ckh7488/rf_current_probe/viewer_A05/split_sources/README.md

# A14 분할 소스 이력

이 폴더는 이전 웹/ZIP 패키지의 보존 자료다. 현재 A14 native·M2×12·기성 노브축과125객체 기준은 [기구 원본](../../mechanical/assembly_A14_DRAFT/README.md), 공개 재생성은 [뷰어 안내](../README.md)를 따른다. 이 폴더의 예전 README/검증 JSON을 새 제조 승인으로 사용하지 않는다. 원문은 [보존본](../../reviews/document_full_audit_20260922/before/viewer_A05/split_sources/README.md)에 있다.
