ckh7488/rf_current_probe/docs/atlas/README.md

# ATLAS RFCP 문서 경로

2026-09-22 · [현행 공개 문서](https://ckh7488.github.io/showcase/reports/rf-current-probe/).

이 설명 자료의 기구 표시 기준은 A14/C07이며, 최종3D 제작은 [A16/C09 확정 기준](../3D_PRINT_RELEASE_A16_C09.md)을 따른다. 현행 교정지그는 Fixture A03(출력 포트 기준1–500 MHz 보정, DEC-053)이며 Fixture A04는 이력이다. 실제 빌드 소스와 명령은 [viewer_A05/README.md](../../viewer_A05/README.md)를 따른다. 이 폴더의 `sections/`·`source/` HTML 및 초기 A02 자료는 역사 기록이며 현행 dist 생성 원본이 아니다.

공개 다운로드는 STL15종·전체 STEP1종·Head A04 Gerber1종과 공개 HTML 묶음으로 제한한다. 내부 구매·과거 리비전·감사 원자료는 공개하지 않는다. 내부 현재 판단은 [CURRENT_READINESS](../CURRENT_READINESS.md), 전체 조사 범위는 [문서 색인](../DOCUMENT_INDEX.md)을 확인한다.
