ckh7488/rf_current_probe/viewer_A05/audit_sources/latest/a11_20260918/README.md

# A11 조립 수정 검토 — 2026-09-18

**CALCULATED / DRAFT — NOT FOR FABRICATION**

검토 대상은 `mechanical/assembly_A11_DRAFT`의 실제 저장 CAD입니다. A10을 그대로 두고 새로운 A11에 바닥 나사 길이, 코어 앞 고정 바, 뚜껑 수동 기준면, 교정 PCB 너트 공구 창과 C05 클램프를 반영했습니다.

`check_targeted.py`는 아래 사항을 저장된 CAD에서 계산하고 `targeted.json`에 원본·검증 코드 해시와 함께 기록합니다.

- 6개 M4×20 나사의 바닥 돌출 여부, 너트 받침 면, 명목 나사 물림.
- A10/A11 FREE 뚜껑 BRep의 대칭 차집합 부피. 동일하면 이전 뚜껑 해석의 대상 형상이 유지된 것으로 해석합니다. 닫힌 표시 형상은 유효성 오류를 수정하여 변경되며, FREE 원본과 구분합니다. 새 기준면의 하중·마찰 해석을 의미하지 않습니다.
- 코어 앞 받침의 접촉 면적 유지.
- 넓어진 하부 사각 너트 슬롯의 회전 정지, 나사·너트를 함께 옮긴 9개 위치.
- 왼쪽 L형 기준면의 유도 경사를 따라 손으로 뚜껑을 배치하는 41개 위치. 자동으로 중심을 잡는다는 뜻이 아닙니다.
- 독립 STL 검사에서 찾은 오래된 0.15 mm 잔여 지붕 조각의 제거와 뒤쪽 2.5 mm 벽의 유지.

전체 조립체의 기존 개폐·분리 경로도 새 원본으로 다시 계산합니다. 첫 수정에서 20 mm로 넓힌 교정 PCB 기둥 머리가 헤드 탈착을 막는 것이 확인되어, 최종 후보는 원래 14 mm 폭으로 되돌리고 공구 창만 유지했습니다. 실패를 제외하는 대신 형상을 고쳐 검사를 다시 실행했습니다.

새 L형 벽은 6 mm이고 유도 경사 끝에도 3 mm가 남습니다. 고정 바는 기존 높이 6 mm·두께 4 mm를 유지합니다. 이 수치는 해당 형상의 설계 치수이며 전체 STL의 최소 벽 두께에 대한 제조사 승인이나 강도 보증은 아닙니다.

추가 형상 검증에서 L형 두 벽이 선으로만 접하는 부분이 STL의 비다양체 경계가 되는 것을 발견해, 경사진 모서리 솔리드로 두 벽을 연결했습니다. 또한 A10부터 상속한 닫힘 뚜껑의 꺾은선/필렛 조합이 `Unorientable shape` 오류를 만드는 것을 확인했습니다. 비영 변위 상태를 정확한 3차 베지어 곡선으로 만들도록 고치고, 생성 시 출력용 FREE 형상뿐 아니라 전체 표시 부품의 `isValid()`도 검사하도록 바꿨습니다. FREE 뚜껑 형상은 유지했습니다.

독립 STL 표본 검사에서는 A07부터 남아 있던 중앙 PCB 지붕의 얇은 조각도 찾았습니다. 중심 X ±6 mm, Y −35…−34 mm, Z 4.75…4.9 mm 위치의 잔여부로, PCB 절삭과 권선 통로 절삭의 시작점이 어긋나 생긴 0.15 mm 돌출부입니다. 중앙 권선 창을 Y −40…−31.9 mm, Z −2…15.8 mm로 연결해 해당 조각을 제거하고 뒤쪽 2.5 mm 벽은 남겼습니다. 바뀐 STL을 다시 검사하여 40,000개 표본 중 1.5 mm 미만 표시가 없음을 확인했습니다. 표본 검사는 전역 최소 두께의 증명이 아닙니다.

독립 검토는 `reviews/independent_a11_20260918`에서 별도로 수행합니다. 구매·제작 승인 상태는 바꾸지 않습니다. 실제 출력 및 조립, 체결 토크·내구성, 전류 프로브 교정·RF 영향 확인이 남아 있습니다.
