ckh7488/rf_current_probe/viewer_A05/audit_sources/latest/c05_20260918/README.md

# C04 → C05 구동 너트 포켓 수정

2026-09-18 · `CALCULATED_SAVED_NOMINAL_CAD_NOT_PHYSICAL`

**출력물을 추가하지 않고 구동 너트의 공칭 축방향 여유를 1.8 → 1.0 mm로 줄였다.** 기존 C04는 보존했다. 이 변경은 이상적인 턱 이동식과 클램프 설치 위치를 바꾸지 않는다.

| 항목 | C04 | C05 |
|---|---:|---:|
| 포켓 높이 | 6.8 mm | 6.0 mm |
| 포켓 Y 범위 | −33.4…−26.6 mm | −33.0…−27.0 mm |
| 사각 너트 공칭 높이 | 5.0 mm | 5.0 mm |
| 너트 Y 범위 | −32.7…−27.7 mm | −32.5…−27.5 mm |
| 공칭 축방향 여유 | 1.8 mm | 1.0 mm |
| 뒤 벽 / 양옆 여유 | 2.4 / 0.8 mm | 동일 |
| 출력물 개수 | 5개 | 5개 |

피치 1 mm를 가정하면 포켓 여유만으로 방향을 바꿀 때 최대 약 1회전의 초기 이동이 생길 수 있다. 실제 백래시를 1회전으로 확정하는 의미가 아니며, 나사산·축 유격과 마찰은 별도로 남는다. 조인 방향으로 여유를 없앤 후에는 기존의 동기 이동 관계를 사용한다.

## 실행한 검증

`build.log`: FreeCAD 1.0.2로 원본 재생성, `mechanical/cable_clamp_C05_DRAFT/verification.json`에 5개 단일 솔리드, 케이블 Ø6–26 mm 21자세와 가로대 개방 21자세 결과 저장.

`assembly.log`: 새로 저장한 파일에서 연결틀·아래 턱 삽입 경로 73자세와 STL 5개의 폐곡면 검사. `mechanical/cable_clamp_C05_DRAFT/assembly_verification.json`에 저장.

`check_c05.py` / `verification.json`: 새 원본 해시를 포함한 추가 검사.

- C04/C05 부품별 대칭차 부피: DriveYoke, DriveNut만 변경. 나머지 16개 형상 동일.
- 포켓의 두 접촉면에 너트를 붙여 Ø6–26 mm 21자세씩 총 42자세 검사.
- 너트 삽입은 M6 축 설치 전으로 한정하여 +Z 0–60 mm, 2 mm 간격 31자세 검사.
- 너트 이동 ±0.5 mm에서는 간섭이 없고 ±0.55 mm에서는 포켓 벽과 간섭하여 끝이 막혀 있음을 확인.
- 사각 너트 회전 방지 및 큰 축·잠금 너트의 3개 케이블 크기 × 25각도 = 75자세 검사.

모든 명시된 공칭 기하 검사는 통과했다. 실제 힘, 마찰, 뒤틀림, 장기 크리프, 출력 오차, 중심 정확도와 RF 영향의 통과를 뜻하지 않는다.

## 공차 범위와 조립 조건

6.0 mm 포켓의 양쪽 벽 위치가 각각 ±0.3 mm 달라진다는 보수적인 민감도 계산에서는 포켓 높이가 5.4–6.6 mm다. 너트가 정확히 5.0 mm라면 잔여 여유가 0.4–1.6 mm다. 너트 공차가 추가되면 범위도 달라진다. 이는 제조업체의 조립 보증 수치가 아니다.

너트는 앞에서 삽입한 뒤 큰 M6 축을 설치한다. 최종 너트 치수를 확인하고 시험 출력으로 조립·반복 이동을 확인해야 한다. 플라스틱에 작동 나사산을 만들거나, 억지 끼워 맞춤·접착·별도 스프링을 추가하지 않았다.

사용한 치수 후보: [Bossard BN147 사각 너트 표](https://www.tme.eu/Document/07a25fe393aaf643196ea01e7ec8ef58/BN_147.pdf). 출력 오차 참고: [JLC3DP 3301PA](https://jlc3dp.com/help/article/3301pa-nylon). 현재 검증은 10 × 10 × 5 mm 외형 모델에 대한 것이며 최종 구매 MPN을 승인한 기록은 아니다.
