ckh7488/rf_current_probe/viewer_A05/audit_sources/latest/independent_a11_20260918/README.md

# A11 / C05 독립 조립 접근 검사

2026-09-18 · **CALCULATED / DRAFT — NOT FOR FABRICATION**

제품 생성기와 별도로 저장된 CAD를 다시 열어 실제 조립 접근과 변경 범위를 대조했다. 실물 출력·조립·계측 시험은 아니다. 제품 CAD, PCB, 사이트를 이 검사에서 직접 변경하지 않았다.

최종 재실행 대상 A11 원본 SHA-256: `43347b92f42abb08b4b938e21b1780dc678d9b14a5508b7598555ee5ab1b244d`. LowerBody의 불필요한 얇은 권선 창 턱을 제거한 뒤, 아래 네 검사 코드를 모두 다시 실행해 결과를 이 파일에 결속했다.

## 확인 결과

| 검사 | 결과 | 근거 |
|---|---|---|
| 헤드 SMA·납땜·드라이버 접근 | A10은 15개 조건 중 9개에서 아래 고정바 간섭. A11은 같은 15개 조건에서 간섭 없음 | [operation_tools.json](operation_tools.json) |
| 바닥 나사 끝 | A10: 책상 아래 4/3 mm 돌출. A11: 책상 위 1/2 mm 여유 | [operation_tools.json](operation_tools.json) |
| 교정 PCB 너트·스패너 | 바깥쪽 X 방향으로 접근/회수하는 경로 368개 자세에서 간섭 없음. 케이블 클램프가 모두 장착된 상태 포함 | [calibration_spanner.json](calibration_spanner.json) |
| 개정별 실형상 대조 | C04→C05는 구동 연결틀과 너트 위치만 변경. A10→A11 변경 객체 전체를 수치로 기록 | [revision_delta.json](revision_delta.json) |
| 출력용 자유 뚜껑 | A10/A11 STEP의 솔리드 차집합 체적 0. 뚜껑 형상 자체는 동일 | [revision_delta.json](revision_delta.json) |
| 닫힌 상태의 뚜껑 CAD | 기존 A10의 변형 표시용 형상 오류를 확인해 A11에서 수정. A11 닫힌 CAD 및 변형량0~3.02 mm의 9가지 생성 형상 모두 유효한 단일 솔리드. 출력용 자유 뚜껑 형상은 유지 | [loaded_lid_validity.json](loaded_lid_validity.json) |

### 공구 검사에 사용한 크기

- SMA 공간: Ø16 × 길이45 mm.
- 납땜 공구: Ø1.6 × 길이6 mm 끝, 다음12 mm에서 Ø6으로 넓어지는 원추, Ø6 × 길이50 mm 몸통. S+/S− 각각 검사했다.
- 코어 두께에 따라 아래 고정바를 Z 방향 −0.635 / 0 / +0.635 mm 이동한 경우도 같은 SMA·납땜 접근 검사에 포함했다.
- PCB 드라이버: Ø4 × 길이85 mm. 코어 고정바 드라이버: Ø8 × 길이65 mm.
- 스패너 가정: 머리 외경14 mm, 두께3 mm, 손잡이 폭8 mm·중심부터 길이55 mm, 벌어진 턱 폭5.8 mm. 실제 구매할 5.5 mm 스패너는 이 외형 안에 들어가는지 별도로 확인해야 한다.

이는 특정 제조사 제품을 그대로 복제한 공구 모델이 아니라 명시한 접근 공간이다. 실제 공구·손가락·열·납땜 각도와 체결 토크까지 검증한 것은 아니다.

## 교정 PCB 너트의 조립 순서

1. 나사 끝이 너트 창을 가로막지 않은 상태로 PCB를 기둥 위에 놓는다.
2. 나일론 M3 너트의 평평한 면을 Z 방향으로 맞춘다. 스패너 손잡이는 바닥의 **바깥쪽 X 방향**으로 향하게 한다.
3. 스패너로 너트를 잡아 기둥의 옆으로 열린 창에 넣고, 그 상태로 위에서 M3 나사를 끼워 조인다.
4. 스패너를 그대로 바깥쪽 X 방향으로 뺀다.

앞·뒤 Z 방향으로 긴 스패너를 끝까지 빼는 방법은 손잡이가 케이블 클램프와 부딪칠 수 있다. 창의 옆면도 열려 있으므로 **옆으로 조작하는 경로**를 사용한다. 나사를 먼저 완전히 넣은 뒤 너트를 옆에서 끼우는 순서도 사용하지 않는다. 이 검토에서 조립 방향을 정리했고, 추가 부품은 필요하지 않았다.

## 변형 표시용 CAD의 수정

기존에는 휘어진 탄성판을 1 mm 간격의 짧은 직선으로 그린 뒤 뿌리 부분을 둥글게 처리했다. 이 조합에서 CAD 커널이 면의 방향을 결정하지 못하는 오류가 났다. A11은 원래 의도한 같은 변형식을 매끄러운 3차 베지에 곡선으로 만들어 이 오류를 해결했다. 이는 **움직임을 표시하고 간섭을 계산하는 CAD의 수정**이며, 출력용 자유 뚜껑을 다시 얇게 하거나 재료를 바꾼 것이 아니다. 자유 뚜껑 STEP은 실제 차집합 체적0으로 동일성을 확인했다.

## 판정의 범위

이번 저장 CAD 검사에서는 위 접근 경로의 추가 간섭을 남기지 않았다. 이는 제품 전체의 제작·RF 성능 보증을 뜻하지 않는다.

- 뚜껑 자유 형상 동일성은 이전 해석의 형상을 추적하는 근거다. 새 위치 기준의 실제 접촉·출력물 변형까지 기존 FEA로 검증한 것은 아니다.
- L자 기준에 손으로 맞추는 방식은 자동 자기 정렬 장치가 아니다. 실제 코어 맞댐 위치와 반복 측정으로 확인한다.
- 긴 출력물의 치수·평행도·뒤틀림, 나사 패턴의 누적 오차, 너트·기성 공구의 실제 치수와 표면 마찰은 아직 실물 확인이 필요하다.
- C05의 구동너트 여유는 공칭1 mm다. 유격이 없는 기구나 실측된 조작감으로 표시하지 않는다.
- 코어 권선·SMA 납땜·RF 지그 정합·프로브 삽입 영향은 각 원래 절차와 후속 시험을 따른다.

## 재현

FreeCAD 1.0.2의 `freecadcmd.exe`로 `check_operation_tools.py`, `check_revision_delta.py`, `check_calibration_spanner.py`를 실행한다. 결과 JSON은 실제 입력 CAD와 검사 코드의 SHA-256을 포함한다. 제품 원본이 바뀌면 이전 결과를 그대로 적용하지 않는다.
