ckh7488/rf_current_probe/viewer_A05/audit_sources/latest/visual_revision_20260918/README.md

# A11 / C05 再검토와 3D 문서 갱신

2026-09-18 · **DRAFT — NOT FOR FABRICATION**

## 완료

기존 조립 문제를 CAD와 출력물에 반영하고, 기존 문서의 4개 장면(구조·개폐 / 실험실 교정 / 지그·분리 / 케이블 측정)을 최신 조립체로 갱신했다. 전후 비교는 이전8곳 + 이번6곳을 실제 CAD로 회전·확대·변경 부분 강조할 수 있게 했다.

| 이번 변경 | 결과 |
|---|---|
| 바닥 M4 나사6개 | 25→20 mm, 너트 안착. 공칭 바닥 안쪽1/2 mm |
| 코어 고정바 | SMA·S+/S− 접근을 위해 가로대 이동. 코어 접촉부 유지 |
| 뚜껑 정렬 | 왼쪽 L형 기준에 손으로 가볍게 맞대고 조임. 자동 정밀 정렬은 아님 |
| 교정 PCB 너트 | 바깥 X 방향 공구 창. 얇은5.5 mm 스패너로 잡고 체결 |
| C05 구동너트 | 포켓6.8→6.0 mm, 공칭 여유1.8→1.0 mm. 무유격 아님 |
| 권선 출구 | 이전 절삭에서 남은0.15 mm 깊이의 작은 조각 제거. 뒤 벽2.5 mm 유지 |

닫힘 상태를 표현하는 뚜껑 CAD의 면 연결 오류도 수정했다. **출력용 자유 뚜껑은 기존과 같은 형상**이다. 기존 약5.29 N 선형 FEA는 당시 재료·지지조건에서의 결과이며 새 기준면 접촉·출력물 수명 검증이 아니다. 비교에서 뚜껑이 포함된 두 부위는 양쪽 모두 유효한 FREE 출력 형상으로 대조했다.

## 실제 검증

- 새 원본의73객체 형상 유효성·정적 간섭,233자세 개폐/탈착,24개 코어 ADC 민감도,코어 접촉/이탈·체결 공간.
- 독립 검사: SMA·테이퍼 인두·드라이버15조건, 바깥 방향 스패너368자세.
- 뚜껑 수동 배치41자세·나사/너트 위치 여유9자세, 자유 뚜껑 형상 동일성.
- 출력10종/15개: 폐곡면·양의 부피·원본 해시;40,000개 두께 표본에서1.5 mm 미만0. 표본 검사는 전면 최소 두께나 업체 DFM 승인과 다르다.
- Site의 새 CAD 포함·동작 그룹·내부 링크·문법 및 브라우저 표시/조작은 별도 검증 기록으로 남긴다.

## 미검증/다음

정확한 구매 체결품·공구·출력 재료/공차 대조,시제품의 무가공 조립·마찰·닫힘 반복성·내구성,RF 교정·삽입 영향·보호 체인이 남는다. PCB 전기 설계는 바꾸지 않았고 이전 규칙검사/거버 대조를 유지했다. 업체 제출·구매·이전 장바구니는 갱신하지 않았다. 기존 구매서를 현재 제작 승인본으로 사용하지 않는다.

근거: [A11](../a11_20260918/README.md), [독립 검사](../independent_a11_20260918/README.md), [출력 검사](../a11_print_20260918/README.md), [C05](../c05_20260918/README.md), [원본](../../mechanical/assembly_A11_DRAFT/README.md).
