ckh7488/rf_current_probe/docs/ATLAS_A02_DESIGN_REVIEW.md

> **이력 문서 · 현재 제작/사용 지시 아님 — 2026-09-22 분류.** A02 설명서 검토 이력이다. 현재 기준은 [현재 준비 상태](CURRENT_READINESS.md)를 따른다. 아래의 “현재/최신/미확정”은 원래 작성 시점의 표현이다.

# 평판 교정지그 A0.2 — 이전 3장 PCB와 비교 검토

2026-09-17 · CALCULATED / 설계 검토 · DRAFT — NOT FOR FABRICATION

**판단: 금속 가공 없이 직접 조립하려는 현재 목적에는 A0.2를 유지하는 편이 낫다.** PCB 사이 접합, 두 점퍼의 길이·납땜, 벌크헤드 SMA 외피 접촉이라는 조립 변수가 줄었다. RF 정확도·유효 대역·반복성의 개선과 전체 비용 절감은 아직 입증하지 못했다.

이 검토는 저장 PCB·FreeCAD 조립 파일을 읽어 별도로 확인했다. 설계 원본, 발주 파일, 공급사 카트·주문은 수정하지 않았다. 실물 조립·EM 해석·RF 측정은 실행하지 않았다.

## 1. 무엇이 달라졌나

| 항목 | 이전 PCB A0.1 | 현재 평판 A0.2 | 판단 |
|---|---|---|---|
| PCB | Frame 118×65×1.0 mm 1장 + EndPanel 128×24×1.0 mm 2장 | 144×92.7×1.6 mm 1장, 두 창과 모서리 고정 | 직각 PCB 정렬·접합 작업 제거 |
| 중심 연결 | SMA 컵과 SIG 사이 점퍼 2개 | 수직 THT SMA 두 개의 중심 핀을 SIG에 직접 납땜 | 점퍼 길이·형상 편차 제거. 새로운 SMA 런치 RF 응답은 미검증 |
| 귀환 접속 | SMA 외피–EndPanel 접촉, EndPanel–Frame 접합 | SMA마다 접지 핀 4개 → 같은 보드의 GND | 연결 구조가 더 명료함. 실물 납땜 연속성은 별도 확인 |
| 지지 | Base, HeadBracket, InputStand, OutputStand | Base·HeadBracket 유지; 30 mm F/F + 35 mm M/F 나일론 기둥 네 쌍 | 출력 지지대 2개 제외, 기둥 부품 8개 추가. 부품 전체가 1개가 되는 것은 아님 |
| 중앙 다리 | 폭 8 mm, 양면 SIG 6.8 mm | 폭·동박 폭 유지, 보드 두께 1.6 mm, 다리 아래 GND 없음 | 기본 교정 전류 경로 유지 |
| 케이블 접속 방향 | 지그 양끝에서 수평 | 보드 위로 수직 | 케이블 배치·당김·SMA 토크를 다시 관리해야 함 |
| 비용 | 이전 견적 및 초안 | 새 보드/기둥/커넥터/배송 재견적 필요 | 3장→1장만으로 최종 비용 절감이라고 판단하지 않음 |

바닥판은 같은 156×103 mm 외형을 재사용한다. 새 PCB가 이전 Frame보다 크다는 사실과 전체 받침대가 커졌다는 주장은 구분한다. 새 3D 출력물을 추가하지 않고 기존 양끝 지지대를 제외하는 구성이다.

## 2. 이번에 실제로 재검사한 것

- **KiCad 10.0.0:** 저장 PCB에 `pcb drc --refill-zones --schematic-parity --severity-all` 실행. 저장 옵션은 쓰지 않았다. DRC·미연결·회로 일치 위반 각 0건, 비활성 검사 0. 저장 회로 ERC도 위반 0, 비활성 검사 0.
- **원본 보존:** PCB SHA-256과 저장 FreeCAD의 해시를 기존 검증 기록과 대조했고 일치했다. 조립 CAD에 사용한 입력 파일의 해시도 모두 일치했다.
- **FreeCAD 1.0.2:** 저장된 조립 파일에서 SIG/GND가 각각 유효하고 연결된 solid 1개임을 확인했다. Ø30 mm 유효 구경의 길이 12.7 mm 전체에 대해 SIG 교차 체적은 양수, GND는 0이다. 중앙 한 단면만 보는 기존 검사보다 길이 방향 확인 범위를 넓혔다. 이것은 형상·위상 관계 확인이며 RF 전류의 크기를 계산한 것이 아니다.
- **간격:** PCB–닫힌 헤드의 공칭 겹침 0, 최소 간격 2.00 mm. SIG–GND 공칭 동박 간격 약 0.3505 mm. 이 수치를 절연 정격으로 쓰지 않는다.
- **개폐:** 두 SMA 위에 Ø12×30 mm 원통형 플러그 공간을 추가한 상태에서 0~90°, 5° 간격 19점 재검사. 겹침 0, 최소 간격 4.91 mm. 실제 커넥터/케이블 외형, 연속 swept volume, 휨·공차 검증은 아니다.
- **도면 대조:** 보존된 GCT RFPC-SMA28-F Rev.1.2 제조사 도면의 추천 패턴은 5.08 mm 피치, 중심 Ø1.50 mm, 접지 네 곳 Ø1.70 mm다. 저장 보드와 기존 패드 검사 기록이 일치한다. Würth 도면은 970300365 길이 30±0.1 mm / 양쪽 암나사 깊이 10 mm, 971350365 몸체 35±0.1 mm / 수나사 8 mm / 암나사 깊이 10 mm다. 도면 공차가 전체 조립 공차 검증을 대신하지 않는다.

재검사 원본: `docs/atlas/review/a02-design/erc.json`, `drc.json`, `pcb-summary.json`, `independent-cad.json`, `freecad.log`. 검토 스크립트: `docs/atlas/review_flat_cad.py`.

## 3. 개선됐다고 말할 수 있는 범위

보드 접합과 점퍼가 없어져 제작 절차가 단순해졌다는 점은 설계 파일에서 확인할 수 있다. 접속 형상·납땜 길이의 변수가 줄어 반복성에 유리할 가능성은 있다. 그러나 반복성을 실제로 측정한 결과는 없다. 직접 납땜형 SMA로 바뀌었어도 그 풋프린트의 1 mm 신호 런치, 폭이 변하는 SIG, 넓은 바깥 귀환 전체가 50 Ω인 것은 아니다.

따라서 **다음 시제품의 조립안으로는 A0.2를 선택하고, RF 교정지그로서의 유효성은 새로 측정한다.** A0.1에서 얻었거나 앞으로 얻을 교정값을 A0.2에 그대로 적용하지 않는다. SMA 부품의 50 Ω/6 GHz 표기도 지그 전체의 대역·정확도가 아니다.

## 4. 조립 전에 먼저 확인할 부분

1. **케이블 하중과 토크.** 새 SMA는 PCB에 서 있다. 케이블을 별도로 받치고 몸체를 지지하며 체결한다. 코어는 브래킷이 받쳐야 하며 8 mm PCB 다리에 집게를 매달지 않는다. 높이 65 mm 나일론 기둥의 휨·풀림·시간에 따른 변형은 아직 시험하지 않았다.
2. **바닥 나사 끝 닿음.** 현재 CAD의 M3×12는 공칭 삽입 9.4 mm / 암나사 깊이 10 mm여서 끝 여유 0.6 mm다. 보유 M3×10을 쓰면 계산상 삽입 7.4 mm / 여유 2.6 mm다. 실제 머리 형상·길이·홈·체결을 보고 선택할 후보이지 검증 완료된 대체품은 아니다. 상단 M3×10은 1.6 mm PCB를 지나 8.4 mm 삽입된다. 절연 기둥은 유지하고 M4/M5로 임의 대체하지 않는다.
3. **높이와 실제 맞춤.** 30+35 mm 기둥의 길이 공차만으로도 한 쌍의 높이는 공칭 합 기준 ±0.2 mm가 될 수 있다. PCB 두께·뒤틀림, 출력 바닥/브래킷, 나사 체결 공차를 합친 간격은 평가하지 않았다. 2 mm CAD 간격을 그대로 실물 최소 간격이라고 표현하지 않는다.

## 5. RF에서 더 나은지 확인하는 첫 측정

새 리비전 ID와 사진을 남기고, 먼저 기존 G2 벤치 절차의 1~100 MHz / 1601점 linear / −30 dBm / IF BW 1 kHz / 평균 4회 시작안을 사용한다. 실제 장비 지원값과 정격이 우선이다. 이전 웹 문서의 −20 dBm·401점 간이 설정은 이번 A0.2 기본값으로 이어 쓰지 않는다.

| 순서 | 실제 연결 | 저장할 파일 | 판단 |
|---|---|---|---|
| 0 | 두 테스트 케이블 끝에서 O/S/L/T | 교정 ID·기준면·설정·재접속 검증 | VNA/케이블 오차 정리 |
| 1 | P1→J1, J2→P2, 헤드 분리 | `fixture_A02_empty.s2p` | 반사·손실·위상·공진. 1~100 MHz S11≤−20 dB는 기존 시작 목표이며 현재 합격 결과가 아님 |
| 2 | 같은 through, 헤드 출력→외장 50 Ω | `fixture_A02_probe_loaded.s2p` | 프로브 장착이 일차 전류 경로에 주는 영향 |
| 3 | P1→J1, J2→외장 50 Ω, 헤드 출력→P2 | `fixture_A02_probe_transfer.s2p` + `.json` | 우선 상대 S21. 전류 모델 입증 뒤 ZT 환산 |
| 4 | 같은 구성으로 직접 픽업 대조·최소 5회 재장착·레벨 비교 | `fixture_A02_direct_pickup.s2p`, `fixture_A02_repeat_01…05.s2p` 등 | 누설·반복성·선형성. 대조 구성의 실제 사진·전류 조건도 기록 |

모든 재배선은 RF OFF. 일차 J2 부하와 이차 P2 종단을 각각 한 번씩 적용한다. 케이블을 고정해 두고 조금 이동시켰을 때의 변화도 별도 기록해 배치 민감도를 판단한다. 저반사 S11만으로 코어 위치의 전류 모델이 입증되지는 않는다. 첫 특성화 뒤 100~200, 200~300 MHz를 나누어 평가하며 500 MHz는 확장 특성 확인이다.

두 지그 실물이 모두 있을 때만 동일 헤드·케이블·레벨·위치에서 A/B 측정을 한다. 없는 A0.1 데이터를 만들거나 비교 때문에 불필요하게 구형을 발주하지 않는다. A0.2만으로 먼저 정합·반복성·누설 기준을 검증해도 다음 설계 판단은 가능하다.

## 근거

- 현재 설계: `hardware/calibration_fixture_PCB_A02/README.md`, `ASSEMBLY.md`, `geometry.json`, `BOM_DELTA.md`, 저장 KiCad/FreeCAD, 검증 JSON.
- 이전 설계: `hardware/calibration_fixture_PCB_A01/`의 형상·조립 검사.
- 기준: `docs/RF_CURRENT_PROBE_WHITEPAPER.md`, `G2_BENCH_PROCEDURE.md`, `END_TO_END_REHEARSAL.md`.
- [GCT 제품 정보](https://gct.co/connector/rfpc-sma28-f), 보존 제조사 도면 `hardware/calibration_fixture_PCB_A02/references/RFPC-SMA28-F.pdf` Rev.1.2 (2025-05-12). 이번 도면 대조는 보존한 제조사 원문 기준이며 최신 리비전 인증을 뜻하지 않는다.
- [Würth 970300365](https://www.we-online.com/components/products/datasheet/970300365.pdf), [Würth 971350365](https://www.we-online.com/components/products/datasheet/971350365.pdf): 보존 제조사 원문과 치수 대조. 신규 가격/배송 조회나 구매는 실행하지 않았다.
- [Tekbox 교정지그 매뉴얼](https://www.tekbox.com/product/TBCPx_Calibrators_Manual.pdf): 약 50 Ω 경로와 분리된 일차/프로브 출력 종단 참고. 상용 대역을 자체 지그 성능으로 옮기지 않는다.
