ckh7488/rf_current_probe/docs/CABLE_CENTERING_CONCEPT.md

> **이력 문서 · 현재 제작/사용 지시 아님 — 2026-09-22 분류.** 중심 클램프를 만들기 전 원리 제안이다. 현행 C07은 별도로 구현/검토되었다. 현재 기준은 [현재 준비 상태](CURRENT_READINESS.md)를 따른다. 아래의 “현재/최신/미확정”은 원래 작성 시점의 표현이다.

# 케이블 자동 중심 맞춤 — 원리 검토

> **2026-09-18 사용자 채택 및 C01 추가:** 세 턱 중심 맞춤 구조를 앞뒤 두 개로 적용하는 방향을 사용자가 승인했다. [C01 실제 CAD·출력물·BOM·검증](../mechanical/cable_clamp_C01_DRAFT/README.md)을 작성했다. 별도 스프링/재단 패드 없이 5출력물과 기성 체결품을 조립하는 후보이며 원리도에서 제작 검토 형상으로 진행했다. 공통 바닥, 정확한 기성품, 힘/공차/RF 검증은 아직이다. 아래 '미구현' 설명은 이전 원리도 당시 이력이다.

2026-09-18 · DESIGN PROPOSAL / CALCULATED geometry · 제작 형상 미구현

## 사용자 요구

판매용 외관·소형화보다 측정과 조작 편의를 우선한다. 필요하면 크기를 늘린다. 코어 앞뒤에 중심이 같은 조절식 클램프를 두고, 노브 조작으로 케이블을 중심 쪽으로 모은다. 금속 사용 여부는 설계자가 정하되 측정 영향 억제를 최우선 조건으로 한다.

금속 영향이 정확히 0이 되는 보편적 이격 거리는 정할 수 없다. 부품/주파수/배치/전기적 연결/측정 불확도에 따라 검증해야 한다. 임의로 30 mm 또는 100 mm를 무영향 거리로 선언하지 않는다. 큰 비금속 지지 구조와 외곽 조절부를 우선하며, 최종 구성의 영향이 허용 범위 안인지 별도로 판단한다. 허용 변화량은 아직 정하지 않았다.

## 원리와 조건

자동 중심 맞춤(self-centering) 척/그리퍼는 실제로 있는 기구다. 본 검토의 원리 그림은 120° 간격의 세 턱이 동일한 반경으로 이동하는 이상적인 구조다. 코어 앞뒤 두 클램프는 동일한 비금속 기준 프레임에 정렬한다. 각 클램프는 자체 노브 하나로 세 턱이 동기 이동하는 방향이며, 앞뒤 노브까지 하나로 묶는 긴 전달기구는 아직 요구하지 않는다.

변형 없는 원형 단면에서 세 접촉면의 중심축으로부터 거리가 같으면 케이블 중심이 축에 놓인다. 앞뒤 중심이 맞고 그 사이 케이블이 직선이면 코어 위치에서도 중심을 지난다. 굽음·처짐·타원형 외피·비대칭 다발·턱/패드 공차가 있으면 '무조건 중심'은 성립하지 않는다. 외피 중심과 내부 도체군의 전기적 중심도 항상 같지 않다.

한쪽 V자 받침만 고정하고 반대쪽에서 누르면 케이블 굵기에 따라 중심 높이가 바뀐다. 두 V자 턱이 대칭 이동하는 방식도 후보이지만, 좁혀졌을 때 턱 끝끼리 충돌하거나 서로 축 방향으로 어긋나야 하는 문제가 있을 수 있다. 따라서 이번에는 기구를 확정하지 않고 세 턱의 동심 이동을 설명 그림으로 사용한다.

## 실제 형상에서 해결할 항목

1. **옆으로 케이블 삽입:** 기존 연결을 해제하지 않도록 클램프를 열 수 있어야 한다. 일반적인 닫힌 척이나 조리개에 커넥터를 통과시키는 사용법으로 바꾸지 않는다. 분할/개방 후에도 턱 동기 관계가 유지되는 구조는 아직 설계 전이다.
2. **기구 단순성:** 링·기어·슬라이더를 추가한 뒤 총 부품 수·노브 횟수·분실 부품·장착 시간을 비교한다. 동심 원리만으로 A06보다 편하다고 판정하지 않는다.
3. **측정 케이블 보호:** 케이블 가까이는 비전도성 턱과 얇은 교체 패드를 우선한다. 날카로운 금속 날로 조이는 조리개는 우선하지 않는다. 접촉 면적·압력·미끄러짐을 확인한다. 조임으로 선의 형상/특성을 바꾸지 않아야 한다.
4. **하중 경로:** 고정력과 프로브 무게는 하우징/프레임으로 전달하며 페라이트·권선·SMA 납땜부가 받지 않도록 한다. 케이블만으로 무거운 프로브를 지지할 수 있다고 가정하지 않는다.
5. **RF:** 코어 가까운 턱·프레임은 비전도성 재료를 우선하고 필요한 금속 구동부는 외곽에 둔다. 가동부 위치에 따른 영향과 금속의 닫힌 경로를 검토한다. 비금속 부품도 유전체이므로 무영향을 보장하지 않는다.
6. **교정 지그:** 큰 교정 PCB와 클램프가 충돌할 수 있다. 교정 시 탈착/후퇴한다면 현장 장착 상태와 구성 차이가 생긴다. 교정과 실제 사용 상태 차이를 확인하기 전 기존 교정치를 그대로 적용하지 않는다.

## 확인한 근거

- [Edmund Optics Self-Centering Jaw Clamps](https://www.edmundoptics.com/f/self-centering-jaw-clamps/39713/): 광학 부품 지름이 달라도 중심선을 유지하는 기성 기구의 예. 강체 광학용 제품의 원리 참고이며 RF 케이블용 구매 권고나 금속 무영향 근거는 아니다. 조회 2026-09-18.
- 내부 원리 계산: 세 턱의 접촉면을 `n_i · c + r = a_i`로 두었다. `n_i`는 120° 간격의 단위 법선, `c`는 원의 중심, `r`은 반지름, `a_i`는 접촉면 위치다. `a_i`가 모두 같으면 `c = 0`이다. 각 턱 오차가 다르면 중심도 이동한다. 이 원리 그림은 접촉면을 수학적으로 배치하며 실제 스크롤/링크/힌지의 작동이나 공차 검증을 포함하지 않는다.

그림의 Ø6–26 mm는 설명용 조절 범위다. 선정 부품의 허용 구경·최종 요구 범위로 사용하지 않는다. 새 CAD/STL/BOM 또는 웹 뷰어 배포를 완료한 상태가 아니다.
