ckh7488/rf_current_probe/docs/OPEN_CORE_HOLDER_REQUIREMENTS.md

> **이력 문서 · 현재 제작/사용 지시 아님 — 2026-09-22 분류.** A07~A09의 요구사항 전개 기록이다. 패드/별도 스프링 제외 원칙은 현행에도 적용된다. 현재 기준은 [현재 준비 상태](CURRENT_READINESS.md)를 따른다. 아래의 “현재/최신/미확정”은 원래 작성 시점의 표현이다.

# 열린 플라스틱 코어 받침 — 최신 사용자 요구

> **2026-09-18 현재 A09/C03:** 대각선 홈 끝을 막고3.7 mm 재료를 남겼다. 프로브 탄성부2.4 mm/길이63 mm, 외곽 잠금 위치와 바닥254×314 mm 확대. 아래 코어에도 이탈 대비 턱, 넓힌 뒤 받침을 적용했다. 작은 PCB는 A03와 M2 나일론 체결을 유지한다. 저장 CAD 경로·치수·이탈 방향 검토는 통과했지만 실물 힘·반복성·RF는 미검증이다. [현재 검토와 원본](../mechanical/assembly_A09_DRAFT/README.md). 아래 A08 및 이전 항목은 이력이다. 출력물 수10종/총15개는 유지, 신규 기성품 구매·카트 변경 없음.

2026-09-18 · REQUIREMENT / DESIGN PROPOSAL · DRAFT — NOT FOR FABRICATION

## 우선하는 조립 방식

사용자는 작은 실리콘 패드 재단·적층과 별도 스프링 추가를 원하지 않는다. 권선이 보이는 열린 플라스틱 받침을 우선한다. 기존의 커터칼 재단 허용과 A07 패드안은 이 요구로 대체한다.

- 권선·권선 리드·Head PCB·SMA 앞은 열어 둔다. 권선을 피해 만든 공간을 다시 패드나 덮개로 채우지 않는다.
- 코어의 권선 없는 바깥 부분을 넓은 플라스틱 받침으로 받친다. 탈착식 고정바는 밖에서 보이고 분리할 수 있어야 한다.
- 코어를 치수에 딱 맞춰 압입하지 않는다. 코어 두께 편차를 고정바의 조립 높이로 받아들이는 방식을 먼저 검토한다.
- 별도 스프링, 수작업 재단 패드, 접착제로 틈 메우기, 사용자 드릴/줄 가공을 기본 조립에 요구하지 않는다.
- 반복 개폐 체결은 관통 홀과 교체 가능한 너트를 사용한다. 플라스틱 나사산 또는 얇은 스냅 턱의 반복 변형을 검증 없이 내구성 해법으로 취급하지 않는다.
- 권선 노출은 정비 공간의 해결이다. 코어 맞댐, 과조임에 의한 코어 파손, 조립 공차와 반복 측정까지 자동으로 해결된 것은 아니다.

## 이어서 확인할 구체 항목

1. 고정바를 조이는 힘이 권선·리드에 닿지 않는지, 코어를 점으로 누르지 않는지.
2. 서로 다른 코어 두께에서도 고정바가 먼저 하우징에 걸리거나 코어가 흔들리지 않는지.
3. 별도 스프링 없이 상하 코어가 맞닿는 닫힘 구조의 여유와 과조임 하중 경로.
4. 열린 상태에서 코어 이탈 방지와 나사/너트의 실제 접근·분리 순서.
5. 최종 재료·구성의 RF 영향과 개폐 반복성. 금속 이격 거리만으로 무영향을 선언하지 않는다.

## 현재 구현 상태

2026-09-18 후속 A08에서 패드를 제거하고 열린 받침/앞 고정바/일체형 플라스틱 탄성 뚜껑을 구현했다. 별도 스프링 부품을 쓰지 않지만 탄성부가 스프링 역할을 한다는 점을 명시한다. [A08 실제 상태·검증](../mechanical/assembly_A08_DRAFT/README.md). 아래 A07 설명은 보존한 이전 이력이다.

A07의 앞쪽 긴 잠금 팔을 옆쪽의 두꺼운 지지부로 옮긴 중간 CAD에서는 공칭 간섭 검사를 실행했다. 이후 앞 가림판과 돌출 동축 받침을 제거하고 코어 고정판을 열린 프레임으로 변경했다. **그 변경 후의 CAD는 아직 재검증하지 않았으며, 패드가 남아 있는 중간안이다.**

`clamp_A07_DRAFT/verification.json`은 그보다 앞선 저장 파일에 대한 결과다. 현재 파일의 통과 결과로 재사용할 수 없다. 로컬/배포 뷰어 역시 완성된 패드 없는 안이 아니다. 설계 상태와 공급사 제출물을 혼동하지 않는다.
