ckh7488/rf_current_probe/selected-evidence/design/CURRENT_READINESS.md

# 현재 제작·사용 준비 상태

**Head A04 SMA R2 / Fixture A03 SMA R2 / VNA B-RJ2 / 중앙 A19·나머지 A18·C10**을 사용한다. 정확한 원본·ZIP·수량은 [현재 제작 구성](CURRENT_BUILD.md), 업체 심사와 가격은 [현재 상태](STATUS.md)가 단일 진입점이다.

## 2026-10-26 실물 조립 관측 — 클램프 사용 보류

사용자는 C04B에서 지칭한 큰 노브축 쪽 전체 고정 불량과 F12 주변 공간으로 인한 두 부품의 심한 덜컥거림을 보고했고, 사용할 수 없는 수준이라고 판단했다. **현재 조립한 클램프는 안정된 케이블 지지·반복 위치 기준으로 사용하지 않는다.** 실물 조립은 시작됐으나 조립 합격이나 RF 측정 완료는 아니다.

현행 A19 일반 체결품 조립 CAD의 두 클램프를 다시 읽어 F12 머리 아래2.0 mm 간격, 홈5.8−핀5.0=0.8 mm, 안내부 좌우 합계1.6 mm 여유를 확인했다. M6 포켓6.0 mm와 구매 너트 규격4.8 mm의 차이는1.2 mm다. 모두 **공칭 CAD/구매 규격 계산이며 실물 유격 실측이 아니다.** 축 너트를 더 강하게 조여 해결한 것으로 처리하지 않는다. [사진·사용자 관측·새 계산과 한계](../reviews/clamp_fit_failure_20261026/REPORT.md)

## 실물 없이 닫은 범위

선정품 도면과 실제 CAD의 핀/홀·실장면, PCB 연결 및 제조 파일, 출력 수량/재질과 공칭 조립을 대조했다. 9/29 독립 재검토에서 현재 PCB6종의 DRC/미연결/회로도 정합0, 새 CAM62파일과265드릴 일치, 출력15종20개와 현재 조립 CAD 대응을 확인했다. 닫힌 뚜껑2개는 출력 자유형상과 다르며 생성식으로 두 상태를 각각 재생성해 대조했다. 이번에는 공칭 정지 조립을 새로 계산했고, 이전 모든 공구·가동 경로를 다시 실행한 것은 아니다. 실물 정상동작 검증으로 표현하지 않는다.

- **[현재 원본 독립 재검토](../reviews/independent_current_audit_20260929/REPORT.md)**: 요구사항56행·설치BOM57행·구매31행, 새 계산 및 확인 한계
- 알려진 비기능 예외: Fixture A03 R2 `SIG ONLY` 실크 높이0.9 mm(업체 권장1.0 mm 미달), Molex의 전 ERC 규칙 활성화 시 단일 SHIELD 라벨 경고1건. 원본을 변경하거나 이 예외를 통과로 숨기지 않았다. 실크 가독성은 최종 CAM/인수에서 확인한다.

- [리뉴얼 PCB 최종 검수/실제 접수](../reviews/jlc_renewal_preflight_20260929/REPORT.md)
- [전체 부품 도면 재대조](../reviews/datasheet_reaudit_20260929/REPORT.md)
- [A19 중앙 베이스 수정 검수](../reviews/base_a19_20260930/REPORT.md): 필수 받침면·홀/기둥 보존, STL 검사, 두 메쉬의 비교/취급 하중 계산. 경화 휨 예측·실측 아님.
- [A18 베이스 검수](../reviews/base_dfm_fix_20260928/REPORT.md), [C10 구조 검수](../reviews/c10_guide_fix_20260928/REPORT.md)
- [RF SMA R2 검수](../reviews/sma_clearance_r2_20260928/REPORT.md)

## 제조와 업체 상태

RF 헤드/교정지그와 A18 앞뒤/C10은 Approved, VNA4종은 Reviewing이다. 중앙은 사이트상 A18/Pending이며9/30 16:19 A19 STL을 이메일로 발송해 교체·재심사를 요청했다. 교체 확인·새 견적·제조사 판단은 남아 있다. 결제·최종 CAM 승인·제작 완료와 구별한다. PCB6종은 각5장, 출력은15종20개다. 최신 관측은 [STATUS](STATUS.md)를 따른다.

## 교정지그 판정

교정은 **Fixture A03 출력 포트 기준, 1–500 MHz 특성화**다. 빈 지그 S11≤−20 dB를 판정조건으로 추가하거나300 MHz에서 일괄 제외하지 않는다. 코어 안은 중심 전류만, 귀환은 코어 밖으로 흐른다. 외장 로드 ΓL과 코어→출구 K, 정/역방향·직접 픽업·null 조건을 검토한 구간만 절대 ZT를 표시한다.

[백서 11.6](RF_CURRENT_PROBE_WHITEPAPER.md) · [A03 채택/모델 근거](../reviews/fixture_a03_output_reference_20260923/ENGINEERING.md) · [출력 기준 분석](../analysis/OUTPUT_REFERENCE.md)

## 실물 뒤 남는 일

1. 출력물 자유 맞댐·휨·코어 맞댐·PCB 홀 삽입·볼트/너트 체결과 공구 접근을 확인한다. 나사로 휨을 강제 교정해 합격 처리하지 않는다.
2. 코어2644181281 두 반쪽, 5턴 기본·3턴 선택, 공칭26 mm 구경 기준으로 조립한다. 권선 직후 헤드 S11로 자기공진을 기록한다.
3. 정/역방향 장착 through와 프로브 전달 S2P, 별도 암 기준면 외장 male 로드 S1P, 반복5회·레벨3개·위치·직접 픽업·왕복상쇄·삽입 영향을 T01–T12에 따라 저장한다.
4. 유효 대역/불확도를 판정한 뒤 전류로 환산한다. 새 케이블의 첫 관측은10 dB 감쇠기로 최대값을 먼저 확인한다.

[첫 제품 인수 순서](../reviews/fresh_system_audit_20260928/FIRST_ARTICLE.md) · [상세 인수/벤치 계획](../reviews/full_reinspection_20260928/ACCEPTANCE_PLAN.md) · [벤치 절차](G2_BENCH_PROCEDURE.md) · [분석 실행](../analysis/README.md)

RF 측정 원본은 `measurements/raw/`에 보존한다. 현재 RF 실측 데이터와 실측 성능 보장은 없다. 10/26 기계적 실패 관측은 위 기록에 별도 보존했고 간격을 실측한 것은 아니다. 백서14.5의 대역·오차 수치는 목표다.
