ckh7488/rf_current_probe/docs/history/RF_CURRENT_PROBE_WHITEPAPER_0.1.md

# 범용 RF 전류 프로브 개발 백서
## 산업용 Ethernet 장애 진단을 출발점으로 하는 수동형 전류 프로브·교정지그

| 문서 항목 | 값 |
|---|---|
| 문서 ID | RFCP-WP-001 |
| 개정 | Rev.A / 0.1 |
| 기준일 | 2026-09-15 |
| 상태 | 설계 기준서. 회로·PCB 제작 승인 및 성능 검증 전 |
| 중심 산출물 | 수동 RF 전류 프로브 헤드, 교정지그, 특성화 데이터, 분석 도구 |
| 개발 환경 | KiCad, Python, 보유 LibreVNA, 보유 오실로스코프 |
| 비용 원칙 | 기존 계측기 제외 신규 지출 10만 원 목표, 20만 원 상한. 구매 전 실견적 검토 |

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

현재 작성된 것은 **설계·실행 지침**이다. 특정 코어, 권선 수, PCB 치수, 실제 대역폭, 절대 정확도, 내전압 및 허용 전류가 확정된 상태가 아니다.

---

## 0. 먼저 읽을 결론

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

**일차 용도:** 크레인 Ethernet/24 V 혼합 하네스에서 RF 공통모드 전류와 통신 장애의 시간적 연관성을 조사한다.

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

핵심 설계 원칙은 다음 세 가지다.

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

---

## 1. 배경과 해결하려는 질문

### 1.1 사용자 관찰

다음은 사용자에게서 보고된 현상이며, 원인이 확정되었다는 뜻은 아니다.

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

본 프로젝트는 이 현상들을 **공통모드 원인으로 미리 확정하지 않는다.** 관측값을 얻어 가설의 우선순위를 바꾸는 것이 목적이다.

### 1.2 이 프로브가 답할 질문

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

### 1.3 이 프로브 하나로 답할 수 없는 질문

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

---

## 2. VNA 지그와의 역할 분담

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

---

## 3. 용어·물리량·상태 표기

### 3.1 전류의 정의

프로브의 일차 측정량은 코어 구멍을 통과하는 전류의 부호 있는 합이다.

$$
I_\Sigma(t)=\sum_k n_k i_k(t)
$$

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

### 3.2 전달 임피던스

$$
Z_T(f)=\frac{V_{out}(f)}{I_\Sigma(f)}
$$

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

$$
Z_T[\mathrm{dB\Omega}]=20\log_{10}\left(\frac{|Z_T|}{1\ \Omega}\right)
$$

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

### 3.3 모든 수치의 상태

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

출처가 없는 부품 사양을 확정값으로 쓰지 않는다. 계산·시뮬레이션을 실측으로 승격하지 않는다.

---

## 4. 요구사항과 성공 기준의 계층

### 4.1 고정 요구사항

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

### 4.2 개발 목표

| 항목 | Rev.A 목표와 판정 방식 |
|---|---|
| 일차 확보 대역 | 1~100 MHz에서 재현성 있는 비교 측정과 유효한 특성화 |
| 전체 개발 목표 | 100 kHz~300 MHz. 동일한 평탄도나 정확도가 전 대역에서 보장된다는 뜻은 아님 |
| 특성 확인 범위 | 보유 장비의 유효 범위 내 100 kHz~500 MHz |
| 500 MHz 확장 | 필요하면 별도 HF 헤드. Rev.A 출하 조건 아님 |
| 통과 구경 | 유효 구경 약 30~35 mm를 출발점으로 검토. 실제 커넥터 외형 확인 후 결정 |
| 감도 | 중간 대역에서 수 Ω~수십 Ω 범위를 비교. 최대 감도보다 대역·재현성·삽입 영향 우선 |
| 사용 전류 | mA급 RF 전류의 비교 측정을 우선. 최소 검출 전류는 계측 체인에서 실측 |
| 저주파 추가 측정 | 100 kHz 미만은 별도 검증된 장비가 있을 때만 수행 |

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

---

## 5. 무엇을 코어 안에 넣을 것인가

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

### 현장 적용 원칙

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

---

## 6. 시스템 구조와 제작물

기본 신호 흐름:

**측정 도체군 → 페라이트 코어/2차 권선 → 헤드 PCB → SMA/동축 → 보호·감쇠 체인 → 50 Ω 수신기**

이 시스템은 PCB만으로 완성되지 않는다. 코어·권선·차폐·기구가 센서의 핵심 부품이다.

### 6.1 제작 단위

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

### 6.2 교체형 헤드의 의미

Head A는 우선 개발하는 광대역 현장용이다. Head B는 A의 한계가 확인된 뒤에만 검토하는 고주파 확장용이다.

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

기본은 고정 구경이다. 실제 커넥터가 통과하지 못하거나 분리 장착이 불가능하면, 기구 확정 전에 split-core 구조로 변경할지 판단한다. 고정 구경을 유지하기 위해 현장 케이블을 자르지 않는다.

---

## 7. 센서의 기본 모델과 설계 trade-off

### 7.1 중간 대역의 이상적 근사

일차 1턴, 이차 N턴, 이차의 유효 부담저항이 `Rb`라면 이상적인 CT의 중간 대역에서:

$$
I_s\approx\frac{I_\Sigma}{N},\qquad Z_T\approx\frac{R_b}{N}
$$

이는 충분한 자화 임피던스, 작은 누설·기생 성분, 비포화 조건의 근사다. 실제 전달 임피던스는 측정으로 확정한다.

외부 50 Ω 부담만 있다고 가정한 계산 예:

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

이 표는 제품 사양이 아니라 동일 모델의 비교 계산이다.

### 7.2 저주파 한계

이차측 자화 인덕턴스를 `Lm`으로 놓은 단순 모델은 다음과 같다.

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

### 7.3 고주파 한계

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

### 7.4 프로브가 원래 전류를 바꾼다

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

### 7.5 DC가 출력되지 않아도 코어는 영향을 받는다

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

---

## 8. 코어·권선·차폐 선택 절차

### 8.1 코어 선정표에 필요한 정보

에이전트는 최대 2~3개 후보부터 검토한다. 처음부터 많은 코어와 헤드를 동시에 발주하지 않는다.

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

### 8.2 초기 실험

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

### 8.3 차폐

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

---

## 9. Probe Head PCB 설계 지침

### 9.1 기본 회로

**권선의 신호단 → 최소한의 선택형 직렬/감쇠 경로 → SMA 중심도체**

**권선 귀환단 → 정의된 RF ground → SMA 외피**

초기 인터페이스는 단순하게 만든다. 작은 직렬 저항 위치, 필요한 션트 RC 위치 정도만 두고 기본값은 0 Ω 또는 DNP로 명시한다. 수십 개의 튜닝 패드를 병렬 분기해 두지 않는다.

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

### 9.2 종단의 기본 결정

기본안은 **수신기 쪽에 하나의 50 Ω 종단**을 둔다.

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

이 방식은 50 Ω로 교정한 RF current probe를 오실로스코프에 연결하는 제조사 안내와 일치한다. [R03]

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

### 9.3 레이아웃

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

DNP 부품도 패드와 분기 배선의 기생 성분은 남는다. 각 옵션은 실제로 필요한 이유가 있을 때만 배치한다.

### 9.4 기구

실효 구경은 코어 내경에서 권선·절연·하우징 간섭을 제외한 값이다. M12/RJ45라는 이름만으로 통과 여부를 판단하지 않고 부트·래치·너트까지 포함한 최대 외형을 확인한다.

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

---

## 10. 교정지그 — 가장 먼저 검증할 부분

### 10.1 올바른 전류 경로

**VNA P1 → 지그 중심 도체 → 50 Ω 종단 → 코어 바깥의 귀환 구조 → VNA P1 외피**

**프로브 SMA → VNA P2**

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

### 10.2 현실적인 구현

중심 금속 도체, 외곽 귀환 프레임, 양 끝 SMA 커넥터 PCB와 절연 스페이서의 조합을 기본 후보로 한다. 코어 주변의 실제 기하구조가 임피던스를 결정하므로, 양 끝 패턴만 50 Ω로 설계했다고 지그 전체가 50 Ω가 되지는 않는다.

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

### 10.3 별도로 검증할 세 가지

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

---

## 11. 전달 임피던스의 계산과 교정 절차

### 11.1 정합된 지그의 근사식

전제는 다음과 같다.

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

이 조건에서 크기는 다음과 같이 계산할 수 있다.

$$
|Z_T|\approx Z_0|S_{21}|=50|S_{21}|\ \Omega
$$

$$
Z_T[\mathrm{dB\Omega}]\approx S_{21}[\mathrm{dB}]+33.9794
$$

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

### 11.2 불정합 보정은 기준면이 먼저다

일차 전류가 정의되는 위치와 VNA 기준면이 같고, 그 사이에 분기 전류가 없는 모델에서는:

$$
I_\Sigma=\frac{a_1-b_1}{\sqrt{Z_0}},\qquad
Z_T=Z_0\frac{S_{21}}{1-S_{11}}
$$

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

더 일반적으로 코어 위치 전류와 입력 진행파 사이의 관계를 `HI(f)=IΣ/a1`로 정의하면:

$$
Z_T(f)=\frac{\sqrt{Z_0}\,S_{21}(f)}{H_I(f)}
$$

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

### 11.3 위상

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

### 11.4 실행 순서

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

### 11.5 공식 복사 시 주의

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

`S21[dB] = Pout[dBm] − Pin[dBm]` — 동일 기준 임피던스와 정합 조건.

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

---

## 12. 오실로스코프 측정과 전류 환산

### 12.1 먼저 확인할 장비 정보

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

### 12.2 주파수별 전류

수신기 입력까지 실제 체인의 전달 임피던스를 `ZT,chain`이라 할 때:

$$
I_\Sigma(f)=\frac{V_{receiver}(f)}{Z_{T,chain}(f)}
$$

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

$$
I[\mathrm{dB\mu A}]=V[\mathrm{dB\mu V}]-Z_T[\mathrm{dB\Omega}]
$$

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

### 12.3 과도 파형

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

---

## 13. 계측기 보호와 사용 금지 범위

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

### 13.1 기본 원칙

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

### 13.2 수동 센서도 안전 인증품은 아니다

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

### 13.3 보호 체인

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

LibreVNA는 우선 **안전한 실험실 교정용**으로 사용한다. 현장 미확인 과도전류를 처음 발견하는 수신기로 바로 연결하지 않는다.

---

## 14. 검증 계획과 초기 합격 기준

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

### 14.1 필수 시험

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

### 14.2 유효 대역의 정의

주파수 한 점이 다음 조건을 모두 만족할 때만 전류 환산의 유효 구간에 포함한다.

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

### 14.3 정확도 등급

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

### 14.4 오차 예산

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

---

## 15. 현장 측정 절차

### 15.1 실험 조건을 실제로 분리한다

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

### 15.2 위치 순서

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

### 15.3 오류와 동시 기록

가능한 로그는 다음과 같다.

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

### 15.4 해석 기준

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

---

## 16. 분석 도구와 데이터 계약

### 16.1 기본 구현

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

### 16.2 향후 저장 구조

아래는 에이전트가 단계별로 생성할 산출물 구조이며, 모든 파일이 현재 존재한다는 뜻은 아니다.

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

### 16.3 측정 메타데이터

최소 필드:

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

`data_kind`는 `MEASURED`, `SIMULATED`, `SYNTHETIC` 중 하나로 명시한다. 합성 데이터는 실제 측정 폴더와 구분한다.

### 16.4 교정 결과 파일

CSV의 권장 열:

`frequency_hz, zt_real_ohm, zt_imag_ohm, zt_magnitude_ohm, zt_db_ohm, phase_deg, valid, uncertainty_db, quality_flag`

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

### 16.5 필수 소프트웨어 시험

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

---

## 17. 시뮬레이션의 역할

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

**시뮬레이션은 후보를 줄이는 도구이며, 실제 권선·차폐·기구를 포함한 프로브의 최종 검증은 측정이다.**

---

## 18. 예산과 범위 관리

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

---

## 19. 구현 에이전트의 단계별 실행 지침

### G0 — 착수와 미확정 사항 분리

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

우선 확인 항목은 실제 커넥터 최대 외형, 고정 구경 장착 가능성, 오실로스코프 모델/입력, 보유 RF 종단·동축·감쇠기, LibreVNA의 실제 버전이다.

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

### G1 — 센서와 교정 토폴로지 검토

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

### G2 — 최소 실험과 특성화 도구

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

분석 도구와 합성 데이터 단위시험을 만든다. 파일 형식·단위·기준면·invalid mask를 먼저 검증한다.

**종료 조건:** 실험 가능한 최소 구성과 재현 가능한 분석 도구가 있다. 실측 여부는 별도로 표시한다.

### G3 — 회로·PCB·기구 상세 설계

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

### G4 — 벤치 검증

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

### G5 — 제한된 현장 적용

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

### G6 — 확장 여부 결정

Head A가 유효한 도구가 된 뒤에만 더 높은 대역, split-core, 별도 HF 헤드, 편의 기능을 추가한다. PCB 근처의 국소장을 탐색하는 H-field loop probe는 다른 측정 도구이므로 별도 사양과 교정 체계를 사용한다.

---

## 20. 변경·검토·완료 보고 규칙

### 20.1 변경 관리

`DECISIONS.md`에는 날짜, 변경 항목, 이전 결정, 새 결정, 근거, 영향받는 요구사항, 재시험 항목을 남긴다.

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

### 20.2 에이전트가 하지 말아야 할 것

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

### 20.3 단계 종료 보고 형식

`완료한 작업 → 생성/변경 파일 → 실제 실행한 검증 → 미검증·막힌 항목 → 다음 단계`

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

### 20.4 최종 완료의 정의

프로젝트가 완료되었다고 말하려면 다음이 함께 있어야 한다.

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

이 중 하나라도 빠지면 상태는 그 단계까지의 설계 또는 시제품이다.

---

## 부록 A. 계산 검산용 숫자

아래는 물리 장비의 실측값이 아닌 단위·부호 검산용 예제다.

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

`−50 dB`를 전압 10만 배 감소라고 표현하지 않는다. 10만 배는 이 경우 전력비에 해당한다.

---

## 부록 B. 미확정 항목 등록부

| ID | 미확정 항목 | 확정 시점 |
|---|---|---|
| TBD-01 | 실제 오실로스코프 모델/대역/50 Ω 입력/최대 입력 | 현장용 측정 체인 승인 전 |
| TBD-02 | 보유 LibreVNA 실제 하드웨어·펌웨어·GUI 및 사용 사양 | 교정 절차 확정 전 |
| TBD-03 | 하네스·커넥터 최대 외형과 분리 장착 가능성 | 기구/PCB 제조 전 |
| TBD-04 | 코어 부품번호와 공급 가능성 | 상세 설계 전 |
| TBD-05 | 권선 수·도선·배치·차폐 구조 | 소수 후보 비교 후 |
| TBD-06 | 교정지그의 실제 유효 대역과 기준면 | 정량 전류 환산 전 |
| TBD-07 | 감쇠·보호장치와 허용 입력 조건 | 현장 측정 전 |
| TBD-08 | 최소 검출 전류·유효 대역·오차 등급 | 벤치 검증 후 |
| TBD-09 | 프로브 장착의 실제 링크/전류 영향 | 현장 해석 전 |
| TBD-10 | 최종 실구매 비용 | 발주 전 |

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

---

## 부록 C. 일차 참고자료와 적용 범위

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

### [R01] LibreVNA — 공식 프로젝트 README

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

URL: `https://github.com/jankae/LibreVNA`

### [R02] Tekbox — TBCPx Calibration Fixtures, V1.0

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

URL: `https://www.tekbox.com/product/TBCPx_Calibrators_Manual.pdf`

### [R03] Tekbox — FAQ RF Current Monitoring Probes

2쪽의 50 Ω 입력/feed-through 종단, 전류 환산, 수신기 과부하와 대역 밖 신호 주의를 참조했다.

URL: `https://www.tekbox.com/product/FAQ_Current_Probes.pdf`

### [R04] Tekbox — TBCP4 32 mm Fixed Aperture RF Current Monitoring Probes

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

URL: `https://www.tekbox.com/product/tbcp4-32mm-fixed-aperture-rf-current-monitoring-probes/`

### [R05] Fair-Rite — General Considerations / Suppression

복소 투자율의 주파수 의존성과 온도·DC bias 영향을 참조했다. 억제용 사양과 센서 전달 특성은 구분한다.

URL: `https://fair-rite.com/general-considerations-suppression/`

### [R06] Fair-Rite — 43 Material Data Sheet

재료 계열 검토의 출발점. 특정 코어 부품 선정이나 전류 프로브 대역 보장은 아니다.

URL: `https://fair-rite.com/43-material-data-sheet/`

### [R07] Fair-Rite — 61 Material Data Sheet

고주파 재료 검토의 출발점과 재료 특성 주의사항. 특정 형상의 실측을 대체하지 않는다.

URL: `https://fair-rite.com/61-material-data-sheet/`

### [R08] Pearson Electronics — Insertion Resistance

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

URL: `https://www.pearsonelectronics.com/support/application-notes/insertion-resistance`

### [R09] Pearson Electronics — Electrostatic Shielding

차폐, 장착부, 출력 동축의 접지 경로를 명시적으로 관리해야 한다는 참고자료.

URL: `https://www.pearsonelectronics.com/support/application-notes/electrostatic-shielding`

### [R10] Pearson Electronics — Droop Notes

CT의 DC 비전달과 펄스 평탄부의 droop, 저주파 한계와의 관계.

URL: `https://www.pearsonelectronics.com/support/application-notes/droop-notes`

### [R11] Pearson Electronics — High Voltage Consideration

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

URL: `https://www.pearsonelectronics.com/support/application-notes/high-voltage-consideration`

---

## 마지막 설계 원칙

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
