ckh7488/rf_current_probe/hardware/calibration_fixture_PCB_A03_SMA_R2_DRAFT/review/drill_report.txt

Drill report for RFCP_Fixture_Flat_A03_SMA_R2_DRAFT.kicad_pcb
Created on 2026-09-28T13:57:06

Copper Layer Stackup:
    =============================================================
    L1 :  F.Cu                      front
    L2 :  B.Cu                      back

Drill file 'RFCP_Fixture_Flat_A03_SMA_R2_DRAFT-PTH.drl' contains
    plated through holes:
    =============================================================
    T1  0.300mm  0.0118"  (45 holes))
    T2  1.900mm  0.0748"  (2 holes))
    T3  2.100mm  0.0827"  (8 holes))

    Total plated holes count 55

Drill file 'RFCP_Fixture_Flat_A03_SMA_R2_DRAFT-NPTH.drl' contains
    unplated through holes:
    =============================================================
    T1  3.600mm  0.1417"  (4 holes))

    Total unplated holes count 4
