ckh7488/rf_current_probe/BACKUP_README.md

# RF current probe source backup

Current selected PCB and assembly sources, analysis code, procedures and selected completed evidence. Read docs/CURRENT_BUILD.md first. Simulation and physical measurements remain distinct.

Backup date 2026-11-04. Source snapshots are not release or field acceptance. Large raw captures, full training data, weights, installed runtimes and caches are excluded. File provenance: SYNC_CHECKPOINT_20261104.json.
