ckh7488/rf_current_probe/docs/CLAMP_SIMPLIFICATION_BRIEF.md

> **이력 문서 · 현재 제작/사용 지시 아님 — 2026-09-22 분류.** A05~A07의 힌지/밴드 후보를 비교한 기록이다. 현재 기준은 [현재 준비 상태](CURRENT_READINESS.md)를 따른다. 아래의 “현재/최신/미확정”은 원래 작성 시점의 표현이다.

# 개폐 구조 단순화 — 사용자 요구와 설계 검토

> **2026-09-18 최신 변경:** 사용자 재단 패드와 별도 스프링을 제외하고, 권선을 노출한 플라스틱 받침·탈착식 고정바를 검토한다. [현재 요구와 미검증 항목](OPEN_CORE_HOLDER_REQUIREMENTS.md)이 아래 이전 후보보다 우선한다.

2026-09-18 · REQUIREMENT / DESIGN PROPOSAL · DRAFT — NOT FOR FABRICATION

## 이번에 받은 요구

- 원래 힌지형 프로브의 사용 방식을 기준으로 한다. A05/A06의 분리 뚜껑·두 손나사 방식은 조작 편의 개선으로 받아들여지지 않았다.
- 공차가 있어도 여닫히고 코어가 맞닿아야 한다. 케이스 정밀 끼워맞춤에 의존하지 않는다.
- 반복 잠금부는 손이 충분히 들어가야 한다. 출력 플라스틱에 직접 만든 나사산에 반복 체결을 맡기지 않는다.
- 다른 굵기의 측정 케이블을 간단히 지지할 수 있어야 한다.
- 금속 체결품의 RF 영향까지 검토한다. 기구 편의만으로 부품을 추가하지 않는다.

## 현재 소스에서 확인한 문제

`mechanical/build_clamp_A05.py`의 개폐 손나사 축은 X=±45.5 mm, Z=7 mm다. 기존 교정 PCB 창(X=±4..51 mm) 안으로 잠금부가 통과하도록 배치했다. 손잡이 Ø12 mm에 주변 원통 절개 Ø14.4 mm로, 해당 절개와 손잡이의 반지름 차이는 1.2 mm에 불과하다. 손잡이 외형의 간섭 회피와 손가락으로 잡고 돌리는 공간은 별개다. 이 배치는 RF상 필수 조건이 아니다.

A06에서도 이 개폐부를 유지했다. A06 검증의 Ø20 mm 원통 접근 검사는 **지그 탈착 손나사**에 대한 것으로, **뚜껑 개폐 손나사**의 손가락 접근을 검증하지 않았다. 공칭 강체 간섭 검사를 조작 편의 검증으로 확대 해석하지 않는다.

현재 A05/A06 개폐 나사는 이미 별도 사각 금속 너트에 체결되며 출력 플라스틱 나사산이 아니다. 다만 금속 너트가 있어도 플라스틱 귀·너트 받침의 압축, 크리프, 파손과 과조임 문제까지 해결되지는 않는다.

## 다음 형상 검토의 우선안

**후속 사용자 요구:** 2026-09-18 사용자는 단순 밴드 지지를 넘어, 노브로 중심을 유지하며 조절되는 클램프를 코어 앞뒤에 두는 방식을 요청했다. 케이블 고정의 최신 검토 기준은 [자동 중심 맞춤 원리 검토](CABLE_CENTERING_CONCEPT.md)다. 아래 밴드안은 이전 후보로 보존하며 새 중심 맞춤 구조가 구현되었다고 취급하지 않는다. 판매 외관·소형화보다 측정 영향 억제와 조작 편의를 우선하고 크기 증가를 허용한다.

1. 원래처럼 뚜껑이 붙어 있는 힌지 구조와 손이 닿는 외곽 잠금부 한 곳을 우선 검토한다. 나사를 완전히 뽑지 않고 여는 방식은 후보이며 아직 형상·기성품을 확정하지 않았다.
2. 힌지 축은 회전부를 조여 잠그지 않는 어깨/스페이서 구조를 검토한다. 출력 홀·축 방향 여유를 두고, 축 유격이 코어 맞댐 오차로 그대로 전달되지 않도록 받침을 분리한다.
3. 케이스는 넓은 스토퍼 면으로 닫힘을 정하고, 코어는 제한된 이동량과 탄성 받침으로 맞댐을 흡수한다. 탄성 부품은 코어 맞댐면 사이에 넣지 않는다. 압력·마찰·크리프 검증 전 수명이나 접촉력을 보장하지 않는다.
4. 반복 체결은 외곽의 교체 가능한 금속 너트와 볼트 후보를 사용한다. 하중 분산 면, 손 접근, 과조임 시 하중 경로를 함께 검토한다. 인서트 삽입·금속 가공을 사용자에게 추가 요구하는 방향은 우선하지 않는다.
5. 측정 케이블 고정은 코어 입구 바깥의 **열린 플라스틱 받침 + 얇은 일반 실리콘 패드 + 재사용 비금속 밴드**를 우선안으로 한다. 받침은 고정 하우징에 연결하며 코어·권선이 케이블 고정 하중을 받지 않게 한다. 밴드 길이로 굵기를 조절하고 케이블을 눌러 변형시키지 않는다. 허용 굵기·고정력·중앙 위치는 아직 미검증이다.
6. 받침은 열린 형태여야 연결된 케이블을 옆에서 넣을 수 있다. 커넥터를 새 구멍으로 통과시키게 하지 않는다. 교정 PCB 삽입 경로와 충돌하면 받침의 위치/탈착부터 검토한다.

기존 지그 PCB에 맞추느라 다시 조작이 불편한 헤드를 만들지 않는다. 다만 이전 힌지 설계에는 교정 PCB 삽입 경로 문제가 있었으므로, 단순히 옛 파일로 되돌리는 것을 해결로 취급하지 않는다. 헤드 개폐와 지그 삽입/분리를 각각 검증해야 한다.

## 금속 부품의 RF 검토

- 금속 크기·재질·위치·서로의 전기적 연결이 중요하다. 비자성 금속도 전도성이 있어 RF 영향이 0이라고 가정하지 않는다.
- 특히 **코어 구멍을 통과하고 바깥으로 돌아와 닫히는 도전 경로**는 코어 자속을 쇄교하는 단락 1턴이 된다. 단순히 외관상 둥글다는 이유만으로 모든 금속 고리를 같은 단락 턴으로 분류하지 않는다.
- 잠금 볼트/너트는 구경과 권선에서 떨어진 외곽에 국소 배치하고, 다른 금속·PCB GND·차폐와 결합해 닫힌 경로를 만들지 않게 한다. 허용 이격 거리 숫자는 아직 정하지 않았다.
- 케이블 받침·밴드·패드는 비전도성 재료를 우선한다. 도전성/탄소 충전 플라스틱·실리콘이나 철사 고정은 이 우선안에 포함하지 않는다.
- 최종 체결품·가드·밴드 상태로 교정한다. 위치가 바뀌거나 접촉이 불안정한 금속에 의한 변동, 감도 손실을 단순 재교정으로 모두 해결할 수 있다고 보지 않는다.

### 남은 검증

CAD: 힌지/잠금부/손 접근/PCB 장착 경로, 공차 조합과 받침 이동 한계, 금속 연결 경로.

실물: 무가공 조립, 반복 개폐와 코어 맞댐, 과조임·마모·너트 유지, 케이블 굵기별 장착/미끄러짐, 동일 코어 접촉 조건에서 체결품 영향 비교와 반복 장착 RF 변화. 비교용 비금속 체결품으로 바꿀 경우 압력 변화도 함께 기록해 금속 영향과 혼동하지 않는다.

## 근거와 현재 상태

- 기존 소스: `mechanical/build_clamp_A02.py`, `mechanical/build_clamp_A05.py`, `mechanical/clamp_A06_DRAFT/README.md`. 소스 치수 검토이며 이번에 새 CAD/전자기 시뮬레이션을 실행하지 않았다.
- [Toroid Corporation 장착 설명](https://toroid.com/power-supply-transformers-toroidal/): 중심 볼트와 금속 섀시가 중앙 구멍을 지나는 닫힌 경로를 형성하는 단락 턴 원리. 전력 변압기 설명을 원리 근거로만 사용하며 RF 프로브의 허용 간격/오차 근거로 사용하지 않는다. 조회 2026-09-18.
- [VELCRO ONE-WRAP](https://www.velcro.com/products/electronics-organization/one-wrap-ties/): 반복 개폐·길이 조절 가능한 밴드의 기성 예. 구체 규격·구매·RF 적합성 확정이 아니다. 조회 2026-09-18.

**이번 산출물은 사용자 요구와 후속 검토 기준이다. CAD/STL/3D 뷰어는 아직 A06이며 새 단순화 형상이 구현된 상태가 아니다.** 공급사 주문·장바구니·제조 파일 제출은 변경하지 않았다.
