ckh7488/rf_current_probe/docs/DECISIONS.md

# RF Current Probe — 결정 기록

**9/28 최종 추가 판정 — C09 강도 재검토:** 좌우 가이드 각각50 N 벌림 하중의2 mm 메시에서 최대 인장응력29.901 MPa로 기존27.5 MPa 기준을 초과했다(전형55 MPa 대비1.84배). 초기3 mm 결과의 전체 강도 GO를 유지하지 않는다. PCB·조립 기하 통과와 구분하며, C09 보강 또는 근거 있는 형상/하중 재검토 후 같은 기준으로 재판정한다. 실물 파손 확정은 아니다. [최종 검수](../reviews/fresh_system_audit_20260928/REPORT.md), [메시 비교](../reviews/fresh_system_audit_20260928/MESH_REFINEMENT.md). 아래 날짜별 GO 문구는 앞선 검토 이력이다.

기준 문서: [RF_CURRENT_PROBE_WHITEPAPER.md](RF_CURRENT_PROBE_WHITEPAPER.md).

각 결정에는 날짜, 변경 항목, 이전 결정/상태, 새 결정, 근거, 영향받는 요구사항, 재시험 항목을 남긴다. 요구사항 추적 ID는 [REQUIREMENTS.csv](REQUIREMENTS.csv)를 따른다.

## DEC-001 — 중심 백서의 경로 정리

| 항목 | 기록 |
|---|---|
| 날짜 | 2026-09-15 |
| 변경 항목 | 백서 파일 위치 |
| 이전 결정/상태 | 실제 파일은 최상위에 있으나 README·AGENTS·백서는 `docs/RF_CURRENT_PROBE_WHITEPAPER.md`를 지정 |
| 새 결정 | 원문을 `docs/RF_CURRENT_PROBE_WHITEPAPER.md`로 이동. 중복 백서는 만들지 않음 |
| 근거 | AGENTS 1절, 백서 16.2절의 단일 중심 문서 경로 |
| 영향받는 요구사항 | DOC-01; 기술 요구사항의 변경 없음 |
| 재시험 항목 | 이동 전후 SHA-256 비교, 참조 경로 확인 |
| 확인 결과 | 백서 SHA-256 `A89EB1A47EED1DBF0A0005657F6BF931B5D49D811165E8C01AD13E133317919D` 일치 |

## DEC-002 — 이번 작업 범위와 G0 관리 문서

| 항목 | 기록 |
|---|---|
| 날짜 | 2026-09-15 |
| 변경 항목 | 초기 작업 범위와 상태 관리 |
| 이전 결정/상태 | 설계 지침 3개만 존재. 관리 문서와 실제 산출물 없음 |
| 새 결정 | 사용자 요청인 전체 읽기·파일 정리에 맞춰 G0 관리 문서를 작성하고 G1 이후는 다음 작업으로 명시 |
| 근거 | 이번 사용자 요청의 '일단 ... 파일정리 및 내용숙지부터'; 백서 19절 G0 종료 조건 |
| 영향받는 요구사항 | DOC-01 및 전체 추적표 |
| 재시험 항목 | 최초 파일 목록, 알려진 조건·가정·실측·사용자 확인의 분리, 요구사항-시험 연결 확인 |
| 확인 결과 | STATUS·REQUIREMENTS·DECISIONS 생성. 상세 설계·실험 미착수 상태 유지 |

## DEC-003 — 단계별 폴더와 데이터 분리

| 항목 | 기록 |
|---|---|
| 날짜 | 2026-09-15 |
| 변경 항목 | 산출물 저장 구조 |
| 이전 결정/상태 | 단계별 폴더 없음 |
| 새 결정 | 백서 16.2절의 폴더를 준비. 설계·분석·측정·release 폴더는 비워 두며, 향후 합성 데이터는 `tests/` 아래에 별도 저장 |
| 근거 | 백서 16.2~16.4절; 원시 측정 보존 및 합성/실측 분리 원칙 |
| 영향받는 요구사항 | REQ-04, REQ-05, DATA-01, DATA-02, DOC-01 |
| 재시험 항목 | 폴더 존재·빈 상태와 README의 설명 일치 확인 |
| 확인 결과 | 파일이 없는 폴더를 완료 산출물로 표시하지 않음. release는 승인 산출물 전용 |

## DEC-004 — 기존 설계 기준과 미확정 상태 유지

| 항목 | 기록 |
|---|---|
| 날짜 | 2026-09-15 |
| 변경 항목 | 요구사항 등록 및 근거의 상태 표시 |
| 이전 결정/상태 | 목표·가정·검증 절차가 백서에 정의됨. 구현/실측 증거 없음 |
| 새 결정 | 백서 REQ-01~10을 유지하고 세부 항목에 작업용 ID를 부여. 문서 정리 DOC-01만 `VERIFIED`; 제품·계산·시험 항목은 모두 `NOT_VERIFIED`이며 증거 필드를 비워 둠 |
| 근거 | 백서 3.3·4·14·16·19·20절. 목표를 실측 사양으로 승격하지 않는 원칙 |
| 영향받는 요구사항 | 전체 추적표; 기존 기술 기준 변경 없음 |
| 재시험 항목 | 백서 요구사항·시험 ID 누락, 목표 수치, 미확정·미검증 표기 확인 |
| 확인 결과 | 1~100 MHz 우선 / 100 kHz~300 MHz 개발 / 500 MHz 확장, 단일 50 Ω 종단 및 비용 상한 유지 |

### 외부 자료의 의심 식 — 후속 확인 항목

백서 11.5절은 R02 전력 차 식의 부호 문제를 기록한다. 초기 정리에서는 해당 PDF를 재조회하지 않았으며, 이후 G1 교정 설명 과정에서 원문과 단위를 확인한 결과를 DEC-008에 추가했다. 백서의 기존 식이나 인용은 변경하지 않았다.

## DEC-005 — RF 전용 개발 범위 유지

| 항목 | 기록 |
|---|---|
| 날짜 | 2026-09-15 |
| 변경 항목 | DC+RF 논의 이후 개발 범위 확인 |
| 이전 결정/상태 | 백서의 Rev.A는 수동 RF 전용. 대화에서 DC 동시 측정과 중복 비용을 논의 |
| 새 결정 | 사용자의 “좋아 rf전용으로 가자”에 따라 수동 RF 전용 범위를 유지 |
| 근거 | 사용자 명시 선택; 백서 0·4·6절. RF 전용 자체가 AC/DC보다 정확하다는 주장은 하지 않음 |
| 영향받는 요구사항 | REQ-01, REQ-09, REQ-10, TGT-01 |
| 재시험 항목 | G1 후보·비용·교정 검토와 이후 벤치 검증 |
| 확인 결과 | DC 통합 회로는 추가하지 않음. 향후 DC 추가를 간단한 무비용 업그레이드로 가정하지 않음 |

## DEC-006 — Tektronix MSO4054 잠정 등록

| 항목 | 기록 |
|---|---|
| 날짜 | 2026-09-15 |
| 변경 항목 | TBD-01 오실로스코프 정보 |
| 이전 결정/상태 | 보유 오실로스코프의 모델명 미확보 |
| 새 결정 | 사용자 원문 “Mso4054 tektronix꺼일걸”을 잠정 정보로 등록. 공식 사양과 실물 확인 상태를 분리 |
| 근거 | 사용자 진술 및 [Tektronix 077-0247-01 Rev.A](https://download.tek.com/manual/077024701Rev_A_web.pdf), 본문 1–1~1–3·1–7쪽; 조회일 2026-09-15 |
| 영향받는 요구사항 | REQ-02, SAFE-01, TGT-01~03, VAL-09, VAL-11; TBD-01 및 TBD-07 |
| 재시험 항목 | 실물 모델·입력 상태·SPC 확인; 실제 체인의 T09/T11. 설정별 대역·잡음 검토 |
| 확인 결과 | 공식 입력·대역 조건을 STATUS 4.1절에 기록. 실물 확인 및 보호 체인 검증은 미실행; TBD-01을 닫지 않음 |

## DEC-007 — M12 8핀·일반 RJ45 및 여유 있는 구경

| 항목 | 기록 |
|---|---|
| 날짜 | 2026-09-15 |
| 변경 항목 | TBD-03의 대상 커넥터와 구경 선택 기준 |
| 이전 결정/상태 | 실제 커넥터 종류 미확인; 백서상 유효 구경 약 30~35 mm가 탐색 출발점 |
| 새 결정 | M12 8핀과 일반 RJ45 케이블을 대상으로 등록. 사용자의 선호에 따라 성능·예산을 유지하는 범위에서 구경 여유를 우선 |
| 근거 | 사용자 명시: “성능에 큰 하자없다면 적당히 크게”; 백서 4.2·7~9·14절 |
| 영향받는 요구사항 | TGT-04, HW-03, REQ-09; TBD-03~05 |
| 재시험 항목 | 실제 커넥터 통과·분리 장착 여부; T03/T05/T06/T08/T10 및 비용 검토 |
| 확인 결과 | [G1_APERTURE_REVIEW.md](G1_APERTURE_REVIEW.md)에 후보 2개의 형상과 공차·구경 치수 검산을 기록. 최종 구경과 코어는 미확정 |

30~35 mm는 확정된 사용자 치수나 통과 보장값이 아니다. M12 8핀이라는 명칭만으로 몸체 외경·코딩·직선/꺾임 형상을 가정하지 않는다. 고정 구경은 기본 비교안이며 실제 장착 가능성은 여전히 확인해야 한다.

## DEC-008 — 교정지그 제조사 자료의 부호 검산

| 항목 | 기록 |
|---|---|
| 날짜 | 2026-09-15 |
| 변경 항목 | 백서 11.5절의 외부 자료 의심 식 확인 |
| 이전 결정/상태 | R02의 전력 차 부호가 S21 표현과 모순된다는 백서 기록; 독립 재확인 미실행 |
| 새 결정 | 공식 원문을 확인하고 이상적 정합 50 Ω 조건에서 `S21[dB]=Pout−Pin`, `ZT[dBΩ]=Pout−Pin+20log10(50)`을 유지 |
| 근거 | [Tekbox TBCPx_CAL Manual V1.0](https://www.tekbox.com/product/TBCPx_Calibrators_Manual.pdf) 1~2쪽, 조회일 2026-09-15. 2쪽의 `Pin−Pprobe+34`와 `S21+34`는 표준 S21 정의에서 서로 일치하지 않음 |
| 영향받는 요구사항 | CAL-02, CAL-03, CAL-05, SW-02 |
| 재시험 항목 | G2의 주파수·기준면·단위·부호 자동시험과 G4의 실제 지그 전류 모델 검증 |
| 확인 결과 | CALCULATED: Python 3.12.6 산술 검산에서 Pin=0 dBm / Pout=−20 dBm / 정합 50 Ω일 때 I=4.472136 mA RMS, Vout=22.360680 mV RMS, ZT=5 Ω=13.979400 dBΩ. 합성 S-parameter 자동시험·실측 교정은 미실행 |

이 예제는 코어 위치의 전류가 알려지는 이상적 정합 모델이다. 실제 지그에서는 반사·손실·기준면·분기 전류와 헤드 부하를 검증한 뒤 적용한다. S11이 좋다는 이유만으로 절대 전류 모델을 확정하지 않는다. 원문 재확인 및 산술 검산은 G1 전체 완료나 CAL-05의 자동시험 통과를 의미하지 않는다.

독립형 가능성에 관한 후속 질문은 설계 변경 승인으로 해석하지 않았다. 현재 수동 헤드·오실로스코프 연결 범위를 유지한다.

## DEC-009 — SMA–BNC 완제품 케이블을 예비 BOM에 등록

| 항목 | 기록 |
|---|---|
| 날짜 | 2026-09-15 |
| 변경 항목 | 오실로스코프 연결 케이블의 구매 검토 항목 |
| 이전 결정/상태 | SMA–BNC 기성품 케이블 사용을 대화에서 설명했으나 BOM 없음 |
| 새 결정 | 사용자 지시에 따라 [BOM_DRAFT.md](BOM_DRAFT.md)에 CAB-01, SMA–BNC 50 Ω 완제품 케이블 1개를 등록 |
| 근거 | 사용자 명시: “저건 bom에 넣도록하고”; 백서 9.2·11.4·18절 |
| 영향받는 요구사항 | REQ-02, REQ-04, REQ-09, SW-04; TBD-07, TBD-10 |
| 재시험 항목 | 실제 부품·길이·단자·RF 정격 확인, T09 체인 교정 및 견적 합산 |
| 확인 결과 | 등록 완료. 제조사·부품번호·최종 길이·가격·보유 여부 미확인. 측정용 변환 어댑터를 중복 계상하지 않으며 교정용 전환 필요성은 별도 검토 |

## DEC-010 — 집게형을 Rev.A 기본 장착 방식으로 선택

| 항목 | 기록 |
|---|---|
| 날짜 | 2026-09-15 |
| 변경 항목 | 장착 방식과 코어 선정 범위 |
| 이전 결정/상태 | 백서 0.1은 고정형 기본. 장착 방식 질문에 답변 대기 |
| 새 결정 | 사용자 응답 “집게가 무조건 낫지”를 집게형 선택으로 반영. 커넥터를 분리하지 않고 케이블 중간에 장착하는 split-core를 Rev.A 기본으로 확정 |
| 근거 | 사용자 명시 선택과 현장 장착 편의. 모든 성능 항목에서 집게형이 우수하다고 단정하는 결정은 아님 |
| 영향받는 요구사항 | TGT-04, SENS-03, HW-01~03, VAL-05~06, REQ-09; TBD-03~05 |
| 재시험 항목 | 분할 코어·권선 모델 재검토, 열림/잠금 기구·접합면 확인, T01/T03/T05/T06/T08/T10 및 비용 검토 |
| 확인 결과 | 백서를 Rev.A / 0.2로 개정하고 관련 요구사항·G1 검토·BOM·상태 문서를 동기화. 닫힌 코어 5943003801/5961003801은 현재 후보에서 제외. 새 분할 코어·실물 성능은 미확정 |

변경 전 백서 0.1은 [이력 보관본](history/RF_CURRENT_PROBE_WHITEPAPER_0.1.md)에 보존했다. SHA-256은 `A89EB1A47EED1DBF0A0005657F6BF931B5D49D811165E8C01AD13E133317919D`다. 기존 30~35 mm는 여유 있는 공간의 탐색 출발점으로 유지하지만, 이제 커넥터 통과가 아닌 실제 케이블/다발·진입 폭·주변 간섭으로 판단한다.

## DEC-011 — 첫 집게 시제품 코어·권선·잠금 구조 선정

| 항목 | 기록 |
|---|---|
| 날짜 | 2026-09-15 |
| 변경 항목 | 집게형 부품 후보와 첫 실험 구성 |
| 이전 결정/상태 | 집게형 선택 완료, 분할 코어·권선·잠금 구조 미선정 |
| 새 결정 | Fair-Rite 2644181281 두 반쪽, 고정 반쪽 5턴, 유효 구경 30 mm 목표, 비도전성 힌지 하우징과 캠 잠금을 첫 시제품 설계 시작안으로 선정 |
| 근거 | 사용자 “선정하면되는거아냐? 물어볼게 있음?”에 따라 독립적으로 선정. 제조사 세 후보 자료와 상대 AL, 판매처 가격을 비교한 [선정 검토서](G1_SPLIT_CORE_SELECTION.md). 짧은 축방향 길이·구경 여유·비용을 우선 |
| 영향받는 요구사항 | REQ-01~04, REQ-06, REQ-09, TGT-04, SENS-01~03, HW-01~03, VAL-03/05/06/08/10; TBD-03~05, TBD-10 |
| 재시험 항목 | 도면/판매 단위 확인, 권선·접합면·잠금 및 개폐 5회 이상, 3/5/7턴 비교, 교정지그·보호·삽입 영향·실견적 검토 |
| 확인 결과 | 세 후보 자료·가격 표시 확인, 일정 AL 모델 9개 조합 산술 실행. 첫 코어와 기구 방식 선정 완료. 도면 이미지 접근 실패로 시각 확인은 미실행; 성능·제작·구매는 미승인/미실행 |

가격 검토에서는 반쪽 2개가 필요하다는 물리적 구성과 판매 단위를 구분했다. 선정품의 판매처 `Solid` 분류는 제조사의 `SPLIT` 설명과 충돌하므로 제조사를 우선했다. 제조사 웹페이지의 억제 임피던스 두 표 및 0431177081의 구경 표기 차이도 선정 검토서에 남겼다. 상대 AL 계산을 실측으로 표시하지 않는다. 내부 비용 배정 175,000원은 100,000원 목표를 넘는 계획값이며, 200,000원 상한 충족을 보장하는 확정 견적이 아니다. 대안 두 코어는 첫 구매 목록에서 제외한다.

## DEC-012 — 100 MHz 초기 검증과 300 MHz 개발 목표 구분

| 항목 | 기록 |
|---|---|
| 날짜 | 2026-09-15 |
| 변경 항목 | 대역 목표 설명 및 상위 대역 검토 범위 명시 |
| 이전 결정/상태 | 백서는 1~100 MHz 우선 검증, 100 kHz~300 MHz 개발 목표. 후속 선정 설명에서 100 MHz가 최종 상한처럼 읽힐 여지 |
| 새 결정 | 기존 300 MHz 개발 목표 유지. 100~200 MHz 및 200~300 MHz의 연속 유효 대역을 후속 설계·실험 검토에 명시. 100 MHz만 검증하고 전체 개발 완료로 보고하지 않음 |
| 근거 | 사용자의 200 MHz 이상 관측 필요성 제기; 백서 4.2·7.3·14절. 데이터율과 주파수의 구분 및 외부/고조파 잡음 근거는 선정 검토서의 DEC-012 항목 참고 |
| 영향받는 요구사항 | 기존 TGT-01~03, VAL-02~06/08~10의 해석 명확화. 새로운 성능 보장이나 검증 통과를 추가하지 않음 |
| 재시험 항목 | 코어·권선·차폐·동축·보호 및 교정지그의 100~300 MHz 연속 특성화 |
| 확인 결과 | 문서 목표와 설명을 명확히 함. 200/300 MHz 실측은 미실행. 100 Mbps의 숫자를 두 배 하여 대역을 정하는 논리는 채택하지 않음 |

## DEC-013 — 제조사 도면/STEP 확보와 배치 검토

| 항목 | 기록 |
|---|---|
| 날짜 | 2026-09-16 |
| 변경 항목 | 도면 접근 미해결 상태, 기구 검토 근거 |
| 이전 결정/상태 | 도면 이미지 접근 실패; 형상·CAD 미확인 |
| 새 결정 | 제조사 직접 PDF/STEP을 보존하고 실제 형상으로 두 반쪽·30 mm 게이지·권선/PCB/힌지/캠 공간을 배치. 제조 CAD가 아닌 DRAFT 배치 검토로 분류 |
| 근거 | [원본 목록/해시](references/README.md), [기구 검토](../mechanical/README.md). FreeCAD 1.0.2 실행 |
| 영향받는 요구사항 | TGT-04, SENS-03, HW-01~03, TBD-03~05 |
| 재시험 항목 | 실물 공차·권선/절연·하우징·개폐·잠금·T05/T06. 판매 단위는 주문 전 확인 |
| 확인 결과 | STEP 반쪽 1 solid 확인. 공칭 두 반쪽과 30 mm 게이지 교차 체적 0 mm³. 공칭 최소 간격 3.6055 mm는 보증 공차 여유가 아님. 도면 E 최소치/33 mm 케이블 표기와 구분 |

카탈로그 도면은 UNCONTROLLED 표시이며 모든 세부 형상을 담지 않는다. mate-pair 억제 임피던스 표의 조건/최소치와 웹 typical값을 섞지 않았고 ZT로 전용하지 않았다. 기존 도면 접근 실패 기록은 과거 이력으로 남긴다.

## DEC-014 — 조건부 교정 분석과 합성 검증 도입

| 항목 | 기록 |
|---|---|
| 날짜 | 2026-09-16 |
| 변경 항목 | G1 지그 검산·G2 분석 도구 및 시험 |
| 이전 결정/상태 | AL 이상 모델 계산만 있음; Touchstone·합성 시험 미구현 |
| 새 결정 | scikit-rf 2.1.0 사용. 기본 relative; matched/input_current/hi_model은 증거와 조건을 요구. 위상 미검증은 magnitude-only, 불확도 미평가는 빈 값+UNASSESSED |
| 근거 | [지그 검토](G1_FIXTURE_REVIEW.md), [분석 사용법](../analysis/README.md), 백서 11·12·16절 |
| 영향받는 요구사항 | CAL-01~05, DATA-01~03, SW-01~05 |
| 재시험 항목 | 실제 장비 Touchstone·기준면·품질 마스크·체인·T02~T09. 지원 범위 변경 시 형식/단위 회귀시험 |
| 확인 결과 | pytest 66개 통과, 합성 301점 CLI 2모드 실행, 입력/결과 보존 검사. [검증 보고서](G2_VERIFICATION.md). 전류 우회가 있는 반례로 무조건 1−S11 보정 오류 확인 |

Touchstone 1.0/2.0의 full single-ended 2포트 실수 50 Ω만 지원한다. 2.1·혼합모드·비50 Ω는 명시적으로 거부한다. 추가 체인 de-embedding·시간 역복원·자동 불확도 산출은 미구현이다. 새 PARTIAL 상태는 일부 소프트웨어/문서 증거만 있고 실제 하드웨어 검증이 남았음을 뜻한다. 요구사항을 하드웨어 통과로 일괄 승격하지 않았다.

## DEC-015 — 첫 벤치 순서와 케이블/감쇠 조달 후보

| 항목 | 기록 |
|---|---|
| 날짜 | 2026-09-16 |
| 변경 항목 | 실험 순서·BOM 0.4·보호/비용 검토 |
| 이전 결정/상태 | 케이블 MPN 없음, 전체 175,000원 내부 배정, 실험 절차 없음 |
| 새 결정 | F-A through → 5턴 상대 S21 → 선형성/개폐/위치/누설 → 3/7턴 비교 → 전체 체인 순서. CAB-27480 저가 케이블 시험 후보와 VAT-10A+ 감쇠기 비교 후보 등록 |
| 근거 | [벤치 절차](G2_BENCH_PROCEDURE.md), [보호·조달 검토](PROTECTION_AND_PROCUREMENT.md), 사용자 자율 진행 요청 |
| 영향받는 요구사항 | REQ-02/04/09, SAFE-01, SW-04, VAL-01~12; TBD-01/02/04/07/10 |
| 재시험 항목 | 실물/보유품·판매 단위·정합·보호부 잔류전압/펄스·전체 실견적. 구매와 현장 적용은 승인 범위에서 별도 실행 |
| 확인 결과 | 제조사 코어/케이블 도면·VAT-10A+ Rev.C 직접 PDF 및 가격 표시 확인. 후속 비용 가정 약 195,020원; 확정 견적/상한 충족 미확인. 발주·장비 연결·현장 작업 없음 |

케이블 페이지의 RG136 표기는 공급사 도면의 RG316과 달라 도면을 우선했다. VAT-10+ 구형 가격·다른 시리즈의 2 W 최대값을 VAT-10A+ 최신 1.7 W 정격과 혼용하지 않는다. 감쇠기 선정은 현장 보호 설계의 완료가 아니다. 지그/스코프 측정과 판매 단위 확인이 없다는 이유로 가능한 오프라인 설계·분석 준비까지 멈추지는 않았다.

## DEC-016 — KiCad PCB와 실제 집게 부품 형상 A0.1

| 항목 | 기록 |
|---|---|
| 날짜 | 2026-09-16 |
| 변경 항목 | G3 제작 초안, SMA 선정, PCB 크기, 첫 잠금 구조 |
| 이전 상태 | 16×10 mm PCB·힌지/캠 공간 상자만 있고 실제 PCB/하우징 없음 |
| 새 결정 | 20×16 mm 2층 PCB, GCT RFPC-SMA28-F, 나일론 M2 고정. PETG 트레이/덮개와 M3 힌지·탈착 나사 잠금. 캠은 첫 실물 맞춤/반복성 결과 뒤 개선 |
| 근거 | 사용자 “실물도 어느정도 만들어봐 pcb던 기구던” 요청. [G3 패키지](G3_PROTOTYPE_PACKAGE.md), 제조사 SMA 도면 Rev.1.2, KiCad/FreeCAD 실제 실행 |
| 영향 | REQ-01/02/04, TGT-04, HW-01/02/03, TBD-03~05/07/10. 제조 승인이나 성능 보장으로 승격하지 않음 |
| 검증 | ERC/DRC·미연결·회로도 일치 위반 각 0, 저장 PCB 홀 9개와 기구 대조, STL 5개 solid, 공칭 간섭 및 샘플링 개폐/진입 검사 통과 |
| 남은 검증 | 코어/출력 공차, 실제 선경/절연, 패드/잠금 힘·수명, SMA 하중, 제작사 stack-up/홀 공차, 보호·RF 교정, 최종 견적 |

나사식은 캠보다 여닫기가 느리지만 첫 조립의 압력·패드 조정이 쉽다. 캠을 구현했다고 보고하지 않는다. PCB는 수신기 단일 50 Ω 종단을 유지하며 헤드 shunt/RC 분기를 추가하지 않았다. SMA PDF 속성 제목 SMA25-F와 본문 SMA28-F의 불일치는 본문 도면을 우선해 기록했다. KiCad board-only STEP의 1.51 mm 유전체 외형은 기구에서 공칭 완성 두께 1.6 mm로 확장했고 실제 stack-up으로 확정하지 않았다.

실물 출력·조립·발주·현장 작업은 실행하지 않았다. 사용자와 확인할 항목을 [OPEN_DECISIONS.md](OPEN_DECISIONS.md)에 순서와 권고안으로 모았다. 원래 백서와 AGENTS 원문, 이전 배치 파일 및 측정 원본은 보존한다.

## DEC-017 — VNA/스코프 전체 연결 리허설과 환산 조건 보완

| 항목 | 기록 |
|---|---|
| 날짜 | 2026-09-16 |
| 요청 | 사용자의 전체 프로세스 예상 실행·부족/모호한 부분 검토 및 수정 |
| 연결 변경 | CAB-P2 male–male에 맞춰 ADAPT-CAL-01을 BNC female–SMA female로 수정. SMA female SOL/THRU와 BNC 기준면 확보 경로를 BOM 0.6에 명시 |
| 교정 | 케이블 끝 기준면이 유지되면 접속 대상 변경만으로 SOLT를 무조건 다시 하지는 않음. 어댑터 제거는 별도 문제: BNC 교정 또는 검증된 복소 2포트 제거 후 사용 |
| 스코프 | RF OFF 재배선→CW P1→DC/내부 50 Ω/Voltage 1×/FULL/Sample. 실제 기본파와 수신기 gain/부하 확인 후 조건부 A RMS |
| 근거 | [전체 절차 검토와 출처](END_TO_END_REHEARSAL.md), 공식 LibreVNA/원 MSO4054 매뉴얼, [901-9173 제조사](https://www.amphenolrf.com/en-us/part/901-9173/7570/) |
| 소프트웨어 | 정규화 CSV의 DC/고조파 동시 fit, 출력 기준면/체인/개체/설정 검증. 전압만 분석 가능. 단일 성분 환산이며 펄스 역복원 미구현 |
| 기구 발견 | 저장 CAD + F-A 귀환에서 110°부터 충돌. 지그에서는 90° 제한/스토퍼 필요. 큰 SMA 몸통의 낮은 체결 위치는 간섭 가능. 실제 기구/PCB 파일은 변경하지 않음 |
| 비용 | THRU/BNC 교정 준비 비용은 기존 195,020원 시나리오의 확정 포함 항목이 아님. 보유/대여 우선 확인, 20만 원 상한 유지 |
| 남은 검증 | 실제 지그 런치/지지대/스토퍼, 부속품 체결, HI·BNC 기준면·수신기/부하·DC 바이어스·보호·RF 측정. 발주/장비 연결 없음 |

연결 9개 예상 결과, 합성 4개 주파수의 기본파 복원, 잘못된 환산 10개 거부를 실행했다. 합성 데이터 성공을 실물 교정·대역·보호 통과로 표시하지 않는다. 실물 확인 항목은 [누적 목록](OPEN_DECISIONS.md)에 반영했다.

## DEC-018 — 스토퍼·전체 지그와 PCB 제작 검토 리비전

| 항목 | 기록 |
|---|---|
| 날짜 / 요청 | 2026-09-17 / 가능한 제작 준비를 재개하고 막힘에서 멈추기 |
| 기구 | 기존 A0.1 보존, 집게 A0.2 고정 트레이에 90° 스토퍼. F-A A0.1에 베이스·양끝 지지대·SMA/도체·헤드 브래킷 CAD 및 STL |
| 지그 SMA | 132139 후보 2개. 제조사 카탈로그 PDF39/인쇄38쪽으로 공칭 외형; 현재 생산 도면 403으로 공차/실물 확인 보류 |
| PCB | 독립 A0.2 폴더, 실크 1.0 mm/획0.15 mm. 전기/조립 형상 보존 대조. 7 Gerber·13 PTH/2 NPTH 생성, 제작 승인 아님 |
| 실제 검증 | 공칭 간섭 0, 19각도 개폐, 집게/지그 STL 5+4 solid, 저장 형상/전류 경로 대조. 새 PCB ERC/DRC/미연결/일치 위반 0 |
| 근거 | [최신 검토와 일차자료](BUILD_READINESS_20260917.md), [지그 BOM/조립](../hardware/calibration_fixture/README.md) |
| 영향 | HW-01/02/03, REQ-02/04/09, TBD-03~05/07/10. 기구 치수·지그 형상이 바뀌므로 개체별 실측 기준 필요 |
| 보류 | 코어 판매 단위·보유품·출력 수단·케이블 공간·SMA 실제 체결·제작 공차·실견적. 구매/현장/실측 미실행 |

기존 195,020원은 배정 시나리오로 유지하며 새 지그와 교정 준비의 확정 견적이라고 하지 않는다. 첫 낮은 출력 VNA 벤치 범위를 먼저 견적하고, 현장 보호/스코프 전류 환산 조건은 별도 검증한다. 보호나 교정 검증을 예산 때문에 생략하지 않는다.

## DEC-019 — 실제 장바구니 견적과 어댑터 후보 교체

| 항목 | 기록 |
|---|---|
| 날짜 / 요청 | 2026-09-17 / 실제 가격 산출 및 부품·JLCPCB 장바구니 준비, 사용자 크롬 사용 |
| 확인 | DigiKey 8종 160,734원/무료 배송 표시, JLCPCB 5장 USD 5.20/한국 배송 견적 USD 9.49. 결제·발주 없음 |
| 변경 | ADAPT-CAL-01: Amphenol 901-9173(137,414원)을 Cinch 29-3835(9,622원) 견적 후보로 대체. 제조사 도면에서 BNC-F/SMA-F, 50 Ω, 0~4 GHz 확인 |
| 연결 영향 | 양단 성별/기본 연결표 유지. 개체 모델/S2P 미확보이므로 기존 교정 재사용·BNC 기준면이 해결된 것으로 취급하지 않음 |
| 출력 막힘 | PETG가 JLC3DP FDM 목록에 없음. ABS는 얇은 STL 4개 최소 크기 조건 거부. 자동 레진 비교 견적을 PETG 견적으로 대입하지 않음 |
| 남은 일 | 코어 판매 단위, PETG 출력/금속 가공/체결 소모품, 교정 준비/보호부, 세금·최종 배송. 전체 예산 충족 미확정 |
| 근거 | [실제 가격·장바구니 및 제조사 도면 링크](../procurement/20260917/QUOTE_REVIEW.md) |

## DEC-020 — 케이블 길이와 배송비 절감안

| 항목 | 기록 |
|---|---|
| 날짜 / 요청 | 2026-09-17 / 가격을 줄일 수 있는 항목 검토·반영 |
| 적용 | CAB-02 TE 610 mm 2개→305 mm 2개, 10,716원 절감. 제조사 SMA M/M·50 Ω·DC~8 GHz 확인. 실제 가까운 배치/굽힘 반경 확인 조건 |
| 배송 | JLC E-POST $5.60 선택 시 PCB 포함 $10.80, 기존 UPS 대비 $3.89 절감. 10~16영업일 표시. 새로고침 후 선택이 복귀하므로 영구 저장된 배송으로 보고하지 않음 |
| 결과 | DigiKey 150,018원/8종 12개/배송 무료 표시. 1,500원/USD 가정 부분 합계 166,218원. 이번 절감 16,551원; 이전 어댑터 절감 중복 계상 없음 |
| 유지 / 보류 | 감쇠기·부하·코어 수량 유지. Cinch 감쇠기 2,736원 저가 후보는 최신 상세 도면/체결 조건 확인 전 보류. CAD 변경/제작/결제 없음 |
| 교정 영향 | CAB-P1/P2 새 개체와 기준면 SOLT/체인 데이터 필요. 종전 케이블 교정을 재사용하지 않음. 실제 RF 정확도 검증 아님 |
| 근거 / 남은 일 | [절감 검토](../procurement/20260917/COSTDOWN_REVIEW.md). 보유품 대조·기구/금속/체결/세금/보호/교정 준비의 누락 견적과 물리적 확인 필요 |

## 후속 기록 규칙

### DEC-021 — 다른 PCB 주문과 합배송 우선

2026-09-17 사용자에게 별도 PCB 배송 예정 건이 있으므로 합배송을 우선한다. 프로젝트에는 기존 배송료 전체를 중복 배정하지 않고 실제 증가분만 넣는다. 부품+PCB 제작 부분 합계는 157,818원 + 추가 운임(1,500원/USD 가정). 기존 주문 상태/추가 운임 미확인, 실제 병합·주문·결제 미실행. JLC의 생산 중 주문 `Add new item`/`Combine` 조건과 추가 운임 표시를 [절감 기록](../procurement/20260917/COSTDOWN_REVIEW.md)에 남겼다. 제작 검토 상태는 변하지 않는다.

### 후속 변경 관리

코어, 턴 수, 권선 배치, 차폐, PCB 튜닝, 출력 케이블, 종단, 보호 체인이 바뀌면 영향받는 요구사항과 교정 재사용 가능성을 기록한다. 재시험 결과 없이 기존 교정의 유효성을 확정하지 않는다. 같은 파일명으로 원시 데이터나 교정 이력을 덮어쓰지 않는다.

## DEC-022 — 보유품 반영과 외장 로드 1개 재사용

2026-09-17 사용자 확인: LibreVNA 동봉 SMA 수–수 케이블1개, 50 Ω 로드 보유/별도 약6개 구매 계획. 신규 CAB-02는2→1, LOAD-01은2→0으로 DigiKey 카트 수정, 21,231원 절감. Through/삽입 영향에서는 외장 로드가 헤드에, transfer에서는 RF OFF 후 같은 로드를 지그 OUT으로 옮긴다. 역할별로 서로 다른 로드2개가 반드시 필요하다는 문구를 수정했다. 성별/모델/개체 유효 대역은 아직 실물 대조 전이다.

## DEC-023 — MECH 필수 포함 시제품 선정과 예산 초과

2026-09-17 사용자 요청에 따라 MECH를 선택적 예비비에서 필수 구성으로 구체화했다. 집게A0.2/지그F-A A0.1 기존 형상은 유지하고 SLS3201PA-F 나일론9개, Essentra 나일론 체결9종, 50A 실리콘1.5/2mm, 동판1/.5mm, 권선Ø.3/브리지Ø.5 에나멜선, KzPton테이프, KE45T를 시제품 선정했다. 잠금은 M3×16 십자나사이며 공구 없는 손나사로 표현하지 않는다. 값싼1T 적동띠의 옵션 오기와 에나멜선5m/3m 불일치를 기록했다.

Chrome7개 판매처 장바구니에서 수량/가격 확인. 확인 합계259,336원(1,500원/USD 가정) + 해외세금/PCB증가운임/조건부교정/현장보호/가공·공구. 신규20만원상한보다59,336원이상 높아 발주보류. 같은MECH를 유지한 저레벨VNA단계 계산197,658원도 세금/부족품 포함 상한통과안은 아니다. 예산/단계를 후속결정으로 남긴다. [전체견적](../procurement/20260917/FULL_BOM_REVIEW.md).

실제 검증: 제조사 최대 나사 머리/와셔19곳 닫힘 상태 공칭 교차0, 원본CAD해시불변. 견적합계/9STL존재 검사. SLS공차±.3mm로 작은홀/너트홈 실제맞춤은 미보증. 출력/조립/실측/보호검증/주문/결제 미실행. 300MHz 달성이나 최종제작승인으로 해석하지 않는다.

## DEC-024 — 발룬 지그와 구매·JLC 주문 통합 (2026-09-17)

사용자가 test_board 프로젝트까지 한 번에 BOM/주문을 합치도록 요청했다. 실제 경로와 기존 구매 작업의 최종 사용자 수량을 확인해 33종 부품을 통합하고, DigiKey 22종을 한 장바구니에 저장했다. 로드7/플럭스2/M12암2/납흡입선제외는 9/11 최종 지시를 따른다. 서로 다른 SMA 장착 부품은 개별 유지한다.

JLC 기존 미결제 W2026091110267631의 Y15–Y18 심사 승인을 확인하고, Y19 및 SLS 9개를 결합했다. 14항목 $252.47 + 배송$9.59 = $262.06. 추가 배송$0.10이며 별도 3D 배송$7.24 제거. 파일 심사 접수는 제조 승인과 구분하며 DRAFT와 예산 보류를 유지한다. 새 PCB/기구 수정·결제·CAM 승인은 없다. [통합 근거](../procurement/combined_20260917/README.md).

## DEC-025 — PCB·기구 선확보와 프로브 전용 부품 구매 이연 (2026-09-17)

사용자가 비용 때문에 발룬을 우선하고, 이어 프로브 PCB와 3D 출력은 유지하도록 범위를 수정했다. JLC W2026091110267631 14항목/$262.06은 취소하지 않고 유지했다. DigiKey RF전용15품목을 카트에서 제거하여 7품목251,067원으로 정리하고 새 공유 링크를 발급했다. 국내 RF원재료8품목도 이번 구매서에서 제외하되 기존 카트는 보관했다. 공용 SMA 수-수 케이블 신규1개는 발룬 VNA2포트용으로 남겼다.

이번 합계755,997원 = 발룬·공용케이블693,342원 + RF PCB/기구/증가배송62,655원(환율1,500원/USD 가정). 종전928,745원 대비172,748원은 후속 구매로 이연한 금액이며 단가 절감으로 기록하지 않는다. RF프로브는 PCB·출력물 확보 단계이고 부품·체결물 없이 동작 완료 상태가 아니다. 결제·CAM 생산 승인·CAD 변경·실물검증 없음.

쿠폰 조사: JLC 계정의 유효쿠폰은 스텐실용$5 1장, 공개PCB/3D쿠폰은 현재 사양/재료와 불일치. 공식 주문당1장 제한 확인. JLCONE의$1~$20즉시 할인/쿠폰1장 중복 행사는 기존 주문 적용 미확인으로 차감하지 않았다. DigiKey/Mouser 공개적용코드는 찾지 못했고 국내 회원혜택은 로그인 후 확인 대상이다. 실제추가적용할인0원. [구매서·쿠폰근거](../procurement/phase1_20260917/README.md).

## DEC-026 — 구매 전달 링크 3분리와 JLC 심사 완료 알림 (2026-09-17)

사용자 요청에 따라 ① JLC PCB/기구 통합 주문 ② 발룬 지그 부품 ③ RF 후속 구매 부품으로 분리했다. ①은 공식 인보이스 9961994A2026091110267631, 14항목 $262.06 및 원본 PDF다. ②는 DigiKey 7종 251,067원 / Mouser 10개 92,040원 / 인두팁·배송 19,800원으로 총 362,907원이다. ③은 독립 DigiKey 15종 123,772원과 국내 8품목/배송 48,976원으로 총 172,748원이다. ①②에서 사는 공용품과 PCB/기구를 ③에서 제외해 중복 없음을 대조했다. 국내 개인 카트 주소는 공유 링크로 취급하지 않고 상품 URL/옵션/수량을 정리했다.

공식 인보이스 PDF를 UI에서 다운로드하고 1페이지의 주문번호/품목/총액을 렌더링 대조했다. 발룬 공유 카트를 다시 열어 7종/수량/251,067원을 확인했다. JLC 기구 5개는 아직 검토 중이며 결제 가능으로 표시하지 않는다. 사용자 요청의 '주문 가능할 때' 후속 대응을 위해 30분 간격 스레드 자동 확인 `jlc`를 설정했다. 준비 완료/의미 있는 변화에만 알리고 준비 완료 후 일시 중지한다. 결제/CAM 승인/외부 발송/공개 호스팅 없음. [전달 자료](../procurement/handoff_20260917/README.md).

## DEC-027 — 트레이 두께 경고로 JLC 제작 보류 (2026-09-17)

**JLC 제작/구매 보류 — 2026-09-17:** FixedTray와 MovingTray에서 각각 0.8mm 미만 벽 두께 경고를 확인했다. 원본 CAD 너트 홈 옆 네 지점의 국소 두께도 약 0.448mm로 계산됐다. JLC 검출 위치와의 일치 여부 및 전체 두께는 미확인이다. 두 부품 보강 검토·재심사·최종 인보이스 갱신 전에는 구매를 진행하지 않는다. 위험 수락은 하지 않았고 자동 확인 `jlc`는 일시 중지했다. ② 발룬 및 ③ RF 부품 링크는 유지한다.

이전 단순 대기 판단은 느낌표 확인을 누락했다. 다른 검토 중 세 품목도 같은 원인이라고 단정하지 않는다. [실제 검사와 한계](../mechanical/clamp_A02_DRAFT/WALL_WARNING_20260917.md). 원본 CAD/STL·공급사 PDF·②③ 부품 문서/카트 보존. 위험 수락·파일 교체·결제 미실행.

## DEC-028 — A0.3 트레이 국소 보강과 재접수 준비 (2026-09-17)

**JLC 파일 교체 대기 — 집게 A0.3 보강 완료:** FixedTray/MovingTray 너트 홈 주변을 보강해 이전 검사 지점 0.448mm를 2.241mm로 늘리고, FixedTray의 별도 0.2mm 벽을 제거했다. 공칭 조립·개폐·지그·STL 검사를 통과했다. 전체 DFM/실물 강도는 미검증이다. 수정 두 파일의 사전 견적은 $6.84(기존 대비 +$0.04). 기존 주문은 아직 A0.2/$262.06이며 구매 보류다. 고객센터의 Replace File 활성화와 재심사가 필요하고 요청 발송 확인을 기다린다. 자동 확인은 PAUSED다.

사용자가 보강 및 재진행을 요청했다. 원본 A0.2를 보존하고 두 트레이만 수정했다. 재생성 가능한 CAD/STEP/STL과 기존 지그 호환성·개폐·나사·저장 mesh 검사를 남겼다. 표면 법선 샘플의 모서리 부근 짧은 교차 길이 7/4건은 전체 DFM 통과로 승격하지 않는다. [검사/한계](../mechanical/clamp_A03_DRAFT/README.md), [교체 파일/고객센터 요청문](../procurement/rework_20260917_A03/README.md). 기존 주문 교체 버튼 부재로 고객센터 요청 발송 확인을 기다린다. 새 견적 업로드는 주문 파일 교체가 아니다.

## DEC-029 — 사용자 승인에 따른 JLC A0.3 교체 및 재심사 접수 (2026-09-17)

사용자는 이 작업에 필요한 고객센터 연락과 일반적인 파일 교체·재심사를 다시 묻지 말고 진행하도록 명시적으로 승인했다. 고객센터 Sky에게 연락해 Replace File을 활성화하고 기존 두 트레이 접수번호를 유지한 채 A0.3 STL을 제출했다. 주문에서 재다운로드한 두 STL의 SHA256이 검증된 원본과 일치한다. 다른 12항목과 UPS $9.59는 유지되고 상품 $252.51, 합계 $262.10으로 갱신됐다. 공식 PDF의 14항목·A0.3 파일명·주문번호·금액을 렌더링해 확인하고 이전 PDF를 보존했다.

Sky는 두 트레이와 Base/InputStand/OutputStand를 엔지니어링팀에 전달했으며 곧 검토한다고 회신했다. 구체적 완료 시각이나 최종 DFM 승인은 아직 없다. 교체 후 목록의 이전 경고 아이콘 소멸을 최종 합격으로 간주하지 않는다. 공급사 심사와 실물 검증은 별도다. 자동 확인 jlc를 30분 간격으로 재개했다. [현재 상태와 파일](../procurement/rework_20260917_A03/README.md), [상담 기록](../procurement/rework_20260917_A03/support_session_20260917.md).

## DEC-030 — 기존 선정 BOM 전체 구매와 판매처 5곳 통합 (2026-09-17)

사용자가 모두 구매 가능하다고 알리고 BOM 정리·판매처 축소·구매 링크를 요청했다. DEC-025/026의 RF 부품 이연 범위를 해제한다. 기존 33종 수량과 JLC14항목을 유지하고, Mouser ADT2-1T+10개를 DigiKey 같은 품번 컷테이프로 이동했다. Chrome 새 카트376731843에서 23종/474,949원 및 공유 링크 https://www.digikey.kr/short/nr974853 생성을 확인했다. 트랜스는 Mouser보다8,070원 추가다. 링크 재오픈 대조는 브라우저 응답 오류로 미실행이다.

국내 7종은 G마켓 상품 링크로 통합했다. 에나멜선은 같은09one 판매자의0.3/0.5mm10m 묶음, 인두팁은 동일 HAKKO900M-T-1.6D/2.4D, RTV는 동일 신에츠KE45 투명100g이다. 폴리이미드 테이프는 KzPton→JCR 판매품10mm×33m로 변경하며 실제 두께를 입고 확인한다. 커넥터·코어·나일론 체결품·CAD/PCB는 변경하지 않았다. 실리콘50A1.5T/2T와25mm×0.5T구리띠는 규격·가격을 위해 기존 전문몰을 유지했다. JLC/DigiKey/G마켓/실리콘플러스/GMTOOL 총5사이트(기존9)다.

기존A03인보이스$262.10과 가정환율1,500원을 사용한 합계939,409원, G마켓 합배송이 안 되면946,409원이다. 같은JLC기준 이전928,805원보다10,604~17,604원 증가. 사이트 감소는 택배 수 감소와 같지 않다. G마켓 판매자별 배송비/묶음 가정/상한을 구분했다. 조건부 쿠폰·적립은 차감하지 않았다. 국내 새 카트 저장 완료는 미확인이다. 상품링크/옵션/수량과 전체XLSX·공식PDF를 새 ZIP에 묶는다.

실제 검증:33품목ID중복/누락 대조, DigiKey23종UI확인, JLC14항목/$262.10 원본 보존, 가격 재계산, XLSX 합계/환율 변경 재계산/오류0·3시트 렌더 확인. 남은 것: JLC5개 재심사, SMA백오더, 코어 판매 포장/보유SOL·THRU실물 확인, 발룬DUT면교정물/고정기구와가공·세금 비용. 결제/생산승인/실물조립/RF측정 미실행. [현행 전체 구매 안내](../procurement/full_purchase_20260917/README.md).

## DEC-031 — G마켓 제외, 디바이스마트·GMTOOL 전문몰 구매로 전환 (2026-09-17)

사용자가 G마켓 구매 경험을 거부하고 Mouser/DigiKey 같은 전문몰 구매를 요청했다. G마켓7종을 디바이스마트6종(팁2, 에나멜선2, KE45투명, 폴리이미드 테이프)과 기존GMTOOL 동판1종으로 옮겼다. 최종5사이트/부품33종/JLC14항목 유지. 기존DigiKey23종은 변경하지 않았다. HAKKO 팁은동일900M-T-1.6D/2.4D, KE45투명100g 유지. 테이프는기존5mm절단사용에 맞는5mm×33m로 변경하고 실제두께/간극은 입고확인한다. 동판원판만100×200→300×200mm 확대, 최종부품128×24×1mm2개 유지. 에나멜동선 직경0.3/0.5mm유지, 소량10m대신각1롤. 정확한롤길이/중량은 미확인. CAD/PCB 변경없음.

실제Chrome에서 디바이스마트6종 카트 및 공식견적(공급가75,600+VAT7,560+배송0=83,160원), GMTOOL동판21,800+동띠2,000+배송3,500=27,300원 확인. 공식견적PDF다운은 브라우저시간초과로 저장미확인. 견적URL은 타인공유 검증없으며 구매팀용6종상품번호/수량목록을 동봉한다. 총992,559원(환율1,500원/USD가정), 직전G마켓안예상대비+53,150원. 주된증가는 선롤판매단위와 큰동판. 사이트수유지, G마켓활성구매링크제거. 기존G마켓파일은history/before_professional_20260917에 보존. 실리콘패드와KE45는 패드고정/완충용이며 코어맞댐면접착용이 아님을 정정했다.

JLC심사/코어포장/SOL실물확인/미선정발룬교정물/실물조립·RF성능검증은 종전보류를 유지한다. 결제·제조승인 미실행. 현행자료: [전체 구매 안내](../procurement/full_purchase_20260917/README.md).

## DEC-032 — 동판 교정지그를 PCB 2종/3장으로 대체 (2026-09-17)

사용자는 판재 절단·드릴·줄질을 할 수 없으며 PCB 대체 제작을 지시했다. 커터칼 수준의 실리콘 재단은 허용했다. 원본 동판 지그를 보존하고 Frame 118×65mm 1장과 동일 EndPanel 128×24mm 2장, 공통 1mm/2층/1oz/ENIG 초안을 작성했다. 기존 A03 집게·받침대·헤드 PCB와 132139 SMA 2개는 유지한다. Frame 레일을 EndPanel 도금 슬롯에 끼워 양면 납땜하고 SMA 중심핀은 Ø0.3mm 권선용 선의 짧은 점퍼 2개로 연결한다. 원형 Ø6.7mm SMA 구멍은 D자 회전 방지 기능이 없으므로 몸체를 잡고 너트를 조이는 조립을 명시했다. 외피 접촉과 실제 체결은 미검증이다.

중앙 다리 양면은 SIG, RET_L/RET_R은 코어 바깥으로만 통과한다. EndPanel은 GND이며 SMA 중심은 절연되어 있다. 초기 힌지 끝 간격0.45mm를 발견해 창을 연장했고 최종 공칭2.00mm로 늘렸다. 두 보드 ERC/DRC/미연결/회로 일치 위반0, 비활성/제외검사0; 저장 보드/별도 netlist/구멍·슬롯/제조 ZIP 대조 통과. KiCad 실제 구리 STEP의 코어 창 교차 검사에서 SIG만 통과했고, A03 결합 CAD의 0~90° 19개 표본에서 겹침0, 최소간격4.01mm를 확인했다. 모두 CALCULATED이며 실측·연속운동·최악공차·RF 성능 검증은 아니다.

동판·동띠·해당배송27,300원과 Ø0.5mm 롤26,840원을 제외한다. 이전 견적966,349원에서 제외액54,140원을 빼면912,209원이며 새 PCB/배송 변동분은 미반영이다. GMTOOL이 빠져4개 판매처가 되지만 카트·JLC 주문·결제 링크 재발급은 하지 않았다. 구매 HTML은 변경안/미견적을 먼저 표시하고 이전 자료를 접힌 이력으로 보존한다. 실리콘 시트는 유지한다.

이 PCB는 형상 재현성을 높이는 시제품 지그다. 50Ω 전송선이나300MHz 교정 정확도를 보장하지 않는다. 빈 지그·프로브 삽입 지그 S-parameter, 중앙 전류 모델과 실제 기준면 확인 전 `ZT=50×S21`을 자동 적용하지 않는다. 최신 SMA 생산 도면·공차/강도·기존 출력물 무가공 조립·새 견적/CAM 확인을 남기고 DRAFT를 유지한다. [설계/검증/조립](../hardware/calibration_fixture_PCB_A01/README.md).

## DEC-033 — 평판 PCB 한 장과 네 모서리 기둥으로 단순화 (2026-09-17)

사용자가 평판 PCB/모서리 나사 고정을 요청하고 수정을 지시했다. A0.1 3장 구조를 144×92.7×1.6 mm/2층 한 장으로 대체한다. SIG 중앙 다리만 코어를 통과하며 귀환은 양쪽 바깥 레일에 둔다. 중앙 SIG 아래 GND를 두지 않는다. 두 귀환의 우월한 정확도를 입증한 것은 아니다.

지그의132139 2개를 헤드와 같은 GCT RFPC-SMA28-F THT 2개로 바꿔 전체 구매량을3개로 한다. 제조사 Rev1.2 도면의5.08mm 피치/드릴을 대조했고, 세로 PCB와 점퍼가 없어졌다. InputStand/OutputStand 출력물은 제외한다. 기존 Base/HeadBracket은 무거운 집게를 독립 지지하기 위해 유지한다. Würth970300365(30mm F/F)/971350365(35mm M/F) 나일론 M3 각4개를 쌓아65mm 기둥4개로 쓰며 기존 나사/바닥판 구멍을 재사용한다. 새3D출력물은 없다. 바닥 M3×12 나사의 공칭 끝 여유0.6mm는 실물 체결 확인 항목이다.

KiCad10 ERC/DRC/미연결/회로일치0, 비활성검사0. 저장PCB/별도XML/드릴59좌표/ZIP10파일 대조. 실제구리STEP의 구경단면에 SIG만 있고 GND없음. 닫힌헤드 간격2mm, 개폐19표본 겹침0/최소4.91mm, Ø12×30mm 플러그 접근공간2곳 겹침0. FreeCAD1.0.2 공칭검사이며 최악공차/나사산/강도/연속운동/실측RF 검증은 아니다.

기존 아래지그4출력물$26.55 중2개$5.36을 제외하고2개$21.19 유지(1,400원/USD시7,504원 제외/29,666원 유지; 이전 개별견적). 새 PCB/기둥/SMA수량/배송 견적 전이므로 최종 합계를 정하지 않는다. JLC 예정구성은 PCB6종+3D7종=13항목. 기존 판매처카트/주문/인보이스는 변경하지 않았고, 구매HTML은 변경분과 기존링크의 이력상태를 표시한다. 기존 CAD/견적은 보존한다. [A0.2 원본·검증·조립·BOM](../hardware/calibration_fixture_PCB_A02/README.md).

## DEC-034 — 지그 나사는 사내 M3 보유품 우선 (2026-09-17)

사용자가 사내 M3~M5 재고를 알리고 나사 구매 절감을 요청했다. 외곽 모서리 체결용 M3 나사는 신규 구매 보류/보유품 우선으로 기록한다. 실제 길이·머리 형태·수량은 미확인이므로 모든 체결품을 일괄 구매 제외하지 않는다. 특히 작은 M2 체결품과 65 mm 절연 지지기둥은 일반 M3 나사의 보유 여부와 별개다. 현재 CAD는 상단M3×10/바닥M3×12이며 바닥M3×10 대체 시 삽입7.4 mm/끝여유2.6 mm를 계산했다. 새 나사 CAD 검증이나 주문 변경을 수행했다는 뜻은 아니다. [현재 치수와 보유품 대체 조건](../hardware/calibration_fixture_PCB_A02/BOM_DELTA.md).

## DEC-035 — ATLAS를 조립·테스트 두 절차서로 분리 (2026-09-17)

사용자는 설계가 계속 바뀌는 점을 고려하되 내용을 비우지 말고 수정하기 쉽게 만들도록 요청했다. 현재 평판 A0.2 기준으로 조립 A01–A08과 점검·교정·측정을 각각 작성한다. 공통 리비전·치수·부품·시험 설정·CAD 포트는 `docs/atlas/source/design.json`, 설명은 공정별 부분 문서로 관리한다. 원본 해시가 바뀌면 기존 통과 결과를 그대로 게시하지 않도록 생성 시 대조한다. 기존 공개 시험 링크는 새 테스트 문서로 연결하고 A0.1은 비교용으로만 보존한다. A0.2는 조립·재제작 변수 감소 측면에서 유지 권고하며 RF 우열·비용 개선은 실측/견적 전 미확정이다. [편집 방법](atlas/README.md), [독립 비교 검토](ATLAS_A02_DESIGN_REVIEW.md).

## DEC-036 — 헤드 PCB 확대와 제작 전 감사 정정 (2026-09-17)

사용자가 SMA 주변 조립 공간과 나사 간격 확보를 위해 PCB를 넓히도록 지시했다. Head A03는 36×28×1.6 mm, M2 나사 중심 간격29 mm, SMA 중심과 나사 중심18.51 mm다. 기존 20×16 mm/8.06 mm 대비 여유를 늘렸다. 권선 패드는 유지하고 플러그 공간 확보를 위해 SMA·주변 비아를 바깥으로4 mm 옮겼다. 신호선은11.026 mm로4 mm 길어지고 양면 동박 외곽과 나사 제외 영역도 달라진다. 이것을 RF 정확도 개선이나 동일 응답 보장으로 표현하지 않는다. 대응 FixedTray A04/HeadBracket A03를 함께 작성했다. [설계/검증](../hardware/probe_head_A03/README.md).

구매 전 전체 검토에서 **A02 교정 PCB를 고정된 열린 집게 위에서 내리는 기존 조립 순서의 충돌**을 확인했다. 완성 자세·개폐 검사만으로 실제 조립 가능성을 판단했던 부분을 철회한다. 지그 설명에 이 실패를 표시했으며, 출력 공차/금속 나사/교정 준비물/발룬 외부 지지 기구 등도 [감사 F01–F09](../reviews/prepurchase_20260917/REVIEW.md)에 남겼다. 이 근거는 종전 평판 A02 유지 권고의 조립 가능성 판단을 제한한다. 헤드 확대만으로 전체 감사가 해결되지는 않는다.

현재 작업은 감사와 넓힌 헤드의 로컬 검토본이다. 기존 파일·공급사 제출본을 보존하고 새 공급사 파일/카트/인보이스를 만들지 않았다. 구매 HTML의 첫 화면은 현재 구매 보류와 구 견적의 이력 상태를 알린다. 별도 진행 중인 ATLAS 설명 문서의 원본/사이트는 이 작업에서 수정하거나 배포하지 않았다.

## DEC-037 — 코어 맞댐과 케이스 잠금 분리 (2026-09-17)

사용자가 개폐·코어 접촉·공차 문제를 깊게 검토하고 수정하도록 지시했다. A05는 상부를 분리하고 두 손나사로 케이스를 닫는다. 이는 한 손 힌지 구조와 조작성 차이가 있다. 움직이는 상부 코어 받침과 두 압축 스프링으로 케이스 스토퍼와 코어 맞댐 치수를 분리했다. 고정바 높이는 실제 코어 C 치수에 맞추고, 출력 관통 홀 확대·외부 너트·선택식 가이드 칼라로 무가공 조립을 지향한다. 과조임 방지 토크나 실제 접촉력이 검증된 것은 아니다.

Head PCB A03 36×28 mm와 교정 PCB A02는 유지하고 헤드 전체 배치를 바깥으로4 mm 더 옮겼다. 새 HeadBracket A05와 벤치 아래 삽입 M2×16을 함께 설계했다. 상부 제거 후 PCB 삽입/분리, 받침 조립·이동, 스프링을 따라 닫히는 경로를 저장 CAD로 검사했다. 실제 출력 공차, 마찰, 자중/자세 변화, 코어 맞댐, 반복 RF 특성은 남아 있다. 스프링·손나사·너트는 일차자료의 규격 후보이며 카트/가격을 갱신하지 않았다. [변경·파일·검증·한계](../mechanical/clamp_A05_DRAFT/README.md). 공급사 재제출·구매·ATLAS 배포는 수행하지 않았다.
## DEC-038 — 독립 도크와 기구 보호 반영 (2026-09-18)

사용자는 뷰어 작성 뒤 멈춘 점을 지적하며 계속 진행하도록 했다. A05의 PCB/지그 나사 공유를 실제 CAD에서 제거한다. A06 FixedTray의 열린 슬롯을 별도 M4 손나사 두 개로 고정하며, 나사를 약 3 mm 풀고 +Y 22 mm 이동한 뒤 헤드를 +Z로 분리한다. 작은 PCB의 M2×10 두 개는 벤치/현장 모두 계속 체결한다. FrontGuard와 열린 동축 받침을 추가하고, 실제 외피를 비금속 타이로 고정한다. 보호 가드는 인증된 절연 외함이 아니며 최종 가드·타이 상태로 RF 교정해야 한다.

저장 CAD를 다시 읽어 변경 부품 겹침, 8개 경로 182개 공칭 위치, 가정한 Ø16×45 SMA 플러그/Ø6 동축, 게이지와 공구 공간, 출력 부품 13개 솔리드를 검사했다. 초기 베이스/측벽/짧은 슬롯 이동의 간섭을 수정하고 재검사했다. 이것은 실제 강도·마찰·케이블 맞춤·RF 검증을 대체하지 않는다. [A06 검토와 변경 BOM](../mechanical/clamp_A06_DRAFT/README.md). 기존 CAD와 공급사 제출물은 보존하며 주문·카트 변경은 하지 않는다.

## DEC-039 — 개폐 편의와 단순성을 다시 우선 (2026-09-18)

사용자는 A05/A06이 복잡해지고 뚜껑 손나사가 플라스틱 사이에 묻혀 조작하기 어렵다고 지적했다. 원래 힌지형 사용 방식, 공차가 있어도 맞닿는 코어 받침, 손이 닿는 반복 잠금부, 다양한 측정 케이블의 간단한 고정과 금속 체결품 RF 영향을 후속 검토 기준으로 한다. A06의 도크 손나사 접근 검사를 개폐 손나사 접근 검증으로 취급하지 않는다. 현행 개폐부는 이미 금속 사각 너트이나 외곽 배치/플라스틱 하중 분산/과조임 검토가 추가로 필요하다.

비금속 열린 받침·패드·재사용 밴드와 외곽의 국소 금속 잠금부를 우선 검토한다. 금속이 코어 구멍 안과 바깥을 연결하는 단락 턴을 만들지 않아야 하고, 최종 구성의 반복 RF 검증 전 무영향을 선언하지 않는다. 이 항목은 **요구·검토 방향 기록**이며 새 CAD나 부품 선정을 완료한 결정이 아니다. [상세 범위와 미검증 항목](CLAMP_SIMPLIFICATION_BRIEF.md). 기존 제작 파일·뷰어·주문은 유지했다.

## DEC-040 — A08 공통 바닥 및 패드 없는 코어 보유 (2026-09-18)

사용자가 전체 RF 클램프를 큰 크기여도 간단히 조립하고 중심 높이가 맞으며 기계적 실패가 없도록 다시 구상·표현하도록 지시했다. 공통 바닥과 C02 두 개를 통합하고, 사각 구동너트/넓힌 가이드/기성 축 고정 조합을 적용한다. A08 코어는 열린 받침과 앞 고정바로 잡고, 별도 스프링 없이 뚜껑 일체형 플라스틱 탄성부로 닫힘 편차를 흡수하는 **후보 구조**를 만들었다. 나사 하중은 외곽 멈춤 기둥으로 전달한다. 탄성 원리를 숨기거나 실제 조립 무오류를 보증하지 않는다.

제작용 자유 형상과 조립용 변형 형상을 분리한다. 출력물10종/총15개, 바닥 기준Y=-72, 측정축Y=0. 공칭 CAD/명시한 치수/분리 경로는 검사했지만 힘·마찰·개폐 반복·출력 뒤틀림·RF 무영향은 미검증이다. [A08 검토](../mechanical/assembly_A08_DRAFT/README.md). 기존 공급사 제출물과 카트는 보존한다.

## DEC-041 — 표시한 캠 홈 끝 보강 및 코어/PCB 체결 감사 (2026-09-18)

사용자의 실제 지적은 아래 두 턱의 대각선 캠 홈이 연결틀 상단과 만나는 열린 끝이다. 이를 위쪽 너트 투입구로 해석했던 설명을 정정했다. C03은 연결틀의 판 상단을4 mm 높여 둥근 막힌 홈과3.7 mm 상부 재료를 확보한다. 핀은 앞에서 삽입하며 구경21위치와 조립 경로를 재검사했다.

A09 뚜껑 탄성부 두께1.6→2.4 mm, 길이42→63 mm로 동시에 변경해 이상화한 강성의 급증을 피한다. 잠금 나사 X±111 mm, 헤드폭242 mm, 바닥254×314 mm. 코어 뒤 받침을 넓히고 아래에도 이탈 대비 턱을 추가했다. 공칭6방향 직선 포획과 고정바의 앞쪽 분해/공구 공간은 확인했으나 회전 탈출·힘·과조임·실제 출력 뒤틀림·반복성은 미검증이다.

Head PCB A03는 M2 나일론 나사+나일론 너트를 유지한다. SMA 중심과 나사 중심18.51 mm나 동박 제외만으로 철 나사의 RF 무영향을 보증하지 않는다. 임의의 더 큰 금속 와셔/철 나사로 교체하지 않는 기준을 표시했다. PCB를 확대하거나 회로/교정 조건을 변경하지 않았다. [A09 원본·실제 검증·한계](../mechanical/assembly_A09_DRAFT/README.md). 기존 공급사 파일·카트·ATLAS 작업은 보존한다.

## DEC-042 — 전 공정 감사와 A10/C04 취약 벽 수정 (2026-09-18)

사용자가 실제 작동 가능성을 깊게 검증하고 전후 그림으로 설명하도록 요청했다. 공칭 간섭 검사만으로 발견하지 못한 아래 턱 사각 홈의 관통·얇은 가장자리, 너트 홈과 가이드·고정바·기둥의 취약 벽을 실제 STEP/STL에서 확인하고 수정했다. A10/C04는 PCB와 기본 배치·10종15출력물을 유지한다. 추가18경로423위치와40,000점 벽 두께 선별검사, 두 메시의 실제 형상 선형 해석을 실행했다. 해석 반력5.29 N과 약1.08% 메시 차이는 공칭 탄성 모델 결과이며 실제 수명/강도 허용 판정이 아니다.

CAD 통과를 생산·RF 승인으로 확대하지 않는다. 기성품 최종 선택, 출력 평탄도·공구 조립, 케이블 과조임, 코어 맞댐 반복성과 크리프, RF 국소 전류/교정·삽입 영향, BNC/스코프 응답, 광대역 전류 복원·현장 보호가 남아 있다. [전체 감사](../reviews/functionality_20260918/README.md)와 [실물 확인 순서](../reviews/functionality_20260918/NEXT_CHECKS.md)에 기록한다. 기존 공급사·카트·ATLAS는 변경하지 않았다.

## DEC-043 — 책상 접촉·체결 조작·발주 파일을 추가한 최종 감사 (2026-09-18)

기존 CAD 장애물에 책상면이 없어 바닥 M4×25 나사 6개의 3–4 mm 돌출을 놓쳤다. 별도 수정 검토본에서 M4×20과 홈 천장에 안착한 사각너트로 변경하고 바닥 여유 1/2 mm, 공칭 너트 물림 3.2 mm, 변경 부품 간섭 0을 확인했다. 전체 설계·STL·사이트는 덮어쓰지 않았다. 현재 부품과 결합한 수정본은 감사 폴더의 FCStd/STEP 및 재현 코드로 보존한다.

헤드 SMA의 Ø16×45 mm 가정 접근 공간은 LowerKeeper와 겹친다. 이는 모든 실제 플러그의 장착 실패를 뜻하지 않으나, 넉넉한 체결 공간이 확보되었다는 주장을 철회할 근거다. 교정 PCB M3 육각너트의 8 mm 홈도 회전 방지 기능이 없으며 실제 공구 접근을 검증하지 않았다. 이 두 조립 항목, 정확한 기성품과 출력 공차/조건을 해결한 뒤 전체 기계 발주로 진행한다. 이전 인보이스를 A10용 구매서로 사용하지 않는다.

PCB 거버/드릴을 현재 원본에서 새로 내보내 기존 ZIP 18파일과 생성 시각 외 일치를 확인했다. RF 실측은 제작 후 단계로 구분하며 기계 CAD 합격이나 단순 50×S21만으로 절대 전류·300 MHz·현장 보호를 승인하지 않는다. [최종 감사](../reviews/manufacturing_20260918/README.md).

## DEC-044 — 공정별 검사 범위와 중간 조립 상태를 명시 (2026-09-18)

반복 감사에서 새로운 문제가 나오는 원인은 완성된 공칭 위치의 간섭 검사와 제작 가능성 검토를 충분히 구분하지 않은 데 있다. 권선을 제외한 코어의 삽입이나 특정 각도에 놓인 너트의 삽입은 권선된 코어 조립·공구 작업·너트 회전 방지 검증의 대체가 아니다. [공정/부품군별 검사표](../reviews/coverage_20260918/README.md)에서 통과 범위·확인된 문제·미검증 항목을 고정해 관리한다.

SMA는 기구에 넣기 전 납땜하고, 코어 권선 끝선은 안착 후 패드로 배선하도록 절차를 정정했다. 임시 끝선을 사용한31삽입 위치와 고정바를 뺀 패드 접근 공간을 공칭 CAD로 확인했다. 기존 M02는 SMA뿐 아니라 S+/S− 정비 접근까지 함께 해결해야 한다. 구동너트6.8 mm 홈/5 mm 너트의1.8 mm 공칭 여유와 뚜껑±0.6 mm 측방 이동 허용도 수치화했으며 실제 유격·RF 오차 측정값으로 취급하지 않는다.

축/잠금너트 회전25자세, 실제 너트 안착7경우, 사각너트5종의 회전 제한,3구경의18직선 포획과 M2 드라이버 공간을 추가 검사했다. 교정 PCB 육각너트의 회전 가능은 기존 M03를 재확인했다. 현재 제품 CAD·출력물·PCB·사이트와 업체 주문은 변경하지 않았으며, 전체 발주 보류를 유지한다.

## DEC-045 — A11/C05 실제 형상과 문서 동기화 (2026-09-18)

바닥 나사20mm·고정바 접근·L형 수동 기준·교정 너트 바깥쪽 공구 창·구동너트1mm공칭여유·권선 출구 작은 잔여 조각 제거를 반영했다. 닫힘 표시CAD의 곡선/면 연결도 수정했다. 자유 뚜껑은 동일하며 이전FEA 범위를 확장하지 않는다. 14곳 실제CAD 3D비교와 원본4장면 문서를 최신파일로 갱신한다. [검토 근거](../reviews/visual_revision_20260918/README.md). 실물/RF/최종부품선정 미완료,DRAFT,구매나업체제출 변경없음.

## DEC-046 — A12/C06 너트 삽입·탈락 방지와 제작성 (2026-09-18)

고정용 너트의 조립 여유는 유지하고, 조이면 본체 받침면에 밀착하는 기능과 나사를 뺐을 때 탈락하지 않는 기능을 분리한다. 프로브2/교정PCB4/가로대4곳에 같은 나사 없는 덮개를 적용한다. 캡은 체결 하중을 받지 않으며, 설치 후 긴 탄성팔은 공칭 무변형이다. 교정 PCB의 작은 육각너트는 출력 공차와 공구 조작을 고려해 PA66 날개너트 SMO-3(N)으로 교체한다. 바닥6개 너트는 별도 M4 두 곳으로 고정한 판 하나로 유지한다. M6축은 얇은 너트 두 개 대신 Bossard BN33024/5813950 하나로 초도 조립한다.

출력은10종15개에서12종26개로 늘어난다. 반복 개폐의 너트 분실과 반대쪽 공구 사용을 줄이기 위한 변경이며 부품 수 감소로 표현하지 않는다. 코어 고정바와 작은 헤드 PCB의 초도 공구 조립은 유지한다. M6구동포켓1mm방향전환여유는 축 잠금너트 과조임으로 제거하지 않는다.

실제 CAD, 경로, 손/공구 외형 게이지와 출력파일 검사를 기록하되 스냅 삽입력·해제력·실물 공차·수명·RF 무영향을 보증하지 않는다. 상세한 검사 결과·입력 해시·남은 조건은 [A12/C06 검토](../reviews/nut_access_20260918/README.md)를 따른다. 기존 공급사 제출·주문·구매가격은 변경하지 않는다.

## DEC-047 — A13/C07 분실방지 기능 철회, 단순 조립 우선 (2026-09-18)

사용자가 요구한 것은 쉬운 너트 삽입과 공구 접근이다. 별도 분실방지 요구를 추론하지 않는다. DEC-046의 공용 덮개10개, 긴 받이, 바닥 유지판1개 및 그 고정 체결품2쌍을 제거한다. 나사를 뺀 상태에서 너트가 빠지는 것을 허용한다. 나일론 날개너트와 작동축 M6 잠금너트는 유지한다. 기존 얇은 벽 보강과 권선 접근, 코어 고정은 유지했다.

10종15개 출력. 기존 A12/C06은 이력으로 보존하되 구매 대상에서 제외한다. 이번 검증은 저장 CAD/출력파일/공칭 경로에 한정하며 실물 조립이나 RF 합격을 의미하지 않는다. [변경·검증 기록](../reviews/simplification_20260918/README.md).

## DEC-048 — 교정 PCB A02 정합 검토와 구매서 분리 (2026-09-18)

두 바깥 GND 귀환은 유지하지만 50 Ω 정합은 확정하지 않는다. 중앙 단면 준정적 모델은 약 241.65 Ω이며 전체 짧은 보드의 입력 임피던스가 아니다. 전체 3D 경로·코어 안 기준 전류를 검증하고 새 리비전을 확정하기 전 A02 발주를 보류한다. 저주파 π 근사의 약 5.3 pF 양끝 소자는 후보 계산일 뿐, PCB/BOM 채택이 아니다. [근거](../reviews/fixture_impedance_20260918/README.md).

구매팀 링크를 현행 BOM과 분리한다. 전자부품 카트는 RF 4종+기존 발룬 5종, 348,513원이다. 코어 판매단위, 체결품 미선정, JLC 제조비는 이 합계 밖이며 전체 세트 금액으로 표시하지 않는다. 보유품과 구형 동판·실리콘·기구는 제외한다. 현행 제조물 교체표를 제공하되 업체 주문·결제는 수행하지 않는다.

## 2026-09-19 — A14 출력 분할 패치 (제작 승인 아님)

사용자는 전체 재설계보다 출력 안정성과 자연스러운 파트 구분을 요구했다. JLC가 경고한 A13 큰 부품 3개를 8개로 나눈다: 기능별 바닥 3개, 중앙 코어 받침을 보존한 하부 3개, 탄성부를 자르지 않고 중앙 턱에서 연결한 뚜껑 2개. 새 이음부는 비금속 M4 10쌍과 열린 공구 접근을 사용하며 접착·분실방지 기구를 추가하지 않는다. 코어/PCB 위치, C07 부품, 63×18×2.4 mm 탄성부는 유지한다. 바닥 아래 두께 +4 mm로 축 높이는 88 mm다. 제조사 재검토·나일론 볼트 품번·강도/크리프·첫 실물 조립이 필요하다. 전체 재제작 파일과 실제 검사 범위는 mechanical/assembly_A14_DRAFT/README.md를 따른다. A13 업체 파일은 아직 교체하지 않는다.

## 2026-09-21 — A14 기성품·공구 경로와 PCB 홀더 보강

기존 분할 구조는 유지한다. Essentra PA66 M4×20(베이스 아래 삽입)4개/M4×30(하부4·상부2)6개로 실제 길이 여유를 확보한다. C07은 Ganter 암나사 노브와 완성 M6×120 전산봉·잼너트·평와셔를 사용해 절단/압입 없이 조립한다. 자동 박벽이 남은 PCB 홀더는 내부 창을 바꾸지 않고 외벽과 바닥만 넓혔다. CAD 통과를 제조사 DFM이나 물리적 기능 보증으로 표현하지 않는다.

새8종은 기존 RF 견적에 검토로 접수하고 교체대상 A13 큰3종만 금액에서 제외했다. 출력 제조 검토와 실물 기능 시험은 별개다. 위험수락·결제·제작 승인 없이 수동검토를 기다린다. 자세한 원본·파일 해시·남은 시험은 reviews/a14_recheck_20260921을 따른다.

## 2026-09-21 — A14 조립절차 동기화와 기성 체결품 확정 범위

현재 문서 기준은 저장 CAD `93ba7a61650cfc94c3a9d644f7af4473283908f98d1194f296e7ecd7819f7f92`, 125객체·조립 45단계·BOM 58행이다. 분할된 하부 3조각·뚜껑 2조각·바닥 3조각을 먼저 체결하는 순서와 새 연결 체결품을 안내서에 반영한다. 기존 A13 단일 부품의 조립 설명을 현행 A14 조립 절차로 사용하지 않는다.

F05의 기존 M4×50은 공칭 나사 끝 여유가 0.4 mm에 불과했다. 기성 NBK `KNFS-16-M4` 관통노브, Fabory `20106.040.070` M4×70 스터드, `51080.040.001` M4 잼너트, Essentra `17M04DIN34815` 와셔를 각 2개 채택한다. 밖에서 한 번 맞조여 절단·압입 없이 조립하며, 평상시 개폐는 묶음 전체를 돌린다. 명목 끝 여유 6.9 mm는 실제 체결 토크·풀림·완전 나사산 검증을 대신하지 않는다.

F11 하부 와셔는 상부와 같은 Fabory `50060.060.001` ID6.4/OD12/t1.6을 쓴다. 하부 nyloc와 해당 공구 위치를 0.8 mm 내리고 공칭 축방향 여유 목표 0.2 mm를 유지한다. F01 M2 머리는 실품 최대 Ø4×1.6을 CAD에 반영한다. F12는 NBK `SBSMS-M4-5-20` 어깨 최대 길이 20.25 mm의 명목 조립·이동을 확인했으며 일반 M4 나사로 대체하지 않는다.

앞선 외벽 보강 설명만으로 PCB의 옛 삽입 경로가 유지된다고 판단하지 않는다. A14 추가 상단 보강부는 기존 30°/1.6 mm 경로와 실제 겹쳤다. 출력 형상은 유지하고 아래 고정바/M2 나사 제거, 권선 끝선 분리 상태에서 약45°/4 mm로 넣어 올린 뒤 세우는 경로를 채택한다. PCB/SMA 362개 부품 자세를 검사했으나 실제 손과 유연한 권선 끝선은 검사하지 않았다.

이번 변경은 기성품 CAD 외형과 문서/표시 경로에 한정한다. STL 15종·설치 20개는 이번 기준본과 바이트 동일하므로 새 출력 형상 변경이나 재접수를 뜻하지 않는다. 이전 978자세(8e 기준), 중간 455자세(c718 기준), 최종 82개 묶음 자세(93ba 기준)는 각각의 원본 해시를 보존한다. 최종 82와 독립 후보 328개 부품 자세는 같은 표본이므로 합산하지 않는다. 바뀌지 않은 형상과 추가 재질의 이동 영역 검사를 통해 재사용 범위를 연결한다.

2026-09-21 14:13 KST JLC 관측은 신규 8종 검토중, 기존 출력 7종+헤드 PCB 승인이다. 위험 수락·결제·제작 승인 없음, 실물·DFM·RF 및 A02 정합/발주 보류를 유지한다. Sites/Atlas 공개 반영은 이 기록 시점 진행중으로, 로컬 문서 동기화 완료와 구분한다. 상세 근거는 [이번 검토](../reviews/a14_document_sync_20260921/README.md), [최종 검증 연결](../reviews/a14_document_sync_20260921/independent/current_evidence.json)을 따른다.

## 2026-09-21 — 전체 제작준비 판정 정정 및 현행 문서 통일

선정·CAD무간섭·업체파일승인을 전체제작준비완료와 구분한다. E03 교정PCB는9/18부터 기술보류였으며, 약242Ω단면값만으로 전체불량/재설계필수라 단정하지 않는다. 전체경로/코어전류 모델을 확인하고 기존외곽·나사홀·높이를 유지하는 방향을 우선 검토한다. 변경 시 BaseCenter 의존성을 먼저 대조한다. HeadA03의GCT핀/일반PTH공차 대조도 아직미완료이며파일승인으로종결하지않는다.

현행 상태의 단일 진입점을 CURRENT_READINESS.md 및 사이트 BOM 준비상태표로 둔다. 현재58BOM에 설계상태와 조달상태를 구분해 표시하고 45단계의 오래된 C04 미선정표현을 수정한다. 구매누락4종복원은유지한다. 동판/패드/옛출력·구매이연문서는이력으로분리한다. 새 CAD/발주/위험수락/결제를 하지 않았고 실물시험을 만들어내지 않았다. 원본과 재검산은 reviews/full_audit_20260921을 따른다.

## 2026-09-21 · F01 M2×12 채택

F01을 Essentra **50M020040P012 / PA66 M2×0.4×12 / 2개**로 채택했다.
기존10 mm는 최대 너트에서 공칭 끝 여유0.19 mm였고, 12 mm는2.19 mm다.
출력물15종은 바이트 단위로 동일하며, CAD의 다른124객체도 형상 동일하다.
길이12.3 mm 포락의 앞쪽 탈착61자세에 대해 전체 조립체와 간섭이 없었다.

검증/입고조건: `reviews/technical_closure_20260921/README.md`. 공급자 공차 보증이나 실물 조립 합격을 의미하지 않는다.

## 2026-09-21 · A02 해석 인공 단락 해결, 실제 설계와 분리

사용자가 지정한 `ckh7488/agent-rules`의 AGENTS.md 및 README.md를 읽고 적용했다. 실제 원본 구리의 연결성과 해석기가 만든 PEC 연결을 구분해 확인한다. SMA와 테이퍼의 불충분한 격자가 SIG/GND를 인공적으로 연결한 것을 검출했다. 제품 PCB를 수정하지 않고 두 영역의 국소 격자를0.25/0.20 mm로 바꿨고, 두 실행에서 각각 신호·귀환 연속 및 분리와 기본 물리 검산을 통과했다.

두 계산의1–300 MHz 중앙 전류 복소 상대차 최대0.437%는 국소 격자 비교 결과이며 실측 정확도나 수렴 오차 보증이 아니다. 원래 전역 에너지−50 dB 종료조건은 두 실행 모두 미달이다. 시간창 안정성, 종료 사유와 초기 실패를 그대로 보존한다. 모델 내부 기준면, 무코어 조건,100 MHz 부근 정합 목표 미달과300 MHz 전류 환산 차이가 남아 있어 A02 발주 보류를 유지한다. 이 실패 해석을 제품 전면 재설계 이유로 사용하지 않는다. 상세: `reviews/fixture_em_20260921/RESULT.md`.

JLC는9/21 17:10 KST 현행 출력물15종·20개 모두 파일 승인이다. RF 헤드 PCB5장+출력물+배송 $400.35는 동일하다. BOM·구매서·분할 검토 문서를 Sites22판 및 ATLAS에 게시했다. 업체 파일 승인과 실제 맞춤/성능 승인은 구분하며, 이번 CAD·제조파일 변경이나 결제는 하지 않았다.

## 2026-09-21 · 제작 전 지그 외형 유지와 SMA 홀 보완

첫 시제품의1–100 MHz 우선 검증은 기존 A14/C07 외형·교정 PCB 외곽/창/고정홀/높이를 유지한다. GCT Rev1.2와 JLC 일반 PTH 공차를 함께 계산해 중심 SMA 홀1.50→1.70 mm, 접지홀1.70→1.90 mm로 보완하고 헤드 A04·교정 PCB A03 검토본을 별도로 작성했다. 핀 휨·진위치·납땜 접합·실제5핀 맞춤은 첫 실물의 인수 조건이다. 기존 제조파일과 STL15종은 보존했다. 헤드 A03 업체 승인은 A04에 승계하지 않으며, 새 PCB 파일 교체/심사와3D 출력물 재제출을 구분한다.

6개 새 무코어 FDTD와 이전2개 비교에서1–100 MHz 중앙 전류의 수치/재료/런치 민감도를 확인했다. dual mesh 관측면이 요청 중앙과 어긋난 점을 소스로 확인하고 실제 y=0 공간 보간과 오차 비교를 추가했다. 원래 결과를 덮어쓰지 않는다. 양방향 중앙 전류의 차이는 비대칭 창/귀환부와 함께 검토하고, 상호성은 S21/S12로 판단한다. 관측량 안정성을 확인해 정상 정리 중지했지만 전역 에너지−50 dB 수렴으로 기록하지 않는다.

100 MHz에서 정합−20 dB 목표 미달,300 MHz 이상에서 수치/재료 민감도가 남으므로 실물에50×S21/1−S11 또는 모델 HI를 자동 적용하지 않는다. 이번 완료는 제작 전 두 항목의 설계 검토이며 센서 성능·현장 사용·전체 제작 승인 완료가 아니다. 공개 사이트/업체 주문은 이전 상태를 보존한다. 근거와 원시 출력은 `reviews/design_closure_20260921/README.md`, 후속 연결·설정·저장 파일은 `BENCH_ACCEPTANCE.md`를 따른다.

## 2026-09-22 · 중실 비아 재검증과 실물 전 형상 검토 종료

사용자 지시에 따라45개 비아를 드릴 반경의 유한 중실 PEC 원통으로 모델링한다. 전체 PEC 성분과 각 비아의 연속 수직 연결을 검사하고 고립 도체가 있던 이전 모델의 검증 주장은 승계하지 않는다. 사용자 지적 후 시간창0.05% 대신 연속 두1 ns의 복소 전류0.2%/복소S 절대 차0.002로 관측량 종료 기준을 조정한다. 전역 에너지 수렴과 구분하며 최초 정책·실패·원시 데이터를 보존한다.

최종7조건은 새 시간창 기준을 충족한다.1–100 MHz 격자/영역1% 선별은 충족하지만100–300 MHz Z 메시4.595%는3% 기준 초과로 남긴다. 해당 크기 차0.266 dB/위상2.018°와 동일한 물리 모델 정의, 관측면 검사를 함께 검토해 추가 PCB/STL 변경을 요구하지 않는 것으로 판단한다. 완전한 공간 수렴이나300 MHz 교정 승인은 아니다. 실제 기준면·코어 부하 없이50×S21/1−S11을 자동 적용하지 않는다.

SMA5핀 공차·최대 외형 경로·코어 공차·3/5/7턴 공간·부수적 단락 턴·제조 원본 재생성을 검토했다. Head A04/Fixture A03 제조 ZIP 및A14/C07 출력15종은 유지한다. 기존 헤드 A03 승인은 새 PCB로 이전하지 않으며 새 업체 제출·구매·공개 배포는 실행하지 않았다. 실물 검토로 닫을 수 있는 항목과 조달은 별도로 남는다. 근거: [최종 재검토](../reviews/recheck_20260922/README.md), [판정](../reviews/recheck_20260922/closure_decision.json).

## 2026-09-22 · 반복 재제출 방지를 위한 독립 제조 검토와 인계 고정

추가 재검토 요청에 따라 저장 KiCad/CAD를 별도로 읽고 실제 제조 ZIP을 역대조했다. 두 PCB의 SIG/GND 연결, 확대 PTH 잔여 링, 동박/가공 간격, 마스크 개방, 드릴 좌표·지름을 확인했다. 8개 동박 비교의 면적 차는0이다. 두께1.76 mm 및 각 외곽+0.20 mm 포락에서 의도하지 않은 정지 조립 간섭이 없다. 고정홀 피치/지름의 복합 치수 모델은 여유를 갖지만 공개 출력 공차에 없는 진위치·평면도까지 보증하지 않는다.

Head A04·Fixture A03·A14/C07과 제조 ZIP/STL을 유지한다. 잔존 내부 제목과 Gerber job Finish=None은 제조 인계표에서 해소하고 비기능0.9 mm 실크는 가독성 한계로 수용한다. 이것을 이유로 새로운 물리 리비전을 만들지 않는다. 두 개별 ZIP과 제조 옵션, 검토/원본 SHA-256을 동결하고 제출 전에 검증한다. 변경 파일을 자동 재승인하는 검증기는 만들지 않는다. 새 업체 제출·메시지·결제·공개 배포는 실행하지 않았다. 근거: [추가 검토](../reviews/submission_freeze_20260922/README.md), [제출 기준](../reviews/submission_freeze_20260922/MANUFACTURING_HANDOFF.md).

## DEC-049 — 독립 재검토, 구경 범위 확정과 조립 순서 수정 (2026-09-22)

`ckh7488/agent-rules`의 패시브 및 재검토 규칙에 따라 원자료/평가기준에서 새 결론을 만든 뒤 이전 답과 비교했다. 원시 V/I를 독립 환산하고 현재 제조/CAD/분석 소프트웨어를 다시 검사했다. 이전 종료 결론의 단순 승계가 아니다.

새로 찾은30 mm 구경 불일치는 고정바 돌기4개 때문이었다. 실제 공칭 상한은26.40076 mm이며 C07은6–26 mm다. 사용자에게 도면을 보여 드린 뒤 “26mm, 지금으로 해도 상관없음”, 실제 큰 대상도약20 mm 수준이라는 확인을 받았다. 초기30 mm 목표를 현행26 mm 기준으로 명시적으로 대체하고, PCB/출력물 형상은 유지한다. 제조공차를 포함한 최대지름 보증으로 확대하지 않는다.

기존 추가 인계 문서의 권선 선납땜은 실제 삽입 경로 조건과 충돌했다. SMA만 선납땜→PCB장착→권선납땜→고정바로 정정하고, 탈착 전 끝선 납땜 제거를 명시했다. Ø3×24 mm 작업부의 두 패드 접근 간섭0이다.

최대 PCB 외곽 각변+.2 mm/두께1.76 mm를 이동시켜 초기회전27자세의 미소겹침을 검출했다. 장착면에서 먼저+Z0.3 mm 띄운 뒤 기울이는 경로로 바꾸고 같은 최대 PCB·최대 SMA 각181자세 무간섭을 확인했다.45단계 조립 소스/JS동작 계약 검사를 통과했다. 실패 원자료와 후보를 보존했다.

최종적으로 Head A04·Fixture A03·A14/C07의 추가 형상 수정 없이 첫시제품 설계검토를 닫는다.100–300 MHz Z격자4.595%의3%기준미달과100 MHz S11−17.94 dB의초기정합목표미달은 그대로다. 실제전류모델·ZT·반복성·직접픽업·정밀도는 실물검증 전이다. 새PCB CAM·코어판매단위/체결조달/최종비용·구매승인은 별도다. 업체제출·결제·공개게시·실측은 실행하지 않았다.

근거: [전체 독립 재검토](../reviews/independent_release_review_20260922/README.md), [발견사항과해소](../reviews/independent_release_review_20260922/review_decision.json), [수정한 인계](../reviews/independent_release_review_20260922/MANUFACTURING_HANDOFF.md).

## DEC-050 — 원문 전수 조사·재제작 검증·Z격자 추가 계산 (2026-09-22)

사용자 요청에 따라 프로젝트/현행 ATLAS/중첩 ZIP·TAR 문서4,621항목의 고유 원문885개를 추출하고 파일별 적용 범위를 기록했다. 현행 지시 문서는 실제 KiCad/CAD/최종58행·45단계/접수 원자료와 대조했고, 초기30 mm/힌지/90°스토퍼/선납땜/미제출 등과 현행 지시를 분리했다. 과거 검증 원문은 고치지 않고 이력으로 남겼다. 모든 과거 카탈로그 문장을 새로 실증했다고 주장하지 않는다.

원본 해시 검사와15개 의도적 문서 변조 반례를 추가했다. 변경 해시를 자동 승인하지 않고 원문 재검토를 요구한다. AGENTS의 초기 빈 프로젝트 안내도 실제 상태에 맞췄다. 110소프트웨어 시험을 다시 실행했다.

현재 builder를 별도 폴더에서 실행해125객체 형상·STL15종이 일치했다. 뒤 M2너트의Ø6.5 관형 공구 간섭을 확인하고,0.6×1.5/25 mm 평팁과 후방 손잡이 포락246자세를 확인해 공구 설명을 수정했다. M3관형Ø8 포락은 하부/자유뚜껑 각각82자세 무간섭이다. 실제 맞물림·파지력·손 작업은 입고 확인이다.

Z0.3→0.2 mm의1–100/100–300 MHz 최대 복소 전류 차이는 0.2168% / 1.7206%, Z0.2→0.15 mm는 0.2564% / 2.1231%다. 차이는 단조 감소하지 않으므로 수렴 차수나 연속해 오차 상한을 확정하지 않는다. 새 모델의100 MHz S11도 각각−16.23/−16.73 dB로−20 dB 목표 미달이다. 두 새 인접 비교는1%/3% 선별 기준 안이다. 9조건 시간창 안정성도 충족한다. 기존0.5/0.3 mm 미달과100 MHz 정합목표 미달을 삭제하지 않으며, 전체3D 수렴/실측ZT/300 MHz 정밀도로 확대하지 않는다.

제출 전 원본 스냅숏과 제조/CAD74파일이 동일하다. Head A04/Fixture A03/A14·C07의 추가 물리 리비전이나 JLC 재업로드를 수행하지 않는다.9/22 18:49 KST 새 UI 관측에서Y21/Y22 Approved·RF묶음$413.40/Awaiting Payment를 확인했다. 수동 생산파일 확인 조건은 유지되며, 결제·생산파일 승인·위험수락·실측은 실행하지 않았다. [전수 조사와 근거](../reviews/document_full_audit_20260922/README.md).

## DEC-051 — 100–500 MHz 교정지그 구조 목표 종료 (2026-09-23)

사용자 요청에 따라 빈 지그 S11을100–500 MHz에서 약−20 dB로 만드는 구조 해법을 소수 비교했다. A04 전체3D, A05 가까운 평판 리턴,10 mm 블록·쐐기 SIG, 이상 외함+바, 기구 한계의28×18 mm 외함+쐐기를 실행했다. 별도 C/L/R 부품은 쓰지 않았다. 모든 후보는400–500 MHz에서 반사가 커졌고,260–300 MHz의 깊은 값은 양쪽 불연속 반사의 위상 상쇄로 판정했다. −20 dB 문턱을 맞추기 위한 추가 치수 반복은 중지한다.

89×69 mm 일정 단면 빈 외함의 계산에서20–26 mm 원형 바는 약69–85 Ω였다. −20 dB에 가까운32–34 mm 바는 공칭26 mm 하우징과 약20 mm 실제 대상을 대표하지 못한다. 얇은 유전체 슬리브도 충분히 낮추지 못했다. A14 CAD 대조에서는 외함 후보가 PCB·LowerCenter·UpperLeft·UpperRight와 교차했다. 기존 하우징에 판만 추가하는 안은 제조 후보가 아니다.

Head A04와 A14/C07은 이번 지그 판정으로 변경하지 않는다. Fixture A03/A04/A05는 재현 가능한 DRAFT 이력으로 보존하되100–500 MHz 절대 교정지그로 승인하지 않는다. 새 Gerber/ZIP을 만들거나 JLC 항목을 교체·결제하지 않는다. 기존 지그는 VNA로 빈 상태와 프로브 장착 상태의 복소 S2P, 위치와 재장착 분산을 측정한 뒤 검증된 범위의 상대 특성화에만 사용한다. 절대100–500 MHz가 필요하면 프로브 설치 상태를 포함한 일정 단면 금속 지그와 더 작은 교정 전용 캐리어를 별도 개발·의뢰한다.

근거: [공학 설명](../reviews/fixture_structural_redesign_20260922/ENGINEERING.md), [판정 JSON](../reviews/fixture_structural_redesign_20260922/FINAL_DECISION.json), [원시 openEMS 폴더](../reviews/fixture_structural_redesign_20260922/em/).

## DEC-052 — Fixture A03 채택, 출력 포트 기준 교정, 케이블 진단 세트 (2026-09-23)

사용자와의 검토 끝에 교정지그 판정 기준을 바꿨다. 목적은 24 V + 100BASE-TX 하네스의 CM 관측과 장애 진단이며, 교정 정확도가 필요한 대역은 1–300 MHz다. 빈 지그 S11 ≤ −20 dB는 교정 정확도의 필요조건이 아니다. 교정은 헤드 장착 through의 출력 S21로 코어 전류를 정하고 전달 S21을 나누는 **출력 포트 기준**으로 한다. 외장 로드 반사와 코어→출구 모델 보정량 K를 포함한다.

저장 openEMS 빈 지그 결과를 읽기 전용으로 다시 환산했다. A03 9개 모델 변형의 K는100/300/500 MHz에서 0.05–0.10/0.41–0.78/0.87–1.65 dB이고, 입력 진행파 기준 오차는 500 MHz에서 약−4 dB였다. A04/A05의 K는 A03와 같은 수준이고 A06 쐐기·외함은2–3 dB로 더 컸다. S11 개선이 교정 개선이 아니었다. 이 결과는 SIMULATED이며 실물 정/역방향 비교로 확인해야 한다.

결정: Fixture A03를 현행 교정지그로 쓴다. 9/22 JLC 묶음에서 빼지 않는다. E04 3개, F13·F14 각4개를 현행 구매 대상으로 되돌린다. A04/A05와 A06 개념은 이력으로 보존하고 제작하지 않는다. 300–500 MHz는 참고 대역이다. 평상시 측정은 감쇠기 없이 맨 프로브를 쓰고 R05 10 dB 1개는 첫 현장 확인·착탈·전원 투입 때 쓴다. 케이블 단품 합/불·진단용 D01–D05(도체별 SMA 분기 어댑터, 기준 접지판, 기준 케이블, 스냅온 페라이트, 굴곡 시험 소모품)를 BOM의 별도 그룹으로 추가한다. D01은 미설계다.

이 결정은 DEC-051의 "현재 지그 제조 후보 없음"과 "기존 지그는 상대 특성화에만" 부분을 대체한다. DEC-051의 S11 수치와 구조 탐색 결과는 그대로 유효한 이력이다. `analysis/rfcp.py`에 출력 기준 모드는 아직 없다. BOM 구매 경로 점검에서 E01 코어와 F01–F24 체결품에 장바구니·견적이 없고, R02 로드7개와 플럭스2개가 공유 카트 밖에 있음을 확인했다. 결제·장바구니 수정·외부 게시는 하지 않았다.

근거: [공학 설명](../reviews/fixture_a03_output_reference_20260923/ENGINEERING.md), [K 재환산](../reviews/fixture_a03_output_reference_20260923/k_factor_results.json), [BOM 구매 경로 점검](../reviews/fixture_a03_output_reference_20260923/BOM_PURCHASE_AUDIT.md), [독립 재검토](../reviews/fixture_second_opinion_20260923/REVIEW.md), [하네스 적합성 검토](../reviews/harness_fitness_20260923/REVIEW.md).

## DEC-053 — A03 단일 기준과500 MHz 보정 수행 확정 (2026-09-23)

사용자는 JLC에서 승인받은 기존 A03을 유지하고 S파라미터로 지그 영향을 보정하며, 500 MHz까지 진행하는 기준으로 문서를 정리하도록 요청했다. Head PCB A04와 Fixture A03를 구분한다.

결정: **Fixture A03 · 출력 포트 기준 · 1–500 MHz 보정**을 현행 기준으로 고정한다. DEC-052의 A03 채택과 ΓL·K 보정은 유지하고, “300–500 MHz 참고 대역”의 일괄 제한은 대체한다. −6 dB는 전력 약1/4·전류 진폭 약1/2이며, 알려진 복소 전달량을 보정하는 것을 막지 않는다. 저장9개 A03 모델에서500 MHz S21은−5.77…−5.00 dB, K는0.873…1.650 dB다. 이 K는 보정량이고 잔여 오차가 아니다.

교정 수행 범위와 실측 성능은 별도다. 실제 부하 조건의 K, 헤드 종단 교환 영향, VNA·로드·재장착·직접 픽업을 주파수별 불확도로 기록한다. 정/역방향 일치는 일관성 검사이며 공통 모델 오차를 독립적으로 증명하지 않는다. 불확도 미평가를0으로 채우거나 실측 없는500 MHz 정확도를 만들지 않는다. Ethernet 지그와 A03은 각각 다른 경로를 교정하며 직렬로 연결하지 않는다.

정리 범위: 현행 상태·백서·벤치·BOM 설명·공개 빌드에서 폐기 후보의 비교표와 그래프를 제거한다. 원시 계산·제조 ZIP·PCB·기구·이전 결정은 재현 근거라 보존한다. 기존 SOLT/네 측정 단계 UI와 조립 동작은 유지한다. 분석 코드의 출력 기준 모드는 여전히 구현 전이며 문서 정리로 구현 완료를 주장하지 않는다.

근거: [정리 및 검증 기록](../reviews/a03_500mhz_cleanup_20260923/README.md), [저장 재환산](../reviews/fixture_a03_output_reference_20260923/k_factor_results.json).

## DEC-054 — 외주 출력의 재료 분리와 비용 절감 (2026-09-23)

사용자는 출력 재료를 용도에 맞게 낮춰 통합 구매비를 약110만원으로 줄이도록 요청했고, 직접 프린터가 없어 외주 출력 기준임을 확인했다. 형상·설치수량을 유지하고 P05–P08·P11·P12·P14·P15(8종11개)를 SLA 9600 Resin White로 변경한다. 코어/PCB 중앙 몸체·탄성 뚜껑·고정바·작은 턱(P01–P04·P09·P10·P13, 7종9개)은 SLS 3201PA-F를 유지한다. 모두 표면마감·나사 가공 없음.

기존 PA 해석·업체 승인을 레진으로 전용하지 않는다. 변경품은 실내 상온 시제품용이고 고온·직사광선·장기하중·실물 맞춤 및 반복성은 미검증이다. 탄성부는 낮은 연신율의 레진으로 바꾸지 않았다. LowerCenter는 레진 견적의 얇은 벽 경고와 정밀 조립 역할을 고려해 나일론으로 유지했다. 위험 수락 체크는 하지 않았다.

JLC RF 묶음 W2026091819397543에 새8종을 추가하고 대응하는 옛8종만 취소했다. 새 레진은 Reviewing, 유지한 나일론7종과 Head A04/Fixture A03는 Approved다. 교체 후 출력비$185.88, PCB$19.20, 배송$10.43으로 총$215.51이며 종전$413.40보다$197.89 감소했다. 테스트 보드 묶음$220.54는 유지한다. 결제·생산승인·CAD 변경은 없다. 이 결정은 과거의 “9/22 출력 재료 묶음 그대로 유지” 지시만 대체하며 DEC-053의 RF 교정 기준을 바꾸지 않는다.

가정환율1,400원/$에서 출력비 약53.7만원→26.0만원, 통합 가격 확인분 소계1,083,616원이다. 코어·미견적 체결품15품번·세금·추가 준비물은 별도여서110만원 총예산 달성으로 보고하지 않는다. [재료별 선택 근거·실제 주문 ID·검증 기록](../procurement/print_costdown_20260923/README.md).

## DEC-055 — 장비 조합 기준 문서 정리: 보유품 진단·5턴 기본·대역별 목표 통일 (2026-09-23)

사용자와 전체 장비 조합(프로브 + Fixture A03 + LibreVNA 2포트 + MSO4054 + 보유 M12→RJ45 어댑터·RJ45→발룬 4 SMA 보드)을 기준으로 이전 문서의 흔적을 함께 검토해 다음을 정했다.

- **BOM:** R07 BNC–SMA 교정 어댑터 삭제(57행). 스코프 체인 응답은 LibreVNA CW 출력 + R06으로 확인한다. R08 현장 입력 보호는 대상 하네스(24 V·100BASE-TX)에서 해당 없음으로 종결. T01/T02에 LibreVNA·MSO4054 보유를 표기.
- **케이블 진단:** D01 도체별 SMA 분기 PCB, D02 접지판, D03 기준 케이블을 삭제하고 보유품(M12→RJ45·발룬 보드, 금속 테이블, 상용/대상 케이블)으로 대체. D05 굴곡 시험은 절차 항목으로 이동. D04 스냅온 페라이트는 현장 진단 A/B용 선택 구매로 둔다. 발룬 보드는 센터탭 0 Ω 기본 미실장이며, 실장한 보드는 통전 금지다.
- **출력 연결:** 기본은 감쇠기 없는 맨 프로브. 새 현장·새 케이블의 첫 측정, 케이블 착탈, 전원 투입 때 R05 10 dB로 최대값을 먼저 확인하도록 강력히 권고한다. 상용전원·VFD·고전압·서지 현장은 Rev.A 범위 밖이다.
- **권선:** 5턴 기본, 3턴 선택(7턴 제외). 권선 직후 헤드 출력 S11로 자기공진을 기록하고, 필요한 대역이 목표에 못 미칠 때만 3턴을 감는다. 턴수마다 교정 ID를 분리한다.
- **대역·오차:** 흩어져 있던 목표(TGT-01/02/06, VAL-05, 백서 T03/T05/14.3)를 백서14.5 표 하나로 통일했다. 0.1–1 / 1–150 / 150–300 MHz는 판정용, 300–500 MHz는 참고용이다. 목표 미달 구간은 버리지 않고 기록하며 참고용으로 표시한다.
- **예산:** REQ-09와 관련 문구(10만 원 목표·20만 원 상한)를 삭제했다. 예산은 사용자가 별도 관리한다. DEC-054의 비용 기록은 바꾸지 않았다.
- **절차 문서:** G2 벤치 절차와 연결 리허설은 초안으로 표시하고, 시험별 문서는 실물 도착 후 작성한다. 지금은 R07/BNC 기준면 경로와 감쇠기 기본 연결처럼 결정과 부딪히는 부분만 고쳤다. 작성할 시험 목록은 G2 8절에 있다.
- **유지:** 백서 F0–F4 현장 진단 조건(회전·주변 설비와 링크 오류의 시간 대조)은 진단 목적에 포함되므로 그대로 둔다.

실측·구매·결제·원격 게시는 하지 않았다. 변경 전 원문과 기록은 [문서 정리 기록](../reviews/doc_cleanup_20260923/README.md)에 있다.

## DEC-056 — 새 전수 검수와 실물 승인 조건 명확화 (2026-09-28)

사용자가 프로젝트를 새로 전수검사해 “이대로 조립 가능한지, 정상동작이 확실한지” 확인하도록 요청했다. 현행 Head A04/A14·C07/Fixture A03, 5턴 기본·3턴 선택, 공칭26 mm, DEC-053 출력 기준1–500 MHz 교정은 변경하지 않는다.

검수 판정: 공칭 조립 경로·현행 파일 재현·ERC/DRC·선정 모델 공차 검사는 통과했으나 실물 조립/정상동작 승인 근거는 아직 없다. 9/28 저장 업체 회신 기록의 레진4종5개 휨 보류를 현재 상태에 반영한다. 제조사 현행 홀 위치±0.075 mm를 넣으면 SMA 중심 핀 반경 여유는0.0189 mm로 감소하고 기존0.03 mm 편심 예산까지의 충분조건은 성립하지 않는다. 이는 실제 삽입 불가 증명이 아니므로 자동 PCB 수정 대신 주문 공차와 첫5핀 삽입/안착 검사로 닫는다.

로드 S11 안내의 SMA 수–수 접속 오류를 현재 G2/END_TO_END에서 수정한다. 별도로 교정된 SMA 암 기준면/맞는 표준 모델을 사용하며 어댑터 추가만으로 기준면 보존을 주장하지 않는다. 공개/로컬 생성 UI 동기화는 미실행으로 남긴다. 출력 기준 수식288합성 검산 통과와 공식 분석 mode 구현은 별개이며 후자는 여전히 미구현이다. 원시 실측/T01–T12가 없으므로 대역·정확도·현장 사용을 승인하지 않는다.

근거: [전수 재검수](../reviews/full_reinspection_20260928/REPORT.md), [인수·벤치 계획](../reviews/full_reinspection_20260928/ACCEPTANCE_PLAN.md), [실행 기록](../reviews/full_reinspection_20260928/execution.json). 현재성/잘못된 연결 지시만 문서에 반영하고 변경 전 사본·기존 해시 기준을 보존한 뒤 새 검토 근거로 문서 계약을 갱신한다. 구매·발송·제조 승인·CAD/PCB/BOM 설치량·분석 제품 코드·외부 배포는 변경하지 않는다.

## DEC-057 — 사용자 요청 SMA 삽입 여유 보완 R2 (2026-09-28)

사용자가 “1번은 그럼 너가 알아서 수정할 수 있음?”이라고 요청하여 SMA 장착부를 수정했다. DEC-056의 자동 수정 보류 이후 명시적 수정 요청에 따른 작업이다. Head A04와 Fixture A03의 외곽·창·고정홀·SMA 위치·5.08 mm 피치·트랙·비아·공칭 두께를 유지하고, 세 커넥터의15개 홀/패드를 중심1.90/2.80 mm, 접지2.10/3.10 mm(홀/패드)로 변경했다. 마스크는 패드1:1, SMA 실크 외곽은 패드 개방부에서 이격했다.

최신 JLC 완성홀 +0.13/−0.08 mm, 각 축 위치±0.075 mm와 GCT Rev1.2 핀 포락을 사용한다. 중심/접지 반경 여유0.1189/0.1261 mm, 추가 핀 편심 배분0.03 mm 후0.0889/0.0961 mm이며 worst-case 동박 링0.2789/0.3289 mm다. 0.03 mm 편심과0.05 mm 잔여 여유 기준은 설계 배분이고 제조사 보증이 아니다. 핀 대칭·직진 가정 및 실제5핀 무응력 삽입·안착·납땜 검사가 남는다.

R2 KiCad 원본·라이브러리·회로도·재생성 코드·Gerber/드릴·STEP을 별도 폴더로 작성했다. 새 ERC/DRC(기본 무시 ERC 포함), 제조 ZIP 재독해, 격리 재생성, 보수적 SMA 유동/회전 포락 조립 경로 검사를 통과했다. 국소 launch 동박이 바뀌므로 기존 빈 지그 K를 R2 실측 또는 R2 RF 검증으로 승격하지 않는다. A03 출력 기준1–500 MHz 교정 및 주파수별 유효성 조건은 유지한다.

기존 제출 PCB/ZIP·15종 출력 STL은 보존했다. 새 R2는 DRAFT — NOT FOR FABRICATION, 업체 미제출이며 결제·생산승인·메일·외부 게시를 실행하지 않았다. 다음 PCB 제출에서 R2 두 ZIP을 별도로 검토한다. 3D 출력 주문/수량을 바꾸지 않는다. 근거: [SMA R2 수정·검증 인계](../reviews/sma_clearance_r2_20260928/REPORT.md).

## DEC-058 — 출력 포트 기준 공식 분석 구현·로드 반사 UI 동기화 (2026-09-28)

사용자는 제작 전 검수의 2·3번을 해결하도록 요청했다. `analysis/rfcp.py`의 `output_reference`와 `scope_tone` 공통 파일 입력을 구현했다. 정/역방향 장착 through·전달 S2P, 별도 암 기준면의 로드 S1P, 복소 K CSV, 주파수별 검토·불확도 CSV를 묶는다. ID·기준면·리비전·해시·단위를 검사하며, 조건을 충족하지 않은 구간의 절대 ZT는 비운다. 300 MHz 일괄 제한·빈 지그 S11 합격 조건을 추가하지 않는다. 실제 K·불확도·측정 근거는 사용자가 확보한 기록이어야 하며 코드가 실물 검토를 대신하지 않는다.

로드 반사 안내는 별도 1포트 SOL을 적용한 VNA SMA 암 포트에 수형 작업용 로드를 직접 연결하는 절차로 통일한다. 수형 SOL 표준의 실제 모델을 확인하고, 기존 케이블 끝 2포트 교정과 파일·ID를 분리한다. RFCP 로컬·공개용 생성 원본, 3D 연결 그림, 별도 A03 지그 페이지를 수정했다. 공개에만 있던 46단계 조립/권선 검사를 로컬 원본에 보존했다.

이 결정은 DEC-052/054/056의 당시 ‘출력 기준 모드 미구현’과 ‘UI 동기화 미실행’ 상태를 후속 대체한다. 기존 판단·계산 원본과 실물 미검증 상태는 유지한다. 154개 소프트웨어 시험 통과는 SYNTHETIC 파일 분석 검증이며 실물 교정 완료가 아니다. [변경·검증·게시 기록](../reviews/output_reference_20260928/REPORT.md), [실행 안내](../analysis/OUTPUT_REFERENCE.md). 구매·결제·제조 제출은 이번 범위가 아니다.

## DEC-059 — A16/C09 축 받침 강도 수정과 출력 교체본 (2026-09-28)

사용자가 A15/C08 제작 검토에서 지적한 축 받침 문제를 고치도록 요청했다. C09는 축 받침 뒤쪽에12 mm 깊이의 연결부를 더해 너트 홈 뒤의 해당 잔존 벽을4→16 mm로 보강한다. 앞쪽 가이드·와셔·너트·스패너 공간과 기존 체결품을 유지한다. 앞/가운데 바닥의0.65/0.50 mm 잔여벽을 정리하고 통과한 A15 뒤 바닥은 그대로 쓴다.

판정은 제작 설계 검토 GO다. 이전과 같은100 N 축 하중·9600 Resin 물성·정적 여유2배 기준을 유지했다. 세밀한 메시에서 축 받침 최대 인장 주응력68.4→20.2 MPa, 최대 변위0.978→0.474 mm, 전형 인장강도 대비 여유2.73배다. 개방 방향100 N·가이드50 N·벌림각50 N과 바닥100 N도 검사했다. 실제 새 해석4작업10경우, 뒤집힌 요소0, 반력 평형 통과. 독립 재생성125개 형상차0/15종 STL 바이트 동일, 정적·가동·탈착·공구·인터페이스 검사 통과.

A15 대비 새 출력3종4개이며, 기존 제출 A14 대비 교체4종5개다. 전체15종20개와 재료 구분·체결품 수는 유지한다. 별도 A16/C09 원본·STL·교체 ZIP을 만들고 기존 A14/A15 및 업체 주문을 보존한다. 다음 제조 인계에는 PCB SMA R2와 출력 A16/C09 묶음을 함께 지정한다. 이 결정은 기구 제작 설계 판단이며 실제 RF 교정 완료나 업체 CAM/생산승인을 뜻하지 않는다. 원시 해석·수량·해시·제한은 [수정 및 제조 인계](../reviews/a16_strength_fix_20260928/REPORT.md)에 보존한다.

## DEC-060 — R2+A16 통합 재검수와 제조 인계 일원화 (2026-09-28)

사용자가 조립 가능성과 정상동작 여부의 새로운 전수검사를 요청했다. 시작 안내의 A14/C07과 후속 DEC-059 A16/C09가 일부 진입 문서에서 혼용된 것을 확인했다. 다음 제작 검토본은 **Head A04 SMA R2 + Fixture A03 SMA R2 + A16/C09**로 명시하고 기존 접수본/중간 A15와 분리한다. PCB·출력 제조 원본과 업체 주문을 수정하지 않는다.

R2 ERC/DRC·엄격 ERC·실제 ZIP 재독해·격리 재생성을 재실행했다. A16도 저장 CAD·조립/공구/권선·R2 포락 경로·15종 출력/재생성 및 구조 해석을 새로 검사했다. 공식154개 소프트웨어 시험과 독립 수동3포트 회로 합성 검산을 실행했다. 자세한 범위·원시 결과·해석 한계는 [새 전수검수](../reviews/fresh_system_audit_20260928/REPORT.md)에 있다.

판정: 지정 최신 묶음으로 시제품을 조립할 설계 근거는 있다. 실제 조립품의 정상동작·정량 정확도·유효 대역을 확정할 MEASURED 자료는 없다. T01–T12와 기존 미검증 상태를 유지한다. 정/역방향 일치는 공통 K 오류의 독립 검증이 아니며, 계산100 N 구조 하중은 체결 토크·실제 조작력·크리프 정격이 아니다. 기존 제작 설계 GO의 범위를 넓히지 않는다.

README의 구형 접수 묶음 그대로 결제 안내, G3/설치 BOM의 구형 제조 파일 선택,45/46단계와 UI 동기화 상태를 정리했다. 이전 파일·문서·해시 기준을 보존하고 검토한 문서 변경만 기준에 반영한다. R2/A16 제조 의존성을 포함하는 별도 현재 구성 검사도 추가한다. 구매·제조 업로드·결제·외부 발송·공개 배포는 수행하지 않았다.

## DEC-061 — 3D 제작 형상·재질·파일 선택 확정 (2026-09-28)

사용자가 3D 문서를 일관되게 정리하고 실제 제출본을 확정하되, 전체 고가 재질 선택으로 약50만원대 출력비가 재발하지 않도록 요청했다. **A16/C09 형상을 유지하고,9600 Resin8종11개 + 3201PA-F Nylon7종9개**로 재료를 확정한다. 기존 검증 STL15종 바이트 동일, 전체15종20개, 추가 체결품0개다. 기존 주문에서는P05/P06/P14/P15만4종5개 교체하며 모두9600이다. P15의 A15 파일명과 나머지 A14/C07 파일명은 채택한 형상 이름으로 유지한다.

단일 제조 선택 기준은 [3D 최종 제작 기준](3D_PRINT_RELEASE_A16_C09.md)이다. 기존 주문 교체ZIP과 전체 재견적ZIP을 구분하고 전체 묶음은 재질별 폴더로 나눈다. 기능상 탄성이 필요한 뚜껑, 레진 박벽 경고가 있었던 중앙 몸체, 저가의 작은 반복 접촉 부품은 나일론을 유지한다. 바닥/프레임은9600 물성 해석을 통과한 형상을 그대로 사용한다. 일반 납기, 표면마감/나사 가공 없음, mm/100%다. 일괄 고급 재료 상향 대신 업체가 특정한 문제 부위만 최소 비용 대안과 차액을 검토한다.

기존 A14 동일수량 실견적은 전체 나일론$383.77, 재료 분리$185.88로$197.89(51.56%) 절감됐다. 이는 A16 최종 가격이 아니다. 변경 없는11종 기존$90.70에 새4행(프레임2개 포함) 견적을 더하고 배송·세금·PCB를 별도 구분한다. 원본 형상/재료 변경이나 업체 업로드·발송·주문·결제를 수행하지 않았다. 이번 확정은3D 제작 설계/재질/인계에 한하며 RF 성능 판정과 업체 제조심사를 확대 승인하지 않는다. [변경·검증 기록](../reviews/3d_release_consistency_20260928/REPORT.md).

### DEC-060 추가 세밀화 결과

기존3 mm 가이드25.621 MPa의 여유와 메시 민감성을 확인하려고2 mm로 추가 해석했다. 같은 좌우50 N 벌림 하중에서29.901 MPa로27.5 MPa 기준을 초과하고 최대응력도 수렴하지 않았다. 전체 강도 GO를 유지하지 않고 C09 가이드 보강 또는 실제 필렛·접촉·하중 근거를 갖춘 모델 재검토 후 같은 기준으로 재판정한다. 초기11경우 및 PCB/기구 통과 근거는 그대로 보존한다. 새1경우를 포함한 완료 솔버6작업12경우, 실제 힘·모멘트 평형 검산을 기록했다. 제조 원본은 수정하지 않았다.

## DEC-062 — 현행 PCB 기능·제조 전수 재검토와 회로도 조립 문구 정정 (2026-09-28)

사용자가 기존 문서를 사실로 전제하지 않는 PCB 전수검사를 요청했다. Head A04 SMA R2 / Fixture A03 SMA R2의 회로도·원본·실제 제조 ZIP을 새로 읽고, 전기 패드17개·비아51개·기구홀6개·양면 동박·드릴·외곽/창 가공선과 설명34항목을 대조했다. ERC/DRC, 이름표에 의존하지 않는 동박 연결 복원, A16 장착181자세·SMA 포락·단락 턴 검사, 관련44개 소프트웨어 시험과 독립 RF 계산을 실행했다.

현행 지그 회로도의30+35 mm 별도 나일론 기둥 지시는 A16 BaseCenter 일체형 받침과 충돌한다. 저장 CAD의 네 받침을 직접 확인하고 회로도1문장과 해당 builder의 재생성 문구만 정정했다. 구형 baseline/접수본, 두 PCB·Gerber/드릴 ZIP,3D·재질·수량은 변경하지 않는다. 별도 재생성에서 두 PCB/회로도/프로젝트가 바이트 일치했고 문구 수정 후 ERC/DRC도 통과했다.

새 PCB 배선/제조 결함은 발견하지 못했다. 이는 실물 정상동작이나500 MHz 정확도의 확정이 아니다. R2 실제 launch·권선 공진·납땜·헤드 부하 교환·K 적용성·직접 픽업의 불확도는 실측으로 확인한다. 1–500 MHz 출력 기준 교정과 백서14.5 목표, T01–T12 NOT_VERIFIED 상태를 유지한다. 상세 판정·원시 계산·명령·원본 보존은 [PCB 전수검토](../reviews/pcb_function_audit_20260928/REPORT.md)에 있다. 업체 제출·구매·생산승인·외부 배포는 이번 검토에 포함하지 않는다.

## DEC-063 — 작은 가이드 보강으로 기존 강도 기준 유지 (2026-09-28)

사용자는 큰 변경이면 기존 형상 수용을 검토하되 작은 수정이면 기존 기준을 맞추도록 요청했다. 이전 A16/C09 동결은 보존 원본에 유지하고 별도 A17/C10에서 P06 프레임 한 종류 두 개를 국부 수정한다. 안쪽 두 가이드 뒤의5 mm 받침을13×12.5 mm 연장하고 외측 뿌리에R2.5, 반대쪽과 양끝에R0.75를 연속으로 넣었다. 통로 안의 작은 라운드는Z17.75까지이며 기존 가동면은Z18부터 유지된다. 프레임 부피+0.78%, 추가 체결품0, 다른14종 STEP/STL·재질·총15종20개는 그대로다.

기존50 N씩 벌림, 합계50 N 가이드 축방향, 정/역100 N 축 하중과9600 Resin 전형55 MPa/여유2배 기준을 유지했다. 채택안3작업6하중 결과의 최대 인장 주응력24.084 MPa로27.5 MPa 기준 안에 있다. 전역3/4 mm와 실제 위험 곡선/곡면0.35/0.25 mm 국부 세밀도의 완료 결과를 비교하며, 최종 안에 전역2 mm 시험을 했다고 표현하지 않는다. 형상 유효성·기존123개 형상·정적/가동/탈착/공구·보호 인터페이스와125개 재생성/15종 STL 동일 검사를 통과했다. 실패한 첫 안, 비채택 중간 안과 중단/검산 미달 해법도 보존한다. 원시 계산과 민감성 한계는 [보고서](../reviews/c10_guide_fix_20260928/REPORT.md)를 따른다.

다음 제작 검토 조합은 PCB SMA R2 + A17/C10이며, [별도 파일 인계](3D_PRINT_RELEASE_A17_C10.md)를 우선한다. 기존 A16 대비1종2개, 기존 업체 접수 A14 대비4종5개 교체다. 원래 C09의HOLD를 소급해 지우지 않고 후속 C10의 구조 선별 검사로 해결한다. 실물/강도 정격/크리프/토크/RF 미검증을 유지한다. 비용이 큰 재료 상향·업체 업로드·결제·생산승인은 하지 않는다.

## DEC-064 — 수동 조립품의 대체 선정과 구매요청 통합 (2026-09-28)

사용자는 실내에서 사람이 손으로 돌리는 용도에 맞춰 남은 구매품을 확정하도록 요청했다. 특정 제조사·4.8/A2-70 등급을 고집한 조달 보류를 해제하고, M4×70 RS PRO175-6980(4.6), M6×120 Accu HTB-M6-120-A2를 선정한다. 나사 축력·비틀림 민감도 계산은 저하중 시제품 선정 근거이며 프레임·케이블·제품 전체 하중 정격이 아니다. A2 로트의 강도 인증을 받았다고 주장하지 않는다.

손나사 CRKW4-20 10개, M6 노브 NCRF6 2개, 어깨볼트 ISO7379-5-M4-20-NI 4개, 관통 노브 NKMS4 2개, 황동 와셔 RS483-2621 한 포장250개, PA66 날개너트 FIX-SMO-3 한 포장100개로 남은8행을 마무리했다. RS M4 스터드는 한 포장25개, M6 스터드는2개 주문이다. 설치량과 판매포장을 구분한다. 저장 A17에 교체 손나사/날개너트 형상을 넣은21자세·삽입44위치 간섭 검사가 통과했다. CAD/STL/제조ZIP은 바이트 보존하며 기존 조립 치수/설치 수량은 유지한다.

기존 선정30행과 합쳐38행의 판매품·수량·상품가격을 [통합 구매요청](../outputs/payment-audit-20260928/구매요청_선정완료_20260928.md)에 정리한다. 원화653,227원+$496.44+£40.93, USD1,400원/GBP1,900원 가정으로1,426,010원이다. 일부 금액은 참고가격/가정 운임이며 세금·추가운임·변동 여유223,990원을 분리한165만원은 예산안이다. 최종 결제 견적이나 전체 사업비가 아니다. PCB SMA R2 재견적·JLC 출력4종 심사, 별도 보유준비17행의 신규 비용, 실물/RF 미검증은 그대로다. 구매·결제·외부 발송은 실행하지 않았다. [선정·계산·검증 근거](../reviews/fastener_selection_20260928/REPORT.md).

## DEC-065 — PCB 예비 수량 유지와 국내 소량 체결품 대체 (2026-09-28)

사용자는120만원대 절감을 요청한 뒤 발룬·SMA·RJ45 PCB 부품 여분을 줄이지 말고 고가 운임·과다 포장품의 대체품을 찾도록 지시했다. 기존 나사봉의 특정 브랜드·강도등급을 구매 선행조건으로 재설정하지 않는다.

F05/F15는 손잡이닷컴 판매자 절단 M4×0.7×70 도금품2개/M6×1.0×120 SUS304 2개로 대체, 상품9,280원+배송3,000원이다. 권선은 UEW0.3mm95g 소량품7,000원+배송3,000원으로 같은 종류·굵기를 유지한다. 발룬 ADT2-1T+는 동일품번10개를 Mouser 한국 판매92,040원/무료배송으로 선정한다. PCB용 SMA10·RJ45 8·Molex5·프로브 SMA4·플럭스2도 모두 유지한다.

사용자는 필요한 수량을 제시한 확인 질문에 M4/M6 일반 육각너트·평와셔와 안쪽 파란색 링이 있는 M6 풀림방지너트를 보유한다고 회신했다. 이에 F10/F11+F17/F16/F23은 필요량2/4/2/2개를 보유품 사용으로 잡고 신규구매0으로 변경한다. 이는 실사 수량·재질·치수 측정 기록이 아니다. M6 평와셔 외경·두께와 너트 체결 상태는 조립 전에 확인한다. 보유 M4×20/M6×30 볼트는 필요한70/120mm 나사봉을 대신하기에 짧다. 사각와셔는 없으며 M4 사각너트16개/M6 사각너트2개 및 별도 PA66 M4 와셔22개의 구매는 유지한다.

보유품 부족/부적합 시 대체용으로 국내 황동 M6 평와셔5개500원+배송3,200원, 굿나잇몰 M6/M4 육각너트 각2개260원·M6 풀림방지너트2개260원+배송3,500원 근거를 보존한다. 이4행과 배송은 현재 합계에서7,720원 제외했다. 황동 공급 도면ID6.5/OD12.5/t1.2 또는1.5mm는 원 CAD 공칭ID6.4/OD12/t1.6와 다르다. 너트/노브 위치 조절 및 M6 노브 삽입10mm 조건, 판매자 나사봉 길이 편차±2mm를 저장 A17에 적용해84경우 추가 간섭0을 확인했다. 소형 M4 육각너트H3.0도 원H3.2 포락 내에 있다. 치수 미확인 보유 와셔까지 검증했다는 뜻은 아니다. PCB·3D·출력15종20개·제조ZIP은 그대로다. 실물 마찰·마감·RF 검증은 별도다.

상품·표시배송·MISUMI VAT 합계1,224,513원은 이전 동일 기준보다201,497원 낮다. 수입 부가세 예산114,072원·미확정 국내배송3,500원·기타 관세/통관/카드/변동 여유30,000원을 더하면1,372,085원이며 **120만원대 최종 도착가 달성을 확정하지 않는다**. JLC$438.50/USD1,400원 및 R2/출력심사 최종 증감 미확정 기준이다. 과거165만원 XLSX와 선정 기록은 보존하고 [최신 대체·보유품 반영표](../outputs/payment-audit-20260928/구매절감_재고확인_20260928.md)를 우선한다. [가격·독립 외형검사·한계](../reviews/budget_120_20260928/REPORT.md). 구매·결제·외부 문의는 실행하지 않았다.

## DEC-066 — 일반 육각렌치 볼트 사용, 노브와 전용 나사봉 제거 (2026-09-28)

사용자는70/120mm 나사봉을 고집하지 말고 육각렌치로 돌리는 평범한 볼트를 쓰도록 지시했다. F05를 일반 SUS304 유두 렌치볼트 M4×0.7×60 2개, F15를 M6×1.0×100 2개로 변경한다. 노브를 제거하면 머리가 와셔에 바로 닿아 머리 아래60/100mm로 충분하다. 굿나잇몰 상품82의 전산 도면, M4 머리Ø7×4·3mm 렌치, M6 머리Ø10×6·5mm 렌치 및 실제 옵션 가격260/1,570원을 확인했다. 각2개 상품3,660원+배송3,500원=7,160원이며 특주/절단/강도성적서 조건을 붙이지 않는다.

F08/F22 노브 각2개 및 F16/F23 잼너트 각2개는 불필요해져 필요량/구매량0이다. 사용자 보유 일반 육각너트는 이 위치에서 쓰지 않는다. M6 하부 풀림방지너트2개와 평와셔4개는 보유품을 쓰고 치수·상태를 조립 전에 확인한다. 사각너트18개, PA66 M4 와셔22개, 별도 모듈 손나사F06/팔로워 어깨나사F12와 전자부품 예비는 유지한다. 보유 M4×20/M6×30 볼트는 새 길이에도 짧다.

FreeCAD1.0.2로 케이블 직경6–26mm의21자세×M6 와셔3조건=63경우 추가 간섭0·직선 렌치 접근 간섭0을 확인했다. M6 구동 사각너트5mm 전체 체결과 최소 끝 여유10.9mm, M4 사각너트3.2mm 전체 체결과 끝 여유9.6mm가 남는다. 원본 A17 CAD SHA256을 보존하고 노브 제거/표준볼트를 넣은 별도 조립 참고 CAD를 저장했다. 출력물15종20개와 PCB/STL/제조ZIP 변경은 없다. 보존 CAD/뷰어에 남은 노브/나사봉은 이전 조립 방식이며 이번 구매 변경표를 우선한다. 실물/RF 검증은 아니다.

상품·배송 합계1,200,194원, 세금·변동 예산 포함1,347,766원이다. 이전 상품·배송 기준1,426,010원 대비225,816원 절감, 보유 반영 국내 절단품안1,224,513원 대비24,319원 절감이다. MISUMI는F06만 남아 VAT1,001원으로 재계산했다. 수입 VAT114,072원·미확정 국내운임3,500원·기타30,000원은 예산 가정이며120만원대 도착가를 달성했다고 판정하지 않는다. JLC$438.50/USD1,400원, R2/출력심사 최종 증감 및 별도 준비17행 비용 한계는 유지한다. [최신 구매표](../outputs/payment-audit-20260928/구매절감_재고확인_20260928.md), [가격·검증·조립 참고 파일](../reviews/budget_120_20260928/REPORT.md). 구매·결제·외부 문의는 하지 않았다.

## DEC-067 — 동네 볼트상점 조달 우선, 배송 포함 총액으로 비교 (2026-09-28)

사용자는 일반 볼트와 사각너트를 동네 볼트상점에서 사도 되며, 값싼 부품에 고액 배송을 붙이지 말고 무료배송 또는 더 저렴한 총액을 기준으로 고르도록 지시했다. F05/F15 일반 렌치볼트 각2개, F07/F09 DIN557 사각너트16개/2개는 현지 조달을 기본으로 한다. 특정 제조사·온라인 포장20개/10개를 강요하지 않는다. 어깨볼트F12 4개와 PA66 M3 날개너트F14 4개도 동일 치수의 현지/국내 재고를 우선 확인한다. 이 두 품목의 상점 취급을 단정하거나 일반 볼트/금속 너트로 임의 대체하지 않는다. 온라인은 무료/합배송 또는 배송 포함 총액이 더 낮을 때만 선정하며 무료배송을 위한 불필요한 수량 추가는 하지 않는다.

사각너트는 DIN557 표준품으로 CLC 제조사 자료에서 M4P0.7 폭6.8–7.0/두께2.9–3.2mm, M6P1.0 폭9.64–10.0/두께4.52–5.0mm를 확인했다. 프로젝트 기준 공칭7×7×3.2/10×10×5mm를 상점 메모에 적는다. 매장 재고·실물 치수는 미확인이며 표준 공차 전체를 새로 검증했다고 주장하지 않는다.

기본 구매표에서 굿나잇몰배송3,500원·쉬멕스 배송가정3,500원·TME$21.90을 제거하고 현지6품목 가격을null(미견적)로 분리한다. 가격을0원으로 처리하지 않는다. 잔여 상품·배송 소계1,105,318원, 잔여 수입VAT 예산105,961원·기타 여유30,000원을 포함한 소계1,241,279원에 현지6품목 실제 구매액을 더한다. 전체 총액/120만원대 목표 달성은 아직 확정하지 않는다. 기존 온라인 견적은 비교 이력으로 보존한다.

조달 경로만 바꾸며 DEC-066 일반 렌치볼트 구성,63경우 검증 결과, 출력·PCB 원본과 전자부품 예비 수량을 유지한다. 구매·결제·매장 문의는 실행하지 않았다. [현행 구매표](../outputs/payment-audit-20260928/구매절감_재고확인_20260928.md), [상점용 메모](../outputs/payment-audit-20260928/동네볼트상점_구매메모_20260928.md), [변경 근거](../reviews/local_fasteners_20260928/REPORT.md).

## DEC-068 — 국내 일반 렌치볼트·사각너트 구매 반영 (2026-09-28)

사용자는 국내 판매가를 확인한 뒤 볼트와 너트를 구매하기로 했다. 직전 대화의 F05/F15 일반 전나사 유두 렌치볼트 M4×60/M6×100 각2개와 F07/F09 사각너트 구매를 반영한다. 이미 보유한 M6 풀림방지너트·평와셔의 중복 구매, 제거한 노브/잼너트의 복원 또는 어깨볼트의 임의 대체로 해석하지 않는다.

굿나잇몰 M4×60 260원×2, M6×100 1,570원×2, 상품3,660원·배송3,500원. 쉬멕스19501-55704 M4 20개 포장3,630원 및19501-55706 M6 10개 포장2,970원(VAT포함), 설치16개/2개. 상품 합계10,260원이다. 판매 페이지 옵션을 다시 조회했으며 쉬멕스 배송비는 확인되지 않아0원이나3,500원으로 확정하지 않는다.

이전 소계1,241,279원에 상품10,260원·볼트배송3,500원을 더한 예산 소계1,255,039원에 F12 어깨볼트4개·F14 PA66 M3 날개너트4개 및 사각너트 배송비를 추가해야 한다. 전체 금액이 확정되었다고 주장하지 않는다. 이 두 잔여 품목은 국내 조달을 우선하며 해외 고액 운임으로 자동 전환하지 않는다.

DEC-066의 일반볼트 조립과 기존 사각너트 선정품을 유지하므로 제작 형상·PCB·출력물·검증 모델은 변경하지 않는다. 해외 나사봉/대포장 너트·와셔/별도 노브와 운임이 이전 비용을 키웠으며 고강도 특수볼트가 필수였던 것은 아니다. 별도 어깨볼트는 매끈한 축의 기능이 필요하므로 구분한다. 구매표 반영이며 실제 주문·결제·외부 문의는 하지 않았다. [검토 기록](../reviews/domestic_fasteners_20260928/REPORT.md).

## DEC-069 — 일반 M3 나일론 육각너트로 통합, 어깨볼트 조달 미해결 명시 (2026-09-28)

사용자는 날개너트를 일반 너트로 바꾸는 방향과 어깨볼트의 기능 유지를 받아들이고, 기존 국내 판매처에서 어깨볼트까지 살 수 있는지 확인하도록 요청했다. F14는 F04와 같은 Essentra04M030050HNDIN34814 M3×0.5 PA66 육각너트로 변경한다. F04 설치4/F14 설치4/예비2를 한 품번10개2,333원에 합산한다. 기존 F04 5개1,268원 대비 상품1,065원 증가, 별도 날개너트 및 배송처 없음. F14 구매0/금액0은 F04에서4개 배정한다는 뜻이며 불필요 또는 무료가 아니다.

저장 A17 일반볼트 조립본에서 AF5.5/H2.4 너트4자리의 간섭0, 나사 체결2.4mm/끝여유2.8mm를 확인했다. 두께3mm·헤드폭12mm·입구5.7mm로 정의한 합성 스패너 및 옆삽입64위치 간섭0. 기존 홈은 작은 육각너트의 회전을 막지 못하므로 옆에서 얇은5.5mm 스패너로 잡아 체결한다. 실제 공구 치수·실물 조립·RF 검증은 아니며, 출력 형상은 바꾸지 않는다. 금속 너트로 재질까지 바꾼다는 뜻은 아니다.

F12는 A2/SUS304 어깨Ø5×20/M4나사8/머리Ø9×4 네 개를 유지한다. 굿나잇몰 숄더/단붙/어깨/스트리퍼 내부검색0, 쉬멕스 공개 스트리퍼10상품은 Ø6.5/M5부터여서 동일 규격을 확인하지 못했다. 만년볼트의 Ø5/M4 포함 범위표는 견적 후보일 뿐 정확 L20 재고·가격 확정이 아니다. 동네 상점에서 쉽게 구할 수 있다고 전제하지 않고 국내 조달 미해결로 기록한다. 스페이서를 쓰는 가상 대체안은 미채택이며 해외 고액 운임으로 자동 복원하지 않는다.

상품·확인배송 소계1,120,143원, 수입VAT 예산106,067원·기타30,000원 포함1,256,210원에 F12 실제금액과 쉬멕스 배송을 추가해야 한다. 기존 전자부품 예비·출력15종20개·PCB/제조ZIP은 유지하며 구매·결제·외부 문의는 실행하지 않았다. [검토 기록](../reviews/ordinary_hardware_review_20260928/REPORT.md).

## DEC-070 — 업체 얇은 벽 지적에 따른 A18 베이스 수정 (2026-09-28)

사용자는 재접수 베이스 3종의 0.38/0.46/0.60 mm 경고를 확인하고 확실히 수정하도록 요청했다. 기존 A17/C10과 업체 제출 파일은 보존하고, 별도 A18/C10에서 P05/P14/P15 3종 3개를 수정한다. 같은 생성 경계에서 생긴 급각 끝 21곳을 제거/병합하고 좁은 연결부 5곳을 보완했다. 표면 검사에서 짧은 chord를 단순 모서리 효과로 면제하지 않는다.

최종 394,864개 표면 법선 검사에서 2 mm 미만 0, STL 닫힘/단일 성분, 보호 구역 39개 동일, 정적 369쌍·조립/공구 633자세·가동 63경우 무간섭, 125개 형상/15종 STL 재생성 및 ZIP 역독해를 통과했다. 기존 100 N·9600 E2600 MPa·27.5 MPa 기준으로 변경 베이스 3종을 4/3 mm 메시에서 재계산하여 최대 8.321 MPa였다. 지지 경계의 최대 응력은 메시 민감성이 남으므로 수렴된 파손하중으로 표현하지 않는다. 유한 두께 표본과 공칭 CAD/선형 해석이며 실물이나 업체 공정 보증이 아니다.

C10을 포함한 나머지 12종 STEP/STL, 전체 15종 20개, 9600 Resin 8종 11개 + 3201PA-F Nylon 7종 9개 및 PCB SMA R2를 유지한다. 일반 렌치볼트와 M3 나일론 육각너트 등 후속 체결품 결정도 유지한다. 재질 상향·추가 체결품·RF 수식 변경은 없다. 현재 업체에는 A17/C10이 남아 있으며 A18 베이스는 미제출이다. 위험 수락·회신·결제·생산승인을 하지 않았다. PCB R2 제출, 업체 휨/공정 검토와 실물 T01–T12는 남는다. [수정·실행 검증](../reviews/base_dfm_fix_20260928/REPORT.md), [현재 파일 선택](3D_PRINT_RELEASE_A18_C10.md).

## DEC-071 — 코어 판매단위·저가 어깨볼트·사각너트 배송 및 실제 쿠폰 확인 (2026-09-28)

사용자는 미확정 조달 항목을 goal로 끝내고, 볼트류2만원 이하에서 충분히 가격 비교하며, 사각너트 배송1만원 이하와 기존 발룬/SMA/RJ45 예비 수량 유지를 요청했다. F12는 한운상사(쿠팡) LIXIU WJ1084E 정확옵션 `08 d5x M4 (5pcs) × 16 20mm` 5개팩7,130원 무료배송으로 채택한다. 어깨Ø5×20/M4P0.7 나사8/머리Ø9×3.5/렌치3mm. 판매자304 표기와 실제 CAD4자리×21위치 추가간섭0·너트 물림 계산을 근거로 출력 형상은 유지한다. 기존 머리H4 CAD는 보수 포락이며 새 실제품 머리H3.5와 구분한다. 일반 설명pack50보다 정확 선택옵션5pcs를 따른다. 설치4+예비1, 해외배송10/14예정은 조회 당시 표시다. KIPP/Ganter/Norelem/다른5·10개팩/저가M3제품 및 국내 매장 비교를 기록했다.

F07/F09는 쉬멕스20개팩/10개팩을 유지하며 실제 장바구니에서 상품6,000+VAT600+합배송3,300=9,900원을 확인했다. 나비엠알오 대응팩55/24개 합계11,638원보다1,738원 저렴하다. M4×60/M6×100 각2개 상품·배송7,160원과 F12를 합하면14,290원이다. 사각너트까지24,190원이며 각 구성·배송을 혼동하지 않는다.

Fair-Rite2644181281은 주문1개=물리 반쪽1개, 주문2개=맞물리는 한쌍으로 조달을 종결한다. 제조사 구판 Split Round 계열의 pieces 판매 원칙, 현행 정확품 반쪽도면·63g, DigiKey Bulk 판매와 실제수량2입력을 연결한 판단이다. 구판에 정확품 행이 있거나 DigiKey가half라고 직접 답했다고 주장하지 않는다. 현재 재고237,2개26,590원. 표준포장22는MOQ아님. Mouser ADT2-1T+ 실제 재고44, CutTape10개92,040원·무료배송을 확인해 예비수량을 그대로 유지한다.

JLC쿠폰15달러Nylon과5달러PCB를 실제수령했다. VNA결제직전5달러 할인 및 카드수수료0, 운임9.82,합계215.62달러를 확인했다. Nylon은3201PA-F 상품70.46달러로50달러 조건을 충족하나 RF묶음심사 중으로 실제적용 전이다. 주문당1개조건을 지키며 재료변경/추가구매로 할인조건을 맞추지 않는다. 제조심사·보유준비물·실물RF시험은 이 조달종결과 구별한다. 결제·생산승인은 하지 않았다. [정확 근거·선택·비용](../reviews/procurement_closure_20260928/REPORT.md).

DEC-071 후속 실제 접수: RF SMA R2 Y23/Y24 및 VNA B-LM1/B-RF3/B-TE3 Y25/Y26/Y27을 각5장으로 접수하고 기존Y21/Y22/Y15/Y16/Y17만 교체 사유 취소했다. 공통발룬Y18은 유지. 최신5종Reviewing, 수동CAM확인/자동확인해제, 결제·생산승인 없음. RF218.13+VNA224.82=442.95달러. VNA재견적3종 각54.02로 총4.20달러 증가. 예산1,273,493원, PCB5달러쿠폰 재적용 시1,265,793원, 추가나일론15달러 적용 시1,242,693원(환율1,400/VAT10%가정·준비물별도). [파일·옵션·새ID](../reviews/procurement_closure_20260928/pcb_submissions.json).

## DEC-072 — JLC 공식 임피던스 양식 및 RF 제조 비고 보완 (2026-09-29)

**9/29 업체 심사 보완(DEC-072):** VNA 공식 임피던스 양식 누락을 보완해 Molex Y25→Y28, LLC Y26→Y29로 재접수했다(Reviewing, 각5장/$54.02). Y27은 완성 양식·ZIP을 담당자에게 회신하고 반영을 기다린다. RF Y23/Y24의 SMA 치수·제조 비고 설명도 회신했다. A18 앞/뒤 베이스는 Approved, 중앙은 Reviewing이다. 형상·배선·수량·가격은 그대로이며 두 주문 합계442.95달러(쿠폰 전)다. 수동 CAM 검토·결제·생산승인·실물/RF 검증은 남아 있다. 앞베이스 자동 경고의 상세 위치/휨 보증을 업체 승인 표시만으로 입증하지 않는다. [보완 근거·파일·현재 상태](../reviews/jlc_impedance_resubmission_20260929/REPORT.md). 아래 이전 날짜의 접수번호·상태는 당시 이력이다.

추가한 공식 XLSX3개는 실제 CAD6개 pair 위치/층/선폭/간격을 사용한다. 33개 CAM 바이트와 원본 PCB 해시는 동일하며 가격과 보호 예비품도 유지한다. Y27은 메일 제출과 사이트 파일 반영을 구별한다. RF 비고를 일괄 무시하라는 요청에는 동의하지 않고 현재 파일을 설명하는 비고임을 명시했다. 사용자 요청의 업체 제작 검토 범위에서 보완 회신했으며 결제/생산/위험 수락은 없다.

## DEC-073 — 구매 인계 방식 확정 및 M12 지지부 필수조건 정정 (2026-09-29)

LLC용 수 M12 MB12MBAFF08ST-3 1개는 사용자 보유 확정이다. 기존품을 쓰며 신규구매0개, 다시 회수/보유 미확정으로 처리하지 않는다. 신규 구매 TE 암2개와 구분한다.

사용자는 사이트를 본인 전용으로 유지하고 구매팀에는 HTML을 첨부하기로 했다. 공개/초대 설정은 남은 승인 사항이 아니다. 발송안내에서 미확정 공유 선택지를 제거했다. 구매팀 메일의 HTML 첨부 방식 및 짧은 JLC 인보이스 후속 전달 문구를 유지한다.

사용자는 M12를 별도 지지부 없이 8핀 납땜해 사용해 왔으며 해당 고정부를 요구한 검토에 이의를 제기했다. 제조사 패널 장착 도면이 있다는 사실을 이번 벤치용 보드의 별도 패널 필수조건으로 확장했던 판단을 정정한다. TB-MECH는 추가 설계·구매 필요 항목에서 제외한다. 원본 PCB/커넥터/배선/3D 출력15종20개/구매31행/예비 수량은 유지한다. 납땜 높이·핀 배열 대조와 강도 시험은 구별하며 새 토크/피로 실험을 수행했다고 주장하지 않는다.

업체 주문 화면을 다시 확인한 결과 Y23/Y24/Y27/Y28/Y29와 A18 중앙은 Reviewing이다. Y28/Y29는 금일08:56경 파일 교체 이벤트로 재심사 중이며 VNA 총224.82달러, RF218.13달러다. 이번 후속에서는 추가 회신·결제·생산승인을 하지 않았다. [관측·변경·한계](../reviews/remaining_items_closure_20260929/REPORT.md).

## DEC-074 — 사용자 제공 RJ45 제조사 도면으로 직접 대조 종결 (2026-09-29)

사용자가 제공한 `C:/Users/artzy/Downloads/rje591885x01.pdf`를 직접 렌더링해 판독했다. Amphenol `P-RJE59-188-5X01` Rev C에서 X=4와 구매 `RJE591885401`의 일치를 확인했다. 실제 native PCB4종을 새로 읽어 신호Ø0.90/고정돌기Ø3.25/실드Ø1.60 mm, 각 핀 번호와 좌표, 몸체 공칭외곽을 비교했다. 총48홀 위치 차이는 부동소수점 계산 수준이며 모두 PASS다. 원본 PCB 해시는 읽기 전후 동일하다. 실장6개+예비2개 구매 유지, 설계/가격/업체 제출 변경은 없다. 이전 접근 제한에 따른 RJ45 판독 미완료를 해소한다. 가공 실물 공차·RF 성능을 측정한 것은 아니다. [원문 식별·새 검사](../reviews/rj45_drawing_closure_20260929/REPORT.md).

**DEC-074 정정: 초기 PASS 철회.** 첫 직접대조는 도면의 y만 뒤집는 반사변환을 사용했다. 실제로는 component-side 원도면을180도 회전해야 하며 x도 뒤집어야 한다. 재검사에서 신호32홀 위치 불일치를 확인했다. 원문·그림·실패결과는 RJ45 감사 폴더에 보존한다. 현행 F면 실장은 HOLD, 수정 후보 검증 전 제조/조립 승인하지 않는다.

## DEC-075 — RJ45를 포함한 모든 커넥터 앞면 유지 및 VNA 4종 재배선 (2026-09-29)

사용자는 질문에 **모두 앞면 장착 유지 — PCB 4종 배선 수정**을 선택했다. 뒷면 RJ45 대안은 채택하지 않는다. 기존 접수 PCB4종은 교체가 필요하며, 검증 전 임시 후보와 원본/접수 ZIP을 분리한다. 커넥터 품번·실장 수량·예비 수량, 회로 연결은 유지한다. M12 지지부를 새 요구조건으로 추가하지 않는다.

후보는 Molex만 J2를 앞면에서180도 회전하며 신호 비아0을 유지한다. LLC/TE는 원래 J2 위치·회전각을 유지하고 대칭 신호 비아와 SHIELD 귀환 비아를 사용한다. 공통 발룬은 RCT2 DNP만 기존 다른 RCT와 동일한 뒷면으로 옮기며 모든 커넥터는 앞면이다. 이전 비아/비결합 길이 조건을 넘는 후보는 전기적 영향 확인 전 채택하지 않는다. 현재 원도면 홀 대조와 핀/네트 유지, DRC·회로도 정합, 수정 전후 전자기 비교를 진행 중이다. [상세 후보·실행 증거](../reviews/rj45_drawing_closure_20260929/REPORT.md).

## DEC-076 — 앞면 RJ45 수정4종 제조 검토 접수 (2026-09-29)

**9/29 14:24 앞면 RJ45 수정본 접수(DEC-076):** 사용자 선택대로 모든 커넥터를 앞면에 둔 B-RJ1 DRAFT 4종을 JLC에 재접수했다. 공통 Y30, LLC Y31, TE Y32, Molex Y33(각5장)은 Reviewing이며 대응 구형 Y18/Y27/Y28/Y29는 취소 완료했다. VNA226.22 + RF218.13 = **444.35달러(쿠폰 전)**. 제조 검토와 로컬 RF 비교를 병행하며, 아직 원래 balun CAD 채택·생산승인·결제 완료가 아니다. 원도면48홀과 회로연결 정합은 수정 후보에서 확인했다. 이전 DEC-074 PASS는 철회 상태다. 아래 과거 접수·가격 문장은 당시 이력이다.

[실제 주문·파일 해시·옵션·취소 기록](../reviews/rj45_drawing_closure_20260929/front_jlc_submission.json). 새 양식은 실제 배선 층을 기준으로 작성했다. Plugged/7628/4L/1.6 mm/LF HASL/수동 생산파일 확인을 유지한다. Molex의 자동 층·치수 분석은 표시되지 않아 실제 CAD의4층66×40 mm를 입력했고 업체 분석을 기다린다. 모든 최신 주문에서 자동 분석이 성공했다고 표현하지 않는다.

## DEC-077 — 리뉴얼 VNA 보드 제조 사전검수 및 B-RJ2 접수 (2026-09-29)

**9/29 리뉴얼 PCB 사전 DFM·JLC 교체 완료(DEC-077):** 공통 ETH의 RJ45/SMA B면안, LLC·TE A쌍L1/B쌍L4 신호비아0개안, Molex 앞면안을 B-RJ2 제조 묶음으로 제출했다. 공통 센터탭 비아3개 간격과 인쇄글자23개를 국부 보완했고, DRC/미연결/정합0·191드릴·공식 임피던스8행을 확인했다. 공통Y34/LLCY35/TEY36/MolexY37은 각5장 Reviewing, 구형Y30–Y33은 취소 완료. VNA226.22+RF218.13=444.35달러(쿠폰 전), 결제·생산승인 없음. 현행 원본/ZIP은 [새 검수 기록](../reviews/jlc_renewal_preflight_20260929/REPORT.md)과 그 current_configuration.json을 따른다. 이전 B-RJ1 배선안은 채택하지 않는다. RF R2·A18/C10 및 구매 부품수량은 유지한다.

구형 원본·반려 이력은 보존하고 별도 candidate 원본/라이브러리/규칙과 검증된 공식 양식을 포함한 새 ZIP을 사용한다. 과거 임피던스 동의를 새 배선의 승인으로 대체하지 않는다. 접수 승인과 실측 RF 성능을 구분한다.

## DEC-078 — 주문 기준 프로젝트 정리 (2026-09-29)

사용자 요청에 따라 Head A04 SMA R2 / Fixture A03 SMA R2 / VNA B-RJ2 / A18-C10의 현재 제작 진입점을 docs/CURRENT_BUILD.md와 docs/current_build.json에 통합했다. 기존 설계/제조 ZIP/수량/구매팀 파일은 보존하고 구형 문서 백업·기구 탐색·재생성 사본·과거 해석자료는 검증한 압축 이력으로 이관했다. 캐시·자동백업·명시적 trash와 변경 없는 임시 Git worktree2개는 제거했다. 현재 검증 입력과 A18의 A17 의존 원본, viewer_A05 사용자 변경은 유지한다. 진행 중인 RJ45 시뮬레이션 트리는 삭제 중 안전 검사에서 감지해 복원/제외했고 프로세스는 중지하지 않았다.

약19.741→13.573GB로6.17GB 감소. 보호1414파일의 전후 해시와 제조 ZIP/수량/진입 링크 검사, 분석 자동시험154개를 검증했다. 과거 문서 잠금 기준은 재잠금하지 않았다. 업체 최종심사·결제·생산승인·실물RF 미완료 상태와 구매예비수량을 바꾸지 않았다. [정리·검증·복구 기록](../reviews/project_cleanup_20260929/REPORT.md).

## DEC-079 — 현재 원본 독립 재검토와 현행 문서 정합 수정 (2026-09-29)

사용자 요청으로 기존 PASS를 판정 입력으로 삼지 않고 현재6 PCB 원본/제조ZIP·15종20개 출력·구매품 조립CAD·제조사/판매자 도면·구매31행·요구56행을 다시 대조했다. 새 DRC/미연결/회로도정합0, 표준ERC0, 모든ERC규칙 활성화 시 Molex SHIELD 단일라벨 경고1건을 분류했다. 새 CAM62파일/드릴265개가 접수묶음과 일치하며 VNA 공식양식8행/관리구간14개도 실제배선과 일치한다. 현재CAD 정지조립7,021쌍 중386쌍 정밀교차에서 기판/동박 모델 겹침만 확인했다. 뚜껑2개는 자유/닫힘 형상을 별도로 재생성해 비교했다. Fixture SIG ONLY 실크0.9mm는 업체 권장1.0mm 미달 가독성 예외로 기록하며 제조원본은 변경하지 않는다.

설치BOM의 구형접수번호·가격·구매진입점과 M12 고정부 문구를 수정했다. 요구사항 VAL-03의 우선대역을 백서14.5로 통일하고 HW-02의 적층/임피던스관리 표현을 현행주문으로 정정했다. 선택부품/수량/장바구니/제조파일은 유지한다. 구매품517,249원+JLC444.35달러(쿠폰 전), 환율1,400원·세금가산·예비비 기준1,276,283원은 견적/계획값이다. 현행보존검사에 이번 문서변경 전후 해시와 사본을 추가했으며 구형검증 기준은 수정하지 않았다.

출력기준 교정식을 독립 파동방정식1001점으로 확인했고 기존시험154개 통과. 기존FEA9job12case의 원시응력/반력을 재환산했으며 새해석 실행·메쉬수렴·크리프/피로 검증으로 표현하지 않는다. 업체심사·최종CAM/결제/생산승인 및 실물조립/RF T01–T12는 남아 있다. [검토 범위·발견·원시 결과](../reviews/independent_current_audit_20260929/REPORT.md).

## DEC-080 — 실험실 취급용 중앙 베이스 A19 수정 및 교체 심사 요청 (2026-09-30)

사용자는 일반 실험실 취급, 비용 최소화·소폭 상승 허용 조건으로 계획 실행과 업체 협의를 승인했다. P05 중앙 베이스만 유지 재질9600 Resin에서 넓은 앞뒤 이음판에 R4 개구부8개를 넣는 A19를 채택해 재심사 요청했다. 추가 출력부품·나사는0개, 전체15종20개/재질 수량과 다른14종·PCB·RF교정 구성은 유지한다. 원래294.095→275.910 cm³로6.184% 감소했다. 이는 비용/휨 감소율을 뜻하지 않는다. 분할 기둥이나 재질 변경은 아직 채택하지 않았다.

현재 하드웨어 조립 CAD를 출발점으로 받침면·볼트 좌면·기둥/구멍 위치를 대조했다. 첫 후보의 본체 받침면 일부 손실을 검출해 폐기하고 후면 개구부를 이동했으며 실패 결과는 보존했다. 최종 후보는 필수 접촉면 손실0·변경 중앙1개·유효 단일솔리드/폐쇄 STL, 187654점 유한 두께 검사 최소2.232 mm/2 mm 미만0, 독립 재생성 STL 바이트 일치를 확인했다. 같은100 N 비교의3 mm 메쉬 최대변위는A18 0.3070→A19 0.3135 mm(+2.114%). 4기둥 상단 총10 N 횡하중2축의 최대변위0.1147 mm. 4/3 mm 메쉬의 반력 평형·양의 야코비안과 종전 명목 인장 스크린27.5 MPa 이내를 확인했으나 최대응력은 메쉬수렴값이 아니다. 이 계산을 정격하중·경화 휨·실물 합격으로 쓰지 않는다.

9/30 16:19 Elinor에게 A19 STL/비교 PNG/검토 메모를 발송했다. 기존 P05 D2026092832500233 한 항목 교체를 요청했고 사이트 A18/Pending은 아직 바뀌지 않았다. 담당자의 위험 위치 표시, 출력 자세/지지/후경화 검토, 새 가격과 가조립 불합격 시 처리 회신은 남았다. 결제/생산승인이나 기능상 휨을 무조건 수락한 것은 아니다. 재시험은 업체 수정 피드백 시 변경 부위의 형상·접촉/두께·구조 검사, 입고 후 자유 맞댐/PCB홀/기둥/가동 확인이다. [원본·검사·발송 및 한계](../reviews/base_a19_20260930/REPORT.md).

## DEC-081 — 1–150MHz 교정지그에 보유 직각 SMA 사용 선정 (2026-10-26)

사용자는 Fixture A03 SMA R2의 수직 SMA 대신 구매 후 남은 Samtec SMA-J-P-H-RA-TH1 두 개를 사용하고, 1–150MHz 범위의 교체 판단만 확정하도록 요청했다. 제조사50Ω SMA와5.08mm 핀 배열·현행 PCB1.90/2.10mm 홀 호환을 확인해 이 범위의 사용 부품으로 선정한다. 실물 무응력 삽입·안착·납땜 간극을 확인하고 완성된 해당 지그로 교정한다. 제조 원본·공개 절차서·구매수량은 수정하지 않으며, 기존1–500MHz 특성화를150MHz 성능 보장으로 바꾸지 않는다.

선로 길이/보어/유전율의18가지 단순 through 근사는150MHz 크기변화−0.001135~0dB·위상−4.63~−3.81°였다. 이는 실제 PCB/제품 오차의 상한이 아니다. 새3D FDTD는 RA 출력 전류 적분 면적 축소 오류와 시간창 미수렴으로 정량 비교에 채택하지 않는다. 실패 원시 출력과 소스는 보존했다. 정확한 제조사S2P/내부EM 모델, 실물RF 성능은 미확인이다. 재확인은 실제 직각 실장 지그의through·로드ΓL·정역방향 전달·K 적용범위와 반복성이다. [제조사 근거·계산·실패 및 적용 범위](../reviews/sma_right_angle_20261026/REPORT.md).

## DEC-082 — 직각 SMA 포트 수정 후1–150MHz 수치 검증 완료 (2026-10-27)

사용자는 시뮬레이터 오류에서 멈추지 말고 정상 계산·검증까지 수정하며 계속하도록 지시했다. 이전RA 전류 적분면이격자에서0폭으로 축소된 원인을 수정했다. 수직·직각동일전체격자, 실제포트면적·PEC 연결/절연·출력50Ω·전력·두시간창 안정성·원시DFT 재현·전류부호를 검사했다. 제어 동축의1/3GHz 여기 대역비교와 포트격자세분화도 실행했다. 새 모델의150MHz 직각/수직 전달크기 차이는-0.003dB, K크기차이는-0.011dB였다. 이전실패원시기록은보존한다. [실행·검증·수치](../reviews/sma_port_repair_20261027/REPORT.md).

DEC-081의1–150MHz 보유Samtec 직각2개 사용선정을 유지한다. 이는 도면기반근사모델의정상계산이며 실제부품S2P·전체PCB메쉬수렴·실물RF 성능보증이아니다. 내부보어/유전율/안착·PEC/무손실·이상적솔더가정, 이산포트절대위상오차를 구별한다. 완성된동일지그로 기존출력포트기준의through·로드ΓL·정역전달·K적용범위·반복성을 확인한다. 제조원본·구매수량·공개절차서는변경하지 않는다.
