ckh7488/rf_current_probe/docs/G1_APERTURE_REVIEW.md

> **이력 문서 · 현재 제작/사용 지시 아님 — 2026-09-22 분류.** 초기30 mm 후보 검토다. 사용자가 정한 현행 기준은 공칭26 mm다. 현재 기준은 [현재 준비 상태](CURRENT_READINESS.md)를 따른다. 아래의 “현재/최신/미확정”은 원래 작성 시점의 표현이다.

# G1 — 장착 구경과 코어 형상 예비 검토

작성일: 2026-09-15. 상태: **DRAFT — NOT FOR FABRICATION**.

현재 기준: **집게형(split-core), DEC-010**. 2~3절의 닫힌 코어 비교는 과거 검토 이력이며, 해당 두 부품은 현재 제작 후보에서 제외한다. 후속 [분할 코어 선정 검토](G1_SPLIT_CORE_SELECTION.md)에서 2644181281·5턴·유효 구경 30 mm 목표를 첫 시제품 시작안으로 선정했다(DEC-011). 실물 검증과 제작 도면은 아직 없다.

이 문서는 사용자 장착 요구를 반영한 G1의 첫 검토다. 최종 코어·구경·권선·비용·성능을 확정한 문서가 아니다. 중심 기준서는 [백서](RF_CURRENT_PROBE_WHITEPAPER.md) 4.2·7~10·14·19절이다.

## 1. 확정된 사용 요구와 남은 정보

- **REQUIREMENT — 사용자 지정:** M12 8핀 커넥터가 달린 케이블과 일반 RJ45 케이블 모두 대상이다.
- **REQUIREMENT — 사용자 선호:** 성능에 큰 불이익이 없다면 구경을 여유 있게 잡는다. 무조건 소형화하거나 최소 통과 치수에 맞추지 않는다.
- **TARGET:** 백서의 유효 구경 약 30~35 mm를 탐색 출발점으로 유지한다. 범위 내 장착 여유를 우선하며, 부족하면 더 큰 형상과 비용·성능을 비교한다.
- **REQUIREMENT — 사용자 선택:** 커넥터 분리 없이 케이블 중간에 장착하는 집게형으로 진행한다. 고정형/집게형 선택은 해결된 항목이다.
- **TBD:** 동시에 감쌀 케이블/도체군의 굵기, 집게의 열림·잠금 공간, 인접 커넥터·설비 간섭. M12의 명칭이나 8핀이라는 정보만으로 케이블 굵기를 결정하지 않는다.

구경은 커넥터 통과 치수가 아니라 케이블/다발이 놓일 공간으로 결정한다. 닫힌 유효 구경과 열린 진입 폭을 모두 검토하고, 반복 개폐 후 접합면 정렬·잠금 상태를 재현할 수 있도록 설계한다. 커넥터가 센서에 전기적으로 연결되는 구조는 아니다.

## 2. 이전 닫힌 코어 형상 검토 — 현재 후보에서 제외

조회일: 2026-09-15. 아래 값은 **제조사 문서 사양**이며 실측값이 아니다. 두 후보는 같은 공칭 형상이므로 재료 비교의 출발점으로 사용할 수 있다. 이것만으로 큰 구경과 작은 구경 사이의 성능 비교가 끝난 것은 아니다.

| 후보 | 재료 | 외경 A (mm) | 내경 B (mm) | 높이 C (mm) | AL (nH/turn²) |
|---|---|---:|---:|---:|---:|
| [Fair-Rite 5943003801](https://fair-rite.com/product/toroids-5943003801/) | 43 | 61 ±1.30 | 35.55 ±0.85 | 12.7 ±0.50 | 1075 ±20% |
| [Fair-Rite 5961003801](https://fair-rite.com/product/toroids-5961003801/) | 61 | 61 ±1.30 | 35.55 ±0.85 | 12.7 ±0.50 | 170 ±25% |

AL 시험 주파수는 제조사 표기상 10 kHz다. 이를 RF 대역의 일정한 자화 인덕턴스로 확정하지 않는다. 부품별 코팅 유무·추가 절연 두께, 재료의 복소 투자율 자료 적용 범위, 권선 배치는 상세 후보 검토에서 확인한다. 일반 코팅 옵션의 내전압 문구를 이 부품이나 완성 프로브의 정격으로 전용하지 않는다.

가격·재고·배송은 미확인이다. 두 부품 모두 닫힌 코어이므로 집게형 기본 BOM의 채택 대상에서 제외한다. 해당 AL을 새 분할 코어에 대입하지 않는다.

## 3. 이전 닫힌 코어의 통과 구경 계산 — 이력 보존

**CALCULATED — 단순 기구 치수 예산.** 위 후보의 내경 하한은 `35.55−0.85 = 34.70 mm`다.

각 측면의 안쪽 침범 두께를 `t`로 묶으면 `D_clear ≈ 34.70−2t`로 계산할 수 있다. `t`에는 권선, 추가 절연, 하우징 및 필요한 여유를 포함한다. 실제 돌출 위치가 비대칭이면 가장 좁은 통과 경로를 별도로 확인해야 한다.

| 목표 유효 구경 | 각 측면에 허용되는 침범 두께 t |
|---|---:|
| 30 mm | 2.35 mm |
| 32 mm | 1.35 mm |
| 35 mm | −0.15 mm — 공차 하한에서 권선 전에도 충족 불가 |

따라서 **카탈로그 내경 35.55 mm를 완성품의 35 mm 유효 구경으로 표시할 수 없다.** 이 계산은 이전 닫힌 코어 형상에만 해당하며 새 집게형의 확보 구경을 뜻하지 않는다. 실제 분할 코어·권선·절연 치수를 정한 뒤 다시 계산한다.

계산은 Python 3.12.6에서 산술 실행으로 확인했다. RF 시뮬레이션·교정 계산·실물 통과 시험은 실행하지 않았다.

## 4. 성능을 유지하며 구경을 늘리는 판단 기준

백서 7~9절의 모델에 따라 구경만으로 감도 저하를 단정하지 않는다. 단면적·자기 경로 길이·재료·권선 길이·기생 성분·차폐 배치가 함께 달라지므로 전체 형상과 권선으로 비교한다. 큰 후보를 선정할 때 다음을 확인한다.

| 판단 항목 | 연결할 검증 |
|---|---|
| 우선 목표 1~100 MHz에서 유효한 측정 구간과 충분한 신호 확보 | T02/T03/T04/T08/T09; 백서 14.2의 유효 대역 조건 |
| 개폐·재장착 및 큰 구멍 안의 위치 변화에도 결과를 재현할 수 있음 | T05/T06; 분할면 정렬·잠금 상태·비도전성 위치 고정 스페이서 검토 |
| 감도를 위해 턴 수를 줄였을 때 측정 대상의 전류 변화가 과도하지 않음 | T10; 부담의 일차 환산과 지그/링크 A/B 비교 |
| 차폐·SMA·고정부가 단락 턴이나 직접 픽업 문제를 만들지 않음 | T01/T08 및 3차원 경로 검토 |
| 보호와 검증을 포함해 신규 지출 10만 원 목표 / 20만 원 상한 충족 | 수량·조회일·배송·세금 포함 G1 비용표 |

T05의 1~100 MHz ±1 dB 반복성 등 백서의 초기 목표를 사용한다. 위치 오차와 삽입 영향의 최종 허용치는 실제 데이터와 사용 목적을 보고 정하며, 현재 임의의 통과 판정을 만들지 않는다. 300/500 MHz 성능은 별도 특성화 대상이다.

## 5. 다음 작업과 G1 미완료 항목

1. 분할 코어 세 후보 비교와 첫 시제품 선정은 후속 검토서에서 완료했다. 선정품의 실제 도면·판매 단위·권선/기구 간섭 확인이 남아 있다.
2. 일정 AL의 이상적 3/5/7턴 비교 계산은 실행했다. 복소 투자율·분할면·기생 성분을 반영한 RF 모델과 실측은 남아 있다.
3. 중심 도체는 코어 안, 귀환은 밖으로 흐르는 지그와 출력 동축 경로를 검토하고, 교정 식의 단위·부호를 검산한다.
4. 코어·동축·SMA/BNC·종단·보호·PCB·기구·배송을 포함한 비용표를 작성한다.
5. 제조 전 실제 케이블/다발과 주변 설비를 기준으로 기구 모형의 열림·삽입·잠금·간섭을 확인한다. 개폐·재장착 5회 이상의 T05에 접합면 상태를 기록한다.

이 문서의 초기 검토 이후, 분할 코어 세 후보·권선 시작안·잠금 방식·비용 배정을 DEC-011과 선정 검토서에 추가했다. 실제 지그 모델·기구 도면·보호 체인·전체 실견적은 아직 완료되지 않아 G1은 진행 중이다.
