ckh7488/rf_current_probe/docs/STATUS.md

# RFCP 현재 작업 상태

**2026-10-26 실물 조립 관측:** 사용자가 케이블 클램프의 큰 노브축 쪽 전체 고정 불량과 F12 주변 심한 덜컥거림으로 사용 불가를 보고했다. 현재 조립한 클램프는 **사용 보류**다. 현행 CAD의 공칭 여유 재검토와 사진은 [실물 실패 기록](../reviews/clamp_fit_failure_20261026/REPORT.md), 준비 판정은 [CURRENT_READINESS](CURRENT_READINESS.md)를 따른다. 실물 간격 수치·RF 성능·수리 성공을 측정한 것은 아니다. 아래 업체 관측 날짜와 결제 상태는 이 보고로 갱신하지 않는다.

주문 화면 최종 관측: **2026-09-30 16:18 KST**. 수정본 메일 발송/첨부 확인: **16:19 KST**. 현재 파일 선택은 [제작 구성](CURRENT_BUILD.md)에 통합했다. 아래 표는 16:18까지의 업체 화면 관측이며 실시간 자동 갱신이 아니다. [오늘 주문·메일·사이트 문의 기록](../reviews/jlc_status_followup_20260930/REPORT.md)

| 묶음 / 항목 | 현재 접수번호 | 업체 표시 |
|---|---|---|
| 프로브 헤드 SMA R2 | Y23-9961994A | Approved |
| 교정지그 SMA R2 | Y24-9961994A | Approved |
| 공통 ETH/RJ45 B-RJ2 | Y34-9961994A | Reviewing |
| LLC M12 B-RJ2 | Y35-9961994A | Reviewing |
| TE M12 slipring B-RJ2 | Y36-9961994A | Reviewing |
| Molex slipring B-RJ2 | Y37-9961994A | Reviewing |
| A18 앞베이스 | D2026092832500228-9961994A | Approved |
| A18 뒤베이스 | D2026092832500232-9961994A | Approved |
| A18 중앙베이스 | D2026092832500233-9961994A | Pending — A19 교체·재심사 메일 발송, 사이트 반영 미확인 |
| C10 프레임 2개 | D2026092828500181-9961994A | Approved |

RF 주문 W2026091819397543: **$218.13**. VNA 주문 W2026091110267631: **$226.22**. 합계 **$444.35, 쿠폰 전**, 결제·생산승인 전. 이는 기존 A18 견적이며 A19 변경 가격은 아직 확정되지 않았다.

9/29 23:43 JLC Support의 Jinwei가 별도 유료 임피던스 성적서를 넣지 않고, 취소된 Y27 대신 현행 Y34–Y37을 검토한다고 답했다. 지정 임피던스 관리·통상 검증은 유지한다. 9/30 사이트 채팅으로 추가 자료 필요 여부와 심사 완료 예상 시점을 문의했으며 전송 이력을 확인했다. 이메일 회신용 양식도 제출했지만 담당자의 새 답변이나 완료 시점 확약은 아직 없다. [문의 및 이전 소요 시간 비교](../reviews/jlc_status_followup_20260930/REPORT.md)

중앙 베이스는 9/30 10:13 조립 안내 PDF·참고 STEP을 보낸 뒤 **14:39 Elinor의 답변**을 받았다. 구조에 따른 휨 크기·조립 적합성·표준 공차 준수를 보장할 수 없으며, 현행 파일로 진행할지 수정할지 고객 결정을 요청했다. 창고 검사는 간단한 가조립이며 볼트·PCB 설치나 조립 납품은 하지 않는다. 개별 업로드 파일로 출력하고 합본 STEP은 출력하지 않는다고 확인했다. 이후 사용자가 수정·업체 협의를 진행하도록 승인했다. 16:05 기존 중앙을 보류하고 Replace File 기능 활성화/위험 위치 표시를 요청했으며, 16:19 검증한 **BaseCenter_A19_DRAFT.stl + 전후 비교 PNG + 검토 메모**를 Elinor에게 발송했다. 사이트에는 교체 버튼이 없어 이메일로 직접 교체하거나 버튼을 열어 달라고 요청했다. STL 발송은 완료했지만 사이트 파일 교체/제조사 재심사 완료는 미확인이다. 새 견적·가조립 불합격 시 출하 전 통보/조치도 답변을 요청했다. [A19 수정·검증·발송 기록](../reviews/base_a19_20260930/REPORT.md) [새 회신 원문 확인 및 해석](../reviews/jlc_reply_20260930_1439/REPORT.md), [조립 자료 발송 기록](../reviews/jlc_assembly_reply_20260930/REPORT.md)

남은 업체 절차는 VNA 4종 심사·중앙 A19 파일 교체·재심사/견적·가조립 조건 협의, 최종 제조파일 검토와 결제/생산승인이다. **9/30 주문 상세 재확인에서 Y34–Y37 모두 Reviewing, Nan Ya NP-155F / JLC04161H-7628 / 임피던스 관리 / 성적서 No / 수동 생산파일 확인 Yes를 확인했다.** 이전 일반명 FR-4 TG155 표시만 있던 불일치는 상세 표시에서 해소됐으며 최종 CAM도 대조한다. 합계 $444.35는 유지됐다. 앞베이스 자동 얇은 벽 경고의 상세와 기능면 휨 조건은 업체 Approved 표시만으로 입증됐다고 쓰지 않는다.

9/29 [독립 재검토](../reviews/independent_current_audit_20260929/REPORT.md): 제조 원본·주문 수량·구매팀 HTML은 변경하지 않았다. 설치 BOM의 구형 접수/가격/구매 지시와 M12 고정부 문구, 요구사항의 우선 대역·적층 표현을 수정했다. 교정지그 실크0.9 mm 가독성 예외는 기록하고 최종 CAM/인수 확인으로 남겼다.

9/30 기록 당시 실물 입고/조립·RF 교정 T01–T12는 미실행이었다. 10/26에는 사용자 실물 조립과 위 클램프 실패가 관측됐으며, RF 교정 T01–T12의 새 실행 증거는 없다. [조립·시험 준비](CURRENT_READINESS.md)

이전 접수번호·반려·수정 이력은 [DECISIONS](DECISIONS.md)와 날짜별 reviews에 있다. 정리 전 상태 문서는 [보관함](../archive/README.md)에 보존했으며 현재 주문 지시로 사용하지 않는다.
