ckh7488/rf_current_probe/docs/G1_SPLIT_CORE_SELECTION.md

> **이력 문서 · 현재 제작/사용 지시 아님 — 2026-09-22 분류.** 코어 후보·AL 계산의9/15 근거다. 초기30 mm/힌지/캠은 현행 형상이 아니다. 현재 기준은 [현재 준비 상태](CURRENT_READINESS.md)를 따른다. 아래의 “현재/최신/미확정”은 원래 작성 시점의 표현이다.

# G1 — 집게형 코어·권선·잠금 구조 선정

> **현행 기준 안내 · 2026-09-21:** 기구·구매 수량·발주 상태는 [CURRENT_READINESS.md](CURRENT_READINESS.md)와 [최종3D 제작 기준](3D_PRINT_RELEASE_A16_C09.md)을 따른다. 아래는 해당 작성일의 기록이다. 교정 수식·기준면·종단·보호 원칙은 계속 적용하지만, 옛 동판/패드·구매 수량·제작 완료 표현은 현재 지시가 아니다.

작성일·자료 조회일: 2026-09-15. 상태: **DRAFT — NOT FOR FABRICATION**.

## 1. 선정 결과

**현행 구경 결정(2026-09-22):** 사용자는 실제 대상의 큰 지름이 약20 mm 수준이며 현행26 mm 기준이면 충분하다고 확인했다. A14 헤드의 고정바를 포함한 공칭 통과 지름은 약26.40 mm이고 C07의 공칭 작동 범위는6–26 mm다. 따라서 아래 초기30 mm 목표는 현행26 mm 기준으로 대체한다. 실제 최대 구경 보증과 혼동하지 않는다. [독립 재검토](../reviews/independent_release_review_20260922/README.md).

**초기 선정 이력:** 1차 시제품은 Fair-Rite 2644181281, 44 재료의 분할 코어로 진행한다. 두 반쪽으로 자기 경로를 닫는 구성, 고정 반쪽의5턴 권선, 유효 구경30 mm 목표, 비도전성 힌지 하우징과 캠 잠금을 설계 시작안으로 선택했다. DEC-011에 기록한 당시 시작안이며 잠금 기구도 이후 A14로 변경되었다.

이것은 부품·실험 순서의 선정이다. 실측 대역·감도·반복성의 확정이나 구매 실행을 의미하지 않는다. 사용자에게 재료나 턴 수를 다시 선택하도록 묻지 않는다. 실제 케이블/다발과 주변 공간은 기구 제작 전에 대조한다.

선정 이유는 넉넉한 내부 공간, 짧은 축방향 길이, 조달 가능한 표준 부품, 첫 코어 비용을 낮춰 교정·보호 예산을 남길 수 있다는 점이다. 짧은 코어가 반드시 더 넓은 RF 대역을 보장한다는 뜻은 아니다.

### 대역 목표 확인 — DEC-012

**1~100 MHz는 첫 검증 구간이며 최종 상한이 아니다.** 백서의 전체 개발 목표 100 kHz~300 MHz와 500 MHz 특성 확인·확장 목표를 유지한다. 사용자가 200 MHz 이상 관측 필요성을 제기했으므로, 후속 비교에서는 100~200 MHz와 200~300 MHz의 연속 응답·잡음·직접 픽업·지그 유효성을 명시적으로 평가한다. 몇 개 주파수 점만 통과했다고 연속 대역이 확보되었다고 판단하지 않는다. 100 MHz 검증만으로 개발 목표 달성을 선언하지 않는다.

100 Mbps는 데이터율이고 MHz는 주파수이므로 `100 Mbps×2 = 필요한 프로브 대역 200 MHz`로 환산할 수 없다. 일반 100BASE-TX는 별도의 선로 부호화를 사용한다([Microchip AN1120](https://ww1.microchip.com/downloads/en/appnotes/01120a.pdf)). 본 프로브의 대상은 케이블의 RF 합전류이며, 데이터율만으로 공통모드 잡음의 상한을 정하지 않는다. 산업용 Ethernet에는 전원·접지·인접 신호·클록 고조파의 결합도 검토해야 한다([TI SNLA466A](https://edgeworker.ti.com/lit/pdf/snla466)). 두 자료 조회일은 2026-09-15다.

현재 코어·5턴 선정은 실험 시작안이다. 200/300 MHz에서 유효한 ZT와 측정 체인을 아직 입증하지 않았으며, 상위 대역의 실패 시 리드·권선·차폐·지그 또는 코어를 재검토한다. 부품의 억제 주파수 사양으로 이 검증을 대신하지 않는다.

## 2. 세 후보 비교

치수·재료는 제조사 문서 값이다. 단위 mm. 판매처의 필터용 임피던스는 프로브 전달 임피던스 ZT가 아니다.

| 우선순위 | 제조사 부품번호 | 재료·형식 | 내부 공간 / 축방향 길이 C | AL 참고값 (µH/turn²) | 판단 |
|---|---|---|---|---:|---|
| **선정** | [2644181281](https://fair-rite.com/product/round-cable-snap-its-2644181281/) | 44, NiZn 분할 코어 | B=37.21 ±0.89; 제조사 최대 케이블 지름 33; C=12.7 ±0.635 | 1.1 | 큰 구경과 짧은 권선 경로를 우선. 별도 힌지·잠금 하우징 설계 |
| 큰 구경·저주파 대안 | [2631181381](https://fair-rite.com/product/round-cable-snap-its-2631181381/?print=pdf) | 31, MnZn 분할 코어 | B=37.2 ±0.64; 최대 케이블 지름 35.4; C=63.5 ±1.50 | 9.1 | 저주파 모델에 유리하지만 C가 선정품의 5배. 부피·권선 길이·비용 때문에 첫 제작에서 제외 |
| 작은 기성 집게 대안 | [0431177081](https://fair-rite.com/product/round-cable-snap-its-431177081/) | 31, MnZn, 케이스 포함 조립품 | 제조사 B/최대 케이블 지름 25.15; C=42.95 ±2.0 | 6.2 | 기성 힌지는 편리하나 권선 전부터 30 mm 목표보다 작음. 권선과 케이스 간섭도 재검토해야 하므로 첫 제작에서 제외 |

AL 출처는 제조사의 [Snap-It 식별 안내 R02](https://fair-rite.com/wp-content/uploads/2023/10/FR_IndentifyingUnknownFair-RiteRoundCableSnapIts_R02.pdf), 1~2쪽이다. 문서는 닫힌 상태의 1 또는 10 kHz 인덕턴스를 부품 식별용 상대값으로 제시하며, 제품은 고주파 임피던스로 관리한다고 명시한다. **AL은 보장 공차를 가진 RF 모델이 아니다.** 이 값으로 실제 집게의 1~100 MHz 응답을 확정하지 않는다.

2644181281의 추가 제조사 치수: A=60.96 ±1.27, D=29.64 ±0.31, E=16.52 MIN; 중량 표기 63 g. 이는 도면의 개별 부품 치수이며, D를 완성 집게 전체 높이로 사용하지 않는다. 권선·추가 절연·케이스 외형도 포함하지 않는다.

### 출처 간 차이와 남은 확인

- 선정품 제조사 설명은 `44 ROUND SPLIT CABLE CORE`다. 일부 DigiKey 페이지의 `Solid` 분류와 충돌하므로 제조사 설명을 우선한다. 구매 시 같은 부품번호의 반쪽 단위와 실제 포장 구성을 확인한다.
- BOM은 필요한 물리적 반쪽 **2개 / 헤드 1개**로 작성한다. 견적 비교는 판매 수량 2개를 가정했다. 판매 단위가 한 쌍인지 한 반쪽인지 명시 확인하기 전 발주 수량을 확정하지 않는다.
- 선정품 웹페이지에는 전형적 억제 임피던스 표가 두 벌 있다. 최신 출력 표는 10/25/100/250 MHz에서 37/59/105/178 Ω, 다른 표는 35/56/104/170 Ω다. 어느 표도 ZT나 실제 측정 결과로 대입하지 않는다.
- 0431177081은 판매처의 25.65 mm와 현재 제조사 25.15 mm 표기가 다르다. 비교에는 더 보수적인 현재 제조사 값을 사용했다.
- 제조사 및 판매처가 보관한 제조사 PDF의 텍스트는 확인했다. 도면 이미지/PDF 원본 다운로드는 HTTP 403 또는 timeout으로 실패했다. **도면 형상 시각 확인·STEP 간섭 검토는 미실행**이다. B만으로 원형 37.21 mm가 통과한다고 판단하지 않는다.

## 3. 구경과 잠금 구조

### 구경

첫 기구 목표는 **완성 후 유효 구경 30 mm**다. 백서의 30~35 mm 탐색 범위 중 하단을 우선한다. 선정품의 제조사 케이블 지름 안내 33 mm를 기준으로 권선·절연·보호 라이너가 각 측면에서 1.5 mm 이내를 차지하도록 배치하는 치수 예산이다.

`CALCULATED: 33 − 2×1.5 = 30 mm`.

이 식은 제조 공차까지 검증한 최소 구경 보증이 아니다. 도면·실물 형상과 권선 돌출을 확인한 뒤 가장 좁은 방향을 검사한다. 열린 진입 폭도 30 mm 이상을 기구 목표로 둔다. 최종 판단에는 실제 케이블/다발, M12 너트·RJ45 부트/래치 등 인접 간섭을 포함한다.

### 채택할 기구 방식 — 설계안

1. 코어 두 반쪽을 별도의 비도전성 하우징에 담는다. 고정 반쪽에 권선·헤드 PCB·SMA를 모으고, 가동 반쪽에는 전기 배선을 통과시키지 않는다.
2. 한쪽 외곽에 힌지, 반대쪽 외곽에 손으로 여닫는 오버센터 캠 잠금을 둔다. 힌지는 외측 M3급 나일론 축을 시작안으로 한다. 축·캠의 최종 치수는 도면 확인 후 설계한다.
3. 하우징은 PETG 기구 시제품을 시작안으로 한다. 재료·적층방향·벽 두께·온도·크리프 내구성은 검증 전이다. 절연 안전 정격을 부여하지 않는다.
4. 정렬 턱으로 두 반쪽의 가로 이동을 막고, 코어 뒷면의 탄성 패드로 접촉 압력을 준다. 캠 닫힘 위치와 과압축 방지 스토퍼를 두되, 스토퍼가 너무 일찍 닿아 코어 접합면에 틈을 남기지 않게 조정한다.
5. 접합면 사이에는 테이프·접착제·패드를 넣지 않는다. 페라이트를 절단·연마해서 맞추는 계획도 사용하지 않는다. 접합면 오염·파손과 권선 끼임을 점검할 수 있어야 한다.
6. PCB·차폐·SMA 외피·나사 경로가 코어 구멍을 통과해 밖으로 돌아오는 단락 턴을 만들지 않도록 별도 3차원 검토한다. 비도전성 하우징만으로 RF 차폐가 완료되지는 않는다.

잠금 힘은 임의 숫자로 확정하지 않는다. 같은 잠금 위치로 접합면이 재현되는지를 먼저 확인하고, 개폐 내구성과 T05 반복성으로 고정한다. 이 하우징은 도면·CAD·실물이 아직 없는 기구 아키텍처 선정이다.

## 4. 권선 시작안과 비교 계산

- 시작: **5턴**, 고정 반쪽에 단층으로 분산 배치한다. 도체를 코어 창으로 통과시켜 해당 반쪽 바깥으로 되돌리는 한 바퀴를 1턴으로 센다. 두 접합면은 비워 둔다.
- 도선 시작안: 도체 지름 약 0.3 mm의 절연 에나멜선. 실제 피복 외경·온도 등급·코어와의 추가 절연은 구매 품목 선정 시 확인한다. 권선 아래 얇은 절연층을 두되 접합면은 덮지 않는다.
- 두 출력 리드는 함께 짧게 헤드 PCB로 보낸다. 각각 5 mm 이하를 배치 목표로 두며 실제 길이를 기록한다. 수신기 쪽 단일 50 Ω 종단을 유지한다.
- 시험 순서는 같은 코어·하우징에서 **5 → 3 → 7턴**이다. 코어와 턴 수를 동시에 바꾸지 않는다. 다시 감을 수 있도록 초기에는 영구 포팅하지 않는다.
- 반쪽에 집중된 권선은 위치 민감도와 직접 픽업을 확인해야 한다. 분포 권선이나 가동부 배선 추가는 T06/T08 결과가 필요할 때만 검토한다.

백서 7.1~7.2의 이상적 모델:

`Lm = AL×N²`, `ZT_plateau = 50/N`, `R_reflected = 50/N²`, `fL = 50/(2πLm)`.

**CALCULATED — 아래 표 전체는 일정 AL, 이상적 결합, 기생 성분·권선 저항·코어 손실 생략 모델이다.** 모델 입력과 재실행 코드는 [계산 스크립트](../analysis/split_core_tradeoff.py), 실행 출력은 [JSON](../analysis/split_core_tradeoff_calculated.json)에 보존했다.

| 후보 | N | Lm (µH) | 이상적 ZT (Ω) | 일차 환산 저항 (Ω) | fL (kHz) |
|---|---:|---:|---:|---:|---:|
| 2644181281 | 3 | 9.9 | 16.67 | 5.56 | 803.81 |
| **2644181281** | **5** | **27.5** | **10.00** | **2.00** | **289.37** |
| 2644181281 | 7 | 53.9 | 7.14 | 1.02 | 147.64 |
| 2631181381 | 3 | 81.9 | 16.67 | 5.56 | 97.16 |
| 2631181381 | 5 | 227.5 | 10.00 | 2.00 | 34.98 |
| 2631181381 | 7 | 445.9 | 7.14 | 1.02 | 17.85 |
| 0431177081 | 3 | 55.8 | 16.67 | 5.56 | 142.61 |
| 0431177081 | 5 | 155.0 | 10.00 | 2.00 | 51.34 |
| 0431177081 | 7 | 303.8 | 7.14 | 1.02 | 26.19 |

5턴 선택은 3턴보다 저주파 차단과 일차 환산 부담을 줄이면서 7턴보다 권선을 짧게 시작하려는 절충이다. 선정품 5턴의 모델상 1 MHz 상대 응답은 고주파 극한 대비 약 −0.35 dB지만, 이는 실제 1 MHz 오차가 아니다. **100 MHz 상한을 이 모델로 예측할 수 없고, 100 kHz 목표 달성도 아직 보이지 않는다.** 31 재료 대안은 우선 코어가 저주파 목표를 만족하지 못할 때 검토하며 지금 함께 구매하지 않는다.

## 5. 가격·재고와 전체 예산

조회일: **2026-09-15**. 로그인·장바구니·주문 없이 조회한 페이지 표시값이다. 지역/검색 캐시마다 수치가 달라 확정 견적으로 사용하지 않는다. 한국 도착 배송비·세금·납기는 미확정이다.

| 후보 | 가격 근거 / 검토 수량 | 표시 단가·소계 | 표시 재고·납기 | 비용 판단 |
|---|---|---|---|---|
| 2644181281 | [Mouser 26 시리즈 표](https://www.mouser.com/c/passive-components/ferrites/ferrite-clamp-on-cores/?series=26), 수량 2 가정 | USD 8.73 / 17.46 | 페이지 재고 156; 한국 배송료·도착일 미확인 | 첫 코어 예산 35,000원 배정. 실제 판매 단위 확인 필요 |
| 2631181381 | [DigiKey Korea](https://www.digikey.kr/ko/products/detail/fair-rite-products-corp/2631181381/8594006), 수량 2 | KRW 35,407 / 70,814 | 재고 470; 표준 제조 리드타임 12주, 재고품 한국 도착일 별도 | 코어만으로 비용 부담이 커 첫 구매 제외 |
| 0431177081 | [element14 Korea](https://kr.element14.com/fair-rite/0431177081/split-core-ferrite-375-ohm-25/dp/4156104), 완제품 수량 1 | KRW 23,117 | 직접 열람 페이지 재고 733, 영국 재고 3~4영업일 표시 | 비용 대안이나 구경·권선 공간에서 불리 |

선정품 가격의 보조 확인: [Mouser Australia 개별 페이지](https://au.mouser.com/en/ProductDetail/Fair-Rite/2644181281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)는 AUD 12.99/판매단위와 재고 143을 표시했다. USD 표와 통화·재고를 섞어 계산하지 않는다. 한국어 판매 페이지 직접 열람은 실패했다.

**CALCULATED — 예산 시나리오:** 환산 가정 1,600 KRW/USD와 세금 여유 계수 1.10을 임의로 두면 `17.46×1600×1.10 = 30,729.60원`이다. 이는 실제 환율이나 세금 견적이 아니다. 코어 배정 35,000원에는 배송비를 포함하지 않고 아래 물류 항목에서 관리한다.

| 항목 | 내부 비용 배정 (원) |
|---|---:|
| 선정 코어 두 반쪽 | 35,000 |
| 권선·절연 | 5,000 |
| 헤드 PCB·SMA·소부품 | 15,000 |
| 힌지 하우징·잠금·패드 | 15,000 |
| SMA–BNC 케이블 | 15,000 |
| 교정지그·50 Ω 부하·필요 교정 접속품 | 20,000 |
| 수신기 보호·감쇠 체인 | 30,000 |
| 배송·세금 차액 | 20,000 |
| 재작업 여유 | 20,000 |
| **배정 합계** | **175,000** |

이 표는 **가격표가 아니라 설계 예산 배정**이다. 신규 지출 100,000원 목표는 유지하되 현재 배정 합계는 목표보다 75,000원 높고 200,000원 상한보다 25,000원 낮다. 보유 동축·종단·감쇠기 재사용과 실제 견적으로 줄인다. 보호 부품을 30,000원 안에 반드시 확보할 수 있다고 단정하지 않는다. 전체 확정 견적이 상한을 넘으면 범위를 줄이고 보호·검증은 유지한다.

## 6. 선정 이후의 실행 순서

1. 선정품의 실제 도면/STEP과 판매 단위 확보 → 두 반쪽·권선·하우징 간섭과 30 mm 구경 확인. 그림 열람 실패를 사용자 취향 질문으로 바꾸지 않고 다음 자료 접근에서 해결한다.
2. 기구 초안과 지그 중심 도체/외부 귀환 경로 작성 → 헤드 PCB 배치·차폐·보호 체인·전체 실견적 정리.
3. 제작 조건을 충족한 후 5턴 시제품으로 T01, 저전력 지그 특성화 및 T02~T04, T05/T06/T08/T10 순으로 검토. 측정 전 실제 장비 설정과 보호를 확정한다.
4. T05는 최소 5회 개폐·재장착하고 접합면·잠금 위치를 기록한다. 3/7턴은 동일 지그에서 다시 비교하며 매 변경에 구성 ID와 새 교정 ID를 부여한다.

실제 수행: 세 후보 제조사 자료·조달 표시값 비교, 모델 산술 실행, 설계 시작안·비용 배정 선정. 미실행: 도면 이미지 검사, CAD, 실제 권선/잠금 시험, 복소 투자율 RF 시뮬레이션, 지그 검증, 실측 교정, 보호 정격 검증, 구매. **G1 전체는 아직 완료하지 않았다.**

## 2026-09-16 후속 — 도면/STEP 확보 및 실험 준비

이 문서에서 미확인으로 남겼던 도면 접근은 해결했다. 제조사 직접 PDF/STEP을 [references](references/README.md)에 보존하고 시각 확인·FreeCAD 형상 검사를 수행했다. 형상과 E 치수, 공칭 30 mm 게이지의 간섭 검토는 [기구 검토](../mechanical/README.md)에 있다. 판매 단위·실물 공차·권선/잠금 반복성은 남아 있다.

[지그 전류 경로/합성 검산](G1_FIXTURE_REVIEW.md), [66개 합성 시험](G2_VERIFICATION.md), [벤치 절차](G2_BENCH_PROCEDURE.md)를 준비했다. 비용은 기존 배정을 지우지 않고 [후속 조달 시나리오](PROTECTION_AND_PROCUREMENT.md)에 갱신했다. 이 후속 작업은 대역/안전 정격의 실측 확인이 아니다.
