ckh7488/rf_current_probe/docs/PROTECTION_AND_PROCUREMENT.md

> **이력 문서 · 현재 제작/사용 지시 아님 — 2026-09-22 분류.** 초기 비용 시나리오와 보호 조건 조사다. 부품·금액은 현재 주문 지시가 아니다. 현재 기준은 [현재 준비 상태](CURRENT_READINESS.md)를 따른다. 아래의 “현재/최신/미확정”은 원래 작성 시점의 표현이다.

# 보호 체인·조달 검토 현황

> **현행 기준 안내 · 2026-09-21:** 기구·구매 수량·발주 상태는 [CURRENT_READINESS.md](CURRENT_READINESS.md)와 [최종3D 제작 기준](3D_PRINT_RELEASE_A16_C09.md)을 따른다. 아래는 해당 작성일의 기록이다. 교정 수식·기준면·종단·보호 원칙은 계속 적용하지만, 옛 동판/패드·구매 수량·제작 완료 표현은 현재 지시가 아니다.

**2026-09-17 최신 조달:** [BOM 0.12](BOM_DRAFT.md)와 [기구 포함 견적](../procurement/20260917/FULL_BOM_REVIEW.md)이 아래 과거 가격/선정 현황보다 우선한다. 나사·출력·원재료 선정/카트 완료, 로드 신규0/케이블 신규1. 현장 보호와 BNC 기준면 검증은 여전히 미완료.

2026-09-16 · **DRAFT — NOT FOR FABRICATION / 발주 없음**

## 1. 이번에 정한 범위

첫 실험은 LibreVNA가 저레벨로 구동하는 수동 F-A 지그다. 외부 에너지원이 없고 결선·부품 정격이 확인된 경우에 한해 벤치 절차를 적용한다. 실제 장비 입력 정격·보유 부속품은 실물에서 확인해야 한다.

현장용 기본 체인 방향은 `헤드 → 고정 감쇠기/검증된 보호부 → 50 Ω SMA–BNC → 스코프 내부 50 Ω`로 유지한다. **Mini-Circuits VAT-10A+ 10 dB 고정 감쇠기**를 비교 후보로 등록했다. 제조사 Rev.C(2026-06-30)의 DC~6 GHz, 50 Ω, 25°C에서 RF 입력 1.7 W 최대/85°C에서 1.0 W로 감액하는 조건을 확인했다. 별도 펄스 정격·실제 체인 응답은 미검증이다. 감쇠기는 전압을 낮추는 수단이며, 그 자체가 서지 제한기나 절연 장치라는 뜻은 아니다([확보 원본](references/VAT-10A_plus.pdf)).

현장 보호부의 임계값을 먼저 임의로 정하지 않는다. T03/T09의 출력 감도와 잡음, 제한된 T11 펄스 조건, 실제 스코프 입력 정격을 확보한 뒤 RF limiter/클램프 필요성과 잔류 전압·회복·왜곡·대역을 검토한다. DC block도 RF 과도전압 보호를 보장하지 않는다.

보호 체인을 가격 때문에 삭제하지 않는다. 검증된 현장 체인을 20만 원 안에 구성하지 못하면 해당 현장 사용을 보류하고 벤치 특성화 범위를 먼저 완성한다. 이는 백서 18절의 범위 조절 원칙이다.

## 2. 추가 조달 항목

아래는 필요 수량 등록이며 실구매 수량은 보유품과 대조한다. 기존 175,000원 비용 배정 안에 포함된 항목을 상세화한 것이므로 같은 항목을 다시 더하지 않는다.

| BOM ID | 필요 수량 | 요구 / 선정 상태 | 가격·배송 |
|---|---:|---|---|
| CONN-01 | 1 | GCT RFPC-SMA28-F, 헤드용 표준 SMA female; PCB footprint 확인, stack-up/실물 끼움 미확인 | BOM 0.6과 G3 패키지의 조회 가격 참조; 한국 실견적 미확정 |
| CONN-02 | 2 | F-A 양끝 SMA female; 귀환 프레임에 고정 가능한 방식 | MPN·가격 미확정 |
| LOAD-01 | 최소 1개 재사용 | SMA male RF 50 Ω; RF OFF 후 헤드/지그 OUT 사이 이동. 유효 대역 확인 | 사용자 보유/별도 구매 반영, 신규 0. 성별/개체 사양 대기 |
| CAB-02 | 총 2 | VNA용 50 Ω SMA male–male; CAB-P1/P2 길이·개체 ID 기록 | 보유1 + 신규1, 최신 BOM 0.12 가격 적용 |
| ADAPT-CAL-01 | 조건부 1 | **BNC female–SMA female**, 901-9173 규격 확인 후보. CAB-01의 BNC male과 CAB-P2의 SMA male 사이 | 가격/배송 미조회. 개체 S-parameter 또는 BNC 기준면 교정 필요 |
| ATT-01 | 1 후보 | Mini-Circuits VAT-10A+, SMA male/female, DC~6 GHz, 10 dB. 실제 펄스·체인 검증 필요 | 2026-09-16 제조사 표시 1개 USD 21.07, 재고 >1,000; 한국 배송/세금 미확정 |
| PROT-01 | 구성 미확정 | RF 보호부. 입력 정격·펄스원·잔류전압·왜곡 검증 후 결정 | 기존 보호 비용 배정 30,000원 안에서 충족 여부 미검증 |
| CAL-KIT-01 | 보유 확인 | SMA female SOL 표준 및 모델값 | 신규 구매 필요 시 예산 재계산 |
| CAL-THRU-01 | 조건부 1 | SMA female–female THRU와 검증된 모델 | 키트 포함이면 중복 구매 제외 |
| CAL-BNC-01 | 선택 경로별 | BNC male SOL/혼합 THRU 모델 또는 어댑터 2포트 특성 확보 | 보유/대여 우선, 가격 미조회. 상세 경로는 전체 절차 검토 3절 |

코어는 **물리적 반쪽 2개**가 필요하다. 확보한 제조사 도면/STEP은 반쪽 형상과 mate-pair 시험 조건을 확인해 주지만 판매처의 `1개`가 반쪽인지 한 쌍인지 확정해 주지 않는다. 주문 전 판매 단위 확인은 남긴다. 현재 가격 기록은 2026-09-15 조회분이며 2026-09-16의 새 실견적으로 표시하지 않는다.

CAB-01 완제품 SMA–BNC 1개는 그대로 유지한다. 오실로 연결용으로 같은 기능의 어댑터를 중복 구매하지 않는다. ADAPT-CAL-01은 VNA 기준면 처리를 위한 별도 검토다.

[연결 리허설](END_TO_END_REHEARSAL.md)에서 종전 어댑터 성별 오류를 수정했다. 일반 SMA 교정 상태에서 ADAPT를 떼고 스코프에 연결하면 같은 전달함수가 아니다. BNC 기준면과 스코프 응답 검증 전에는 전압/상대 관측으로 한정한다. 감쇠기 직접 체결은 하우징 공간/PCB 하중도 확인해야 한다.

## 3. 남은 입력과 진행 가능한 일

실물 코어/권선 실험 전에도 부품별 제조사 도면·footprint 검토와 견적 갱신은 가능하다. 다만 **제작에 쓰는 커넥터/PCB 고정, 최종 구매 수량, 현장 보호 설계의 확정**은 실물 치수·보유 부속품·출력 수준 확인을 반영해야 한다. 이번 작업에서는 구매·장비 연결·현장 작업을 실행하지 않았다.

근거: [백서](RF_CURRENT_PROBE_WHITEPAPER.md) 9·13·18절, [BOM](BOM_DRAFT.md), [원 MSO4054 입력 사양](https://download.tek.com/manual/077024701Rev_A_web.pdf), [LibreVNA 공식 매뉴얼](https://github.com/jankae/LibreVNA/blob/master/Documentation/UserManual/manual.tex). 제품 미선정 항목에 제조사 성능·가격을 추정해 넣지 않았다.

## 4. 케이블 비교와 비용 영향 — 2026-09-16

| 후보 / 수량 1개 | 근거 | 표시 가격·재고 | 판단 |
|---|---|---|---|
| SparkFun CAB-27480 / 공급사 BCCA3788, 1 m | [브랜드 제품 페이지](https://www.sparkfun.com/sma-to-bnc-male-cable-rg316-1m.html), [연결된 공급사 도면](references/CAB27480_linked_drawing.pdf): SMA male–BNC male, RG316, 1000±20 mm, 케이블 외경 2.5±0.1 mm | [DigiKey Korea](https://www.digikey.kr/ko/products/detail/sparkfun-electronics/27480/26266456): 15,643원, 재고 428. 배송·세금 확정 전. 제조사 직판 USD 9.95도 확인 | 예산용 우선 시험 후보. 유통사 50 Ω 표시는 있으나 도면에 조립품 정합/대역 보증은 없음. T09·부품 식별 후 사용 범위 확정 |
| Amphenol RF 095-850-250M100, 1 m | [제조사](https://www.amphenolrf.com/en-us/part/095-850-250m100/8494/): SMA/BNC male, 50 Ω, RG316DS, 최대 6 GHz | [DigiKey 미국](https://www.digikey.com/en/products/detail/amphenol-rf/095-850-250M100/12751788) 표시 USD 45.15, 재고 63. 한국 배송/세금 미확정 | 사양은 명확하나 비용이 높아 첫 선택에서 보류 |
| Mini-Circuits VAT-10A+ | [제조사 판매 페이지](https://www.minicircuits.com/WebStore/dashboard.html?model=VAT-10A%2B), 확보한 Rev.C 자료 | 1개 USD 21.07, 재고 >1,000, 배송·세금 미확정 | 감쇠기 비교 후보. 단종 경로의 구형 VAT-10+ USD 11.95 표를 현재 견적으로 쓰지 않음 |

SparkFun 페이지 Features의 `RG136`은 제목/공급사 도면 `RG316`과 다르다. 도면의 RG316을 우선하며 판매 실물의 케이블 마킹은 확인한다. TE 2467938-1 50 Ω SMA 부하도 후보로 찾았으나 상세 도면/개체 정합·수량 가격 검토 전이라 LOAD-01의 확정품으로 승격하지 않았다.

**CALCULATED 비용 시나리오:** 기존 175,000원 배정에서 코어 35,000→30,730원, 케이블 15,000→17,207원, 보호/감쇠 30,000→감쇠기 37,083원+보호부 미확정 예비비 15,000원으로 치환하면 약 **195,020원**이다. USD 항목은 비교를 위한 가정 환율 1,600원/USD 및 1.10 계수, 국내 케이블도 세금 포함 여부 미확정으로 1.10 계수를 임시 적용했다. 실제 환율·세금·통합 배송 견적이 아니며 중복 과세/누락을 최종 견적에서 정리해야 한다. 기존 배송/재작업 배정은 유지했다.

20만 원 상한 여유가 약 5천 원에 불과하고 보호부 15,000원 배정은 제품 견적이 아니다. 따라서 **예산 충족 미확정**이며, 현장용 구매 목록을 승인 가능한 상태로 보고하지 않는다. 보유 동축/부하/감쇠기를 확인하면 불필요한 신규 구매를 줄일 수 있다.

후속 절차 검토에서 THRU/BNC 기준면 모델의 필요 수량을 구체화했다. 이 신규 비용은 위 시나리오의 확정 포함 항목이 아니다. 필요한 교정 기준을 보유하지 않았을 때 저가의 무모델 부품으로 정확도를 가정하지 말고, 보유/대여·외부 교정 또는 상대 특성화까지의 범위로 조정한다.
