ckh7488/rf_current_probe/viewer_A05/audit_sources/NEXT_CHECKS.md

> **이력 문서 — 2026-09-22 분류.** 초기 A02/A11/A12 당시 기록이며 현재 제작·사용 지시가 아니다. 현행은 Head A04 / Fixture A03 / A14·C07이고 프로젝트 `docs/DOCUMENT_INDEX.md`를 따른다.

# 다음 확인 — 필요한 순서

지금 추가 질문에 답해야 작업 기록을 읽을 수 있는 구조가 아니다. 아래 순서로 실제 부품과 시제품을 확인하면 된다. 전 항목 미실행이며 구매 승인 목록도 아니다.

1. **구매품 대조**: 코어 반쪽2개, 노브/사각너트/팔로워/나일론 체결품의 제조사 번호·외형·수량을 `hardware_receipt.csv`에 기록. 회사 M3–M5는 길이·머리·너트 외형이 맞는 위치에만 재사용. M6 구동부는 별도다.
2. **C04 1개 시험**: 출력 방향·실측 가이드/홈/벽 치수, 공구 접근,20회 왕복, Ø6/12/20 기준봉 중심 위치와 닫힘 반복 편차를 `clamp_trial.csv` 및 사진으로 저장. 목표 중심 편차≤1 mm, 걸림·외피 자국 없음. 목표일 뿐 현재 성적이 아니다.
3. **A10 코어 보유/뚜껑**: 실제 코어 A/B/C/D/E와 맞댐면을 기록. 고정바 장착·기울임·약한 취급에서 이탈/회전·권선 눌림 검사. 닫힘 힘, 초기/24시간/7일 보관 뒤 힘,20회 이상 개폐 후 틈을 `core_closure.csv`에 기록. 파괴·피로시험 합격으로 확대하지 않는다.
4. **탁상 통합**: 코어 중심84 mm와 앞뒤 클램프 중심, 바닥 휨, 교정 PCB 장착/제거, SMA 플러그/동축/공구 접근을 사진과 `assembly_trial.csv`에 기록. Ø26은 별도 평가.
5. **T01/T02**: DMM 연결 확인 후 VNA SOLT 기준면/표준 모델/케이블 ID를 저장. 낮은 출력부터 제조사 입력 정격 안에서 시작. `fixture_bare.s2p`, `fixture_head_loaded.s2p`와 VNA 설정·교정 상태를 저장. DMM 도통 확인은 내전압 시험이 아니다.
6. **T03–T10**: RF OFF 후 P2/로드 이동. `transfer_level_*.s2p`, `reclose_01..05.s2p`, `position_*.s2p`, `cancellation_*.s2p`, `pickup_*.s2p`, `clamp_layout_*.s2p` 저장. 각 메타데이터에 동일 일차 전류 확인, 기준면과 체인 ID를 기록. 측정으로 확인된 대역만 유효 표시.
7. **스코프**: BNC 기준면과 채널50 Ω 응답 확인 후 알려진 저레벨 CW를 VNA 결과와 비교. `scope_cw.csv`, 원본 Tek 저장파일, 장비 설정, 수신기 응답을 보존. 광대역 전류 복원은 별도 구현·검증 항목이다.
8. **현장 전**: PROT-01 실제 보호부와 제한된 펄스 시험, 잔류전압·회복·왜곡·입력 정격을 확인. 감쇠기만으로 보호를 완료했다고 처리하지 않는다.

1~4는 기계 시제품 단계,5~7은 정량 계측 단계,8은 현장 사용 단계다. 각 단계의 미확인 항목을 다음 단계의 합격 사실로 넘기지 않는다.
