ckh7488/rf_current_probe/viewer_A05/audit_sources/nut_access_20260918/DFM_BASIS.md

# 너트 조립·제작성 재검토 기준

2026-09-18 · 설계 계산과 실물 검증을 구분한다.

## 이번 변경의 합격 조건

- 반복 개폐하는 나사를 완전히 제거해도 너트가 빠져나갈 열린 경로가 없어야 한다.
- 너트는 눈에 보이는 입구로 넣고, 조일 때 별도 스패너로 붙잡지 않도록 한다.
- 체결 하중은 본체의 넓은 받침 면으로 전달한다. 탈락 방지 덮개의 걸림턱을 체결 반력 받침으로 쓰지 않는다.
- 덮개를 고정하려고 더 작은 너트를 추가하는 방식은 가능한 피한다.
- 너트·덮개·나사 삽입 순서와 제거 순서를 따로 검사한다. 조립 완료 상태의 간섭 검사만으로 조립 가능을 판정하지 않는다.
- 고정용 너트의 조립 여유와 M6 구동너트의 방향 전환 유격을 구분한다. 구동너트의 여유는 과도한 조임으로 없애지 않는다.
- 새 형상은 기존 권선·코어 접촉면·PCB 신호 경로·금속 배치를 보존하는지 대조한다.

## 제조사 기준

검토 재료는 **JLC3DP 3301PA, SLS 나일론**이다. 아래 값으로 다른 수지·FDM까지 승인하지 않는다.

| 기준 | 제조사 자료 | 이번 사용 방법 |
|---|---|---|
| 치수 허용오차 | 100 mm 이내 ±0.3 mm, 그 이상 ±0.4% | 중요 포켓의 작은 쪽/큰 쪽 치수 민감도를 함께 계산. 표면마다 독립 ±0.3 mm를 적용하는 경우는 보수적인 가정으로 명시 |
| 벽 두께 | 재료 페이지 >1.0 mm, 종합 안내는 큰 나일론 부품 약2 mm | 긴/큰 부품에는 단순 1 mm 최소값만 사용하지 않음 |
| 돌출·위치결정·걸림 구조 | 권장 >1.5 mm | 새 걸림부는 2 mm 이상을 우선하고 뿌리·끝 모서리의 잔여 박벽을 따로 검사 |
| 조립/이동 여유 | 조립0.2–0.4 mm, 이동0.6 mm | 일반 권고이며 모든 형상에서 맞는다는 보장이 아님. 실제 치수 오차와 누적 공차를 별도 검토 |
| 출력 크기 | 350 × 350 × 400 mm | 각 STL의 외형을 대조 |

출처: [3301PA 재료](https://jlc3dp.com/help/article/3301pa-nylon), [JLC3DP 설계 지침](https://jlc3dp.com/help/article/3d-printing-design-guideline). 2026-09-18 조회.

## 검사와 한계

CAD 유효성·단일 솔리드, STL 폐곡면·양의 체적, 명목 조립/동작 간섭, 공구 접근, 포켓 삽입 및 회전 방지, 체결 면 접촉과 출력 두께 표본을 기록한다. 새 유연 걸림부는 변형을 요구하는 정도와 간단한 보 계산의 가정을 기록한다.

메시의 표본 두께 검사는 전체 최소 두께의 증명이 아니다. 이상적인 보 계산은 실제 출력물의 걸림 힘·피로 수명 검증이 아니다. 실제 나사·너트 치수, 분말 제거, 표면 거칠기, 수축·뒤틀림, 반복 체결과 RF 시험은 실물에서 확인해야 한다. 제조업체 DFM 승인을 대신하지 않는다.
