ckh7488/rf_current_probe/docs/OPEN_DECISIONS.md

# 남은 조건과 담당 단계

**9/29 업체 심사 보완(DEC-072):** VNA 공식 임피던스 양식 누락을 보완해 Molex Y25→Y28, LLC Y26→Y29로 재접수했다(Reviewing, 각5장/$54.02). Y27은 완성 양식·ZIP을 담당자에게 회신하고 반영을 기다린다. RF Y23/Y24의 SMA 치수·제조 비고 설명도 회신했다. A18 앞/뒤 베이스는 Approved, 중앙은 Reviewing이다. 형상·배선·수량·가격은 그대로이며 두 주문 합계442.95달러(쿠폰 전)다. 수동 CAM 검토·결제·생산승인·실물/RF 검증은 남아 있다. 앞베이스 자동 경고의 상세 위치/휨 보증을 업체 승인 표시만으로 입증하지 않는다. [보완 근거·파일·현재 상태](../reviews/jlc_impedance_resubmission_20260929/REPORT.md). 아래 이전 날짜의 접수번호·상태는 당시 이력이다.

**9/28 구매 미확정 해소:** 코어는 반쪽2개=한쌍으로 주문2개, 어깨볼트는 LIXIU Ø5×20/M4 5개팩7,130원 무료배송, 사각너트 M4/M6 두 팩은 배송포함9,900원으로 선정했다. 발룬10개·SMA10개·RJ45 8개 예비수량 유지. A18 베이스3종은 JLC 제출 완료/Reviewing, C10은 Approved. RF SMA R2 Y23/Y24 및 VNA B-LM1/B-RF3/B-TE3 Y25/Y26/Y27 접수 완료/Reviewing이며 대응 구형5종만 취소했다. 현재 두 주문 합계442.95달러(쿠폰 전)다. [판매단위·가격·쿠폰 근거](../reviews/procurement_closure_20260928/REPORT.md). 실물/RF 검증과 생산승인·결제는 하지 않았다.

**9/28 후속 국부 보강(DEC-063): 다음 제작 검토본은 Head A04 SMA R2 + Fixture A03 SMA R2 + A17/C10이다.** C09 가이드 뒤 받침과R2.5/R0.75 뿌리만 보강해 프레임 P06 한 종류 두 개를 변경했다. 같은27.5 MPa 기준에서 최대24.084 MPa, 저장 CAD·가동/공구·재생성 검사를 통과했다(CALCULATED/SIMULATED). 재질·총15종20개·체결품은 유지한다. [수정·검증 기록](../reviews/c10_guide_fix_20260928/REPORT.md), [현재 파일 선택](3D_PRINT_RELEASE_A17_C10.md). 아래 A16/C09 동결·HOLD·제작 선택은 이전 버전 이력이며 원본 판정은 소급 변경하지 않는다. 실물/RF T01–T12는 미검증, 업체 제출·생산승인 전이다. 현재 후보 확인: `python reviews/c10_guide_fix_20260928/verify_candidate.py --mutations`.

**3D 제작 확정 · 2026-09-28:** **A16/C09**, 전체15종20개, **9600 Resin8종11개 + 3201PA-F Nylon7종9개**로 고정한다. 기존 주문은4종5개만 교체한다. 형상·재질 선택·제출 ZIP·가격 구분은 [3D 최종 제작 기준](3D_PRINT_RELEASE_A16_C09.md)을 우선한다. 새4종 견적/업체 제조심사는 남아 있으며 기존$185.88은 이전 형상 견적이다.

**9/28 통합 재검수:** 다음 제작 검토 묶음은 **Head A04 SMA R2 + Fixture A03 SMA R2 + A16/C09 출력15종20개**다. 기존 업체 접수 A14/C07·구형 PCB와 구분한다. [새 전수검수와 두 질문의 판정](../reviews/fresh_system_audit_20260928/REPORT.md), [정확한 제작 파일](../reviews/fresh_system_audit_20260928/BUILD_CONFIGURATION.md)을 따른다. 설계·파일 검사 통과와 실물 정상동작 확인은 별개이며 T01–T12 실측은 없다.

[앞선9/28 전수 재검수](../reviews/full_reinspection_20260928/REPORT.md)는 당시 원본과 업체 기록의 적용 범위를 정리한다. 후속 R2/A16 파일은 위 통합 재검수를 따른다. [실물에서 닫을 항목과 원시 파일](../reviews/full_reinspection_20260928/ACCEPTANCE_PLAN.md)을 따른다.

2026-09-28. 설계가 정해지지 않은 것과 실물 확인이 필요한 것을 구분한다. 구경·초기 코어·기구 방식을 사용자에게 다시 선택하도록 묻지 않는다.

| 항목 | 지금까지 정한 것 | 남은 일 / 시점 |
|---|---|---|
| 케이블 구경 | 최대 약20 mm 대상, 공칭26 mm 기준; C10 공칭6–26 mm | 실제 외피 눌림·주변 커넥터·손 공간 / 첫 장착 |
| 코어/권선 | 2644181281 반쪽2개, 5턴 기본·3턴 선택(DEC-055) | 권선 직후 헤드 출력 S11로 자기공진 기록 / 첫 권선. 구매단위는1개=반쪽1개, 주문2개=한쌍으로 종결; 실물 치수·접합·권선 외경은 입고 후 |
| PCB/SMA | Head A04 SMA R2 / Fixture A03 SMA R2를 Y23/Y24로 접수·Reviewing. 구형Y21/Y22 취소. E04 3개(헤드1+지그2) | [SMA R2](../reviews/sma_clearance_r2_20260928/REPORT.md) 중심1.90/접지2.10mm: 중심 여유0.1189mm, 추가 편심 후0.0889mm(CALCULATED). CAM 승인·5핀 삽입·핀 휨·안착·납땜은 생산파일 확인 및 입고 단계. A04/A05 지그는 이력이며 제작하지 않음 |
| A18/C10 |125객체, 출력15종20개. A18베이스3종접수/Reviewing, C10 Approved. 일반M4×60/M6×100렌치볼트 및 선정 어깨볼트 사용 | A18앞베이스 자동Thin walls 경고 위치·제작가능 판정 / JLC심사. 출력휨·코어 압력·나사물림·마찰·반복 풀림 / 첫 조립 |
| 교정지그 판정 | DEC-053: 출력 포트 기준 교정(백서 11.6). 저장 openEMS A03 K100/300/500 MHz 약0.05–0.10/0.41–0.78/0.87–1.65 dB. 1–500 MHz 보정 수행; 주파수별 오차 평가 | 실물 through/전달 S2P·외장 로드 S11·정/역방향 일치·재장착으로 K와 유효 대역 확인 / 첫 벤치 |
| 정밀도 | 출력 기준 ZT로 시작, 조건 불충족 구간은 상대 S21 | T02~T10 실측, 불확도 예산(VNA·로드ΓL·K 폭·재장착·위치·누설) |
| 장비 | LibreVNA 보유, MSO4054는 사용자 잠정 모델 | 명판·HW/FW/GUI·교정키트·입력/수신 응답 / 첫 벤치 |
| 조달/비용 | 구매31행 정확품·수량·포장·가격·배송 선정. 최신PCB5종접수 후 RF218.13+VNA224.82=442.95달러(쿠폰 전). 나일론15/PCB5달러쿠폰 수령 | 최신PCB·A18 업체심사 후 쿠폰 재선택. 보유 준비물 부족분은 사용자 확인, 실제 카드환율·세금은 결제/통관 단계. [가격 근거](../reviews/procurement_closure_20260928/REPORT.md) |
| 현장 보호 | 대상 하네스는 맨 프로브 기본, 첫 측정은 R05 10 dB 확인(강력 권고). R08 해당 없음(DEC-055) | 상용전원·VFD·고전압·서지 현장은 범위 밖; 적용하려면 새로 검토 |
| 로드 반사 기준면 | 외장 로드는 SMA 수, 측정 케이블 끝도 수라 직접 결합 불가 | 별도로 교정된 SMA 암 기준면·male SOL 실제 모델 확인, 1포트/2포트 교정 분리 / 첫 벤치 |
| 분석 코드 | `output_reference` 파일 입력·CW 연동·합성 시험 완료(DEC-058). 기존 모드 유지 | 실제 K 적용성·주파수별 품질/불확도 자료를 채워 첫 실측에 적용 / 첫 벤치 |
| 케이블 진단 | 보유품(M12→RJ45·발룬 보드·금속 테이블·상용/대상 케이블)으로 수행, D04 페라이트만 선택 구매(DEC-055) | 발룬 보드 센터탭 0 Ω 실장 여부 확인(실장 보드 통전 금지), D04 품번 / 케이블 시험 전 |

실물 없이 가능한 검토와 실제 결과는 [문서 전수 조사](../reviews/document_full_audit_20260922/README.md), 현재 판단은 [CURRENT_READINESS](CURRENT_READINESS.md)에 있다. 검토 결과가 있다는 이유로 실측 칸을 채우지 않는다.
