ckh7488/rf_current_probe/docs/atlas/source/bench-checklist.md

> **이력 문서 — 2026-09-22 분류.** 초기 A02/A11/A12 당시 기록이며 현재 제작·사용 지시가 아니다. 최종3D 제조 선택은 [A16/C09 확정 기준](../../3D_PRINT_RELEASE_A16_C09.md)을 따른다. 아래 A14/C07 및 이전 자료는 당시 기록이다.

# PCB RF 전류 프로브 · 첫 벤치 기록

설계·시험 절차 v{{document.revision}} · 평판 {{fixture.revision}} / {{document.date}} / 빈 양식은 측정 결과가 아닙니다.

기준 설계 ID: `{{document.design_id}}`

## 0. 구성 식별

- 측정 ID / 날짜 / 온도:
- 헤드 ID·리비전 / 코어 / 턴 수·방향 / 차폐 / 리드 길이:
- PCB 지그 리비전 / 실제 두께·SMA 납땜·나일론 기둥 조립:
- LibreVNA HW/FW/GUI / 케이블 ID / 부하 ID / 교정키트·Thru 모델:
- 도체 위치 / 잠금 상태 / 사진:

## 1. 무전원 확인

- [ ] 중심 경로 IN–OUT 연속성, 외피·양옆 귀환 연속성 확인.
- [ ] 케이블·50 Ω 부하를 분리한 지그 중심–외피 분리 확인.
- [ ] 코어 안은 중앙 SIG만 통과. 양옆 귀환과 출력 동축은 밖.
- [ ] 일차 도체와 권선의 의도치 않은 도통 없음. 권선 자체의 낮은 DC 저항은 정상일 수 있음.
- [ ] SMA 핀 납땜·네 모서리 고정·코어 접합·권선 끼임·간섭 점검.
- [ ] 기둥/나사 끝 닿음·흔들림·PCB 휨 없음. 케이블 무게 별도 지지.
- [ ] 장비 입력 정격, 제한된 저에너지 소스, 정의된 출력 종단 확인.

## 2. 측정 순서 — 연결 변경은 항상 RF OFF

시작 설정안: 1~100 MHz / {{test.points}}점 linear / {{test.level_dbm}} dBm / IF BW {{test.ifbw_hz}} Hz / 평균 {{test.averages}}회 시작안, 실제 값 기록. 실제 지원값·정격을 우선하고 설정을 저장.

1. 두 테스트 케이블 끝에서 실제 모델·성별이 맞는 O/S/L/T로 지원되는 2포트 교정. 교정 ID·기준면·재접속 확인을 저장.
2. 헤드 없이 P1 → 지그 J1 · IN, 지그 J2 · OUT → P2. 외장 부하 없음. {{test.empty_file}} 저장.
3. RF OFF. 헤드 장착, 헤드 출력 → 외장 50 Ω. P2는 지그 J2 · OUT에 유지. {{test.loaded_file}} 저장.
4. RF OFF. P2 케이블은 지그 J2 · OUT → 헤드 출력으로 이동. 외장 50 Ω는 헤드 → 지그 J2 · OUT으로 이동. 두 종단 확인 후 RF ON.
5. {{test.transfer_file}} 및 같은 이름의 JSON에 설정·체인·위치·시간·교정 ID 저장. 모델 미검증이면 relative.
6. 소스 레벨·재장착 최소 5회·도체 위치·상쇄·직접 픽업·잡음을 비교하고 실패 구간도 보존.

## 3. 환산 전 확인

- [ ] 코어 전류 모델·기준면·출력 부하와 케이블 포함 범위를 확인.
- [ ] 누설·잡음·선형성·반복성·위치 의존성을 주파수별로 평가.
- [ ] 깊은 null·클리핑·미평가·대역 밖은 invalid. 불확도 미평가를 0으로 쓰지 않음.
- [ ] 전류 기준을 입증하지 못하면 ZT와 A를 만들지 않고 상대 S21만 보고.

## 4. 스코프

RF OFF 후 재배선. CW/P1만 출력. 실제 모델의 입력·정격·50 Ω 설정 확인. 원시 전압 파형을 먼저 저장. 체인, LibreVNA CW로 확인한 스코프 체인 응답, 부하가 맞을 때만 단일 주파수 기본파 RMS를 환산. 감쇠 중복 보정 주의. 광대역 펄스 피크를 단일 ZT로 나누지 않음.

## 5. 판정

- 관측한 사실:
- 유효/무효 구간과 근거:
- 실패·변경·중단 사항:
- 다음 한 가지 실험:

현장 적용은 입력 보호·장착·삽입 영향·순 DC 감도 확인 후의 별도 단계입니다. 보호접지·DUT 쉴드를 끊거나 고전압/VFD/서지 시험에 직접 적용하지 않습니다.
