ckh7488/rf_current_probe/docs/atlas/review/a02-design/sma-drawing.png

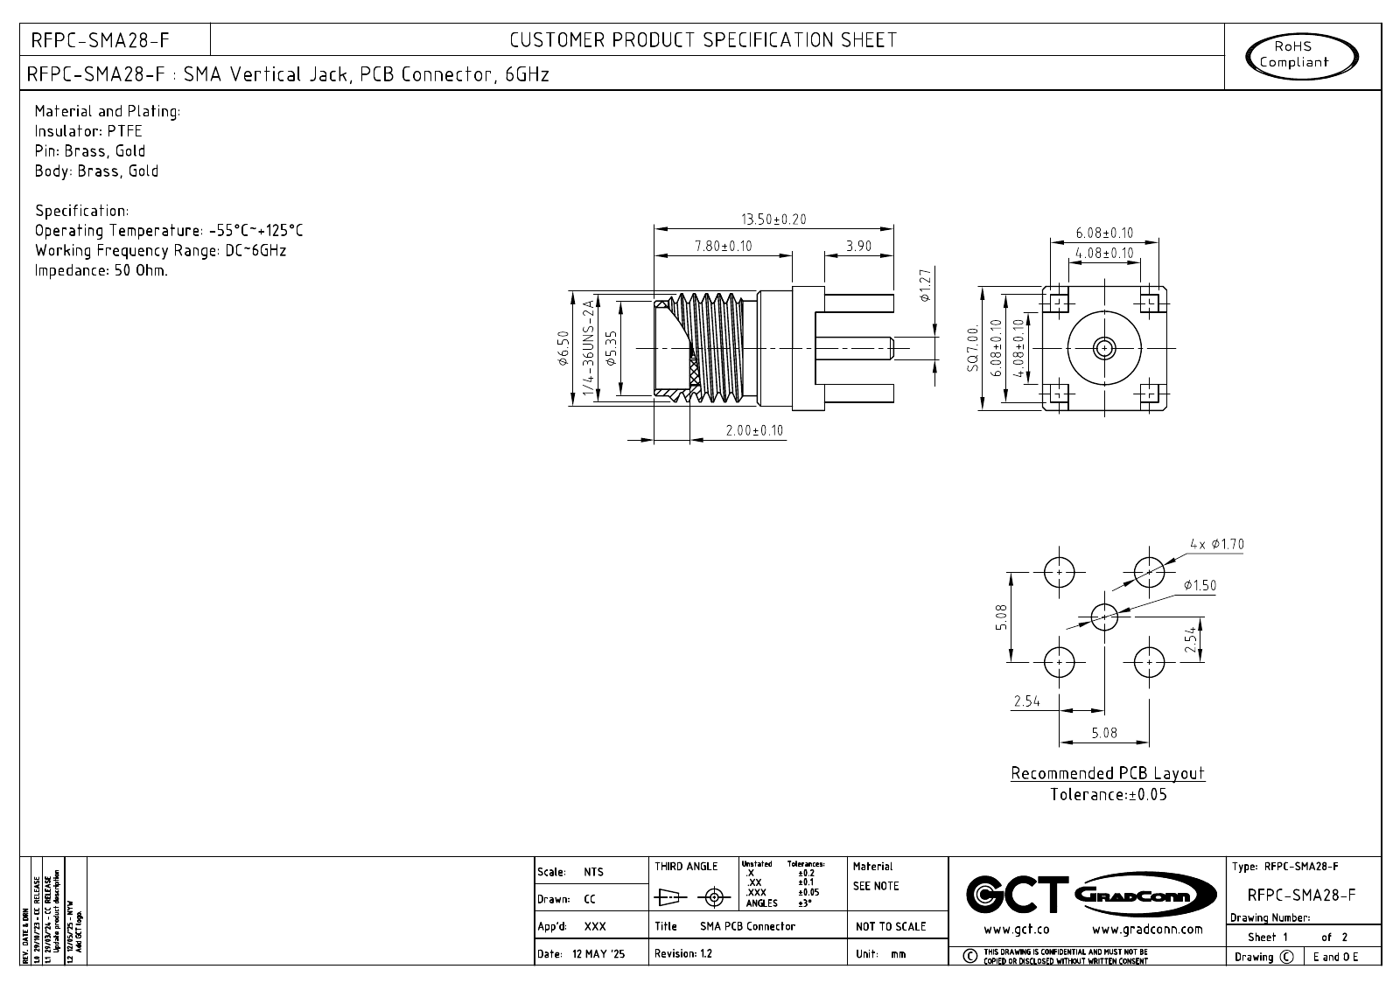
docs/atlas/review/a02-design/sma-drawing.png
