ckh7488/rf_current_probe/docs/atlas/review/a02-design/spacer30.png

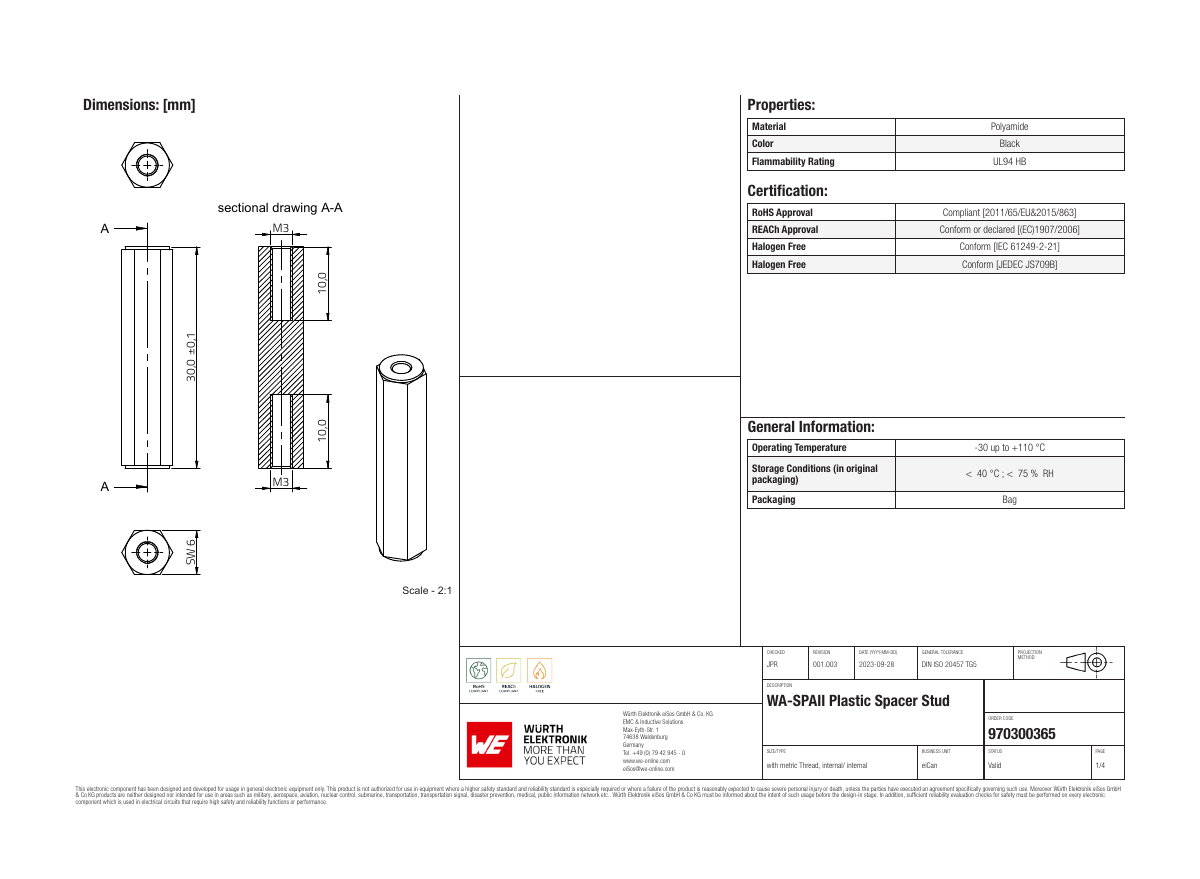
docs/atlas/review/a02-design/spacer30.png
