ckh7488/rf_current_probe/docs/atlas/review/a02-design/spacer35.png

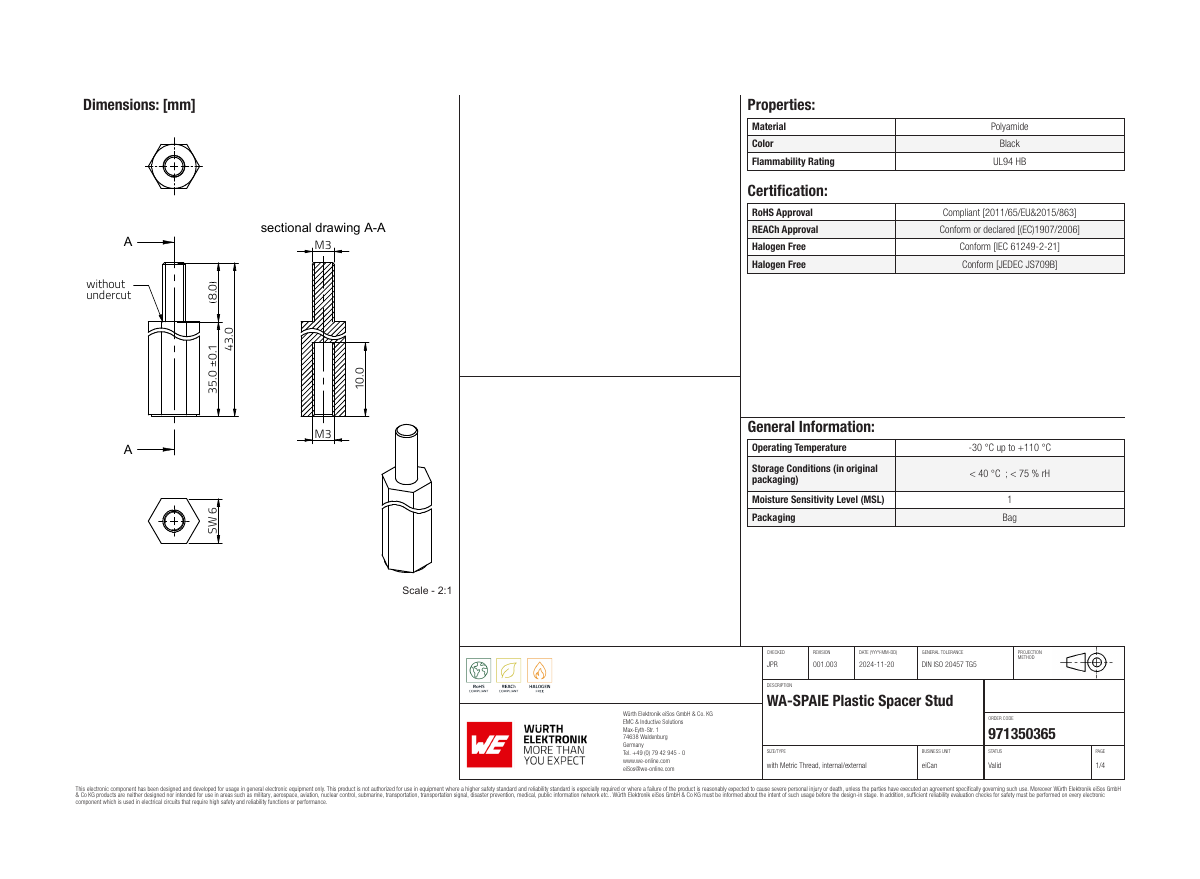
docs/atlas/review/a02-design/spacer35.png
