ckh7488/rf_current_probe/docs/atlas/review/cad-live/camera-front.png

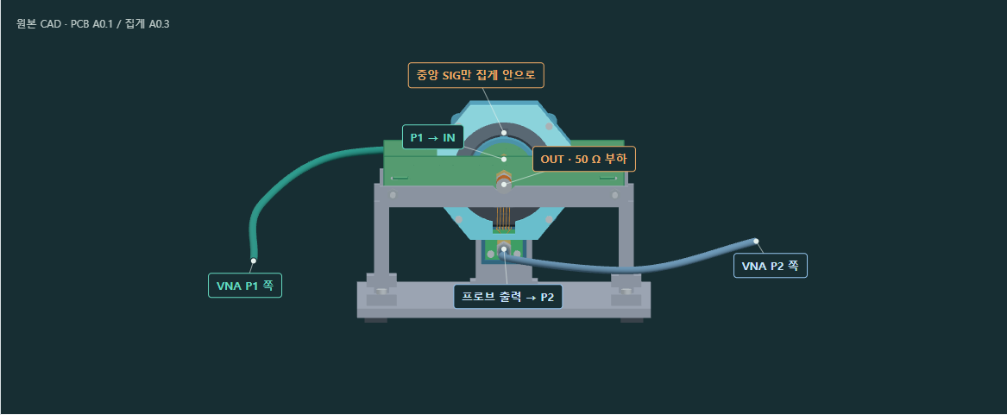
docs/atlas/review/cad-live/camera-front.png
