ckh7488/rf_current_probe/docs/atlas/review/cad-live/camera-top.png

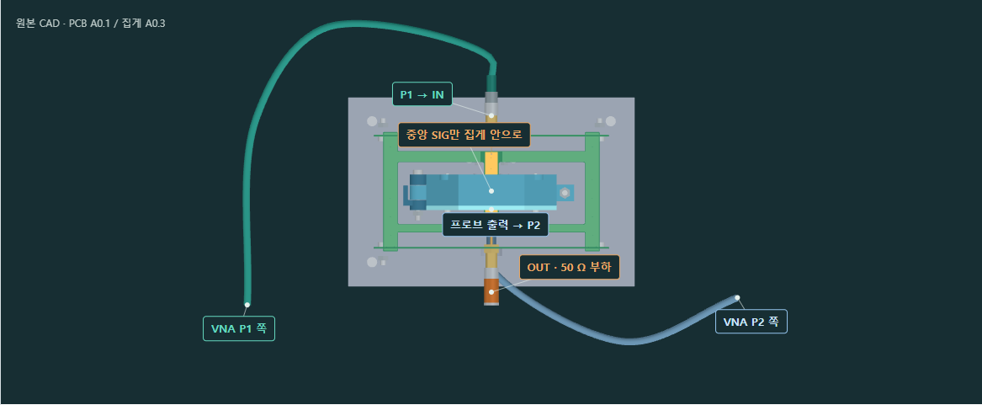
docs/atlas/review/cad-live/camera-top.png
