ckh7488/rf_current_probe/docs/atlas/review/cad-live/path-all.png

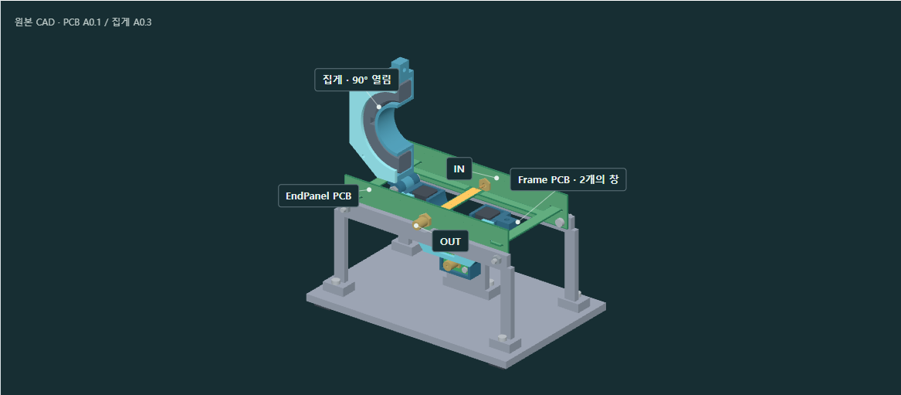
docs/atlas/review/cad-live/path-all.png
