ckh7488/rf_current_probe/docs/atlas/review/cad-live/path-return.png

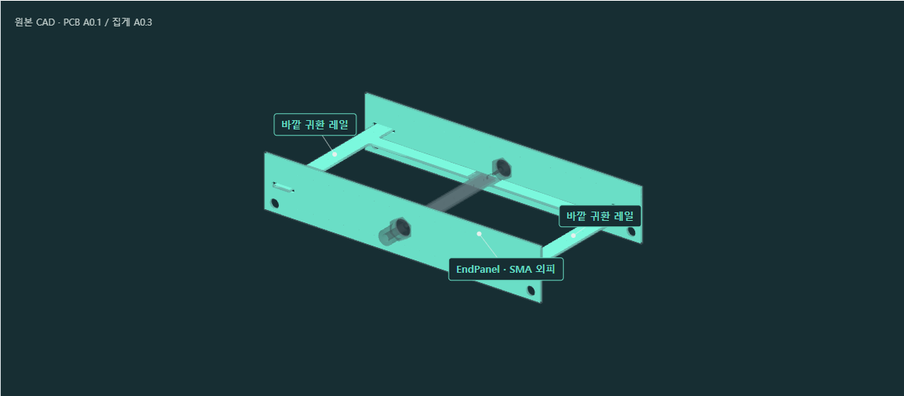
docs/atlas/review/cad-live/path-return.png
