ckh7488/rf_current_probe/docs/atlas/review/cad-live/standard-load.png

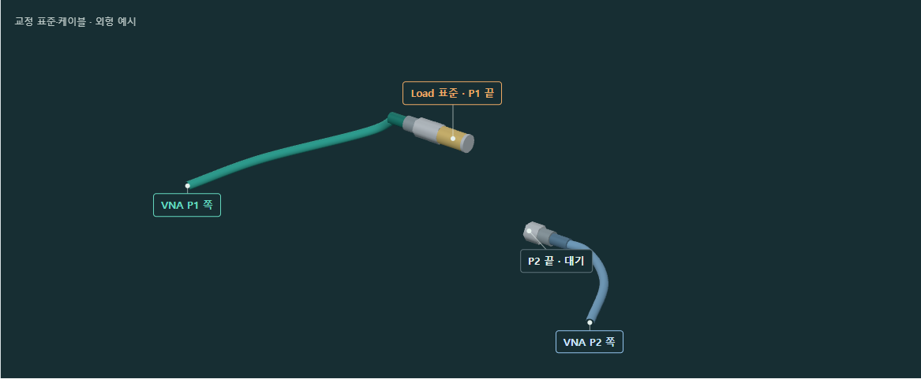
docs/atlas/review/cad-live/standard-load.png
