ckh7488/rf_current_probe/docs/atlas/review/cad-live/structure-320.png

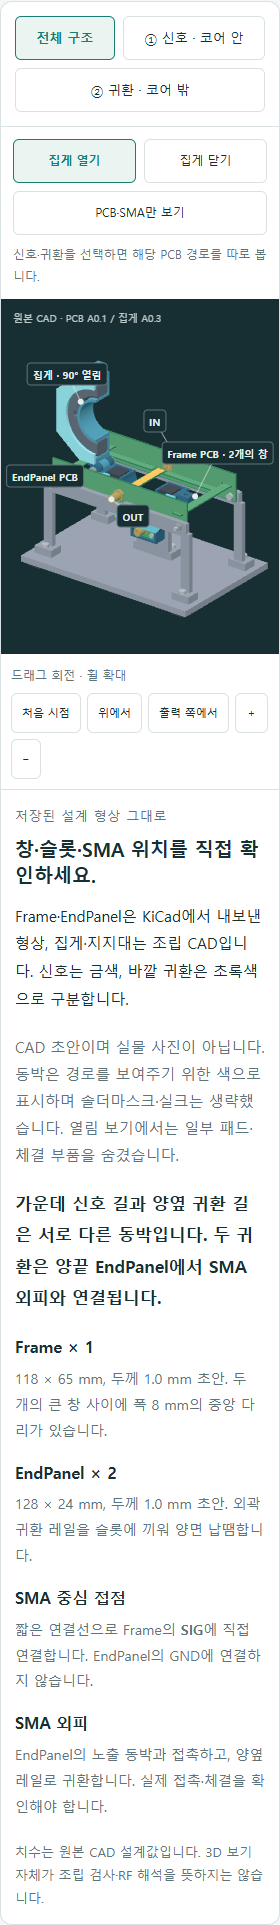
docs/atlas/review/cad-live/structure-320.png
