ckh7488/rf_current_probe/docs/atlas/review/cad-live/structure-closed.png

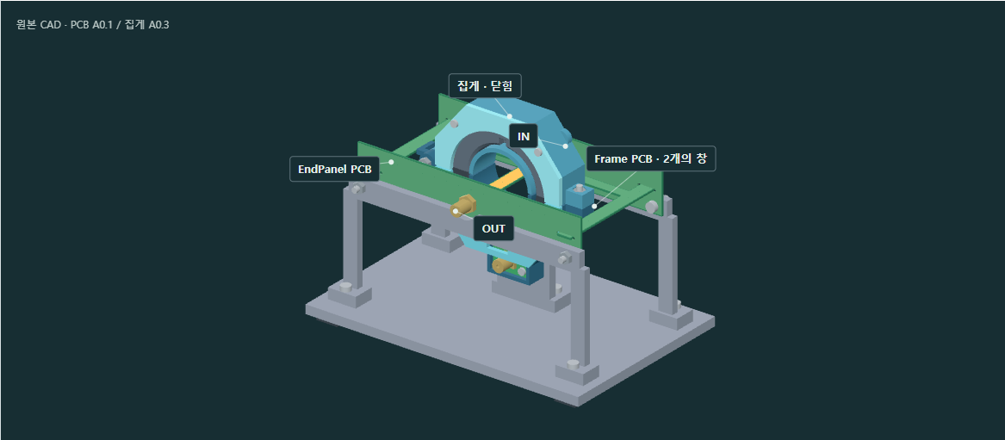
docs/atlas/review/cad-live/structure-closed.png
