ckh7488/rf_current_probe/docs/atlas/review/catalog.png

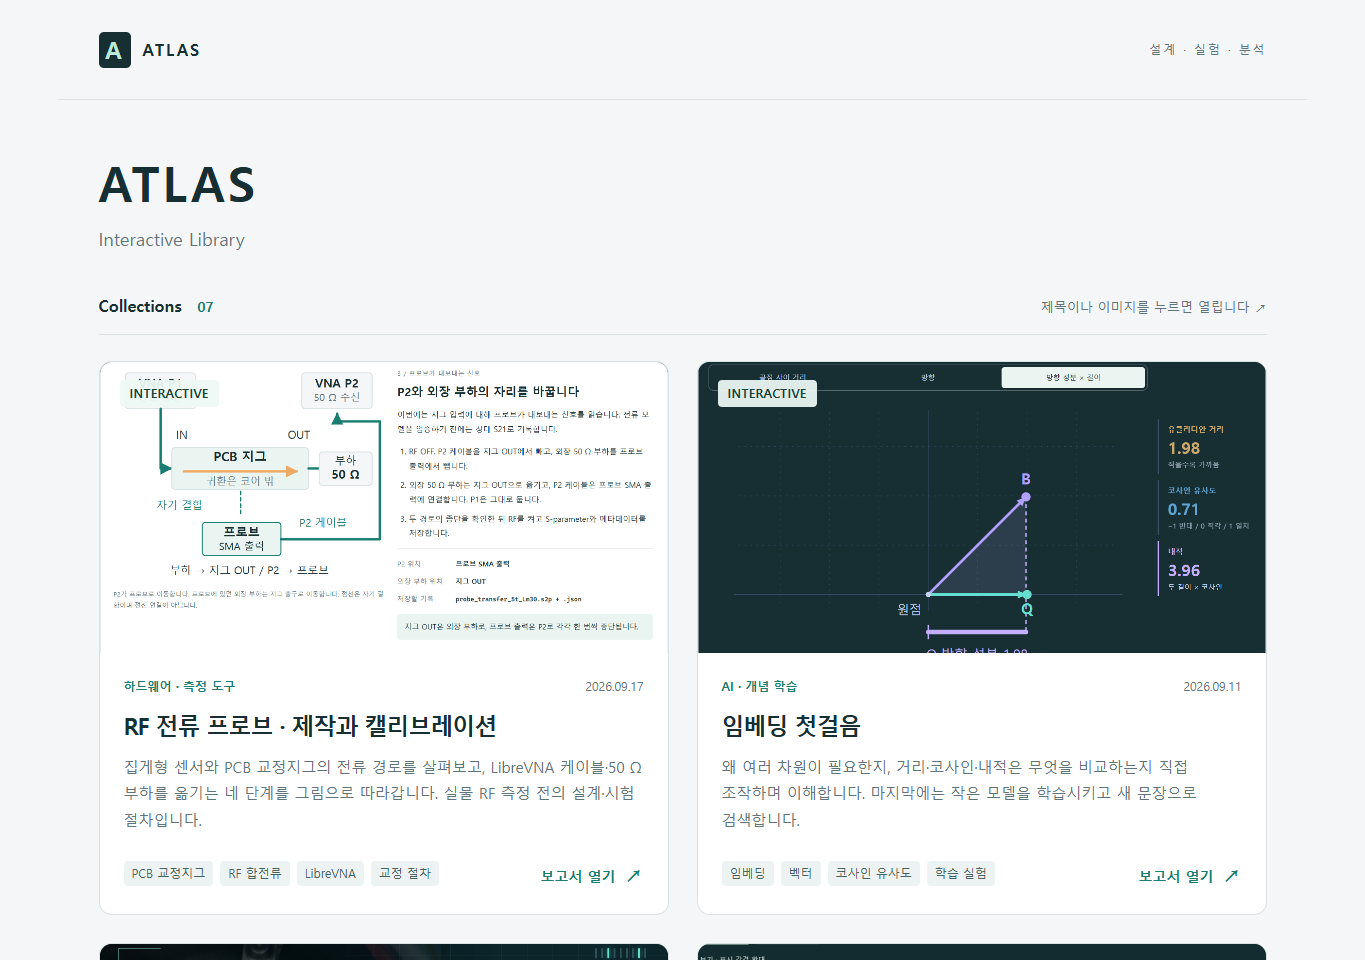
docs/atlas/review/catalog.png
