ckh7488/rf_current_probe/docs/atlas/review/flat-a02/path-return.png

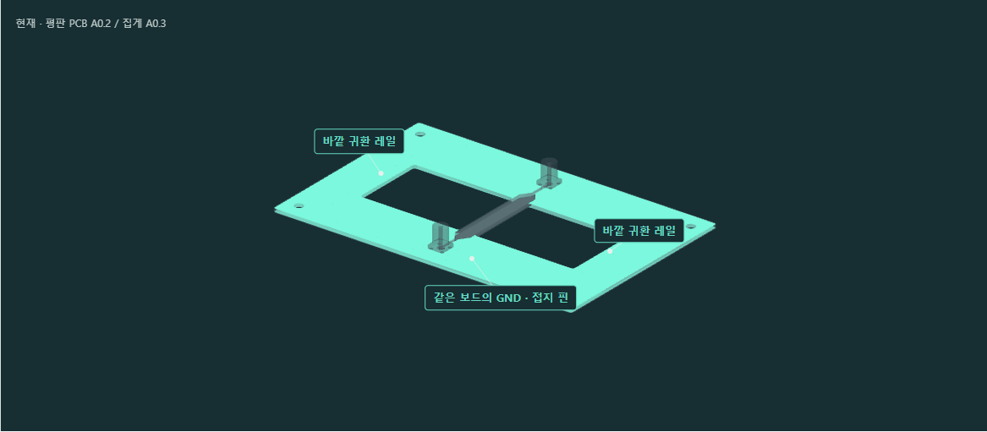
docs/atlas/review/flat-a02/path-return.png
