ckh7488/rf_current_probe/docs/atlas/review/flat-a02/structure-320.png

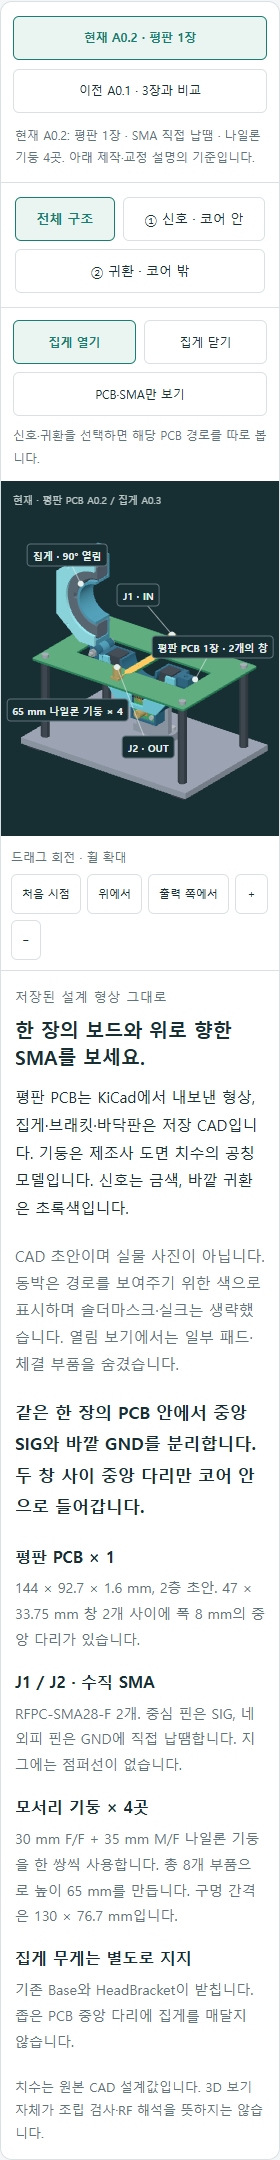
docs/atlas/review/flat-a02/structure-320.png
