ckh7488/rf_current_probe/docs/atlas/review/flat-a02/structure-390.png

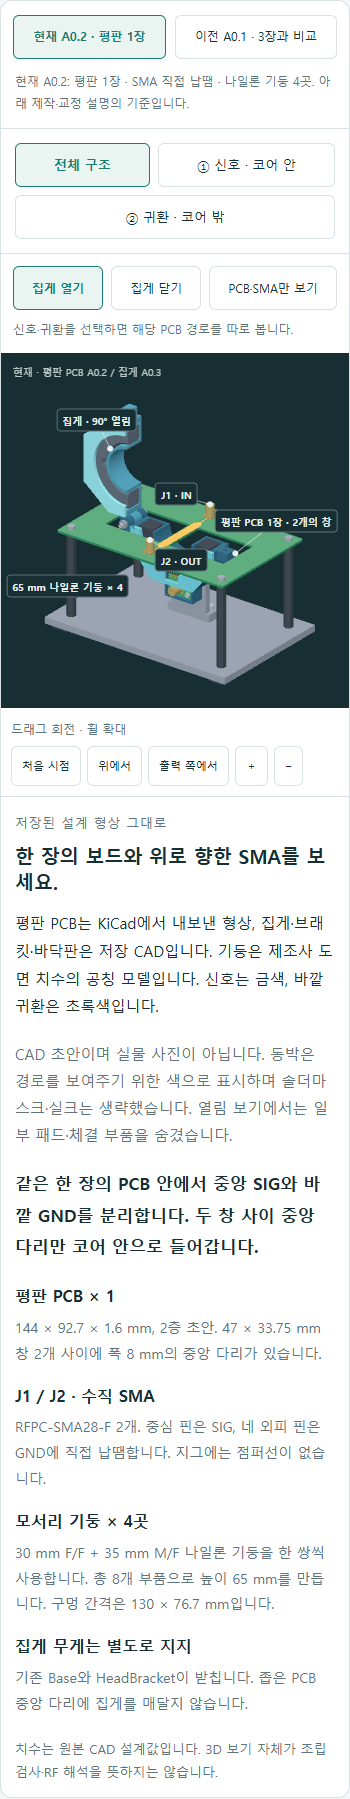
docs/atlas/review/flat-a02/structure-390.png
