ckh7488/rf_current_probe/docs/atlas/review/flat-a02/structure-closed.png

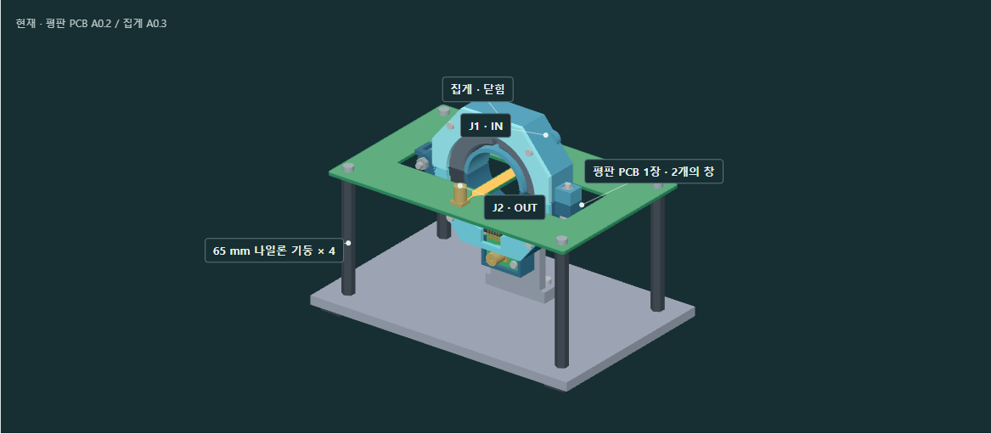
docs/atlas/review/flat-a02/structure-closed.png
