ckh7488/rf_current_probe/docs/atlas/review/live/pcb-cad.png

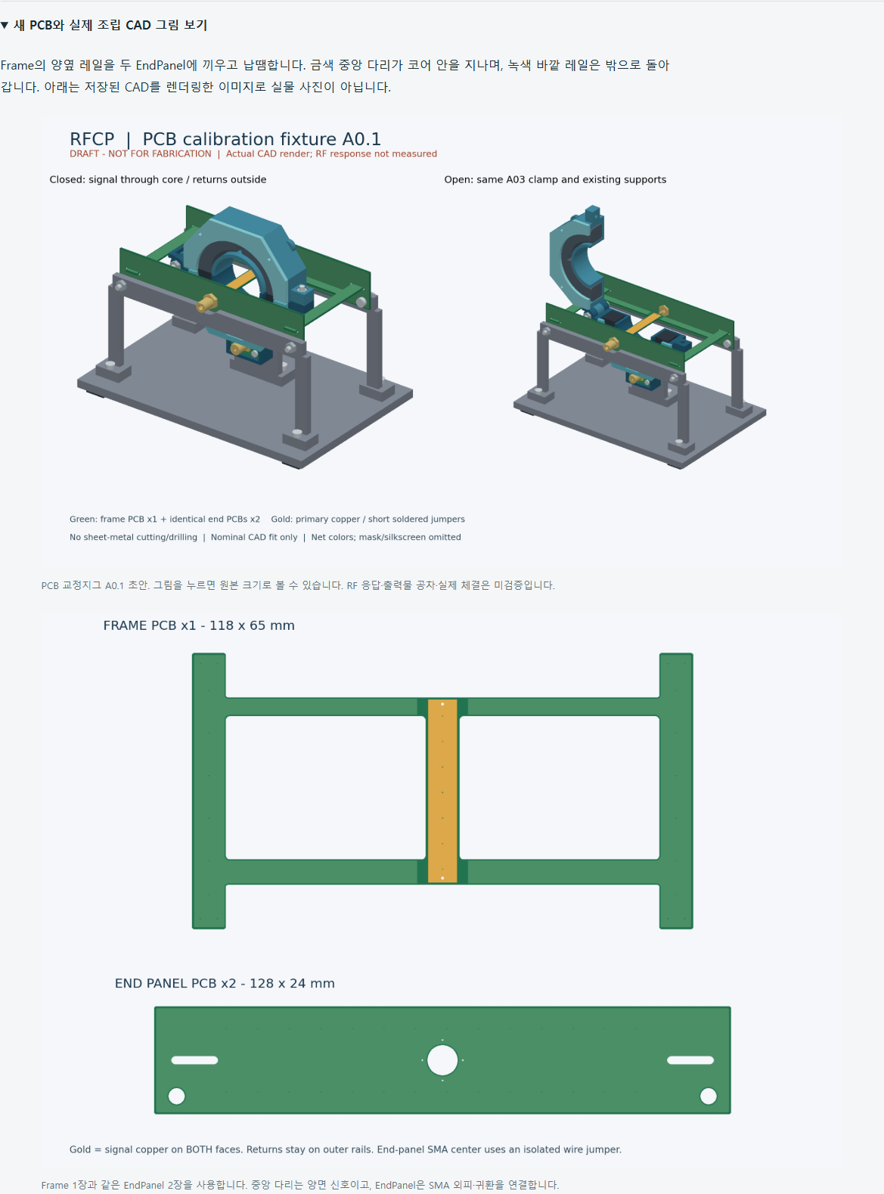
docs/atlas/review/live/pcb-cad.png
