ckh7488/rf_current_probe/docs/atlas/review/live/pcb-current-path.png

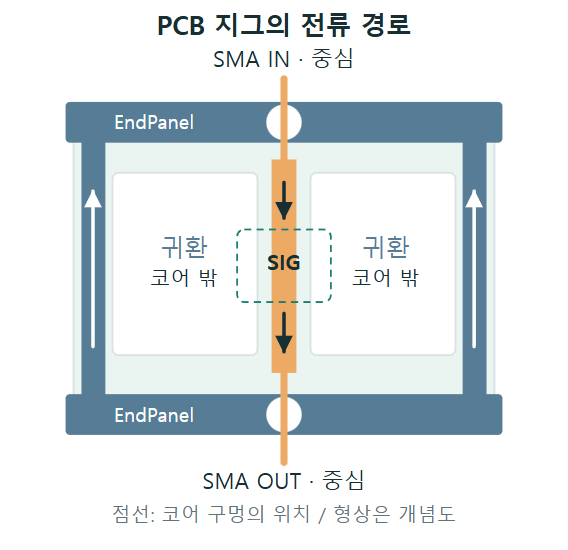
docs/atlas/review/live/pcb-current-path.png
