ckh7488/rf_current_probe/docs/atlas/review/live/topology-320.png

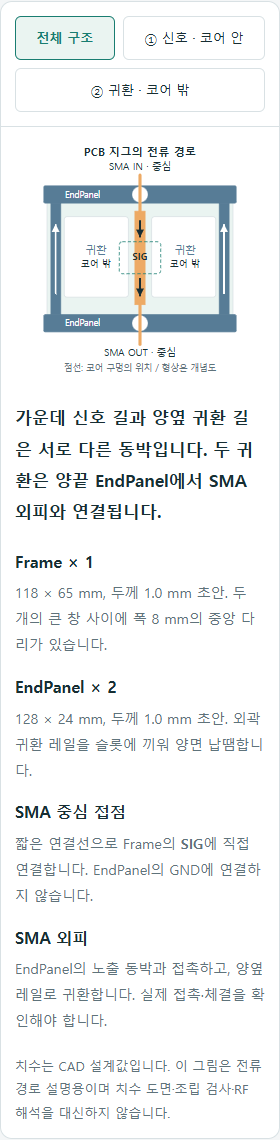
docs/atlas/review/live/topology-320.png
