ckh7488/rf_current_probe/docs/atlas/review/live/topology-desktop.png

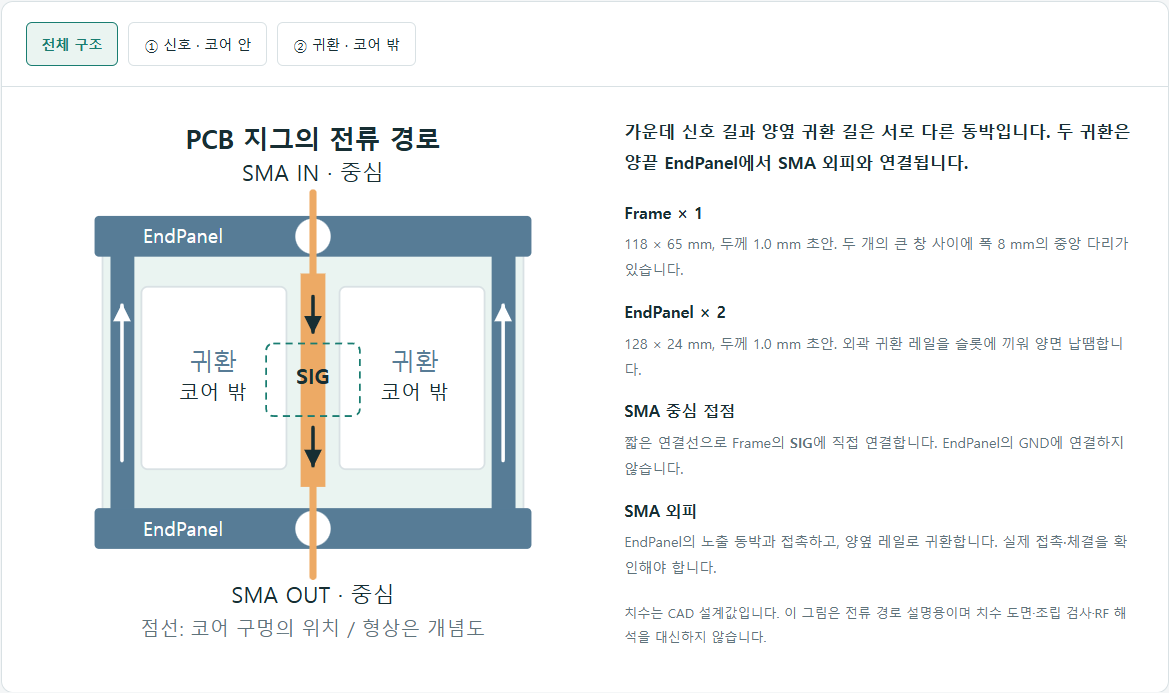
docs/atlas/review/live/topology-desktop.png
