ckh7488/rf_current_probe/docs/atlas/review/split-a02-live/camera-overview.png

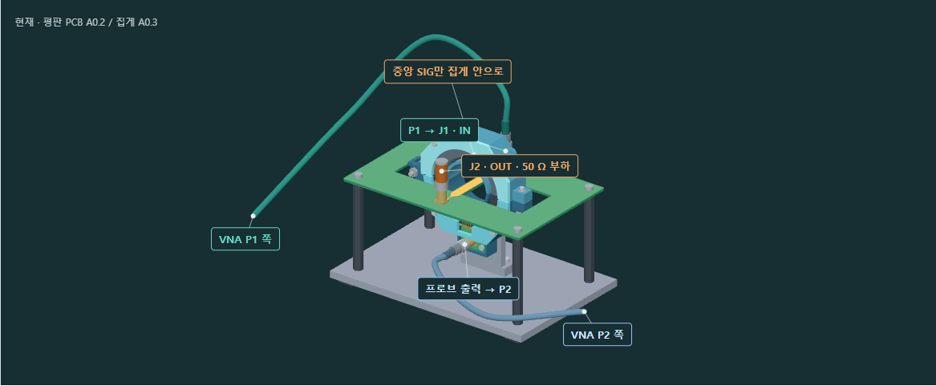
docs/atlas/review/split-a02-live/camera-overview.png
