ckh7488/rf_current_probe/docs/atlas/review/split-a02-live/structure-390.png

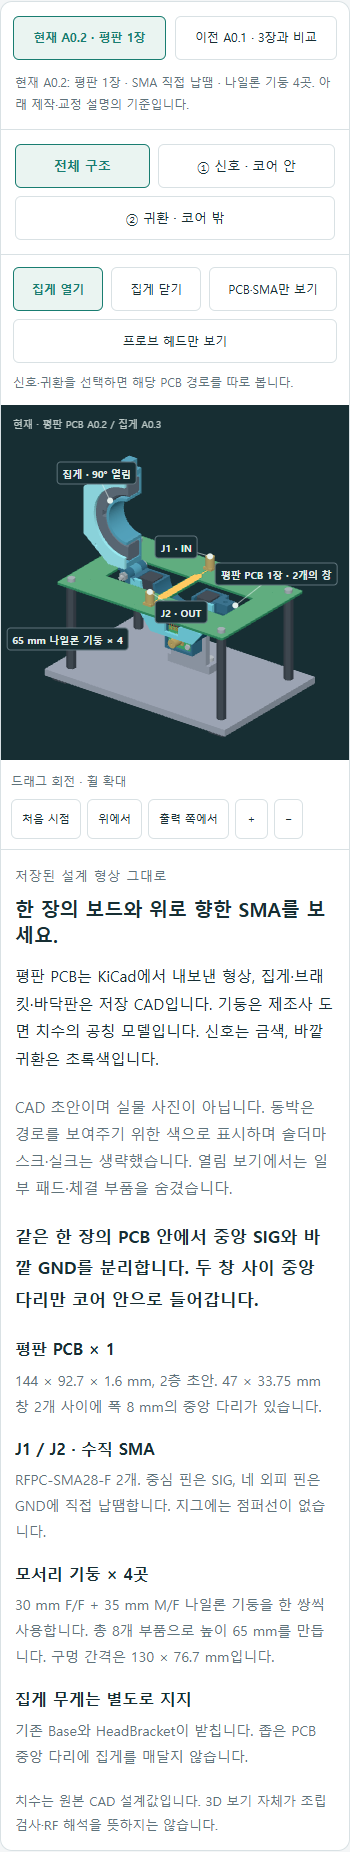
docs/atlas/review/split-a02-live/structure-390.png
