ckh7488/rf_current_probe/docs/atlas/review/split-a02-live/structure-head.png

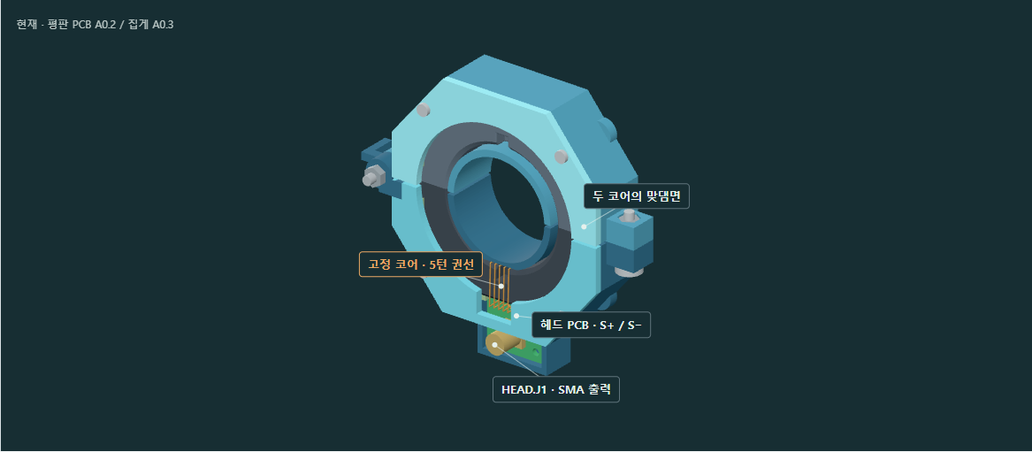
docs/atlas/review/split-a02-live/structure-head.png
