ckh7488/rf_current_probe/docs/references/2644181281_catalog_page1.png

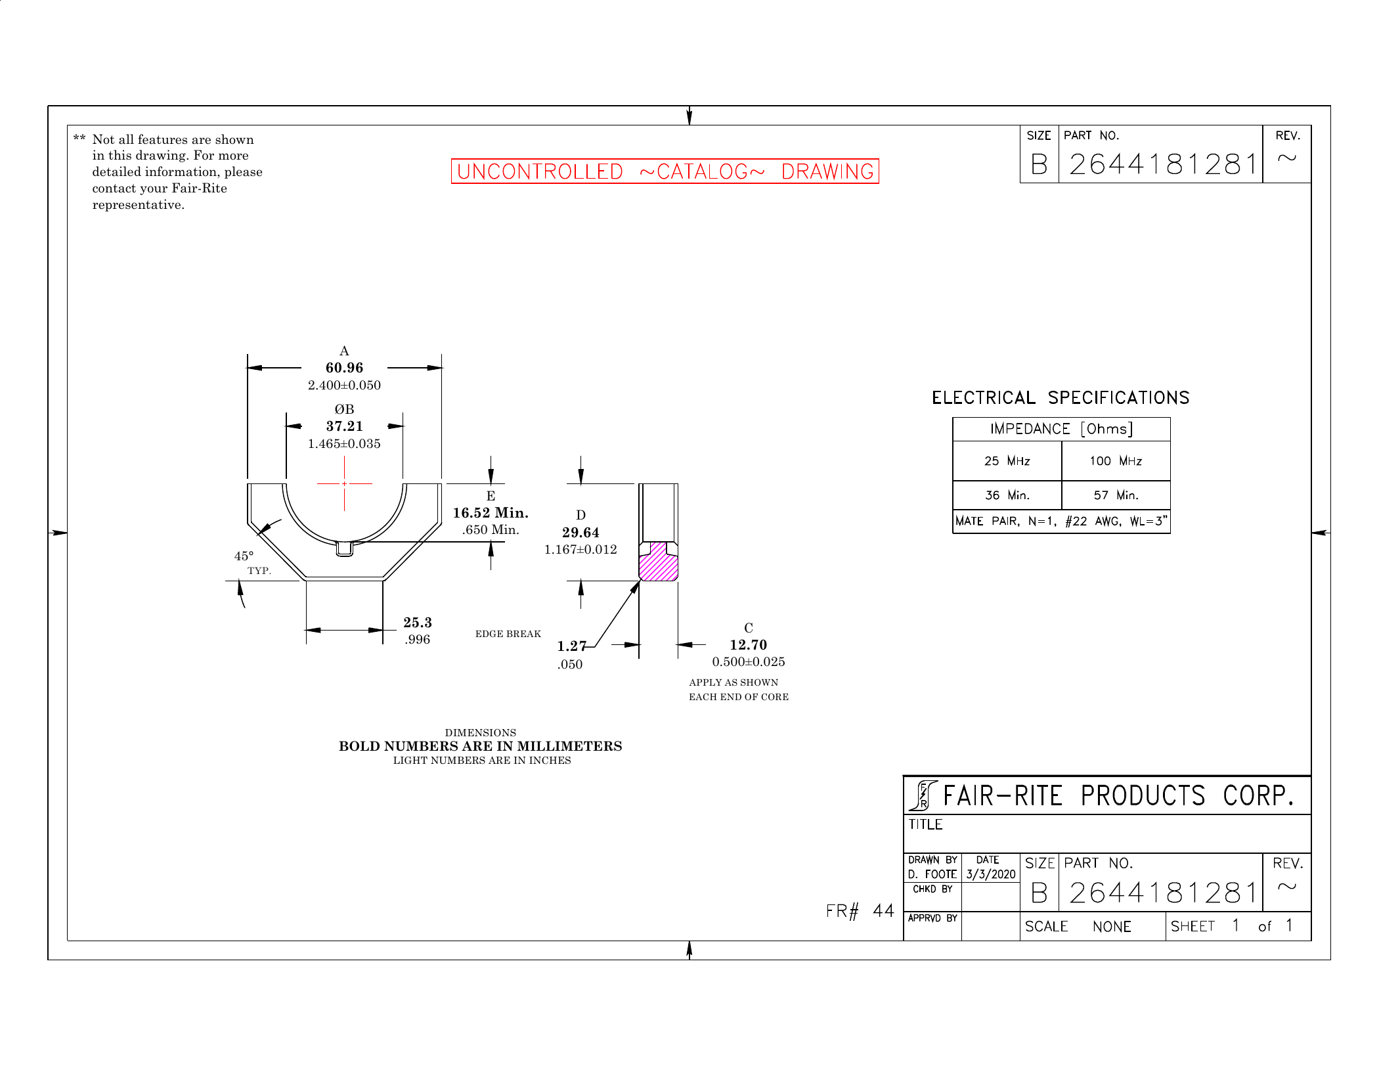
docs/references/2644181281_catalog_page1.png
