ckh7488/rf_current_probe/docs/references/CAB27480_linked_drawing_page1.png

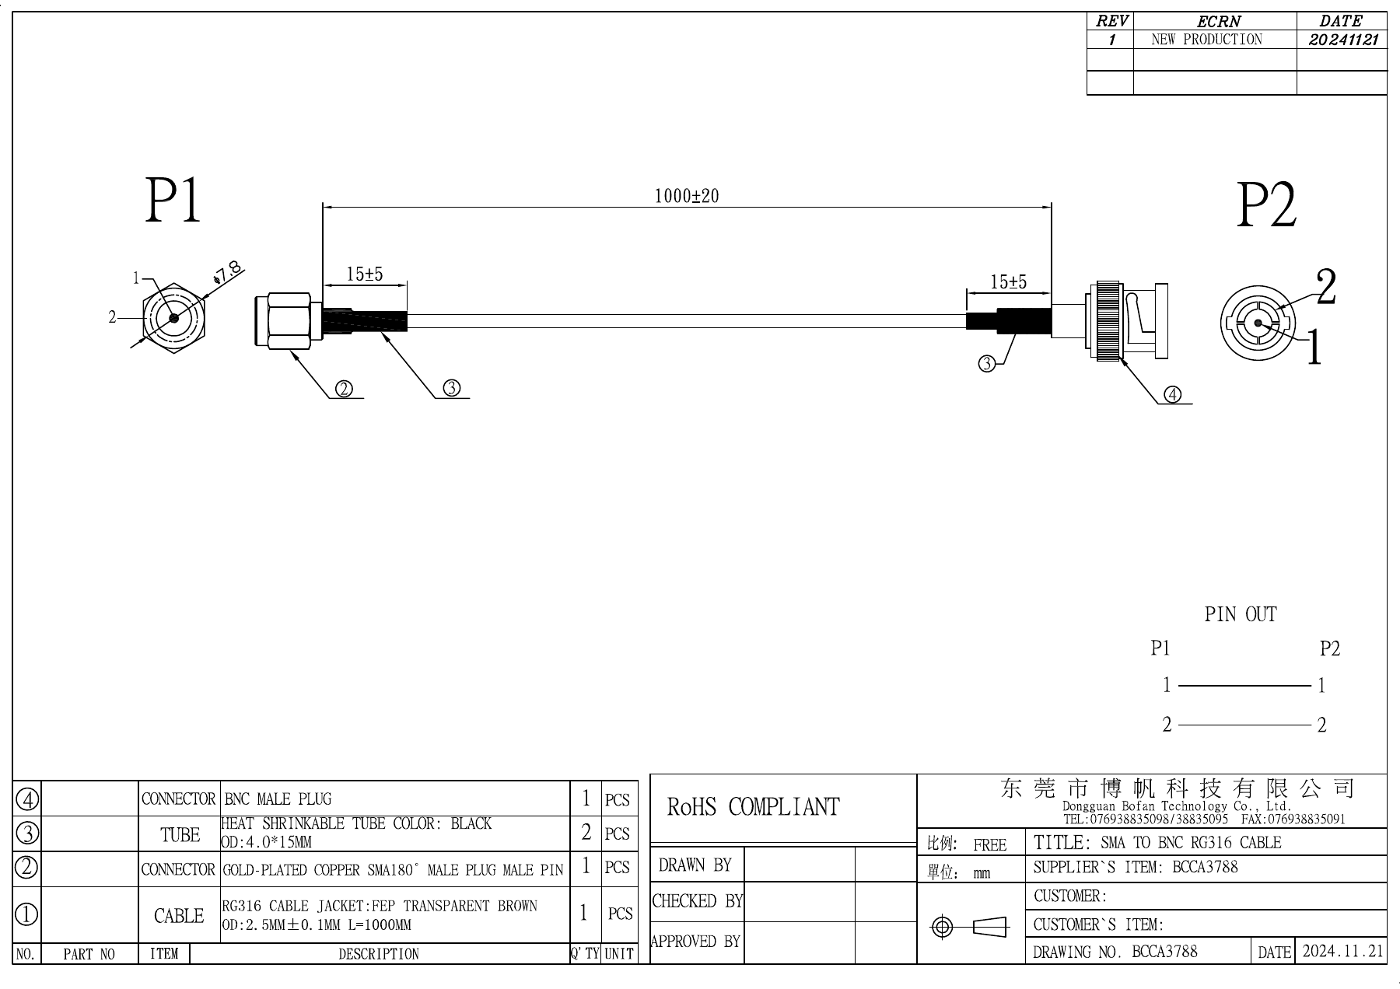
docs/references/CAB27480_linked_drawing_page1.png
