ckh7488/rf_current_probe/docs/references/core_farnell_page1.png

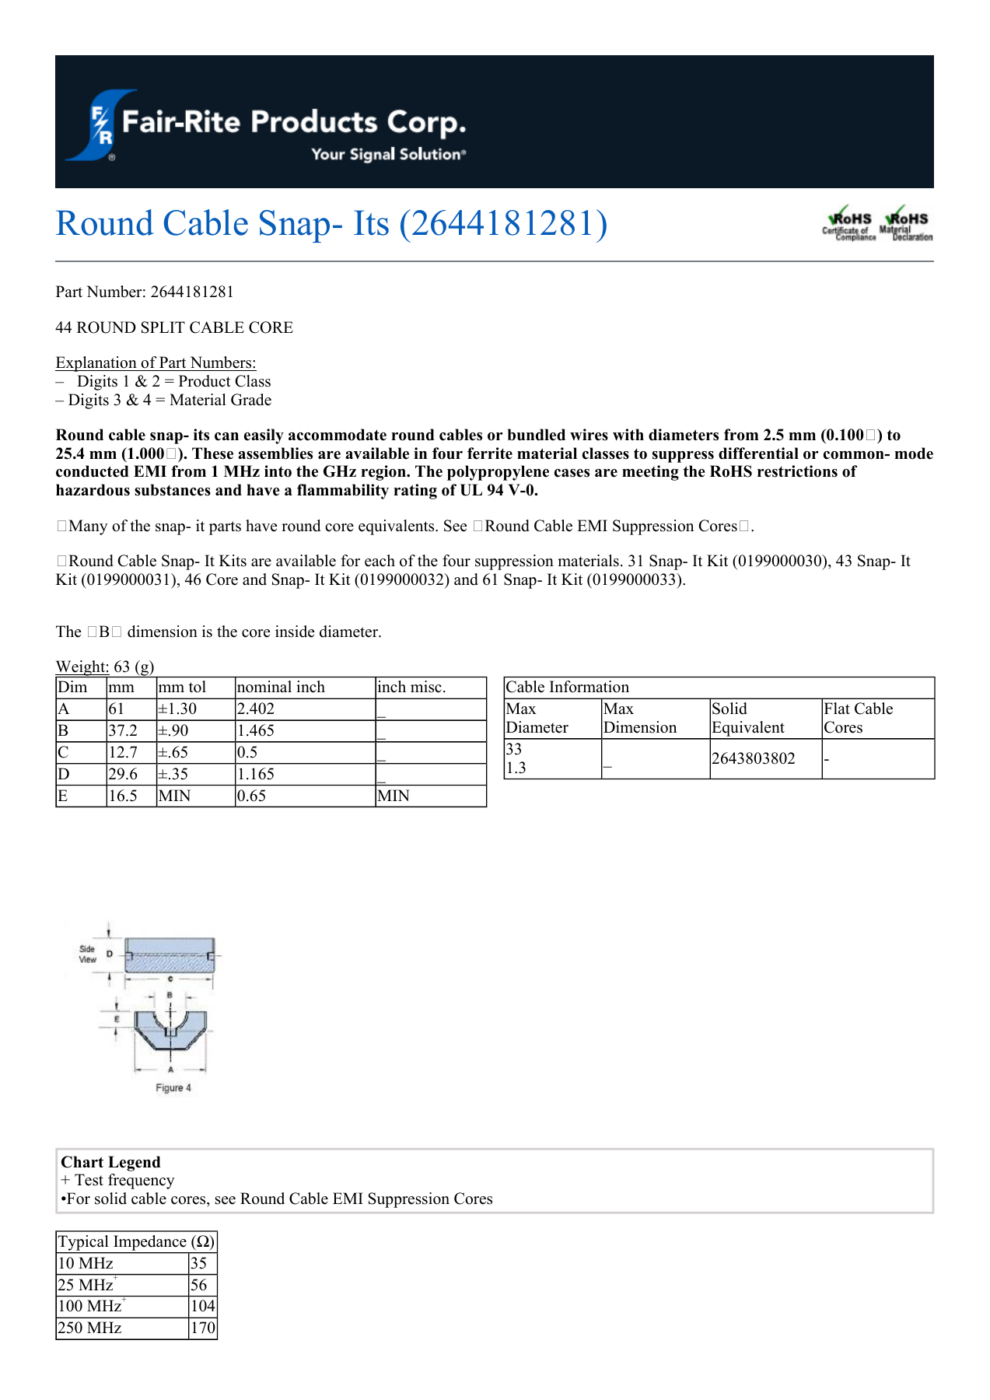
docs/references/core_farnell_page1.png
