ckh7488/rf_current_probe/docs/references/fixture_20260917/132139_catalog_page38.png

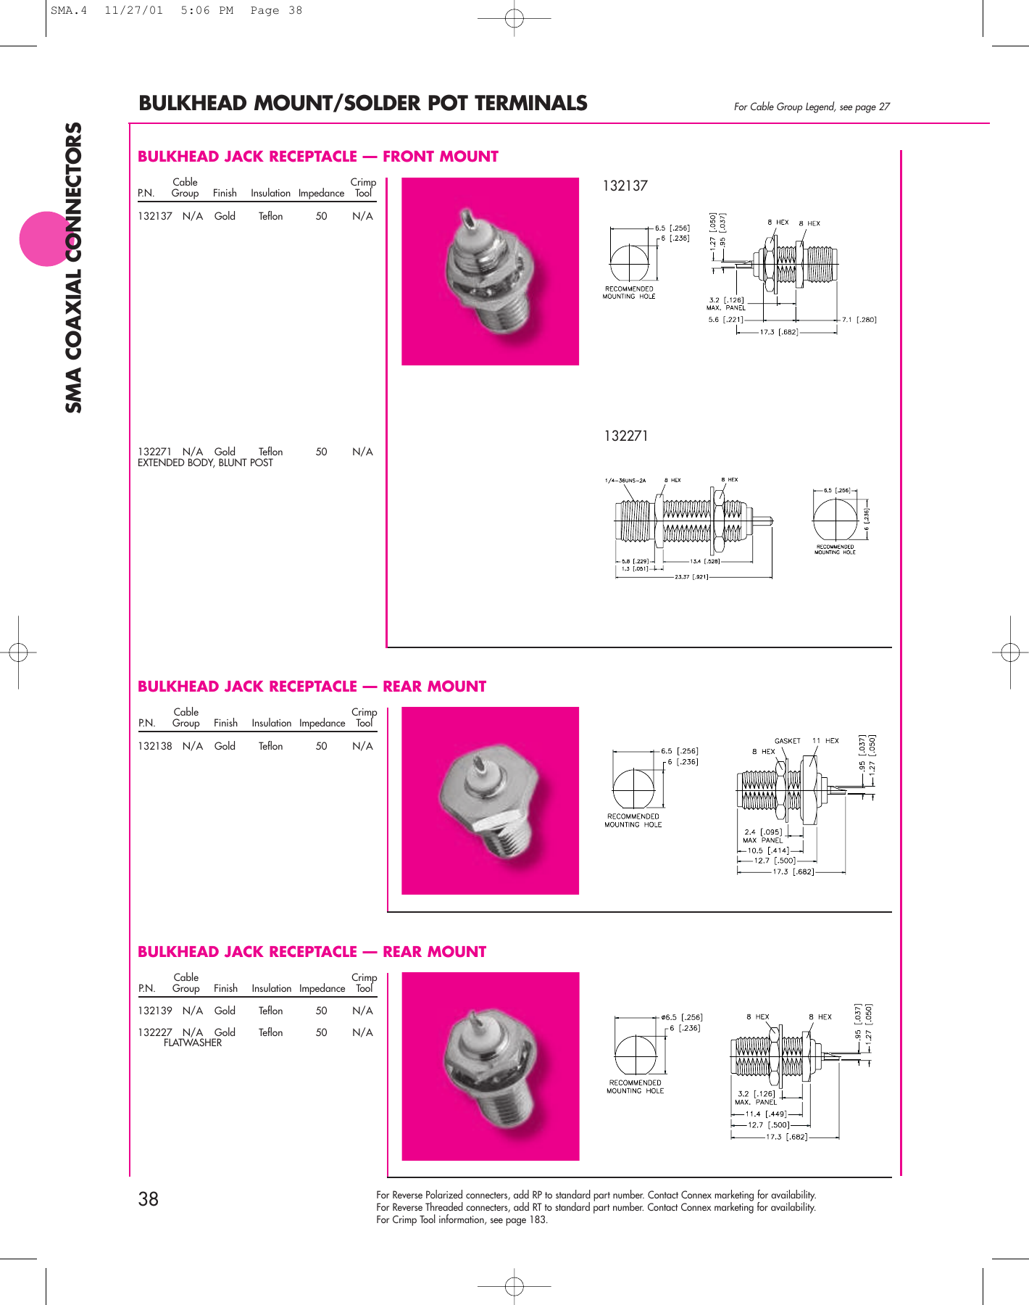
docs/references/fixture_20260917/132139_catalog_page38.png
