ckh7488/rf_current_probe/docs/references/RFPC-SMA28-F_page2.png

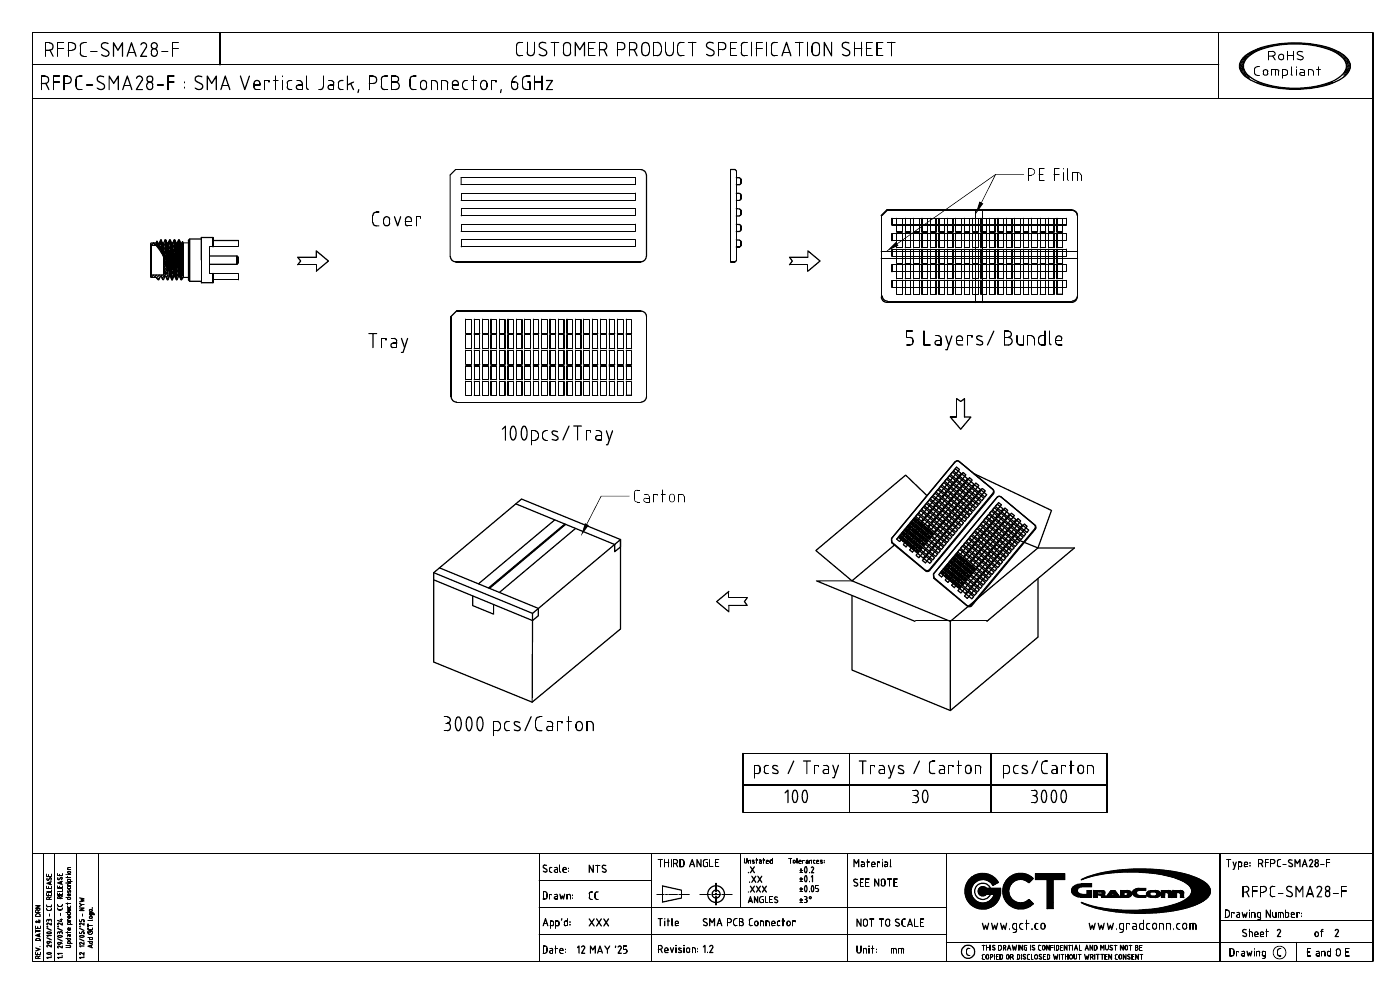
docs/references/RFPC-SMA28-F_page2.png
