ckh7488/rf_current_probe/docs/references/VAT-10A_plus_page2.png

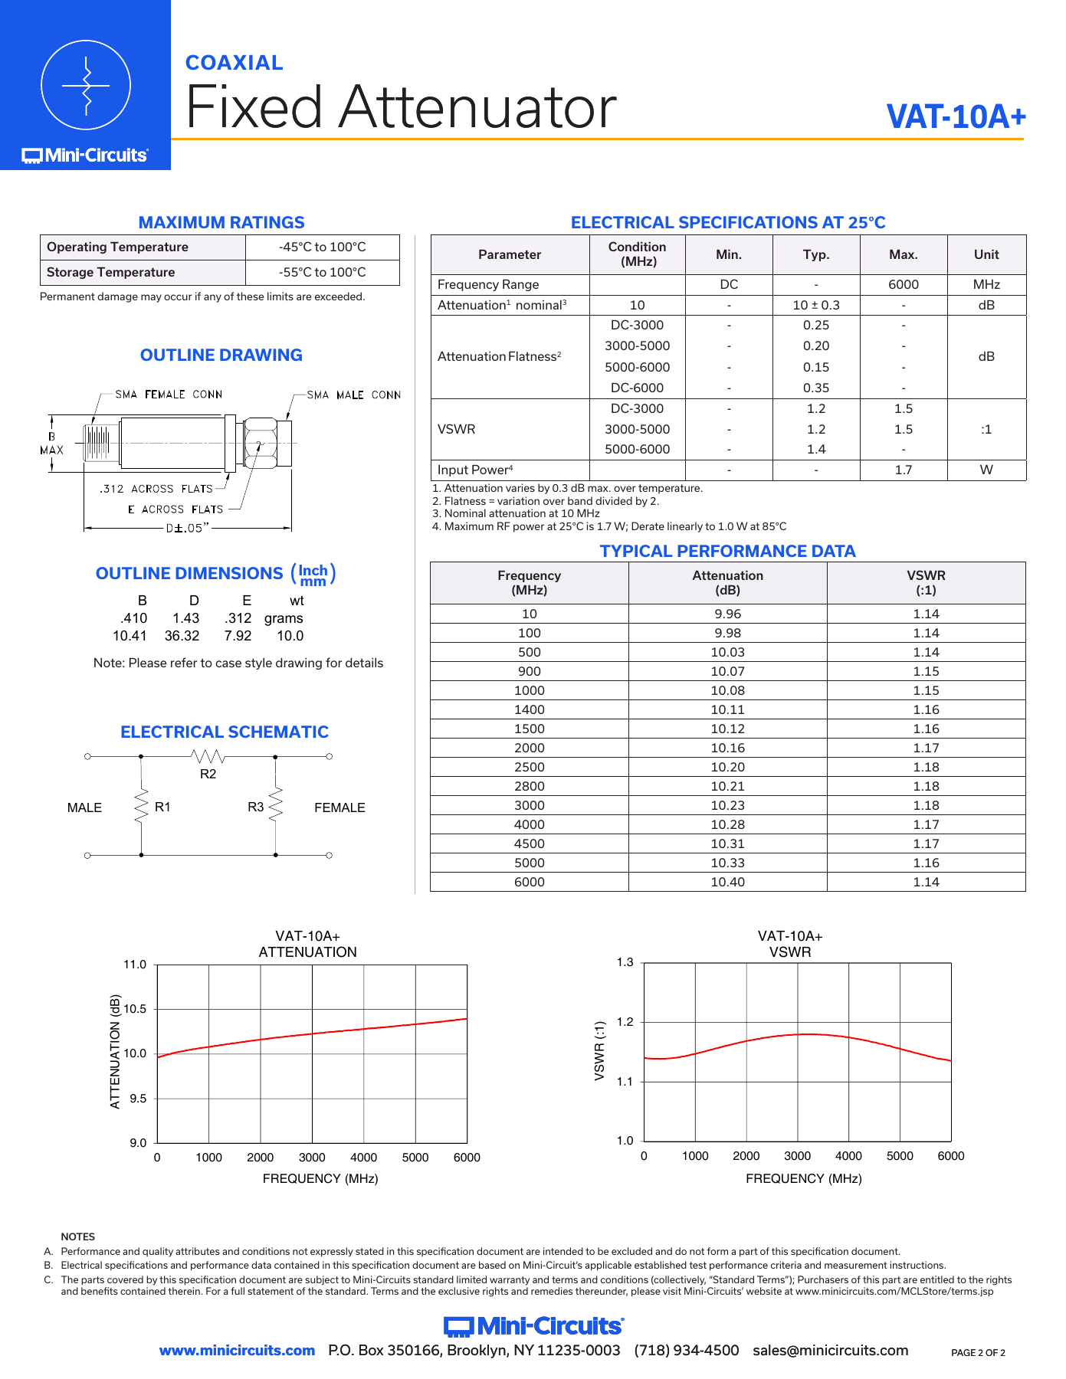
docs/references/VAT-10A_plus_page2.png
