ckh7488/rf_current_probe/hardware/probe_head_A04_DRAFT/review/top.png

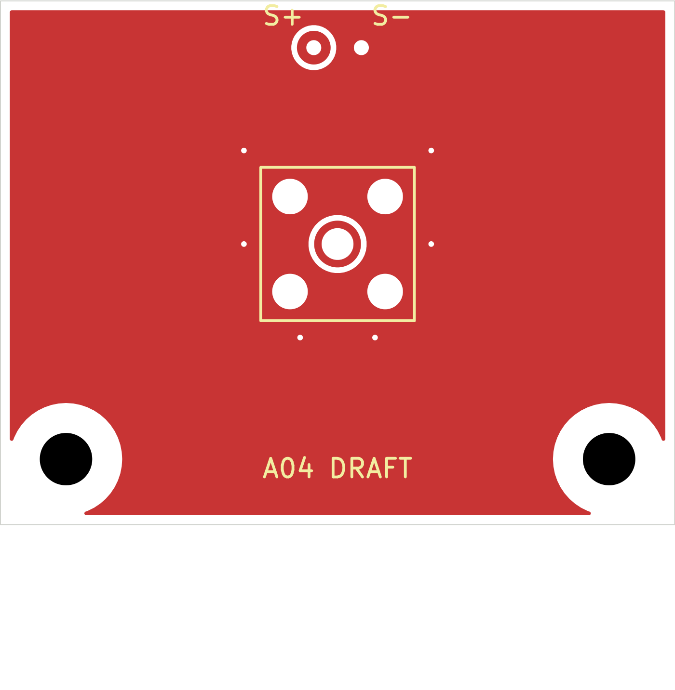
hardware/probe_head_A04_DRAFT/review/top.png
