ckh7488/rf_current_probe/viewer_A05/audit_sources/images/post_before_after.png

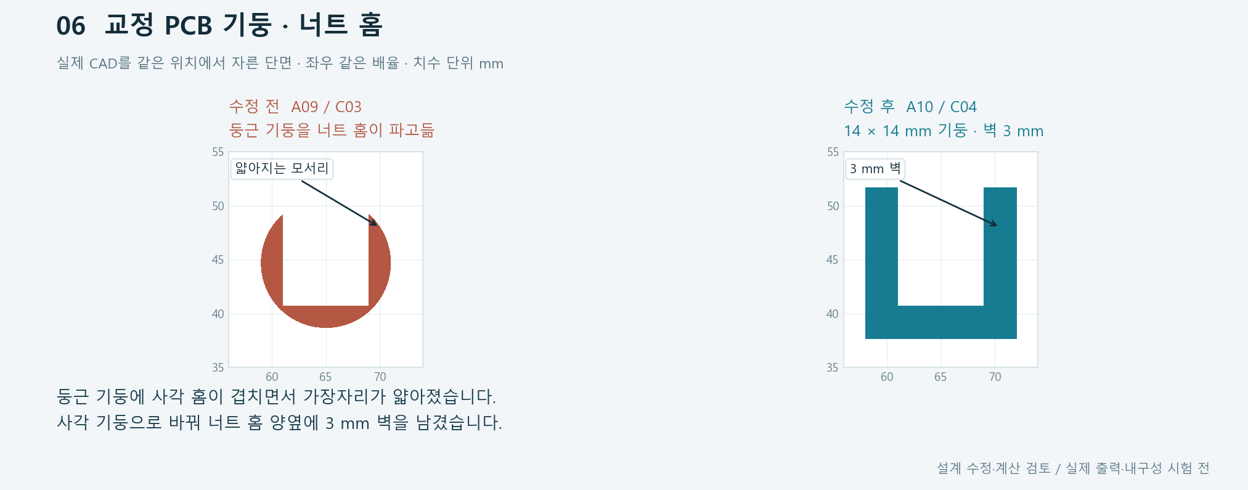
viewer_A05/audit_sources/images/post_before_after.png
