ckh7488/rf_current_probe/docs/BOM_DRAFT.md

# 현행 설치 BOM 및 통합 구매 기준

2026-09-29 독립 재검토 반영(DEC-079). **현행: Head A04 SMA R2 / Fixture A03 SMA R2 / VNA B-RJ2 / A18·C10.** 실제 원본과 제조 ZIP은 [현재 제작 구성](CURRENT_BUILD.md), 업체 심사·결제 상태는 [STATUS](STATUS.md)를 따른다. DRAFT 표시는 최종 제조파일·생산승인 전이라는 의미로 유지한다.

이 표는 프로브·교정지그의 설치 위치 57행이다. 삭제된 체결품 4행은 ID 추적을 위해 설치0으로 남긴다. 설치량·보유품·구매 포장·예비품을 혼동하지 않는다. **VNA까지 포함한 실제 구매 지시는 [구매팀 HTML 31행](../outputs/purchasing-handoff-20260929/구매안내_20260929.html)**이다. 9/28 구매검수는 이력이며 현행 지시를 대체하지 않는다. [이번 독립 검토](../reviews/independent_current_audit_20260929/REPORT.md)와 [수정 전 원문](../reviews/independent_current_audit_20260929/before/docs/BOM_DRAFT.md)을 보존했다.

RF Y23/Y24와 A18 앞/뒤·C10은 Approved, A18 중앙 및 VNA Y34/Y35/Y36/Y37은 Reviewing이다. RF $218.13 + VNA $226.22 = **$444.35, 쿠폰 전**. 결제·최종 CAM·생산승인은 별도다. [현재 출력명세](3D_PRINT_RELEASE_A18_C10.md), [A18 제작 원본](../reviews/base_dfm_fix_20260928/PRINT_MANIFEST.json), [SMA R2 원본](../reviews/sma_clearance_r2_20260928/REPORT.md)을 따른다. 업체 Approved 표시만으로 앞베이스 경고 위치·휨 보증이나 실물 조립/RF 성능을 입증하지 않는다.

출력은15종20개: 9600 Resin8종11개 + 3201PA-F7종9개. 추가 가공·표면마감 없음. 공칭26mm 구경, 5턴 기본/3턴 선택, A03 출력 포트 기준1–500MHz 교정을 유지한다. 이는 실측 완료 사양이 아니다.

| ID | 품목 | 설치량 | 규격 | 조립/확인 메모 |
|---|---|---:|---|---|
| P01 | 프로브 아래 중앙 몸체 | 1 개 | LowerCenter_A14_DRAFT.stl | 3201PA-F Nylon · A18/C10 제작명세의 정확 원본/해시를 따른다. 현재 형상 유지. |
| P02 | 프로브 왼쪽 뚜껑 | 1 개 | UpperLeft_A14_DRAFT.stl | 3201PA-F Nylon · A18/C10 제작명세의 정확 원본/해시를 따른다. 현재 형상 유지. |
| P03 | 아래 코어 고정바 | 1 개 | LowerKeeper_FREE_DRAFT.stl | 3201PA-F Nylon · A18/C10 제작명세의 정확 원본/해시를 따른다. 현재 형상 유지. |
| P04 | 위 코어 고정바 | 1 개 | UpperKeeper_FREE_DRAFT.stl | 3201PA-F Nylon · A18/C10 제작명세의 정확 원본/해시를 따른다. 현재 형상 유지. |
| P05 | 공통 바닥 가운데 | 1 개 | BaseCenter_A18_DRAFT.stl | 9600 Resin · A18/C10 제작명세의 정확 원본/해시를 따른다. A18 파일 JLC 제출 완료, Reviewing. 자동 승인·위험 수락 없음. |
| P06 | 클램프 고정틀 | 2 개 | C10_Frame_DRAFT.stl | 9600 Resin · A18/C10 제작명세의 정확 원본/해시를 따른다. 현재 형상 유지. |
| P07 | 클램프 연결틀 | 2 개 | C07_DriveYoke_DRAFT.stl | 9600 Resin · A18/C10 제작명세의 정확 원본/해시를 따른다. 현재 형상 유지. |
| P08 | 클램프 가로대·위 턱 | 2 개 | C07_TopBridgeJaw_DRAFT.stl | 9600 Resin · A18/C10 제작명세의 정확 원본/해시를 따른다. 현재 형상 유지. |
| P09 | 아래 왼쪽 턱 | 2 개 | C07_Jaw1_DRAFT.stl | 3201PA-F Nylon · A18/C10 제작명세의 정확 원본/해시를 따른다. 현재 형상 유지. |
| P10 | 아래 오른쪽 턱 | 2 개 | C07_Jaw2_DRAFT.stl | 3201PA-F Nylon · A18/C10 제작명세의 정확 원본/해시를 따른다. 현재 형상 유지. |
| P11 | 프로브 아래 왼팔 | 1 개 | LowerArmLeft_A14_DRAFT.stl | 9600 Resin · A18/C10 제작명세의 정확 원본/해시를 따른다. 현재 형상 유지. |
| P12 | 프로브 아래 오른팔 | 1 개 | LowerArmRight_A14_DRAFT.stl | 9600 Resin · A18/C10 제작명세의 정확 원본/해시를 따른다. 현재 형상 유지. |
| P13 | 프로브 오른쪽 뚜껑 | 1 개 | UpperRight_A14_DRAFT.stl | 3201PA-F Nylon · A18/C10 제작명세의 정확 원본/해시를 따른다. 현재 형상 유지. |
| P14 | 공통 바닥 앞쪽 | 1 개 | BaseFront_A18_DRAFT.stl | 9600 Resin · A18/C10 제작명세의 정확 원본/해시를 따른다. A18 파일 JLC 제출 완료, 9/29 Approved (업체 파일심사). 자동 승인·위험 수락 없음. |
| P15 | 공통 바닥 뒤쪽 | 1 개 | BaseRear_A18_DRAFT.stl | 9600 Resin · A18/C10 제작명세의 정확 원본/해시를 따른다. A18 파일 JLC 제출 완료, 9/29 Approved (업체 파일심사). 자동 승인·위험 수락 없음. |
| E01 | 분할 페라이트 코어 | 2 반쪽 | Fair-Rite 2644181281 · 44 재료 | 제조사 split-round 계열 pieces 판매 원칙 + 현행 정확품 반쪽 도면/63g + DigiKey Bulk 판매를 종합해 주문2개로 확정. 13,295×2=26,590원. 표준포장22는 MOQ 아님. 판매자가 half라고 직접 답변한 것은 아니며 제조사 자료 연결에 따른 판정이다. |
| E02 | 헤드 PCB | 1 장 | Head A04 SMA R2 DRAFT · 36×28×1.6 mm · FR4 2층 | 권선–SMA 직접 연결, 수신기 단일50 Ω. 중심/접지 완성홀1.90/2.10 mm. R2 Y23 업체 파일심사 Approved, 구형Y21은 취소했다. 취소본1.70/1.90mm와 구분. |
| E03 | 평판 교정 PCB | 1 장 | Fixture A03 SMA R2 DRAFT · 144×92.7×1.6 mm · FR4 2층 | SIG만 코어 안, 귀환은 밖. 출력 기준1–500 MHz 교정. R2 Y24 업체 파일심사 Approved, 기존Y22는 취소했다. 기존 빈 지그 K는 R2 검증값이 아니므로 적용성/불확도를 검토한다. |
| E04 | 수직 SMA 암 커넥터 | 3 개 | GCT RFPC-SMA28-F · 표준 SMA, THT | Head A04 1개 + Fixture A03 IN/OUT 2개 = 3개 모두 현행 필요량. RP-SMA 대체 금지. GCT Rev1.2 도면 및 JLC 공차의5핀 동시 삽입 계산 완료. 실물 핀 휨·평면 안착·납땜은 입고 확인. |
| E05 | 에나멜선 | 필요량 | UEW Type 0.3mm×95g · 구매1롤 | 권선용 한 종류. 5턴 기본. 권선 직후 지그 없이 헤드 출력 S11로 자기공진을 기록한다. 필요한 대역이 신뢰 등급에 못 미칠 때만 3턴을 선택하며 턴수마다 교정 ID를 따로 둔다. 1롤은 구매 포장 단위로 잉여 발생. |
| E06 | 폴리이미드 절연 테이프 | 필요량 | SMG-A 5mm×33m · 구매1롤 | 권선과 코어 사이 절연. 맞댐면 제외. 감은 뒤 실제 외경·간극 확인. |
| F01 | 헤드 PCB 나사 | 2 개 | Essentra 50M020040P012 · PA66 M2×0.4×12 · 머리 최대 Ø4.0×H1.6 | M2×12로 채택·CAD 반영 완료. 최대 너트 기준 공칭 끝 여유2.19 mm, 12.3 mm 길이의 지정61자세 무간섭. 출력물은 그대로. 입고 허용조건: 머리 아래11.7–12.3 mm / 조립 그립7.85–8.85 mm / 너트 높이1.46 mm 이하. 이는 설계 수입검사 기준이며 공급자 보증공차가 아님. H05에서 완전 나사산과 끝 간섭 확인. |
| F02 | 헤드 PCB 너트 | 2 개 | Essentra 04M020040HN · PA66 M2 · AF3.9 / H1.2 | 제조사 개별도면 AF3.90±0.26 / H1.20±0.26 mm. 최대 외형 뒤 삽입 58자세 무간섭. F01은 M2×12로 채택. 완전 나사산이 너트 밖으로 나오는지는 첫 조립에서 확인. 실제 부품 공차를 공칭 CAD 치수와 혼동하지 않음. |
| F03 | 코어 고정바 나사 | 4 개 | Essentra 50M030050P035 · PA66 M3×0.5×35 | 실제 머리 D5.3~5.6 / H2.2~2.4. 기존 CAD 보수 포락 Ø6.5×H3.3 안에 들어간다. |
| F04 | 코어 고정바 너트 | 4 개 | Essentra 04M030050HNDIN34814 · PA66 M3 · AF5.3~5.5 / H2.2~2.4 | 제조사 최대치가 현재 CAD AF5.5/H2.4와 일치. |
| F05 | 전나사 유두 육각렌치볼트 | 2 개 | 일반 SUS304 유두 렌치볼트 M4×0.7×60 전나사 | 상품 옵션 M4/60mm 각260원. 노브·잼너트 제거 후 머리 아래 길이60mm. 머리Ø7×4,3mm 육각렌치. 판매자 도면에 전산 명시. 절단/특주품 아님. |
| F06 | 모듈·가로대 손나사 | 10 개 | CRKW4-20 | 정확 CRKW4-20: M4P0.7 길이20, 머리Ø11×6, PC 흰색 머리/SUSXM7 축. 실제 수량10 입력: 세전10,010원 / VAT포함11,011원. 과거 NKMS 도면은 이 제품의 근거가 아님. 설치는 바닥6+가로대4. 바닥 왼쪽2곳은25mm 올린 뒤 바깥쪽으로 빼는 지정 경로 유지. |
| F07 | M4 사각너트 | 16 개 | 19501-55704 | 정확 옵션 19501-55704, M4P0.7, 폭7/두께3.0/대각8.9mm, A2. 20개 1팩 세전3,300원/VAT포함3,630원. CAD 명목두께3.2와 다름. 설치16+예비4. 두 팩 합배송3,300원, 상품VAT포함6,600원+배송=9,900원. 위치별 수량은 머리2+바닥6+가로대4+팔로워4. |
| F08 | 큰 노브 · M6 암나사 | 0 개 | 현행 조립에서 삭제 | 일반 M4×60/M6×100 육각렌치 볼트 구조로 삭제. 설치0/구매0. 예전 판매품은 이력 파일에 보존. |
| F09 | M6 사각 구동너트 | 2 개 | 19501-55706 | 정확 옵션 19501-55706, M6P1, 폭10/두께4.8/대각12.7mm, A2. 10개 1팩 세전2,700원/VAT포함2,970원. CAD 명목두께5.0과 다름. 설치2+잔여8. 두 팩 합배송3,300원, 상품VAT포함6,600원+배송=9,900원. |
| F10 | M6 축 위치 조절 너트 | 2 개 | 보유 M6 나일론 삽입 풀림방지 너트 | 사용자 파란 나일론 링 너트 보유 진술. 필요2개를 보유에서 충당. 제조사·재질·정확 높이는 미확인. 약0.2mm 축 여유를 맞추고 프레임을 압착하지 않음. |
| F11 | M6 축 받침 와셔 | 2 개 | 보유 일반 금속 M6 평와셔 | 사용자 일반 M6 평와셔 보유 진술. 필요4개를 보유에서 충당. 황동/특정 판매품이라고 단정하지 않음. ID/OD/두께 미확인; CAD명목 t1.6과 실물 차이는 축 위치 조정 후 간섭·회전 여유 확인. 이 행은 아래쪽2개, F17 위쪽2개와 합계4개. |
| F12 | 숄더볼트 / 단붙이볼트 / 어깨볼트 | 4 개 | LIXIU WJ1084E · 어깨Ø5×20 / M4P0.7 나사8 / 머리Ø9×3.5 / 판매자304 / 육각3mm | 한운상사(쿠팡) 정확옵션08 d5x M4 (5pcs) ×16 20mm, 5개팩7,130원 무료배송. 설치4+예비1. 기존 CAD 머리H4 대비0.5 낮으며4자리×21자세 추가간섭 없음. 설계변경 불필요. [치수·판매 검토](../reviews/procurement_closure_20260928/REPORT.md). |
| F13 | 교정 PCB 고정 나사 | 4 개 | Essentra 50M030050P012 · PA66 M3×0.5×12 | Fixture A03를 BaseCenter 받침4곳에 고정하는 현행 구매 대상4개. 실물 나사물림·높이는 첫 조립에서 확인. |
| F14 | 교정 PCB 일반 나일론 육각너트 | 4 개 | 04M030050HNDIN34814 | F04에서 4개 배정. 구매량0/금액0은 불필요 또는 무료라는 뜻이 아님. 옆에서 얇은 5.5mm 스패너로 잡고 위에서 나사를 조임. CAD 4자리와 합성 공구64삽입 위치 간섭0; 실제 공구 미확인. |
| F15 | 전나사 유두 육각렌치볼트 | 2 개 | 일반 SUS304 유두 렌치볼트 M6×1.0×100 전나사 | 상품 옵션 M6/100mm 각1,570원. 노브·잼너트 제거 후 머리 아래 길이100mm. 머리Ø10×6,5mm 육각렌치. 하부 보유 풀림방지너트는 유지. 판매자 전산 명시. |
| F16 | 노브 고정 잼너트 | 0 개 | 현행 조립에서 삭제 | 일반 M4×60/M6×100 육각렌치 볼트 구조로 삭제. 설치0/구매0. 예전 판매품은 이력 파일에 보존. |
| F17 | 축 위쪽 받침 와셔 | 2 개 | 보유 일반 금속 M6 평와셔 | 사용자 일반 M6 평와셔 보유 진술. 필요4개를 보유에서 충당. 황동/특정 판매품이라고 단정하지 않음. ID/OD/두께 미확인; CAD명목 t1.6과 실물 차이는 축 위치 조정 후 간섭·회전 여유 확인. 이 행은 위쪽2개, F11 아래쪽2개와 합계4개. |
| F18 | 분할 바닥 연결 나사 | 4 개 | Essentra 50M040070P020 · PA66 M4×20 | 아래에서 위로 삽입. 아래/위 와셔 각 1개. 위에 육각너트. |
| F19 | 분할 몸체·뚜껑 연결 나사 | 6 개 | Essentra 50M040070P030 · PA66 M4×30 | 아래 몸체 4 + 위 뚜껑 2. 뒤에서 앞으로 삽입. 뚜껑에 M4×25 사용 금지. |
| F20 | 분할 연결 육각너트 | 10 개 | Essentra 04M040070HNDIN34814 · PA66 M4 | AF6.8–7 / H2.9–3.2. 7 mm 공구. 기존 M4 사각너트 F07과 다름. |
| F21 | 분할 연결 평와셔 | 20 개 | Essentra 17M04DIN34815 · PA66 · ID4.3 / OD9 / t0.8 | 나사 하나마다 머리 아래 1 + 너트 아래 1. 금속으로 일괄 대체하지 않음. |
| F22 | 개폐용 관통 노브 | 0 개 | 현행 조립에서 삭제 | 일반 M4×60/M6×100 육각렌치 볼트 구조로 삭제. 설치0/구매0. 예전 판매품은 이력 파일에 보존. |
| F23 | 개폐 노브 고정 잼너트 | 0 개 | 현행 조립에서 삭제 | 일반 M4×60/M6×100 육각렌치 볼트 구조로 삭제. 설치0/구매0. 예전 판매품은 이력 파일에 보존. |
| F24 | 개폐 볼트 받침 나일론 와셔 | 2 개 | 17M04DIN34815 | F05 M4×60 볼트 머리 바로 아래. F21 20개와 합쳐 설치22, 구매25. 기존 노브·잼너트는 삭제. |
| R01 | SMA 수–수 50 Ω 케이블 | 2 개 사용 | 표준 SMA male–male | 보유 1개 + 부족한 1개만 추가. CSE-SGAM-305-SGAM 1개 구매 선정. 305 mm 길이의 실제 배치와 굽힘은 첫 조립에서 확인. |
| R02 | SMA 수 50 Ω 로드 | 1 개 사용 | TE 2467938-1 작업용 로드 · 50 Ω / SMA 수 | RF에서 1개 사용. 통합 구매는 발룬 6개 + 공유·예비 1개 = 7개 유지. 보유 SOL 교정 표준과 별개이며 구매 완료로 간주하지 않음. RF OFF에서 지그 출력 ↔ 헤드 출력으로 옮겨 사용. 교정 전에 이 로드의 S11을 VNA로 1회 측정해 Transfer 단계의 지그 출구 종단 보정에 사용. |
| R03 | SMA OPEN / SHORT / LOAD | 1 세트 | 보유 교정 표준 | VNA 케이블 끝 기준면과 성별·모델값·유효 대역 확인. |
| R04 | SMA 암–암 THRU | 1 개 필요 | 2포트 교정용 연결 기준 | 보유 키트에 포함되어 있는지, through 정의가 맞는지 확인 후 부족할 때만 구매. |
| R05 | 10 dB 감쇠기 | 1 개 | Mini-Circuits VAT-10A+ 선정 | 설치1개. 기본 운용은 감쇠기 없이 맨 프로브를 쓴다(실제 출력 최대값과 계측기 입력 조건은 첫 측정에서 확인). 강력 권고: 새 현장·새 케이블의 첫 측정은 반드시 이 10 dB를 넣고 최대값을 확인한 뒤 뺀다. 케이블 착탈·전원 투입 때도 넣는다. 감쇠기를 넣은 체인은 S21을 따로 측정해 보정한다. 상용전원·VFD·고전압·서지 현장은 Rev.A 범위 밖(DEC-055). |
| R06 | SMA–BNC 50 Ω 케이블 | 1 개 | SparkFun 27480 · 1 m 선정 | 50 Ω BNC 입력 오실로스코프 연결용. 실제 플러그 외형·감쇠·기준면 검증 필요. |
| R08 | 현장 입력 보호 | — | 대상 하네스(24 V·100BASE-TX)에서는 별도 보호 체인 없음 | DEC-055로 종결. 이 하네스는 맨 프로브 + R05 첫 확인으로 운용한다. 상용전원·VFD 출력선·노출 고전압·서지 현장에 적용하려면 새로 선정·검증한다. |
| T01 | VNA (보유 LibreVNA 2포트) | 1 대 | 50 Ω · 복소 S11/S21 · 현행 A03 교정·특성화 1–500 MHz | LibreVNA 2포트 보유. 필요 조건: 복소 S11/S21/S12/S22, 케이블 끝2포트 교정, 출력 레벨·IF BW 조절, Touchstone 저장, 하한100 kHz 이하, 500 MHz 포함. HW/FW/GUI 버전은 첫 벤치에서 기록. |
| T02 | 오실로스코프 (보유 MSO4054) | 1 대 | 아날로그 대역폭 500 MHz 이상 권장 · 정의된 50 Ω 입력 | Tektronix MSO4054 보유(명판 확인 전 잠정 모델). 필요 조건: 500 MHz·50 Ω 입력·2.5 GS/s, 원시 파형 저장. FFT는 표시 샘플레이트1 GS/s 이상에서 보고, 저역을 길게 잡을 때는 대역 제한(20 MHz) 또는 Hi-Res를 켜 접힘을 막는다. 케이블+스코프 응답은 LibreVNA CW 출력을 R06으로 넣어 주파수별로 확인한다. |
| T03 | 스패너·드라이버 | 1 세트 | 7 mm / 10 mm / 5.5 mm / M2용 소형 공구 + 십자 드라이버 + 선정 LIXIU follower용 3 mm 육각렌치 + 일반 볼트용3mm·5mm 육각렌치 | PCB 뒤 M2 너트에는 가는 대향 평팁 공구. 각 끝단0.6×1.5 mm/가는 구간25 mm, 이후 Ø14×80 mm 손잡이 포락을 CAD로 검사했으며 실제 파지력·나사물림은 미검증. Ø6.5 mm 관형 소켓은 PCB 홀더에 간섭. M3 뒤 너트는 Ø8×25 mm 관형 포락 접근 확인. 10 mm 스패너는 머리폭18·두께4 mm 이내 기준. 실제 공구를 대조한다. |
| T04 | 인두·납·플럭스·인두팁·테스터 | 1 세트 | 권선·납땜·도통 확인 | 인두 보유. 구매팀용 목록에는 SMD291-10M 플럭스 2개와 900M-T-1.6D·2.4D 팁 각 1개 유지. 납·테스터는 보유 확인 필요. 이 1세트는 작업공구 묶음이며 구매 수량은 링크 기준. |
| T05 | 치수·축 여유 확인 도구 | 1 세트 | 캘리퍼 / 필러 게이지 등 | 코어 실제 치수, 출력 맞춤, 약 0.2 mm 축 여유 확인용. |

## 구매와 입고 확인

- 일반 SUS304 전나사형 육각렌치 볼트 M4×60 2개 / M6×100 2개를 구매한다. F08·F16·F22·F23 노브와 잼너트는 구매하지 않는다.
- M3 PA66 육각너트는 F04 설치4+F14 설치4+예비2=총10개. F14 구매0은 F04에 합산했다는 뜻이다.
- M4 사각너트16개는20개팩1개, M6 사각너트2개는10개팩1개를 구매한다. 두께는 각각3.0/4.8mm로 CAD명목3.2/5.0과 구분한다. 보유 일반 육각너트를 캡티브 사각 포켓에 임의 대체하지 않는다.
- M6 풀림방지너트2개와 금속 평와셔4개는 사용자 보유품. 정확 치수·재질·실수량은 실사 전이다. 보유 와셔를 황동 특정 품번으로 단정하지 않는다. 축 유격·마찰 확인 후 조정한다.
- F12는 LIXIU Ø5×20/M4 5개팩7,130원·무료배송으로 선정했다. 설치4개+예비1개. 일반 나사부로 미끄럼 어깨를 대체하지 않는다. 해외배송10/14 예정은 판매자 조회 표시다.
- Fair-Rite 주문2개=반쪽2개=한쌍으로 확정했다. 제조사 개별 pieces 판매 원칙과 현행 정확품 반쪽 도면/63g 및 DigiKey Bulk 판매를 대조한 판정이다. 상세 근거는 구매 종결 보고서 참조.
- 발룬10/Samtec SMA10/RJ45 8/Molex5/GCT SMA4/플럭스2의 구매 예비 수량은 그대로 유지한다.

## 측정·준비물

LibreVNA·오실로스코프·SOL·인두 보유 기록과 실제 교정·작동 완료는 다르다. THRU 성별/모델, DUT면 교정 표준, 패치선, 실납·테스터·치수/체결 공구는 [현행 조립 전 준비표](../outputs/purchasing-handoff-20260929/조립전_준비확인_20260929.md)로 확인한다. **LLC용 수 M12 1개는 사용자 보유 확정·신규구매0이며, 별도 M12 지지 패널/브래킷을 필수품으로 요구하지 않는다.**

DEC-055의 대상 하네스는 맨 프로브가 기본이며 새 현장·새 케이블 첫 확인은10dB 감쇠기로 시작한다. D01–D03은 기존 진단 어댑터·접지면·기준선 활용 계획, D04 스냅온 페라이트는 선택 구매, D05 굴곡은 절차 항목이다. 발룬 CT의0Ω은 기본 미실장이며 PWR/GND 쌍 CT를 단락한 보드의 통전을 금지한다. 과거 보유 기록은 이번 신규 VNA 보드가 이미 실장·검증됐다는 뜻이 아니다.

실물 조립, RF 응답·삽입 영향·재현성 및 T01–T12 측정은 미실행이다. [입고·벤치 확인](../reviews/full_reinspection_20260928/ACCEPTANCE_PLAN.md)과 백서11.6/14.5의 조건을 따른다. 공개 페이지의 옛 조립 BOM은 최신 구매 지시를 대신하지 않는다.
