ckh7488/rf_current_probe/docs/history/BOM_DRAFT_0.11.md

# RF Current Probe — 예비 시스템 BOM

작성일: 2026-09-15. 갱신일: 2026-09-17. 개정: 0.11. 상태: **DRAFT — NOT FOR FABRICATION**.

부품 요구와 비용을 모으는 구매 검토용 목록이다. 제조사 부품번호·정격·실견적이 확정된 제작 BOM이 아니다. 가격 미조회 항목을 0원으로 취급하지 않는다.

**배송 계획 갱신:** 사용자에게 다른 PCB 배송 예정 건이 있으므로 합배송 우선. 단독 E-POST $5.60을 중복 배정하지 않고 실제 추가 운임을 확인한다. 확인된 부품+PCB 제작 부분 합계는 **157,818원 + 합배송 추가 운임**(1,500원/USD 가정; 나머지 미견적 항목·세금 별도). 기존 주문 상태/병합 가능성·추가 운임 미확인, 주문 병합/결제 미실행. [근거·조건](../procurement/20260917/COSTDOWN_REVIEW.md).

**2026-09-17 절감 견적:** [비용 절감·현재 장바구니](../procurement/20260917/COSTDOWN_REVIEW.md). DigiKey 8종 150,018원(배송 무료 표시), JLCPCB 5장 USD 5.20 + E-POST 한국 배송 사전 견적 USD 5.60. CAB-02를 305 mm형 2개로 바꿨다. VNA 가까운 배치/실제 케이블 경로 확인이 조건이다. JLC 배송 선택은 새로고침 시 UPS로 복귀하므로 주문 검토 때 재선택해야 한다. 기구·소모품·세금·미선정 보호/교정 준비는 빠진 부분 합계다. 코어 2판매단위는 잠정이다. 아래 과거 가격보다 이번 견적표를 우선한다. ADAPT-CAL-01은 Cinch 29-3835 후보를 유지한다.

## 1. 등록 항목

| ID | 구분 / 용도 | 품명 | 필요 수량 | 요구 규격 / 선정 조건 | 제조사·부품번호 | 길이 | 보유·신규 구매 구분 | 가격·재고·배송 조회 |
|---|---|---|---:|---|---|---|---|---|
| CAB-01 | 측정 체인 / 오실로 연결 | SMA–BNC 50 Ω 요구 완제품 케이블 | 1개 | 저가 우선 시험 후보; 공급사 도면에 조립품 RF 대역/정합 보증은 없으므로 T09로 확인. 유통사 50 Ω 표시와 실제 부품 식별 확인 | SparkFun CAB-27480 / 공급사 BCCA3788, 조건부 후보 | 1 m (도면 1000±20 mm) | 보유품과 대조 후 신규 여부 확정 | 2026-09-16 DigiKey Korea 1개 15,643원, 재고 428. 배송·세금 미확정; 보호·조달 검토서 4절 |
| CORE-01 | RF 헤드 / 1차 시제품 선정 | 44 재료 분할 코어 | 물리적 반쪽 2개 / 헤드 1개 | 유효 구경 30 mm 목표; 실제 판매 단위·접합면·권선 공간 확인. 제조사 PDF/STEP 확보; 실물/공차 확인 필요 | Fair-Rite 2644181281 | 축방향 C=12.7 mm 공칭 | 신규 구매 검토 | 2026-09-15 Mouser USD 8.73/판매단위, 수량 2 가정 USD 17.46, 표시 재고 156. 배송·세금·한국 도착일 미확정; 상세 근거는 선정 검토서 5절 |
| MECH-01 | RF 헤드 / 기구 A0.2 | PETG 트레이/덮개·나일론 힌지·나사 잠금·탄성 패드 | 1세트 + 맞춤 시험편 | 고정 반쪽에 권선/PCB/SMA. 접합면 사이 패드 금지. 캠은 맞춤 검증 후 개선 항목 | 자체 CAD/STL 작성; 부속품 MPN TBD | A0.2 공칭 CAD, 90° 스토퍼 추가, 실물 맞춤 미검증 | 신규 제작 검토 | 실견적 미조회; 기존 내부 배정 15,000원의 충족 여부 미확인 |
| WDG-01 | RF 헤드 / 권선 시작안 | 약 0.3 mm 절연 에나멜선·추가 절연층 | 5턴부터, 같은 코어로 3/7턴 재권선 | 피복 외경·절연·실제 배치 확인; 초기 영구 포팅 없음 | TBD | 리드 각각 5 mm 이하 배치 목표 | 보유품 확인 전 | 실견적 미조회; 권선·절연 비용 배정 5,000원 |

추가 등록 수량과 근거는 [보호·조달 검토서](PROTECTION_AND_PROCUREMENT.md)에 있다.

| ID | 품목 | 필요 수량 | 상태 |
|---|---|---:|---|
| CONN-01 | GCT RFPC-SMA28-F 수직 SMA jack | 1개 | 제조사 Rev.1.2 footprint 반영, ERC/DRC 통과. 2026-09-16 TME 미국 페이지 1개 USD 1.78, 재고 135; 한국 배송/세금 미확정 |
| PCB-01 | RFCP_Head_A02_DRAFT, 20×16 mm, 2층, 공칭 1.6 mm | 사용 1개 / 견적 시작 5개, MOQ 미확정 | 실크 제작 조건 보완, ERC/DRC 0, DRAFT Gerber/드릴 생성. stack-up·완성 홀 공차·견적 미확정 |
| CONN-02 | F-A 양끝 Amphenol 132139 SMA female bulkhead | 2개 | 카탈로그 기반 외형 CAD 반영, 최신 공차/실물 확인 전. 2026-09-17 DigiKey 미국 1개 구간 USD 8.58, 2개 USD 17.16, 표시 재고 2,818. 한국 배송/세금/납기 미확정 |
| FIX-MECH-01 | F-A 베이스·지지대·판·중심/귀환 도체·고정부 | 1세트 | [지그 조립 BOM](../hardware/calibration_fixture/README.md). CAD/STL·cut list 작성, 실물/가격 미검증 |
| LOAD-01 | SMA male RF 50 Ω 부하 | 2개 | F-A.OUT 일차 종단 및 through 시 헤드 종단. 교정키트의 female LOAD와 별개. 보유품 확인; TE 2467938-1은 상세 검토 전 후보 |
| CAB-02 | VNA SMA male–male 50 Ω 케이블 | 2개 | 절감 견적 후보 TE/Linx CSE-SGAM-305-SGAM 305 mm, 13,223원/개. 제조사 DC~8 GHz/RG316/50 Ω 확인. VNA 가까운 배치와 최소 내부 굽힘 반경 25.4 mm·실제 경로 확인 조건. CAB-P1/P2 개체 ID와 새 교정 필요. 배치 불가 시 610 mm 복구(+10,716원/2개) |
| ADAPT-CAL-01 | BNC female–SMA female 교정 연결용 어댑터 | 조건부 1개 | Cinch 29-3835 견적 후보: 제조사 도면에서 50 Ω, DC~4 GHz, 양쪽 female 확인. DigiKey 9,622원/1개. 종전 901-9173은 137,414원으로 제외. 개체 S2P와 BNC 기준면 검증은 별도 |
| ATT-01 | Mini-Circuits VAT-10A+ 10 dB 감쇠기 | 1개 후보 | DC~6 GHz/50 Ω, SMA male/female. RF 정격과 펄스 보호 구분. 2026-09-16 1개 USD 21.07, 재고 >1,000; 배송·세금 미확정 |
| PROT-01 | 현장 RF 보호부 | 구성 미확정 | 감쇠기만으로 현장 보호 완료라고 하지 않음 |
| CAL-KIT-01 | SMA SOL 표준 + 모델; 기본 연결안에는 female 필요 | 개방·단락·50 Ω 보유 — 사용자 확인 | 2026-09-17 사용자 진술로 세 종류 보유 확인. 실제 성별·품번·개수·표준 모델/유효 대역은 미확인. 보유품 적합성을 대조한 뒤 부족분만 검토; 신규 세트 구매를 자동 추가하지 않음 |
| CAL-THRU-01 | SMA female–female THRU + 모델 | 조건부 1개 | 두 male 테스트 케이블 사이 연결. CAL-KIT 포함이면 중복 구매 제외; 무모델 젠더를 이상 THRU로 가정하지 않음 |
| CAL-BNC-01 | 50 Ω BNC male SOL + 혼합 단자 THRU 모델, 또는 검증된 ADAPT 2포트 데이터 | 선택 경로에 따라 | 스코프 BNC 기준면 확립용. 보유/대여 우선, 가격 미조회. 두 경로를 모두 구매하는 항목이 아님 |

CAB-01 등록 근거: 사용자 지시 “저건 bom에 넣도록하고”. 케이블의 추가 필요성을 등록한 것이며, 특정 제품이나 구매를 승인한 기록은 아니다. 추적 요구사항: REQ-02, REQ-09, REQ-04, T09, SW-04.

2026-09-17 보유품 확인: 사용자가 SMA 개방·단락·50 Ω 부품을 보유한다고 알렸다. 이 진술은 CAB-01/CAB-02 케이블, THRU, BNC 표준 또는 지그용 별도 LOAD-01 2개까지 보유한다는 뜻이 아니다. 필요한 케이블은 BOM에 포함되어 있으며 실제 보유/발주는 아직 미확인이다.

CORE-01/MECH-01/WDG-01 선정 근거와 세 후보·3/5/7턴 비교는 [G1_SPLIT_CORE_SELECTION.md](G1_SPLIT_CORE_SELECTION.md)에 기록했다(DEC-011). 5턴과 30 mm는 설계 시작안이며 실측 사양이 아니다. 코어 두 반쪽이라는 물리적 필요 수량과 판매처의 주문 수량을 구분한다.

A0.1 기구 부속 수량: 나일론 M3×25 1개, M3×16 손나사 1개, M3 너트 2개, M3 와셔 1개 후보, M2×20 4개, M2×10 2개, M2 너트 6개, 비도전성 탄성 패드 3종 각 4개. [치수 조건과 조립 BOM](../mechanical/clamp_A01_DRAFT/README.md)을 따른다. 이들은 MECH-01 세부 내역으로, 기존 기구 비용에 다시 중복 합산하지 않는다. 실제 MPN·포장 최소 수량·가격은 미확정이다.

CONN-01의 [제조사 도면](references/RFPC-SMA28-F.pdf), [판매 표시 출처](https://www.tme.com/us/en-us/details/rfpc-sma28-f/sma-smb-smc-connectors/gct/). 미국 판매 표시를 한국 도착 견적으로 간주하지 않는다. 부품의 6 GHz 표기는 프로브 성능 보증이 아니다.

## 2. 연결 및 교정 조건

**2026-09-17 수량 보완:** 집게는 [A0.2](../mechanical/clamp_A02_DRAFT/README.md) 스토퍼 형상으로 진행하며 일반 헤드 부속 수량은 A0.1과 같다. 지그에 추가되는 나일론 M3×12 6개, M3×10 4개, M3 nut 10개, M2×20 2개, M2 nut 2개, 발 4개를 FIX-MECH-01에 등록한다. M2×20 두 개는 벤치에서 기존 PCB M2×10 두 개를 교체한다. SMA 자체 nut/washer와 나일론 nut를 혼동하지 않는다. 기존 지그 비용 배정에 이 상세 목록을 대입해 실견적을 다시 산출하며 이중 합산하지 않는다. [현재 구매 준비의 막힘](BUILD_READINESS_20260917.md).

- 현재 안은 `헤드 SMA → 정의된 50 Ω 동축·보호/감쇠 체인 → MSO4054의 BNC 아날로그 입력(내부 50 Ω)`이다. 케이블과 보호 부품의 물리적 순서·단자 성별은 체인 설계에서 일치시킨다.
- SMA–BNC 완제품 케이블을 사용하면 **오실로 접속을 위한 별도 변환 어댑터를 중복 계상하지 않는다.** 단순 수동 신호 연결을 위해 능동 TekVPI 프로브 어댑터를 기본 BOM에 추가하지 않는다.
- 사용 장비가 MSO4054이고 내장 50 Ω를 사용할 수 있으면, 외부 50 Ω feed-through 종단을 병렬로 추가하지 않는다. 지그의 일차 경로 끝에 필요한 50 Ω 부하는 별개다.
- 케이블 길이·부품번호·보호 체인이 정해지면 식별자를 부여하고 실제 체인의 손실·위상·반사 및 교정 이력을 관리한다. 케이블 교정이 포함된 결과에 다시 같은 손실 보정을 적용하지 않는다.
- **교정 연결:** ADAPT-CAL-01은 BNC-F/SMA-F가 기준이다. 종전 BNC-F/SMA-M은 male–male CAB-P2와 연결되지 않는다. SMA-M형을 VNA의 female 포트에 직접 꽂는 대안은 케이블 제거·새 기준면 검토가 필요하므로 기본 연결표와 섞지 않는다.
- **스코프로 이동:** SMA 기준면 교정에 ADAPT가 포함됐다면 제거 후 기존 ZT를 재사용하지 않는다. [전체 연결표와 BNC 기준면 경로](END_TO_END_REHEARSAL.md) 2~3절을 따른다. 901-9173의 [제조사 규격](https://www.amphenolrf.com/en-us/part/901-9173/7570/)은 성별·50 Ω·4 GHz 확인 근거이며 개체 교정 데이터가 아니다.
- 감쇠기/SMA 플러그를 헤드에 직접 체결할 공간은 미확인이다. 낮게 내려오는 큰 몸통과 덮개 간섭 가능성이 있다. 실제 체결 깊이를 확인하고 필요한 경우 별도 짧은 SMA 케이블을 추가하되 수량/비용/체인 ID/교정을 함께 갱신한다.

참고: [Tektronix의 SMA 출력–TekVPI BNC 입력 연결 안내](https://www.tek.com/ja/support/faqs/how-do-i-connect-sma-male-output-oscilloscopes-tekvpi-bnc-inputs). 이 자료는 접속 방식의 근거이며 CAB-01의 제품별 주파수 사양·길이·가격을 검증한 자료는 아니다.

## 3. 전체 비용표에 추가할 항목

다음 항목은 일부 시작안을 선정했으나 확정 견적은 없다. 등록 품목만으로 전체 시스템 비용을 판단하지 않는다.

| 항목 | 다음 확인 |
|---|---|
| 코어 | CORE-01: 2644181281 두 반쪽으로 첫 시제품 선정. 판매 단위·도면·권선 공간 및 실물 확인 |
| 권선·절연·차폐 | 도선·권선 배치·리드 길이·절연·차폐 경로 |
| 헤드 PCB·SMA | 실제 stack-up, 커넥터 부품/footprint, 조립 부품 |
| 교정지그·50 Ω 부하·교정용 동축/어댑터 | 전류 경로·지그 기준면과 장비 보유품 대조 |
| 수신기 보호·감쇠 | 정격·펄스 조건·RF 응답과 필요한 부품 구성 |
| 기구·스페이서·고정부 | 힌지·잠금·접합면 정렬, 열림 공간과 케이블/다발 간섭, 개폐·위치 반복성 |
| 제작·배송·세금·재작업 여유 | 실제 주문 수량과 공급처 견적 |

기존 LibreVNA 및 오실로스코프 구입비는 신규 비용에서 제외한다. 신규 지출은 **10만 원 목표 / 20만 원 상한**이다. 선정 검토서 5절의 내부 비용 배정 합계는 **175,000원**으로, 목표보다 75,000원 높고 상한보다 25,000원 낮다. 이는 실견적 합계가 아니며 예산 충족은 미검증이다. 보유품 재사용과 실제 견적으로 줄이되 보호·검증을 생략하지 않는다. 각 견적에는 조회일·수량·통화·배송·세금을 기록한다.

## 4. 다음 결정의 담당 구분

- **장착 방식 결정 완료:** 사용자 선택에 따라 집게형으로 진행한다(DEC-010). 커넥터를 분리해 구멍에 통과시키는 방식은 기본안에서 제외한다.
- **에이전트가 비교·제안:** 코어·권선·차폐, 교정지그, 케이블 부품/길이, 보호 체인, 예산. 사용자에게 재료나 회로 값을 임의 선택하도록 요구하지 않는다.
- **제조/측정 전에 실물로 확인:** 실제 케이블/다발 굵기·집게를 여닫을 주변 공간·인접 커넥터 간섭, MSO4054 명판 및 입력 상태, LibreVNA 버전·교정키트·RF 부속품 보유 목록.

분할 코어·권선·잠금 구조의 시작안 선정은 완료했다. 도면·기구 배치·교정지그 경로·분석 도구를 준비했다. 다음은 보유품 대조·실견적과 첫 벤치 데이터로 후보를 검증하는 일이다. 닫힌 코어 후보 5943003801 및 5961003801은 현재 집게형 BOM에서 제외한다. 대안 코어는 첫 구매 수량에 포함하지 않는다.

## 5. 후속 비용 검토 — 2026-09-16

기존 175,000원은 DEC-011 당시의 내부 배정이다. 케이블/감쇠 후보 가격과 보호 예비비를 적용한 후속 가정 시나리오는 약 **195,020원**이다. [계산 조건과 출처](PROTECTION_AND_PROCUREMENT.md)를 함께 읽는다. 이번에 구체화한 THRU/BNC 기준면 확보의 신규 비용은 그 시나리오에서 확정되지 않았다. 전체 실견적은 아니며 보호부·교정 준비·배송·세금·보유품에 따라 20만 원 상한을 넘을 수 있다. 가격 미조회 항목을 0원으로 합산하지 않는다.
