ckh7488/rf_current_probe/docs/history/BOM_DRAFT_0.12.md

# RF Current Probe — 시제품 선정 BOM

2026-09-17 · **Rev.0.12 · DRAFT — NOT FOR FABRICATION**

**집게와 교정지그의 MECH를 필수 항목으로 포함한 첫 시제품 구매안이다.** 품목·수량·출력 재료와 실제 판매 가격을 정리했다. 실물 맞춤, RF 성능, 현장 보호까지 검증한 양산 BOM은 아니다. 이전 [0.11](history/BOM_DRAFT_0.11.md)은 이력으로 보존한다.

현재 확인 금액 **259,336원 + 해외 세금·PCB 합배송 추가 운임·아래 미확정 항목**. 1 USD=1,500원은 비교용 가정이며 실시간 환율이 아니다. **20만 원 상한보다 확인 금액만 59,336원 높아 발주 보류**다. [전체 견적·장바구니·남은 항목](../procurement/20260917/FULL_BOM_REVIEW.md)을 우선한다. 구매·결제는 실행하지 않았다.

## 1. 보유품과 중복 구매 제거

| 항목 | 현재 반영 | 새로 구매 |
|---|---|---:|
| LibreVNA, Tektronix MSO4054 | 기존 장비 사용; 실제 모델/설정은 시험 때 기록 | 0 |
| SMA 수–수 케이블 | LibreVNA 동봉품 1개 보유, CAB-P1/P2 중 하나로 식별 | 부족한 1개만 |
| SMA OPEN/SHORT/LOAD | 사용자 보유 확인. 성별·모델값·유효 대역은 대조 필요 | 세트 추가 없음 |
| 외장 RF 50 Ω 로드 | 사용자 보유/별도 약 6개 구매 계획 반영. 이 프로젝트에는 추가 주문 없음 | 0 |
| SMA female–female THRU | 키트 포함 여부와 모델 미확인 | 보유품 대조 후 부족할 때만 |

**외장 로드는 최소 1개를 이동해 사용 가능하다.** Through/삽입 영향 시험은 VNA P2가 지그를 종단하고 외장 로드는 헤드에 둔다. Transfer 시험은 RF OFF 후 그 로드를 F-A.OUT로 옮기고 P2를 헤드에 연결한다. `HEAD-LOAD`와 `PRIMARY-LOAD`는 역할 이름이며 같은 개체 ID를 써도 된다. 헤드와 지그 단자는 SMA 암이므로 이 로드는 표준 SMA 수가 필요하다. 보유 로드의 성별 확인 답변 대기 중이다.

## 2. DigiKey — RF 부품 및 나일론 체결 부품

[현재 16종 장바구니 복사본](https://www.digikey.kr/short/hp30z5m7) · [재입력 목록](../procurement/20260917/digikey_bulk_full_bom.txt)

가격: 2026-09-17, KRW, 장바구니 표시 단가/수량 기준. 세금 별도, 배송 무료 표시.

| ID | 용도 | 제조사 품번 | 구매 수량 | 표시 행 금액(원) |
|---|---|---|---:|---:|
| CAB-01 | 오실로 연결 SMA 수–BNC 수 케이블 1 m | 27480 | 1 | 15,643 |
| CONN-01 | 헤드 PCB의 SMA 암 단자 | RFPC-SMA28-F | 1 | 2,578 |
| ATT-01 | 10 dB 감쇠기; 현장 서지 보호와 별개 | VAT-10A+ | 1 | 36,413 |
| CAB-02 | 추가 VNA SMA 수–수 케이블 305 mm | CSE-SGAM-305-SGAM | 1 | 13,223 |
| CORE-01 | 44 재료 분할 페라이트 코어 | 2644181281 | 2 | 26,590 |
| CONN-02 | 지그 양끝 SMA 암 벌크헤드 | 132139 | 2 | 24,718 |
| ADAPT-CAL-01 | BNC 암–SMA 암 교정 연결 어댑터, 조건부 | 29-3835 | 1 | 9,622 |
| MECH-M2X20 | 덮개 4 + 지그 PCB 브래킷 2 | 50M020040P020 | 6 | 1,037 |
| MECH-M2X10 | 지그에서 분리한 헤드 PCB 고정 | 50M020040P010 | 2 | 404 |
| MECH-M2NUT | 덮개/PCB/브래킷 너트 | 04M020040HN | 8 | 1,522 |
| MECH-M3X25 | 힌지 축 | 50M030050P025 | 1 | 216 |
| MECH-M3X16-LATCH | 잠금 나사; 십자드라이버 사용 | 50M030050P016 | 1 | 216 |
| MECH-M3X12 | 지그 베이스 체결 | 50M030050P012 | 6 | 1,020 |
| MECH-M3X10 | 지그 금속판 체결 4 + 예비 1 | 50M030050P010 | 5 | 850 |
| MECH-M3NUT | 집게 2 + 지그 10 | 04M030050HNDIN34814 | 12 | 2,800 |
| MECH-M3WASHER | 힌지 여유 조정용 와셔 | MFW030A | 1 | 144 |

장바구니 합계 **136,995원**. 소수 원 단가의 행별 반올림 때문에 표시 행 금액을 더하면 1원 높다. 장바구니 총액을 채택했다. 헤드 SMA는 **2026-09-21 입고 예상 백오더**, 나머지는 조회 시 즉시 공급 표시다. 예상 입고일은 배송 보증이 아니다.

- **코어:** Fair-Rite 2644181281로 시제품 선정. 물리적 반쪽 2개가 필요해 주문량 2를 유지한다. 제조사 구형 분할 코어 카탈로그의 낱개 판매 안내를 근거로 삼되, 해당 최신 DigiKey 포장의 낱개/쌍 여부는 아직 명시 확인되지 않았다. 부족하지 않게 2판매단위로 견적했으며 포장이 쌍이면 잉여 반쪽이 생긴다. 모델·접합면·치수는 입고 검사한다.
- **체결 부품:** Essentra 나일론 6/6. M2 머리 최대 Ø4.0×1.6, M3 머리 최대 Ø5.6×2.4 mm. M2 nut 대변 3.9 mm 공칭/높이 1.2, M3 nut 대변 최대 5.5/높이 최대 2.4 mm. MFW030A는 ID3.2/OD7/두께0.5 mm. 제조사 [Fasteners 카탈로그](references/bom_20260917/Essentra_Fasteners.pdf) 참조.
- **잠금:** M3×16 나일론 십자 나사로 구체화했다. 이전 손나사 후보를 대신하는 첫 시제품 선택이며, 작은 드라이버를 사용한다. 캠 잠금/공구 없는 개방을 구현한 상태가 아니다.
- **실제 수행한 검사:** 최대 나사 머리와 와셔 외형을 기존 CAD에 대입한 닫힘 상태 **19곳 공칭 간섭 0**. [검사 출력](../procurement/20260917/selected_fastener_checks.json). 나사산·힘·출력 공차·동작 수명 검증은 아니다. 원본 CAD를 변경하지 않았다.
- **출력 체인:** 수신기 쪽 단일 50 Ω. 헤드에 병렬 종단 저항을 추가하지 않는다. VAT-10A+ 직접 체결 공간은 실제 결합 깊이 확인이 남아 있다. CAB-02는 기존 보유 케이블과 함께 가까운 벤치 배치/굽힘 반경을 확인한다.

## 3. PCB와 필수 기구 출력

PCB는 [A0.2](../hardware/probe_head_A02/README.md), 20×16 mm, 2층, 공칭 1.6 mm, 1 oz, Green/White, LeadFree HASL. **5장 $5.20**, 사용 1장. JLC 장바구니 `Y19-9961994A`. 기존 사용자 PCB 배송과 합배송하되 실제 증가 운임은 미확정이다. 기존 ERC/DRC 결과는 유지하며 이번에 다시 실행했다고 보고하지 않는다. 완성 홀/stack-up 제작 조건의 최종 수락은 남아 있다.

**MECH-01 + FIX-MECH-01: 집게 A0.2 5개 + 지그 F-A A0.1 4개, 전부 각 1개.** 현재 STL 형상을 유지하고 외주 시작 재료를 **JLC3DP SLS 3201PA-F Nylon / Grayish Black**으로 선정했다. JLC 기본 표면 상태, 추가 표면처리 없음, 나사산 출력/탭 추가 없음. CAD 내부 PETG 라벨은 이전 재료 시작안의 이력이며 이번 외주 발주 검토에는 본 BOM 재료가 우선한다.

| STL | 수량 | 출력 견적 |
|---|---:|---:|
| FixedTray_DRAFT.stl | 1 | $3.51 |
| MovingTray_DRAFT.stl | 1 | $3.29 |
| FixedKeeper_DRAFT.stl | 1 | $1.04 |
| MovingKeeper_DRAFT.stl | 1 | $1.04 |
| FitCoupon_DRAFT.stl | 1 | $1.04 |
| Base_DRAFT.stl | 1 | $19.71 |
| InputStand_DRAFT.stl | 1 | $2.68 |
| OutputStand_DRAFT.stl | 1 | $2.68 |
| HeadBracket_DRAFT.stl | 1 | $1.48 |

**출력 $36.47 + 한국 E-POST 사전 운임 $7.24 = $43.71**, 약 65,565원. 3일 제작/배송 10~16영업일 표시. 9개 모두 [JLC 장바구니](https://jlc3dp.com/kr/shopcart/cart)에 저장했다. 주문 전 생산 검토·배송 재계산은 남아 있다. PCB 합배송과 3DP 배송을 자동으로 같은 것으로 가정하지 않는다.

출력 선정 근거와 제한:

- 기존 FDM ABS 견적은 얇은 부품 4개를 최소 크기로 거부했다. SLS는 현재 9개 형상에 자동 견적이 나왔다. 값싼 SLA 9600 비교안은 힌지/잠금 수명 검증 없이 기본안으로 채택하지 않았다.
- [제조사 재료 안내](https://jlc3dp.com/help/article/3201pa-f-nylon)의 공차는 100 mm 이하 ±0.3 mm, 초과 ±0.4%. **CAD의 0.2 mm 홀 여유를 보장하지 못한다.** 시험편 → 빈 하우징 → 코어 순으로 맞추고 필요하면 홀을 핀바이스/드릴로 정리하고 너트 홈을 소량 다듬는다. 힌지 정렬 불량은 억지 체결하지 않는다.
- 재료 안내에 전기 저항률이 없어 전기 절연 인증으로 취급하지 않는다. 입고 시 표면 도통/직접 픽업을 확인한다. 금속/탄소 충전·ESD 재료를 임의 대입하지 않는다.
- 코어 접합면에는 테이프·접착제·패드가 들어가지 않는다. 패드 강도/잠금 힘과 출력 공차는 실물에서 조정한다. 지그 도체는 코어 안 중심/코어 밖 귀환을 유지한다.

## 4. 권선·절연·패드·지그 동판

아래 금액은 국내 소매 표시 또는 명시된 VAT 포함 금액이다. 2026-09-17 실제 옵션을 선택하고 장바구니 저장을 확인했다. 제조사 성적서가 없는 범용 원재료는 판매 규격과 입고 확인을 구분한다.

| ID | 선정품/구매 링크 | 구매 수량 | 상품 금액(원) | 판매처 |
|---|---|---:|---:|---|
| PAD-01 | [반투명 실리콘판 300×300×2 mm, 50 Shore A](https://m.siliconehose.co.kr/goods/goods_view.php?goodsNo=1000000299) | 1 | 5,500 | SiliconePlus / H+GN |
| PAD-02 | [반투명 실리콘판 300×300×1.5 mm, 50 Shore A](https://m.siliconehose.co.kr/goods/goods_view.php?goodsNo=1000000299) | 1 | 5,500 | SiliconePlus / H+GN |
| CU-PLATE | [동판 100×200×1 mm](https://item.gmarket.co.kr/Item?goodsCode=1483969490) | 1 | 7,500 | Gmarket / dbs |
| CU-STRIP | [적동 띠 25×300×0.5 mm](https://www.gmtool.co.kr/goods/goods_view.php?goodsNo=1000001650) | 1 | 2,000 | GMTOOL |
| WDG-01 | [권선용 에나멜 동선 Ø0.30 mm, 1묶음](https://www.11st.co.kr/products/225633016) | 1 | 1,500 | 11st / 09one |
| CU-BRIDGE | [지그 납땜 브리지용 에나멜 동선 Ø0.50 mm, 1묶음](https://www.11st.co.kr/products/225633016) | 1 | 2,000 | 11st / 09one |
| INS-01 | [KzPton 폴리이미드 단면 테이프 10 mm×33 m, 필요 폭으로 재단](https://eleparts.co.kr/goods/view?no=557) | 1 | 4,059 | Eleparts |
| ADH-01 | [Shin-Etsu KE45T 투명 RTV 100 g](https://eleparts.co.kr/goods/view?no=2106) | 1 | 4,917 | Eleparts |

판매처별 상품+배송: SiliconePlus **14,000원**, Gmarket **11,000원**, GMTOOL **5,500원**, 11번가 **6,500원**, 엘레파츠 **11,976원**. 합계 **48,976원**. 국내 배송지/도서산간 조건에 따라 달라질 수 있다.

사용/가공 규격:

1. **권선:** Ø0.30 mm 에나멜 동선으로 5턴부터 시작, 같은 코어에 3/7턴 재권선. CAD 가정 피복 외경은 0.4 mm이므로 실측 후 홈/패드 간섭 확인. 판매 제목 5 m와 본문 3 m가 불일치해 재료 계획은 보수적으로 **묶음당 최소 3 m**로 잡았다. 두 경우 모두 첫 시제품 재권선에 충분한 시작 재고다. 절연 등급/피복 외경을 인증 사양으로 만들지 않는다.
2. **절연:** KzPton 테이프를 필요한 길이만 잘라 약 5 mm 폭으로 재단한다. 권선과 페라이트의 마찰 방지용 얇은 한 겹부터 맞춘다. 총 두께는 판매 텍스트에서 확인되지 않아 입고 측정 항목이다. 접합면을 덮지 않으며 고전압 보호 절연으로 사용하지 않는다.
3. **패드:** 2 mm 시트에서 4×4 mm 4개 + 4×10 mm 4개, 1.5 mm 시트에서 2.5×4 mm 4개. 50 Shore A는 첫 시험 선정값이며 코어가 무리 없이 닫히도록 압축량을 조정한다.
4. **발:** 남은 1.5 mm 시트에서 12×12 mm 8개를 잘라 두 겹씩 붙여 3 mm 높이 발 4개를 만든다. 별도 고무발 구매를 중복 계상하지 않는다.
5. **접착:** KE45T는 패드 가장자리–플라스틱과 발 적층에 최소량 사용한다. 코어 접합면/권선 영구 포팅에는 쓰지 않는다. [제조사](https://www.shinetsusilicones.com/rtv_print.aspx?ID=KE-45) 시험 경화 조건은 23°C/50%RH에서 7일이다. SLS 나일론/실리콘 시트 실제 접착은 작은 조각으로 먼저 확인한다.
6. **동판:** 1 mm 판에서 128×24 mm 2개. 중앙 D홀 Ø6.5/높이6.0, 체결 Ø3.4 두 개(X=±59,Y=−8). 0.5 mm 띠에서 60×10 mm 귀환 2개 + 44.2×8 mm 중심 도체 1개. 100×200 판과 25×300 띠에서 각 부품이 나온다. 절단 폭 여유를 두고 줄로 마감한다.
7. **컵 브리지:** Ø0.50 mm 에나멜 동선의 피복을 완전히 벗기고 주석 도금해 약 4 mm 2개를 만든다. 중심 strip과 132139 solder cup을 연결한다. 실제 삽입 깊이/납땜 후 치수를 기록한다.

동판 가격에는 **가공비가 없다.** 금속 절단·드릴·줄·버 제거와 납땜을 할 수 있는 작업 수단이 필요하다. 공구 신규 구매/외주 금속 가공·일반 납땜 소모품 부족분은 아직 견적에 포함하지 않았다. 납땜은 플라스틱/코어를 분리한 상태에서 한다. 상세 조립은 [지그 안내](../hardware/calibration_fixture/README.md)를 따른다.

## 5. 선정 완료와 실제로 남은 항목

| 구분 | 현재 결론 | 남은 조건 |
|---|---|---|
| RF 헤드·PCB·지그·기구·나사·원재료 | 위 품번/규격으로 첫 시제품 선정·견적/장바구니 완료 | 첫 출력/입고 치수·납땜/조립·RF 시험 |
| LOAD/CAB 보유품 | 로드 신규 0, SMA 수–수 케이블 신규 1 | 로드 단자/유효 대역, 기존 케이블 상태/길이 |
| CAL-THRU-01 | 부족할 때 TE/Linx ADP-SMAF-SMAF-G 후보, 1개 **9,881원** 별도 | 키트 포함 여부·제조사 도면/모델 검증. 무모델 젠더를 이상 THRU로 설정 금지. 장바구니 미추가 |
| CAL-BNC-01 | BNC 표준 대여 또는 검증된 어댑터 S2P 중 보유 수단에 맞춰 선택 | 사용 가능한 기준/표준 모델이 없어 최종 확정 불가. 전압/상대 관측은 별도 단계 |
| PROT-01 | 저레벨 VNA 수동 지그 단계에는 현장 보호부를 임의 구매하지 않음 | 현장 펄스/입력 조건·실측 감도 없이는 부품값과 보호 성능 확정 불가. 현장 사용 보류 |
| 제조/장착 | 기존 DRAFT 형상 유지, 나사 머리/와셔 공칭 검사 완료 | SMA 포장·완성 홀/stack-up·플러그/감쇠기 실제 체결·출력 공차·케이블 공간 |
| 비용 | MECH 포함 259,336원 + 미확정 비용 | 20만 원 상한 초과. 예산/단계 조정 후 주문 검토 |

**값을 하나로 골랐다는 것과 성능 검증이 끝났다는 것을 구분한다.** 첫 재료 선택은 진행했지만 위 실물/사용 조건 없이는 모든 미확정을 없앨 수 없다. RF 대역·정밀도·보호 정격은 미측정이다.
