ckh7488/rf_current_probe/viewer_A05/audit_sources/nut_access_20260918/BOM_DELTA.md

# A11/C05 → A12/C06 기구 BOM 변경

2026-09-18 · 수량은 앞뒤 클램프 2개를 포함한 전체 조립체 기준. 가격·발주 변경 없음.

| 항목 | 이전 | 이번 | 비고 |
|---|---:|---:|---|
| 공용 나일론 너트 덮개 | 0 | 10 | 프로브 2 + 교정 PCB 4 + 가로대 4. 출력 원본 1종. |
| 바닥 격자 너트 유지판 | 0 | 1 | 별도 출력 원본 1종. |
| 교정 PCB M3 나일론 육각 너트 | 4 | 0 | 교체 대상만 제외. 코어 고정바 등 다른 M3 너트는 유지. |
| Kang Yang SMO-3(N), M3 PA66 날개 너트 | 0 | 4 | [제조사 도면](https://www.kangyang-europe.com/wp-content/uploads/product_files/pdf/SMO-3.pdf). 임의의 더 큰 금속 날개 너트로 대체 금지. |
| 밑판용 M4×12 육각소켓 볼트 | 0 | 2 | 모델 머리 Ø7×4 mm. 실제 볼트 규격/머리/길이를 대조. |
| 밑판용 M4 사각 너트 | 0 | 2 | 모델 7×7×3.2 mm. |
| 구경 노브 축용 얇은 M6 잠금너트 | 4 | 0 | 두 개씩 서로 잠그는 방식 제거. |
| 구경 노브 축용 M6 풀림 방지 너트 | 0 | 2 | **Bossard BN 33024 / 5813950**, DIN985 M6×1, A2/나일론 삽입부, 대변10/높이6 mm 설계 기준품. [제조사](https://www.bossard.com/global-en/eshop/locking-nuts-with-polyamide-insert/prevailing-torque-type-hex-lock-nuts-thin-type-with-polyamide-insert/p/33024/). |
| 바닥 모듈용 M4×20 | 6 | 6 | 유지. M4×25로 임의 대체하지 않음. |
| 교정 PCB 나사 M3×12 | 4 | 4 | 유지. 기존 나일론 체결 조건 유지. |

추가 출력물 **2종 / 11개** → 전체 **12종 / 26개**. `optional_fit_sample`의 작은 출력 샘플 두 개는 선택형 시험편이며 이 조립체 수량에 더하지 않는다.

새 덮개 장착 위치와 받침 형상이 바뀌었으므로, 기존 출력물에 덮개만 추가하는 개조 키트가 아니다. 출력은 A12/C06의 전체 부품 목록과 수량을 기준으로 준비한다. 이전 공급사 업로드·가격·카트는 갱신하지 않았다.
