ckh7488/rf_current_probe/docs/REQUIREMENTS.csv

id | requirement_kind | knowledge_class | requirement | source_section | verification_method | test_ids | acceptance_or_limit | stage | verification_status | evidence | open_items
DOC-01 | REQUIREMENT | KNOWN_FROM_DOCUMENT | 기존 파일 보존 및 G0 상태·요구사항·결정·작업계획 관리 | 16.2|19:G0|20.1 | 파일 목록 및 문서 참조 검토 | REVIEW-DOC | 문서 관리와 제품 검증 상태 분리 | G0 | VERIFIED | docs/STATUS.md|docs/DECISIONS.md|docs/REQUIREMENTS.csv; reviews/document_full_audit_20260922/README.md; complete document census and source-bound checks; reviews/full_reinspection_20260928/REPORT.md; fresh source/calculated/synthetic audit only, no measured pass; reviews/fresh_system_audit_20260928/REPORT.md; fresh R2+A16 file/geometry/FEA/software audit, not physical verification; reviews/pcb_function_audit_20260928/REPORT.md; fresh R2 PCB/ZIP/pad/topology/mount/function audit; annotation correction only; no measured pass; reviews/c10_guide_fix_20260928/REPORT.md; A17/C10 local guide support, same structural criterion and saved-CAD/reproduction checks; physical/RF remain unverified
REQ-01 | REQUIREMENT | KNOWN_FROM_DOCUMENT|MEASUREMENT_REQUIRED | 전원 없는 수동 CT 방식이며 일차 케이블과 계측 회로 사이 의도적인 도전 접속 없음 | 4.1 | 회로·구조 검토 및 접속 검사 | T01 | 의도치 않은 도통 없음; DMM 검사는 내전압 시험이 아님 | G3|G4 | PARTIAL | ; reviews/pre_jlc_review_20260922/README.md; current design/source check only; physical measurement pending; reviews/full_reinspection_20260928/REPORT.md; fresh source/calculated/synthetic audit only, no measured pass; reviews/fresh_system_audit_20260928/REPORT.md; fresh R2+A16 file/geometry/FEA/software audit, not physical verification | TBD-04|TBD-05
REQ-02 | REQUIREMENT | KNOWN_FROM_DOCUMENT|USER_CONFIRMATION_REQUIRED|MEASUREMENT_REQUIRED | 헤드 기본 출력 SMA 및 측정 부하 50 Ω | 4.1|9.2 | 종단 회로와 실제 출력 체인 확인 | T01|T09 | 수신기 측 단일 50 Ω 종단을 기본으로 함 | G3|G4 | PARTIAL | ; reviews/pre_jlc_review_20260922/README.md; current design/source check only; physical measurement pending; reviews/full_reinspection_20260928/REPORT.md; fresh source/calculated/synthetic audit only, no measured pass; reviews/fresh_system_audit_20260928/REPORT.md; fresh R2+A16 file/geometry/FEA/software audit, not physical verification; reviews/pcb_function_audit_20260928/REPORT.md; fresh R2 PCB/ZIP/pad/topology/mount/function audit; annotation correction only; no measured pass | TBD-01|TBD-07
REQ-03 | REQUIREMENT | KNOWN_FROM_DOCUMENT|USER_CONFIRMATION_REQUIRED|MEASUREMENT_REQUIRED | LibreVNA 2-port 구성으로 헤드와 측정 체인 특성화 가능 | 4.1|11.4 | 장비 버전·교정·연결 기록 및 특성화 | T02|T03|T09 | 실제 지원 범위와 기준면을 확인한 원시 데이터 확보 | G2|G4 | NOT_VERIFIED |  | TBD-02|TBD-06
REQ-04 | REQUIREMENT | KNOWN_FROM_DOCUMENT | 코어·권선·차폐·PCB·출력 케이블 식별과 개별 교정 이력 보관 | 4.1|16.3|20.1 | 구성 및 메타데이터 검토 | REVIEW-DATA|T09 | 구성 변경 시 교정 재사용 검토 및 이력 보존 | G2|G4 | PARTIAL | ; reviews/pre_jlc_review_20260922/README.md; current design/source check only; physical measurement pending; reviews/full_reinspection_20260928/REPORT.md; fresh source/calculated/synthetic audit only, no measured pass; reviews/fresh_system_audit_20260928/REPORT.md; fresh R2+A16 file/geometry/FEA/software audit, not physical verification | TBD-04|TBD-05
REQ-05 | REQUIREMENT | KNOWN_FROM_DOCUMENT | 원시 S-parameter와 계산된 전달 임피던스를 함께 보관 | 4.1|16.2|16.4 | 원시 및 처리 파일 추적 검토 | REVIEW-DATA | 원시 파일 불변 및 재생성 가능한 처리 결과 | G2|G4 | PARTIAL | ; reviews/pre_jlc_review_20260922/README.md; current design/source check only; physical measurement pending; reviews/full_reinspection_20260928/REPORT.md; fresh source/calculated/synthetic audit only, no measured pass; reviews/fresh_system_audit_20260928/REPORT.md; fresh R2+A16 file/geometry/FEA/software audit, not physical verification
REQ-06 | REQUIREMENT | KNOWN_FROM_DOCUMENT|MEASUREMENT_REQUIRED | 장착 반복성·전류 상쇄·직접 픽업·선형성·삽입 영향 시험 | 4.1|14.1 | 백서 필수 시험 수행 | T04|T05|T06|T07|T08|T10 | 목표와 실제 결과를 구분하고 실패 구간 보존 | G4 | NOT_VERIFIED |  | TBD-08|TBD-09
REQ-07 | REQUIREMENT | KNOWN_FROM_DOCUMENT|USER_CONFIRMATION_REQUIRED | 보호접지·쉴드를 임의로 끊거나 계측기 접지를 부유시키지 않음 | 4.1|13.1 | 접속·작업 절차 및 현장 안전 검토 | REVIEW-SAFETY|T01 | PE 제거·DUT 쉴드 임의 절단·계측기 임의 부유 금지 | G2|G3|G5 | NOT_VERIFIED |  | TBD-07
REQ-08 | REQUIREMENT | KNOWN_FROM_DOCUMENT|MEASUREMENT_REQUIRED | 회로 검토와 실측 없이 내전압·허용 전류·서지 내성 표시 금지 | 4.1|13.2 | 도면·라벨·사용 범위 검토 | REVIEW-SAFETY | 검증 없는 안전 정격 또는 CAT 표시 없음 | G3|G5 | NOT_VERIFIED |  | TBD-07|TBD-08
REQ-10 | REQUIREMENT | KNOWN_FROM_DOCUMENT | 기존 Ethernet SI 지그와 별도 설계하고 RF 헤드에 RJ45/PHY를 넣지 않음 | 4.1|0 | 구성 및 회로 검토 | REVIEW-SCOPE | Rev.A에 ADC/MCU/GUI/종합 인증 기능 추가하지 않음 | G1|G3 | VERIFIED | ; reviews/pre_jlc_review_20260922/README.md; current design/source check only; physical measurement pending; reviews/full_reinspection_20260928/REPORT.md; fresh source/calculated/synthetic audit only, no measured pass
TGT-01 | TARGET | MEASUREMENT_REQUIRED | 1–150 MHz 판정용 측정(반복성 ±1 dB·절대 ±2 dB 목표) 우선 확보 | 4.2|14.5|DEC-055 | T02~T09 및 유효 대역 평가 | T02|T03|T04|T05|T06|T07|T08|T09 | 14.5절 표로 판정; 목표 미달 구간은 참고용으로 표시하고 기록 유지 | G4 | NOT_VERIFIED |  | TBD-06|TBD-08
TGT-02 | TARGET | MEASUREMENT_REQUIRED | 전체 범위 100 kHz~500 MHz를 14.5절 대역별 목표로 표기(0.1–300 MHz 판정용, 300–500 MHz 참고용) | 4.2|14.5|DEC-055 | 장비 유효 범위 내 특성화 | T03 | 실측 이전 보장 대역이나 전 대역 동일 정확도로 표시하지 않음 | G4 | NOT_VERIFIED |  | TBD-02|TBD-08
TGT-03 | TARGET | MEASUREMENT_REQUIRED | 현행 A03으로1–500 MHz 보정·특성화 수행; 100 kHz~1 MHz 저주파 감도 추가 확인 | 4.2|11.6|DEC-053 | 장착 through·전달·외장 로드 반사·K를 사용한 주파수별 환산과 오차 평가 | T03|REVIEW-SCOPE | 500 MHz 보정을 수행 범위에 포함; 센서 평탄 대역·실측 정확도는 별도 기록 | G4 | NOT_VERIFIED |  | TBD-02|TBD-08
TGT-04 | TARGET | KNOWN_FROM_DOCUMENT|KNOWN_FROM_USER|MEASUREMENT_REQUIRED | 사용자 확정 실제 대상 최대 약20 mm 수준에 대해 현행 공칭26 mm 기준의 여유 확보; 커넥터를 빼지 않고 장착 | 4.2|9.4|DEC-049 | 공차·권선·절연을 반영한 닫힌 공간과 열린 진입 폭 및 실제 케이블/다발 장착·성능 비교 | REVIEW-MECHANICAL|T03|T05|T06|T08|T10 | 현행 헤드 공칭 통과지름26.40 mm, A18/C10 클램프 공칭6–26 mm; 초기30~35 mm 목표는 사용자 확인으로 대체. 제조공차 포함 최대구경 보증 아님 | G1|G3 | PARTIAL | reviews/independent_release_review_20260922/aperture_diagnosis.json; reviews/full_reinspection_20260928/REPORT.md; fresh source/calculated/synthetic audit only, no measured pass; reviews/fresh_system_audit_20260928/REPORT.md; fresh R2+A16 file/geometry/FEA/software audit, not physical verification | TBD-03
TGT-05 | TARGET | ASSUMPTION_TO_VALIDATE|MEASUREMENT_REQUIRED | 중간 대역 수 Ω~수십 Ω 감도 및 mA급 RF 비교 측정 검토 | 4.2|7 | 모델 비교 및 체인 잡음 측정 | T03|T04|T09 | 감도보다 대역·재현성·삽입 영향 우선; 검출 하한 실측 | G1|G4 | NOT_VERIFIED |  | TBD-08
TGT-06 | TARGET | MEASUREMENT_REQUIRED | 절대 정확도 초기 목표: 0.1–1 MHz ±3 dB, 1–150 MHz ±2 dB, 150–300 MHz ±3 dB, 300–500 MHz 판정 제외 | 14.3|14.4|14.5|DEC-055 | 독립 기준 및 오차 예산 평가 | REVIEW-UNCERTAINTY|T03|T05|T06|T09 | 입증 전 성능표에 기재하지 않음; 미평가 불확도는 0이 아님 | G4 | NOT_VERIFIED |  | TBD-06|TBD-08
SENS-01 | REQUIREMENT | KNOWN_FROM_DOCUMENT | 부호와 통과 횟수를 포함한 합전류 IΣ를 원시 보고 단위로 사용 | 3.1|5 | 정의·환산·해석 검토 | SW-UNITS|T07 | 페어 Icm 정의 사용 시 IΣ=2×Icm 등 환산 명시 | G2|G4|G5 | NOT_VERIFIED
SENS-02 | REQUIREMENT | KNOWN_FROM_DOCUMENT|MEASUREMENT_REQUIRED | 부담·코어·배선에 따른 삽입 영향과 DC/저주파 bias 고려 | 7.4|7.5 | 정상 왕복 도체 포함 여부 및 부하 변화 검토 | T10|REVIEW-SAFETY | DC 비전달을 코어 무영향으로 해석하지 않음; 허용 순 DC 전류 미확정 | G1|G4|G5 | NOT_VERIFIED |  | TBD-08|TBD-09
SENS-03 | REQUIREMENT | ASSUMPTION_TO_VALIDATE|MEASUREMENT_REQUIRED | 코어 2644181281에 5턴 기본·3턴 선택; 권선 직후 헤드 출력 S11로 자기공진 기록 | 8.1|8.2|19:G1|DEC-055 | 제조사 자료·형상·AL·복소 투자율 및 조립 비교 | REVIEW-CORE|T03|T05 | 억제 대역을 센서 평탄 대역으로 대입하지 않음; 3턴은 필요한 대역이 14.5절 목표에 못 미칠 때만; 턴수마다 교정 ID 분리 | G1|G2 | PARTIAL | reviews/recheck_20260922/SENSOR_DESIGN_SCREEN.md; manufacturer N=1 data / CALCULATED parasitic scenarios / 3-5-7 turn CAD envelopes; measured ZT pending; reviews/independent_release_review_20260922/sensor_independent.json; reviews/full_reinspection_20260928/REPORT.md; fresh source/calculated/synthetic audit only, no measured pass; reviews/fresh_system_audit_20260928/REPORT.md; fresh R2+A16 file/geometry/FEA/software audit, not physical verification | TBD-04|TBD-05|TBD-10
CAL-01 | REQUIREMENT | KNOWN_FROM_DOCUMENT|MEASUREMENT_REQUIRED | 지그 중심 전류는 코어 안을 통과하고 귀환은 코어 밖으로 흐름 | 10.1 | 도면·3차원 전류 경로 검토 및 지그 측정 | REVIEW-FIXTURE|T02|T07 | 신호와 바로 아래 GND 또는 동축 전체의 동시 관통을 기본 교정으로 사용하지 않음 | G1|G2 | PARTIAL | reviews/fixture_a03_output_reference_20260923/ENGINEERING.md; reviews/fixture_structural_redesign_20260922/ENGINEERING.md; Fixture A03 is the current fixture (SIG through core, return outside); A04/A05/A06 PEC connectivity verified as two nets and kept as history; physical T02/T07 pending; reviews/full_reinspection_20260928/REPORT.md; fresh source/calculated/synthetic audit only, no measured pass; reviews/fresh_system_audit_20260928/REPORT.md; fresh R2+A16 file/geometry/FEA/software audit, not physical verification; reviews/pcb_function_audit_20260928/REPORT.md; fresh R2 PCB/ZIP/pad/topology/mount/function audit; annotation correction only; no measured pass | TBD-06
CAL-02 | REQUIREMENT | KNOWN_FROM_DOCUMENT|MEASUREMENT_REQUIRED | 정합·기준면·50 Ω 부하 조건에서만 ZT≈50×S21 적용 | 11.1 | 조건 검토 및 백서 부록 A 계산 검산 | SW-MATCHED|T02|T03 | -20 dB S21에서 5 Ω 및 약 13.9794 dBΩ; 조건 불충족 시 상대 특성화 | G1|G2|G4 | PARTIAL | docs/G2_VERIFICATION.md; reviews/fixture_structural_redesign_20260922/FINAL_DECISION.json; simulated fixture mismatch prevents automatic 50*S21 authorization; measured reference/current pending; reviews/full_reinspection_20260928/REPORT.md; fresh source/calculated/synthetic audit only, no measured pass | TBD-06
CAL-03 | REQUIREMENT | KNOWN_FROM_DOCUMENT|MEASUREMENT_REQUIRED | 1−S11 보정은 코어 전류 기준면과 무분기 조건을 검토한 뒤 적용 | 11.2 | 기준면·전류 모델 검토 및 합성 데이터 검증 | SW-REFERENCE|T02 | 조건 불충족 입력단 S11 일괄 보정 금지; HI 신뢰성 미확보 시 상대 특성화 | G1|G2|G4 | PARTIAL | docs/G2_VERIFICATION.md; reviews/fixture_structural_redesign_20260922/ENGINEERING.md; centre-current probes and de-embedded reference explicitly separated; SIMULATED only; actual loaded-fixture correction pending; reviews/full_reinspection_20260928/REPORT.md; fresh source/calculated/synthetic audit only, no measured pass | TBD-06
CAL-04 | REQUIREMENT | KNOWN_FROM_DOCUMENT|MEASUREMENT_REQUIRED | 복소 ZT 위상에 지그 지연과 기준면 모델 포함 | 11.3|12.3 | 위상·체인·지연 정보 확인 및 처리 검토 | SW-PHASE|T03|T09 | 위상 미검증 시 magnitude-only; 시간 복원은 별도 검증 기능 | G2|G4 | PARTIAL | docs/G2_VERIFICATION.md; reviews/fixture_structural_redesign_20260922/frequency_anchors_em.csv; complex S/current phase retained in two-mesh model; measured connector/reference delay pending; reviews/full_reinspection_20260928/REPORT.md; fresh source/calculated/synthetic audit only, no measured pass; reviews/fresh_system_audit_20260928/REPORT.md; fresh R2+A16 file/geometry/FEA/software audit, not physical verification | TBD-06|TBD-08
CAL-05 | REQUIREMENT | KNOWN_FROM_DOCUMENT | 전력 차 식의 부호·단위를 정의로 검산 | 11.5|부록 A | 원문 재조회 및 수식·숫자 검산 | SW-UNITS|SW-MATCHED | 정합 동일 기준 임피던스에서 S21[dB]=Pout−Pin | G1|G2 | VERIFIED | docs/G2_VERIFICATION.md; tests/results/unit_tests.xml; software/SYNTHETIC scope only; reviews/full_reinspection_20260928/REPORT.md; fresh source/calculated/synthetic audit only, no measured pass; reviews/fresh_system_audit_20260928/REPORT.md; fresh R2+A16 file/geometry/FEA/software audit, not physical verification
CAL-06 | REQUIREMENT | KNOWN_FROM_DOCUMENT|MEASUREMENT_REQUIRED | 출력 포트 기준 교정: 헤드 장착 through S21과 전달 S21의 비, 외장 로드 반사 보정, 코어→출구 모델 보정 K 적용 | 10.2|11.6|DEC-053 | 저장 openEMS K 재환산, 합성 데이터 시험, 실물 정/역방향 비교 | SW-OUTPUT-REF|T02|T03 | Fixture A03 출력 포트 기준1–500 MHz 보정; 주파수별 ZT·불확도·유효성 기록; 300 MHz 일괄 참고 처리 없음; 실제 무효 구간은 마스킹 | G2|G4 | PARTIAL | reviews/fixture_a03_output_reference_20260923/k_factor_results.json; SIMULATED K only; analysis/rfcp.py output_reference file workflow implemented and synthetic tested (DEC-058); reviews/output_reference_20260928/REPORT.md; physical forward/reverse and actual K/uncertainty pending; reviews/full_reinspection_20260928/REPORT.md; fresh source/calculated/synthetic audit only, no measured pass; reviews/fresh_system_audit_20260928/REPORT.md; fresh R2+A16 file/geometry/FEA/software audit, not physical verification; reviews/pcb_function_audit_20260928/REPORT.md; fresh R2 PCB/ZIP/pad/topology/mount/function audit; annotation correction only; no measured pass | TBD-06
HW-01 | REQUIREMENT | KNOWN_FROM_DOCUMENT|MEASUREMENT_REQUIRED | 차폐·나사·GND·SMA 외피가 자속을 쇄교하는 단락 턴을 만들지 않음 | 8.3|9.3 | 완성 구조의 도전 루프와 절연 갭 검토 | REVIEW-SHIELD|T01|T08 | 차폐 기준은 RF ground/동축 외피; DUT 쉴드·샤시 추가 연결하지 않음 | G1|G3|G4 | PARTIAL | reviews/recheck_20260922/incidental_short_turn.json; nominal CAD flux-linking loops excluded for stored fasteners/head PCB/SMA/return; actual cable routing and shielding pending; reviews/independent_release_review_20260922/01_INDEPENDENT_DOMAIN_VERDICTS.md; reviews/full_reinspection_20260928/REPORT.md; fresh source/calculated/synthetic audit only, no measured pass; reviews/fresh_system_audit_20260928/REPORT.md; fresh R2+A16 file/geometry/FEA/software audit, not physical verification; reviews/pcb_function_audit_20260928/REPORT.md; fresh R2 PCB/ZIP/pad/topology/mount/function audit; annotation correction only; no measured pass | TBD-05
HW-02 | REQUIREMENT | KNOWN_FROM_DOCUMENT|USER_CONFIRMATION_REQUIRED | 실제 stack-up과 SMA footprint 및 짧은 신호·연속 귀환 경로 사용 | 9.1|9.3 | 제조사 자료·레이아웃 및 ERC/DRC 검토 | REVIEW-PCB | Head A04 SMA R2와 Fixture A03 SMA R2는2층; Fixture A04/A05는 제작하지 않음; 별도 VNA B-RJ2는4층 JLC04161H-7628 지정 구간 임피던스 관리; 유료 성적서 미요청; RF 지그 전체의50Ω 보장을 뜻하지 않음 | G3 | PARTIAL | reviews/fixture_a03_output_reference_20260923/ENGINEERING.md; saved A03/A04/A05 KiCad/ERC/DRC; JLC Y22-9961994A Fixture A03 approved and awaiting payment on 2026-09-22 18:49 KST; no new fixture CAM; reviews/full_reinspection_20260928/REPORT.md; fresh source/calculated/synthetic audit only, no measured pass; reviews/sma_clearance_r2_20260928/REPORT.md; SMA R2 separate unsent native/CAM verified, physical fit and RF remain unverified; reviews/fresh_system_audit_20260928/REPORT.md; fresh R2+A16 file/geometry/FEA/software audit, not physical verification; reviews/pcb_function_audit_20260928/REPORT.md; fresh R2 PCB/ZIP/pad/topology/mount/function audit; annotation correction only; no measured pass | TBD-04|TBD-05
HW-03 | REQUIREMENT | KNOWN_FROM_DOCUMENT|USER_CONFIRMATION_REQUIRED|MEASUREMENT_REQUIRED | M12 8핀 및 일반 RJ45 케이블에 커넥터 분리 없이 장착하는 집게형과 기구 반복성 확보 | 6.2|9.4|DEC-007|DEC-010 | 케이블/다발 굵기·주변 간섭·진입 폭 및 분할면 정렬·잠금·절연·체결력 검토와 반복 개폐 시험 | REVIEW-MECHANICAL|T01|T05|T06 | 집게형 필수; 커넥터 통과 불필요; 안전 정지·무전원 장착; 검증 전 완료 라벨 금지 | G1|G3|G4 | PARTIAL | reviews/recheck_20260922/maximum_sma_path.json | reviews/recheck_20260922/core_corners_current.json; specified current CAD paths and tolerance corners checked; printed fit/force/repeatability pending; reviews/independent_release_review_20260922/selected_tolerance_path.json; reviews/full_reinspection_20260928/REPORT.md; fresh source/calculated/synthetic audit only, no measured pass; reviews/fresh_system_audit_20260928/REPORT.md; fresh R2+A16 file/geometry/FEA/software audit, not physical verification; reviews/c10_guide_fix_20260928/REPORT.md; A17/C10 local guide support, same structural criterion and saved-CAD/reproduction checks; physical/RF remain unverified; reviews/base_dfm_fix_20260928/REPORT.md; A18 base acute-fin correction, finite 2 mm screen/CAD/STL/100 N/reproduction checks; not vendor or physical/RF approval | TBD-03|TBD-05
SAFE-01 | REQUIREMENT | KNOWN_FROM_DOCUMENT|USER_CONFIRMATION_REQUIRED|MEASUREMENT_REQUIRED | 수신기 입력 정격과 감쇠·보호·종단 체인을 확인 | 12.1|13.3 | 장비·보호 부품 공식 자료와 체인 시험 | REVIEW-SAFETY|T09|T11 | 감쇠기 존재만으로 서지 보호 충분성을 가정하지 않음 | G2|G4|G5 | NOT_VERIFIED |  | TBD-01|TBD-07
SAFE-02 | REQUIREMENT | KNOWN_FROM_DOCUMENT|USER_CONFIRMATION_REQUIRED | 저에너지 실험실 검증부터 시작하며 현장은 확인된 저전압 하네스로 제한 | 13.1|13.2 | 작업·장착·적용 범위 검토 | REVIEW-SAFETY | 안전 정지·무전원 장착; 2차 종단 유지; 상용전원/VFD/고전압/서지 직접 적용 금지 | G2|G5 | NOT_VERIFIED |  | TBD-03|TBD-07
SAFE-03 | REQUIREMENT | KNOWN_FROM_DOCUMENT|USER_CONFIRMATION_REQUIRED | 제조 조건 미확정 시 DRAFT — NOT FOR FABRICATION 표시 | 19:G3|AGENTS:6 | 제조 검토 및 승인 상태 확인 | REVIEW-RELEASE | Gerber 생성과 발주 승인 분리; 사용자 승인 없는 구매·현장 작업 금지 | G3|G5 | NOT_VERIFIED |  | TBD-03|TBD-04|TBD-05|TBD-07|TBD-10
DATA-01 | REQUIREMENT | KNOWN_FROM_DOCUMENT | 원시 파일과 구성·장비 설정·교정 ID·필수 메타데이터 보존 | 16.2|16.3 | 필수 필드 및 파일 추적 검사 | REVIEW-DATA | 백서 16.3 필드와 현장 도체 구성·클리핑·시계 관계 기록 | G2|G4|G5 | PARTIAL | docs/G2_VERIFICATION.md; tests/results/unit_tests.xml; software/SYNTHETIC scope only; reviews/design_closure_20260921/README.md; CALCULATED/SIMULATED only; physical validation pending; reviews/independent_release_review_20260922/software_adversarial_check.json; reviews/full_reinspection_20260928/REPORT.md; fresh source/calculated/synthetic audit only, no measured pass; reviews/fresh_system_audit_20260928/REPORT.md; fresh R2+A16 file/geometry/FEA/software audit, not physical verification
DATA-02 | REQUIREMENT | KNOWN_FROM_DOCUMENT | 계산·시뮬레이션·실측·합성 결과의 출처와 상태 구분 | 3.3|16.3|17 | 결과·플롯 라벨 및 모델·설정·원본 확인 | SW-LABELS|REVIEW-DATA | MEASURED/SIMULATED/SYNTHETIC 분리; 합성을 raw 실측 폴더에 저장하지 않음 | G2|G4 | PARTIAL | docs/G2_VERIFICATION.md; tests/results/unit_tests.xml; software/SYNTHETIC scope only; reviews/design_closure_20260921/README.md; CALCULATED/SIMULATED only; physical validation pending; reviews/independent_release_review_20260922/software_adversarial_check.json; reviews/full_reinspection_20260928/REPORT.md; fresh source/calculated/synthetic audit only, no measured pass; reviews/fresh_system_audit_20260928/REPORT.md; fresh R2+A16 file/geometry/FEA/software audit, not physical verification
DATA-03 | REQUIREMENT | KNOWN_FROM_DOCUMENT | 교정 CSV에 유효성·불확도·위상 품질 상태 표시 | 16.4 | 출력 스키마 및 유효성 검사 | SW-QUALITY | 미평가 불확도는 빈 값+UNASSESSED; 위상 무효 시 임의 복소값 금지 | G2|G4 | VERIFIED | docs/G2_VERIFICATION.md; tests/results/unit_tests.xml; software/SYNTHETIC scope only; reviews/full_reinspection_20260928/REPORT.md; fresh source/calculated/synthetic audit only, no measured pass; reviews/fresh_system_audit_20260928/REPORT.md; fresh R2+A16 file/geometry/FEA/software audit, not physical verification | TBD-08
SW-01 | REQUIREMENT | KNOWN_FROM_DOCUMENT | Touchstone 주파수 단위·RI/MA/DB·포트 순서 검증 | 16.1|16.5 | 설치 라이브러리 API 확인 및 합성/회귀 시험 | SW-TOUCHSTONE | Hz/kHz/MHz 및 지원 형식·버전 명시; 비 50 Ω 입력 명시 처리 또는 거부 | G2 | VERIFIED | docs/G2_VERIFICATION.md; tests/results/unit_tests.xml; software/SYNTHETIC scope only; reviews/full_reinspection_20260928/REPORT.md; fresh source/calculated/synthetic audit only, no measured pass; reviews/fresh_system_audit_20260928/REPORT.md; fresh R2+A16 file/geometry/FEA/software audit, not physical verification
SW-02 | REQUIREMENT | KNOWN_FROM_DOCUMENT | peak/RMS/peak-to-peak와 dBm/dBµV/dBµA 환산 검증 | 12.2|16.5|부록 A | 알려진 파형·백서 수치로 단위시험 | SW-UNITS | 5 Ω와 1 mA RMS에서 5 mV RMS; 임의 과도 파형에 정현파 환산 적용 금지 | G2 | VERIFIED | docs/G2_VERIFICATION.md; tests/results/unit_tests.xml; software/SYNTHETIC scope only; reviews/full_reinspection_20260928/REPORT.md; fresh source/calculated/synthetic audit only, no measured pass; reviews/fresh_system_audit_20260928/REPORT.md; fresh R2+A16 file/geometry/FEA/software audit, not physical verification
SW-03 | REQUIREMENT | KNOWN_FROM_DOCUMENT | 대역 밖 외삽·null 역보정·클리핑 데이터 정량화 차단 | 12.3|14.2|16.5 | 무효 입력·대역 마스크 시험 | SW-INVALID | CLIPPED/OVERLOAD 및 무효 구간을 보존하며 결손 대역을 보간으로 숨기지 않음 | G2|G4 | PARTIAL | docs/G2_VERIFICATION.md; tests/results/unit_tests.xml; software/SYNTHETIC scope only; reviews/independent_release_review_20260922/software_adversarial_check.json; reviews/full_reinspection_20260928/REPORT.md; fresh source/calculated/synthetic audit only, no measured pass; reviews/fresh_system_audit_20260928/REPORT.md; fresh R2+A16 file/geometry/FEA/software audit, not physical verification | TBD-08
SW-04 | REQUIREMENT | KNOWN_FROM_DOCUMENT | 체인에 포함된 케이블·감쇠기의 이중 보정 차단 | 12.2|16.5 | 교정 구성·체인 ID 검증 시험 | SW-CHAIN | 교정 포함 요소와 추가 보정 요소 구분; 스코프 내부 응답 자동 보정으로 오인하지 않음 | G2|G4 | PARTIAL | docs/G2_VERIFICATION.md; tests/results/unit_tests.xml; software/SYNTHETIC scope only; reviews/independent_release_review_20260922/software_adversarial_check.json; reviews/full_reinspection_20260928/REPORT.md; fresh source/calculated/synthetic audit only, no measured pass; reviews/fresh_system_audit_20260928/REPORT.md; fresh R2+A16 file/geometry/FEA/software audit, not physical verification | TBD-07
SW-05 | REQUIREMENT | KNOWN_FROM_DOCUMENT | 플롯에 데이터 종류·축·단위·헤드·교정 ID·유효 대역 표시 | 16.5 | 출력 라벨 검토 | SW-LABELS | 합성/실측과 불확도 미평가 상태를 플롯에도 표시 | G2|G4 | PARTIAL | docs/G2_VERIFICATION.md; tests/results/unit_tests.xml; software/SYNTHETIC scope only; reviews/independent_release_review_20260922/software_adversarial_check.json; reviews/full_reinspection_20260928/REPORT.md; fresh source/calculated/synthetic audit only, no measured pass; reviews/fresh_system_audit_20260928/REPORT.md; fresh R2+A16 file/geometry/FEA/software audit, not physical verification
SIM-01 | REQUIREMENT | KNOWN_FROM_DOCUMENT | 시뮬레이션에 모델·설정·원본 출력과 적절한 재료 근거 보관 | 17 | 재료 모델·주파수 범위·수렴·메시·경계 및 재현성 검토 | REVIEW-SIMULATION | 상수 투자율만으로 300 MHz 성능 보장 금지; 시뮬레이션을 실측으로 승격하지 않음 | G1|G2|G3 | PARTIAL | reviews/fixture_structural_redesign_20260922/FINAL_DECISION.json | reviews/fixture_structural_redesign_20260922/em/; saved source/XML/raw port outputs/PEC connectivity and bounded geometry screens; omitted physical SMA/core/winding/complete head; SIMULATED not MEASURED; reviews/full_reinspection_20260928/REPORT.md; fresh source/calculated/synthetic audit only, no measured pass; reviews/fresh_system_audit_20260928/REPORT.md; fresh R2+A16 file/geometry/FEA/software audit, not physical verification | TBD-04
VAL-01 | REQUIREMENT | MEASUREMENT_REQUIRED | T01 구조·절연·접속 검사 | 14.1 | 일차와 측정 회로의 접속·구조 검사 | T01 | 의도치 않은 도통 없음; 내전압 검증과 구분 | G4 | NOT_VERIFIED |  | TBD-03|TBD-05
VAL-02 | TARGET | MEASUREMENT_REQUIRED | T02 지그 through·반사·손실·위상과 헤드 장착 영향 확인 | 10.3|14.1 | 지그 단독 및 헤드 출력 50 Ω 종단 상태 비교 | T02 | S11은 기록값이며 합격 조건이 아님; S21 깊은 null 없음·재장착 반복성·외장 로드 S11 측정·정/역방향 일치 확인; S11만으로 코어 전류 확정 금지 | G2|G4 | NOT_VERIFIED |  | TBD-06
VAL-03 | TARGET | MEASUREMENT_REQUIRED | T03 전달 임피던스의 유효 연속 구간 확보 | 14.1|14.2 | 전달 임피던스·잡음·선형성·모델·반복성 평가 | T03 | 백서14.5의 1–150 MHz 우선 목표와 대역별 반복성·절대오차 기준 사용; 1–500 MHz 특성화 후 유효하지 않은 구간 마스킹 | G4 | NOT_VERIFIED |  | TBD-06|TBD-08
VAL-04 | TARGET | MEASUREMENT_REQUIRED | T04 출력 레벨 선형성 | 14.1 | 지원되는 3개 이상의 입력 레벨 비교 | T04 | 입력 10 dB 변화에 출력 10±1 dB 변화 초기 목표 | G4 | NOT_VERIFIED |  | TBD-02|TBD-08
VAL-05 | TARGET | MEASUREMENT_REQUIRED | T05 집게 개폐·재장착 반복성 | 14.1|14.5|6.2|DEC-010|DEC-055 | 개폐·탈착·재장착 5회 이상 비교하며 접합면 정렬·잠금 상태 기록 | T05 | 14.5절 반복성: 0.1–150 MHz ±1 dB, 150–300 MHz ±2 dB, 300–500 MHz ±3 dB 초기 목표 | G4 | NOT_VERIFIED |  | TBD-05|TBD-08
VAL-06 | REQUIREMENT | MEASUREMENT_REQUIRED | T06 도체 위치 의존성 | 14.1 | 중심·가장자리·원위치 복귀 비교 | T06 | 최종 허용 위치와 오차 지정 | G4 | NOT_VERIFIED |  | TBD-05|TBD-08
VAL-07 | TARGET | MEASUREMENT_REQUIRED | T07 왕복 전류 상쇄 | 14.1 | 동일 일차 전류로 정규화한 단일/왕복 관통 비교 | T07 | 1~100 MHz에서 20 dB 이상 감소 초기 목표; 예상 DM/목표 CM 비에 따라 재평가 | G4 | NOT_VERIFIED |  | TBD-06|TBD-08
VAL-08 | TARGET | MEASUREMENT_REQUIRED | T08 직접 픽업·누설 | 10.3|14.1 | 의도한 자기 결합을 제거한 대조 구성 비교 | T08 | 유효 신호 대비 20 dB 이상 낮은 픽업 초기 목표; 순수 E-field 분리로 단정하지 않음 | G2|G4 | NOT_VERIFIED |  | TBD-06|TBD-08
VAL-09 | REQUIREMENT | MEASUREMENT_REQUIRED | T09 실제 출력 체인 의존성 | 14.1 | 실제 동축·감쇠기·보호·종단 포함 측정 | T09 | 체인 변경 시 교정 ID 변경 | G4 | NOT_VERIFIED |  | TBD-07|TBD-08
VAL-10 | REQUIREMENT | MEASUREMENT_REQUIRED | T10 프로브 삽입 영향 | 14.1 | 헤드 유무 및 연결 상태별 지그·실제 링크 비교 | T10 | 전류·반사·손실·오류·링크 변화와 조건 기록 | G4|G5 | NOT_VERIFIED |  | TBD-09
VAL-11 | REQUIREMENT | MEASUREMENT_REQUIRED | T11 제한된 펄스 응답 | 14.1 | 알려진 안전 신호에서 응답 확인 | T11 | 링잉·droop·클리핑·트리거 가능성 기록 | G4 | NOT_VERIFIED |  | TBD-01|TBD-07
VAL-12 | REQUIREMENT | MEASUREMENT_REQUIRED | T12 현장 전후 상태 점검 | 14.1 | 동일 지그로 현장 전후 재측정 | T12 | 손상·특성 변화 확인 및 기록 | G5 | NOT_VERIFIED |  | TBD-06|TBD-08
VAL-13 | TARGET | MEASUREMENT_REQUIRED | 검출 최소 SNR 10 dB를 초기 기준으로 검토 | 14.2 | 잡음 바닥과 측정 bandwidth·평균·FFT window/ENBW 기록 | T03|T08|T09 | SNR만으로 절대 정확도 보장 금지; 선형성·모델·반복성·null 조건도 만족 | G4 | NOT_VERIFIED |  | TBD-08
FIELD-01 | REQUIREMENT | KNOWN_FROM_DOCUMENT|USER_CONFIRMATION_REQUIRED|MEASUREMENT_REQUIRED | 전체/부분 도체군·쉴드 포함 여부와 비동시 측정의 해석 한계 기록 | 5|15.2|15.4 | 측정 구성 및 해석 검토 | T10|REVIEW-FIELD | 상쇄된 내부 스트레스를 배제하지 않음; 비침습 분리 불가 시 N/A 기록 | G5 | NOT_VERIFIED |  | TBD-03|TBD-09
FIELD-02 | REQUIREMENT | KNOWN_FROM_DOCUMENT|USER_CONFIRMATION_REQUIRED|MEASUREMENT_REQUIRED | F0~F4 중 가능한 조건과 오류 로그 시각 관계 기록 | 15.1|15.3|15.4 | 실제 DUT·회전·주변 설비·RF/오류 로그 비교 | REVIEW-FIELD|T12 | 시계 오차·카운터 동작·주기를 기록; 상관을 원인 확정으로 표시하지 않음 | G5 | NOT_VERIFIED |  | TBD-01|TBD-09
REL-01 | REQUIREMENT | KNOWN_FROM_DOCUMENT | 재제작 원본·조립/측정 절차·개체별 교정·유효 범위·검증·보호 조건 포함 | 20.4 | 최종 산출물 및 근거 검토 | REVIEW-RELEASE | 한 항목이라도 빠지면 해당 단계의 설계 또는 시제품 상태 | G4|G5 | NOT_VERIFIED | ; reviews/fresh_system_audit_20260928/REPORT.md; fresh R2+A16 file/geometry/FEA/software audit, not physical verification; reviews/c10_guide_fix_20260928/REPORT.md; A17/C10 local guide support, same structural criterion and saved-CAD/reproduction checks; physical/RF remain unverified; reviews/base_dfm_fix_20260928/REPORT.md; A18 base acute-fin correction, finite 2 mm screen/CAD/STL/100 N/reproduction checks; not vendor or physical/RF approval | TBD-01|TBD-02|TBD-03|TBD-04|TBD-05|TBD-06|TBD-07|TBD-08|TBD-09|TBD-10
