ckh7488/rf_current_probe/viewer_A05/audit_sources/latest/a11_print_20260918/print_manifest.csv

file | quantity | source_kind | source_step | source_step_sha256 | source_c05_stl | matches_c05_source | x_mm | y_mm | z_mm | watertight | positive_volume | fits_nominal_3301_machine_box | sampled_min_chord_mm | below_1p5mm_samples | sha256 | status
mechanical\assembly_A11_DRAFT\parts\C05_DriveYoke_DRAFT.stl | 2 | C05_UNMODIFIED_PRINT_COPY | mechanical\assembly_A11_DRAFT\parts\C05_DriveYoke_DRAFT.step | 791d3fa605b8d4762ab109b35e38c0779b9d998d79e43573e8a2b2f3da80201c | mechanical\cable_clamp_C05_DRAFT\parts\DriveYoke_DRAFT.stl | True | 144.0 | 80.0 | 15.0 | True | True | True | 2.1999969482421844 | 0 | 8bed8235b55fcb8f6ffa9182ad031c43cec80a77c70bc72ccfb1fa1110a93868 | DRAFT - NOT FOR FABRICATION
mechanical\assembly_A11_DRAFT\parts\C05_Frame_DRAFT.stl | 2 | C05_UNMODIFIED_PRINT_COPY | mechanical\assembly_A11_DRAFT\parts\C05_Frame_DRAFT.step | 7636453aa69358781cc8015efcfea72d6997d958725fbf629bb83e123bd5cf15 | mechanical\cable_clamp_C05_DRAFT\parts\Frame_DRAFT.stl | True | 158.0 | 122.0 | 51.0 | True | True | True | 2.399999618530274 | 0 | 6f730a2b568c0932b97b59962a2d069c0cc998b54824a1ce908383c132ce1807 | DRAFT - NOT FOR FABRICATION
mechanical\assembly_A11_DRAFT\parts\C05_Jaw1_DRAFT.stl | 2 | C05_UNMODIFIED_PRINT_COPY | mechanical\assembly_A11_DRAFT\parts\C05_Jaw1_DRAFT.step | 6fb1ab10de70ae8e2a60a833f4b22ee9c46be251ee286f9b8666a4704e3e82a5 | mechanical\cable_clamp_C05_DRAFT\parts\Jaw1_DRAFT.stl | True | 35.358 | 27.076 | 10.0 | True | True | True | 2.599999790966515 | 0 | 49cc91a2fdbb6efb1b4a3368edf535df3927171beb0e7b3c939a4f2408cd0fe6 | DRAFT - NOT FOR FABRICATION
mechanical\assembly_A11_DRAFT\parts\C05_Jaw2_DRAFT.stl | 2 | C05_UNMODIFIED_PRINT_COPY | mechanical\assembly_A11_DRAFT\parts\C05_Jaw2_DRAFT.step | 38cc22614794281f3f6c04aa7667cc9e9c59069f29fa13bc71a0dceeab86b1a6 | mechanical\cable_clamp_C05_DRAFT\parts\Jaw2_DRAFT.stl | True | 35.358 | 27.076 | 10.0 | True | True | True | 2.600000203777392 | 0 | 35cd0f5320cec7596fcd31e1c385168b7d82897c6d302644b3c9afa8f23cf8b0 | DRAFT - NOT FOR FABRICATION
mechanical\assembly_A11_DRAFT\parts\C05_TopBridgeJaw_DRAFT.stl | 2 | C05_UNMODIFIED_PRINT_COPY | mechanical\assembly_A11_DRAFT\parts\C05_TopBridgeJaw_DRAFT.step | 8067e78790192f685b86de08f4fd0fbac68e9d7eff95609a5326dfbb96680d08 | mechanical\cable_clamp_C05_DRAFT\parts\TopBridgeJaw_DRAFT.stl | True | 112.0 | 28.0 | 29.3 | True | True | True | 2.3003498844740418 | 0 | 46a284515d61f4bf7b3134a6dcedd5d5f0af36cbed1698a831445530edf38b36 | DRAFT - NOT FOR FABRICATION
mechanical\assembly_A11_DRAFT\parts\CommonBase_FREE_DRAFT.stl | 1 | FREE_PRINT_GEOMETRY | mechanical\assembly_A11_DRAFT\parts\CommonBase_FREE_DRAFT.step | b0efe8b2578487d499bf4a151c5599c9b5034602d0b6753a821b97d5ed6c5069 |  |  | 254.0 | 82.0 | 314.0 | True | True | True | 2.999999999999997 | 0 | 2666bccb3f43926e16b88993b80d49715ce4813a240c4a322eadd7dbcaf10e80 | DRAFT - NOT FOR FABRICATION
mechanical\assembly_A11_DRAFT\parts\LowerBody_FREE_DRAFT.stl | 1 | FREE_PRINT_GEOMETRY | mechanical\assembly_A11_DRAFT\parts\LowerBody_FREE_DRAFT.step | 876fefa5050965e078fee0e3acd57523e8657a757e22f44ee5542b18a8fa39b8 |  |  | 248.0 | 80.0 | 104.0 | True | True | True | 2.255213646870058 | 0 | ed20b1e7e4e0b402b2143bd9dfbac252cd6064570d48c94026fab865139764b7 | DRAFT - NOT FOR FABRICATION
mechanical\assembly_A11_DRAFT\parts\LowerKeeper_FREE_DRAFT.stl | 1 | FREE_PRINT_GEOMETRY | mechanical\assembly_A11_DRAFT\parts\LowerKeeper_FREE_DRAFT.step | 37086039467f8124eaa32757728564fb877f5c63eb71ff330fa27e6da3b4d474 |  |  | 88.0 | 26.5 | 21.0 | True | True | True | 2.0000000000000004 | 0 | 178cc4b861b3578b68d134eaaa5b24c906b6e820e7283d3c8997f598a31f200c | DRAFT - NOT FOR FABRICATION
mechanical\assembly_A11_DRAFT\parts\UpperKeeper_FREE_DRAFT.stl | 1 | FREE_PRINT_GEOMETRY | mechanical\assembly_A11_DRAFT\parts\UpperKeeper_FREE_DRAFT.step | 0484ab681e34864c6451dd3fc51c15dff6da0c41dd85e472bef075656c2d12be |  |  | 88.0 | 26.5 | 21.0 | True | True | True | 1.9999999999999998 | 0 | 7a9238360fef5088b8bcc252fb72cfc2d20c59e782aa1c06b27c3cec39f95cad | DRAFT - NOT FOR FABRICATION
mechanical\assembly_A11_DRAFT\parts\UpperLid_FREE_DRAFT.stl | 1 | FREE_PRINT_GEOMETRY | mechanical\assembly_A11_DRAFT\parts\UpperLid_FREE_DRAFT.step | f1411346df9f7f82d5d63a82b1d0053b7eaf838274efab0872a7e18702b132e1 |  |  | 242.0 | 40.0 | 32.0 | True | True | True | 2.400001525878903 | 0 | c4296488822c3f4571edb05458a058a3ae70032a764e7ca088f0fbc3dbc58712 | DRAFT - NOT FOR FABRICATION
