ckh7488/rf_current_probe/docs/references/bom_20260917/fasteners_p74.png

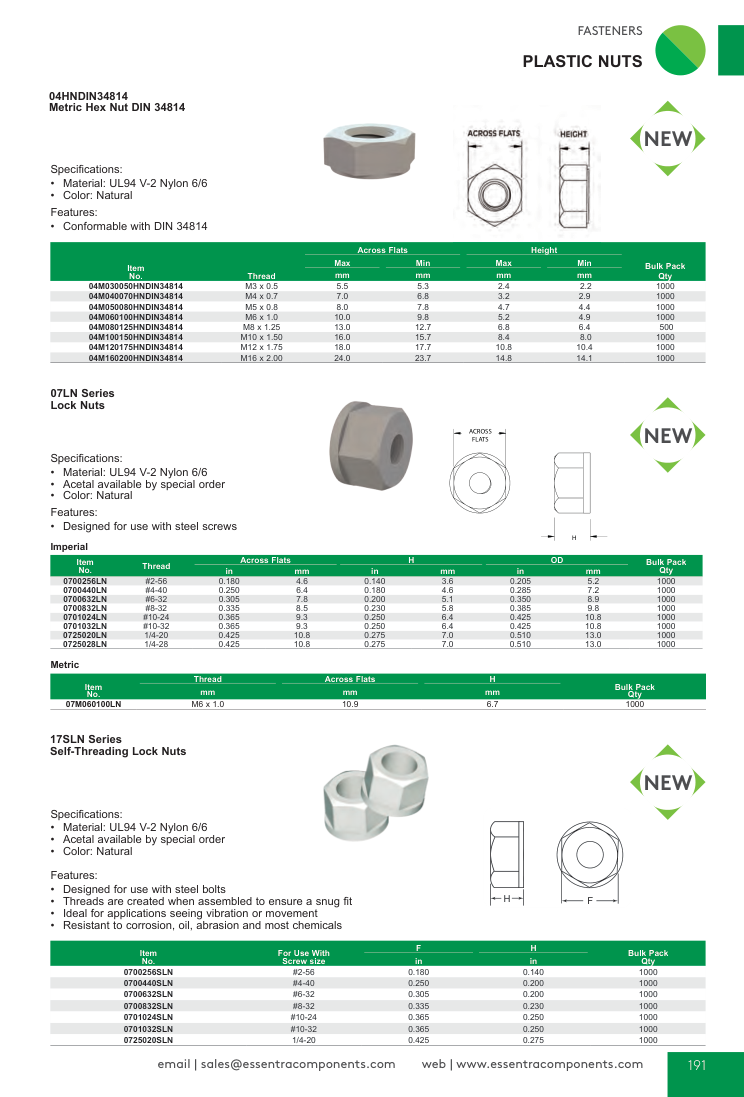
docs/references/bom_20260917/fasteners_p74.png
