ckh7488/rf_current_probe/docs/references/bom_20260917/fasteners_p80.png

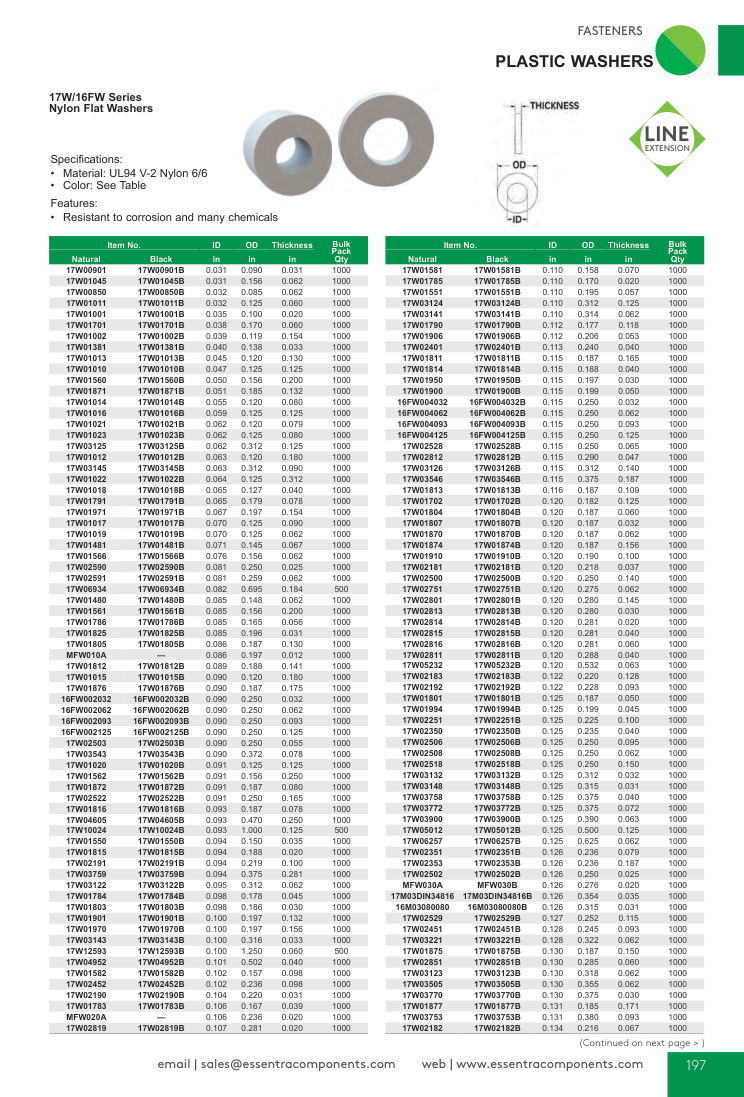
docs/references/bom_20260917/fasteners_p80.png
