ckh7488/rf_current_probe/docs/references/bom_20260917/fasteners_p88.png

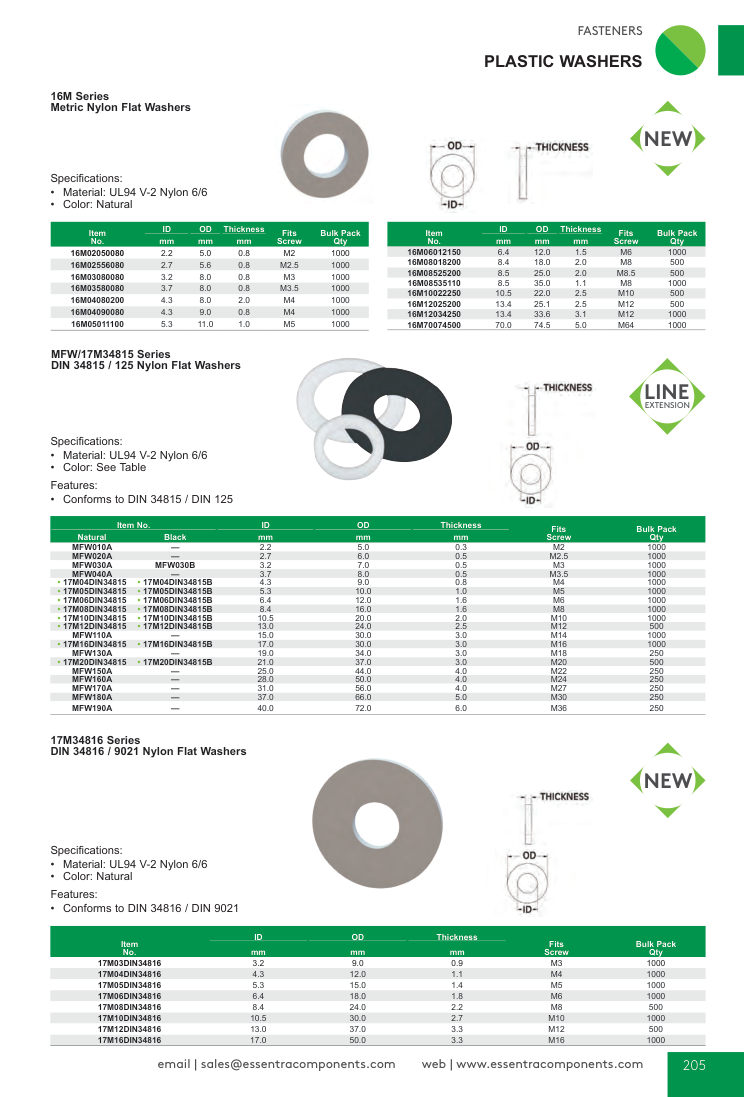
docs/references/bom_20260917/fasteners_p88.png
