ckh7488/rf_current_probe/mechanical/base_A19_DRAFT/RFCP_A19_CurrentHardware_Assembly_DRAFT.FCStd

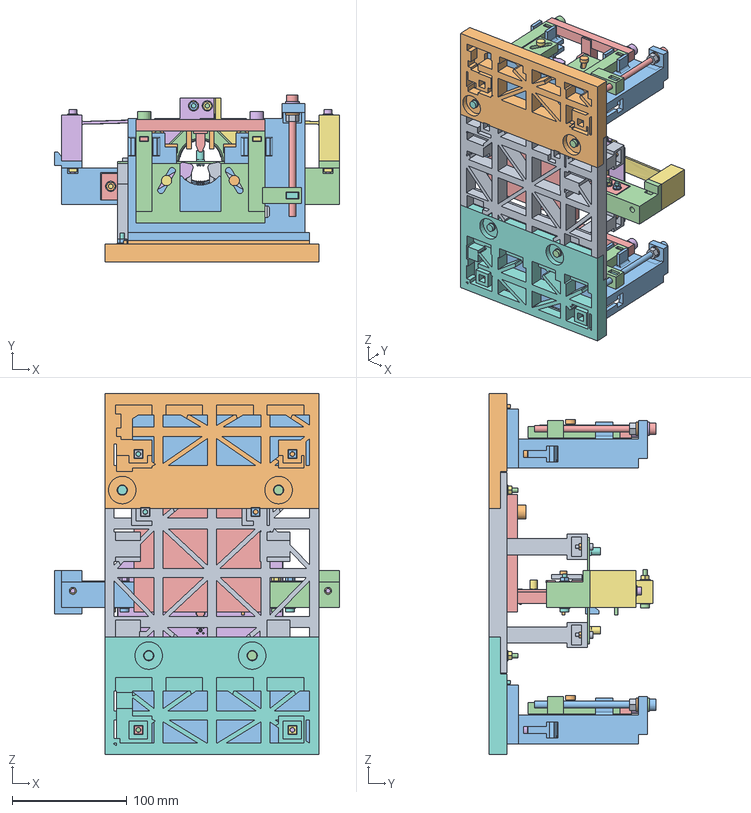
[picture p49: CAD file, 2026-11-04]
mechanical/base_A19_DRAFT/RFCP_A19_CurrentHardware_Assembly_DRAFT.FCStd
248.0 x 145.6 x 314.0 mm
LowerKeeper
UpperKeeper
FixedCore
MovingCore
Winding
PCB
SMAEnvelope
PCBScrews
PCBNuts
LowerKeeperScrews
LowerKeeperNuts
UpperKeeperScrews
UpperKeeperNuts
Head closure: standard M4x60 socket cap screws (2)
HeadSquareNuts
MountScrew0
MountNut0
MountScrew1
MountNut1
MountScrew2
MountNut2
MountScrew3
MountNut3
MountScrew4
MountNut4
MountScrew5
MountNut5
FlatPCB
SignalCopper
ReturnCopper
SMAInput
SMAOutput
CalibrationScrews
Calibration PCB: PA66 M3 hex nuts AF5.5 H2.4 (4), DEC-069
Cable1_Frame
Cable1_DriveYoke
Cable1_TopBridgeJaw
Cable1_Jaw1
Cable1_Follower1
Cable1_FollowerNut1
Cable1_Jaw2
Cable1_Follower2
Cable1_FollowerNut2
Cable1_BridgeScrew1
Cable1_BridgeNut1
Cable1_BridgeScrew2
Cable1_BridgeNut2
Cable1_DriveNut
Cable1_LeadLockNut
Cable1_ThrustWasher
Cable2_Frame
Cable2_DriveYoke
Cable2_TopBridgeJaw
Cable2_Jaw1
Cable2_Follower1
Cable2_FollowerNut1
Cable2_Jaw2
Cable2_Follower2
Cable2_FollowerNut2
Cable2_BridgeScrew1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
