ckh7488/rf_current_probe/hardware/calibration_fixture_PCB_A03_DRAFT/models/GCT_RFPC_SMA28_F_envelope.step

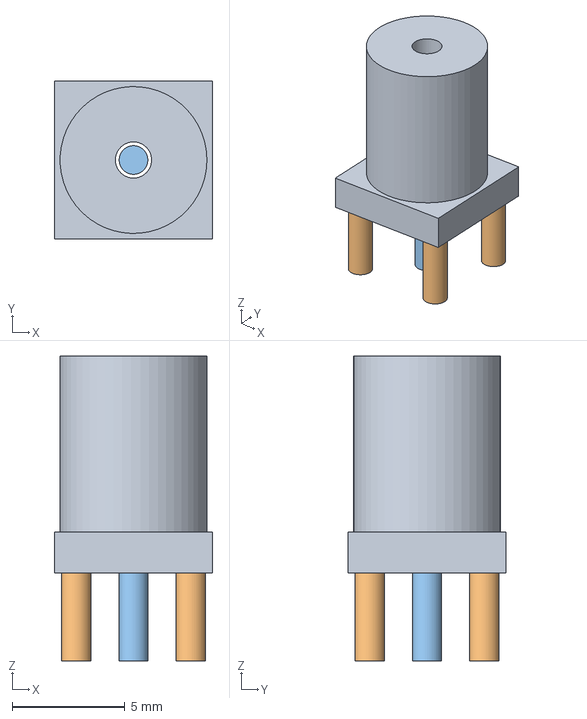
[picture p50: CAD file, 2026-11-04]
hardware/calibration_fixture_PCB_A03_DRAFT/models/GCT_RFPC_SMA28_F_envelope.step
7.00 x 7.00 x 13.5 mm
