ckh7488/rf_current_probe/hardware/calibration_fixture_PCB_A03_DRAFT/review/board_only.step

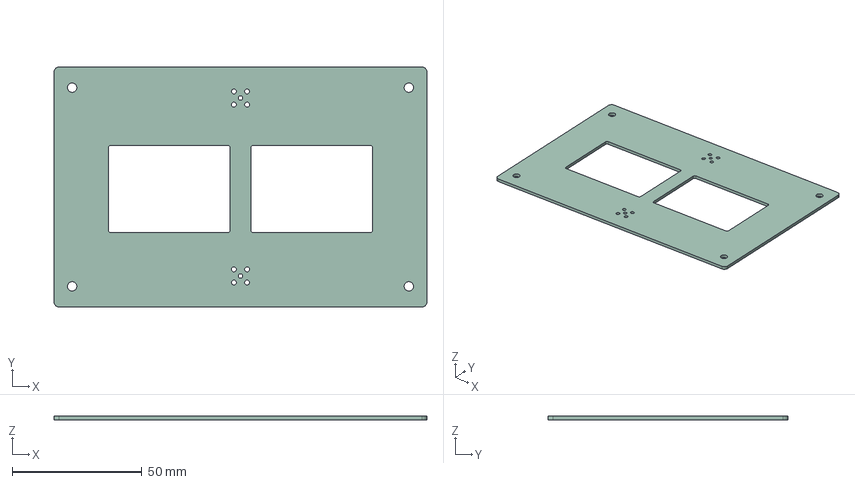
[picture p51: CAD file, 2026-11-04]
hardware/calibration_fixture_PCB_A03_DRAFT/review/board_only.step
144.0 x 92.7 x 1.51 mm
