ckh7488/rf_current_probe/hardware/probe_head_A04_DRAFT/review/board_only.step

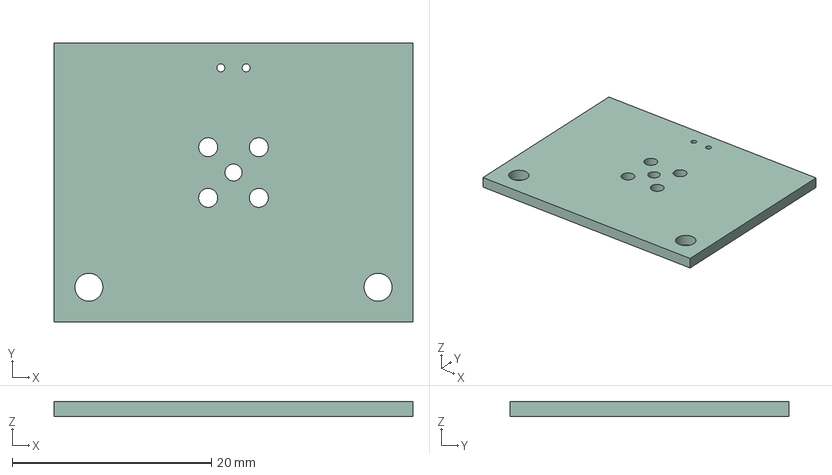
[picture p52: CAD file, 2026-11-04]
hardware/probe_head_A04_DRAFT/review/board_only.step
36.0 x 28.0 x 1.51 mm
