ckh7488/rf_current_probe/mechanical/assembly_A17_DRAFT/parts/UpperLeft_A14_DRAFT.step

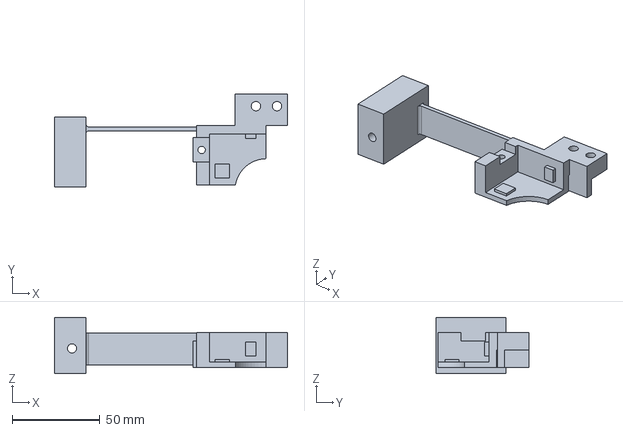
[picture p53: CAD file, 2026-11-04]
mechanical/assembly_A17_DRAFT/parts/UpperLeft_A14_DRAFT.step
133.0 x 53.2 x 32.0 mm
