ckh7488/rf_current_probe/mechanical/assembly_A17_DRAFT/RFCP_A17_Integrated_DRAFT.step

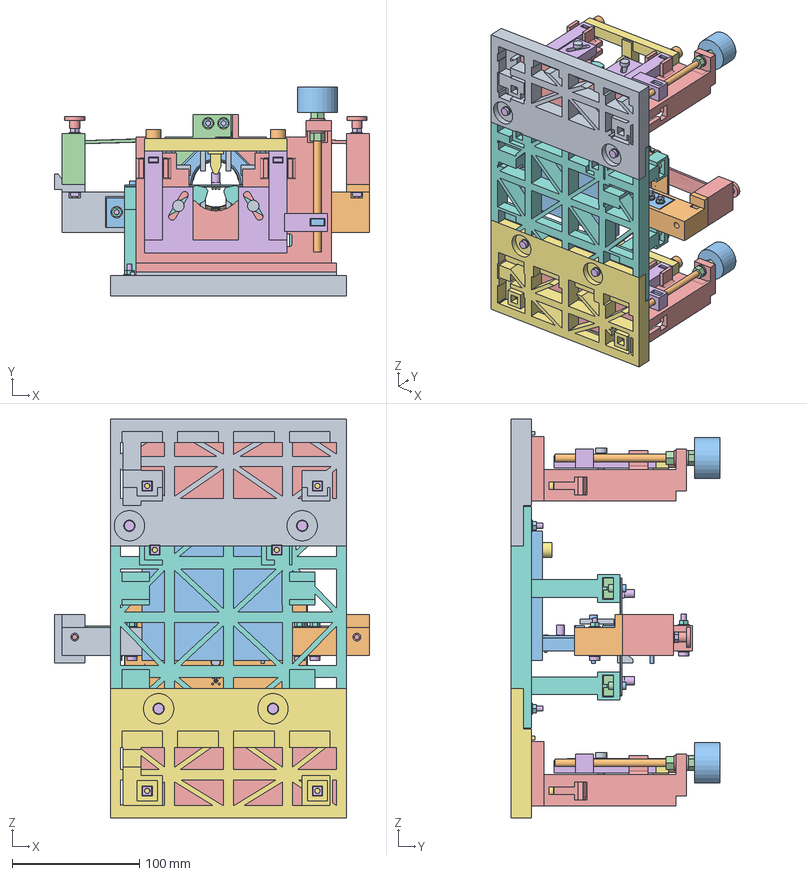
[picture p54: CAD file, 2026-11-04]
mechanical/assembly_A17_DRAFT/RFCP_A17_Integrated_DRAFT.step
248.0 x 164.6 x 314.0 mm
