ckh7488/rf_current_probe/mechanical/base_A19_DRAFT/parts/BaseCenter_A19_DRAFT.step

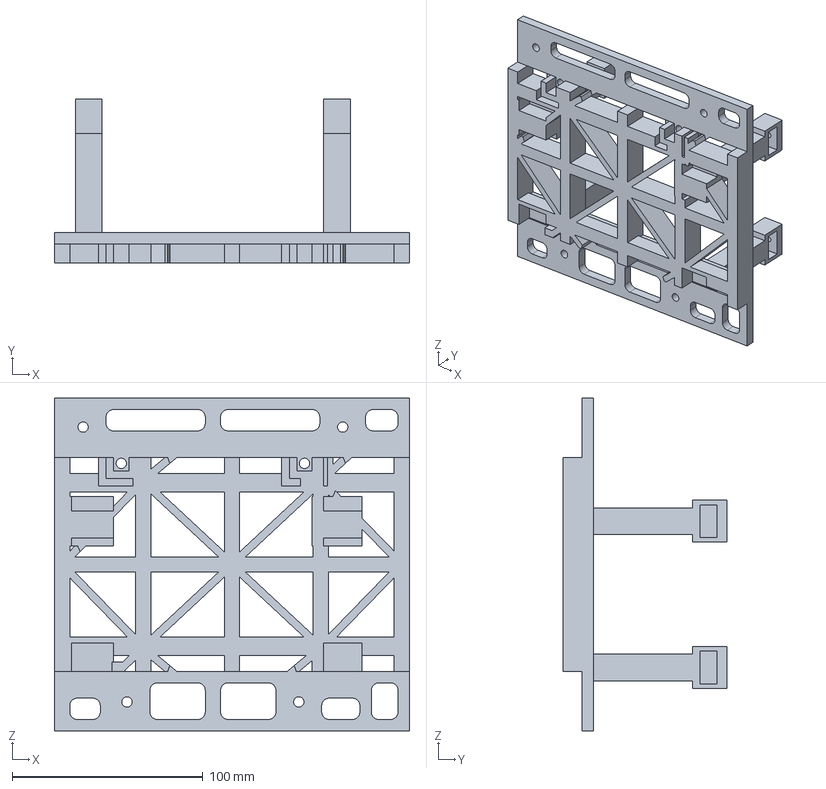
[picture p55: CAD file, 2026-11-04]
mechanical/base_A19_DRAFT/parts/BaseCenter_A19_DRAFT.step
186.0 x 86.0 x 174.4 mm
