ckh7488/rf_current_probe/mechanical/assembly_A17_DRAFT/parts/LowerArmLeft_A14_DRAFT.step

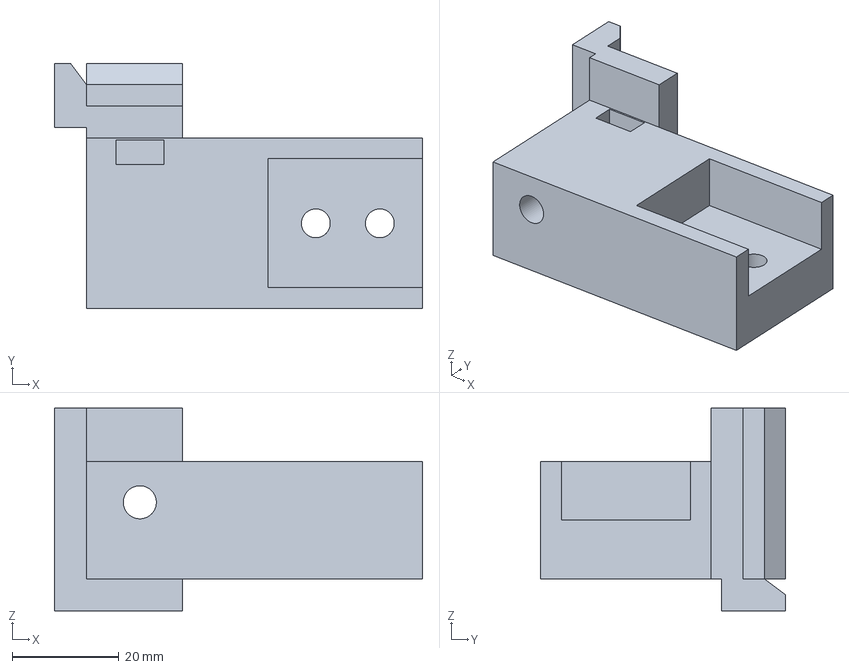
[picture p56: CAD file, 2026-11-04]
mechanical/assembly_A17_DRAFT/parts/LowerArmLeft_A14_DRAFT.step
69.0 x 46.0 x 38.0 mm
