ckh7488/rf_current_probe/mechanical/assembly_A18_DRAFT/parts/UpperRight_A14_DRAFT.step

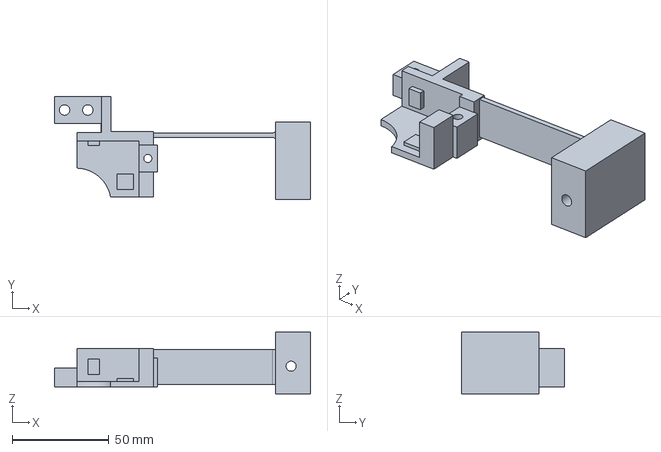
[picture p57: CAD file, 2026-11-04]
mechanical/assembly_A18_DRAFT/parts/UpperRight_A14_DRAFT.step
132.2 x 53.2 x 32.0 mm
