ckh7488/rf_current_probe/mechanical/assembly_A18_DRAFT/parts/C07_Jaw1_DRAFT.step

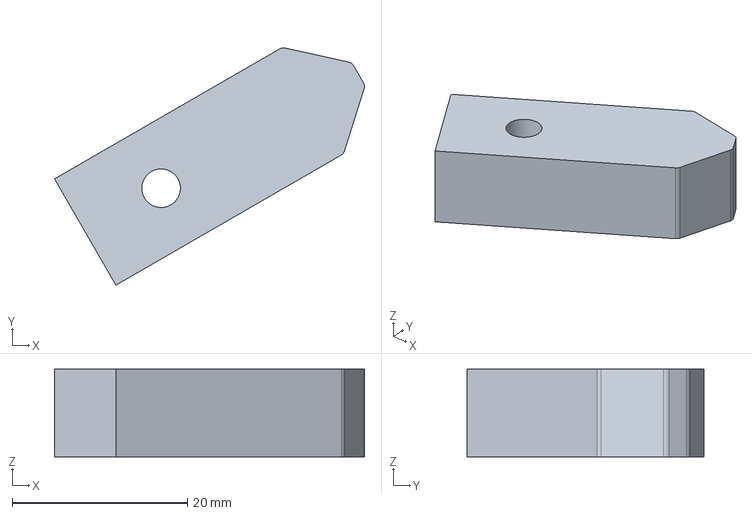
[picture p58: CAD file, 2026-11-04]
mechanical/assembly_A18_DRAFT/parts/C07_Jaw1_DRAFT.step
35.4 x 27.1 x 10.0 mm
