ckh7488/rf_current_probe/mechanical/assembly_A17_DRAFT/parts/LowerArmRight_A14_DRAFT.step

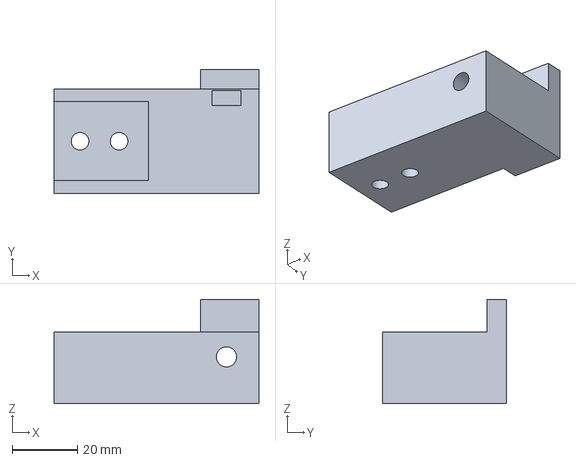
[picture p59: CAD file, 2026-11-04]
mechanical/assembly_A17_DRAFT/parts/LowerArmRight_A14_DRAFT.step
63.0 x 38.0 x 32.0 mm
