ckh7488/rf_current_probe/mechanical/assembly_A18_DRAFT/parts/C07_TopBridgeJaw_DRAFT.step

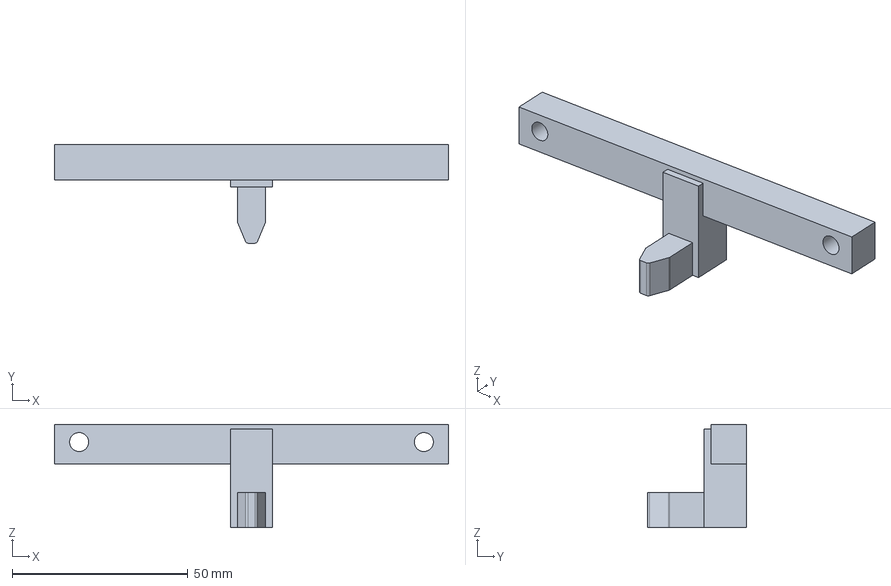
[picture p60: CAD file, 2026-11-04]
mechanical/assembly_A18_DRAFT/parts/C07_TopBridgeJaw_DRAFT.step
112.0 x 28.0 x 29.3 mm
