ckh7488/rf_current_probe/mechanical/assembly_A17_DRAFT/parts/BaseRear_A15_DRAFT.step

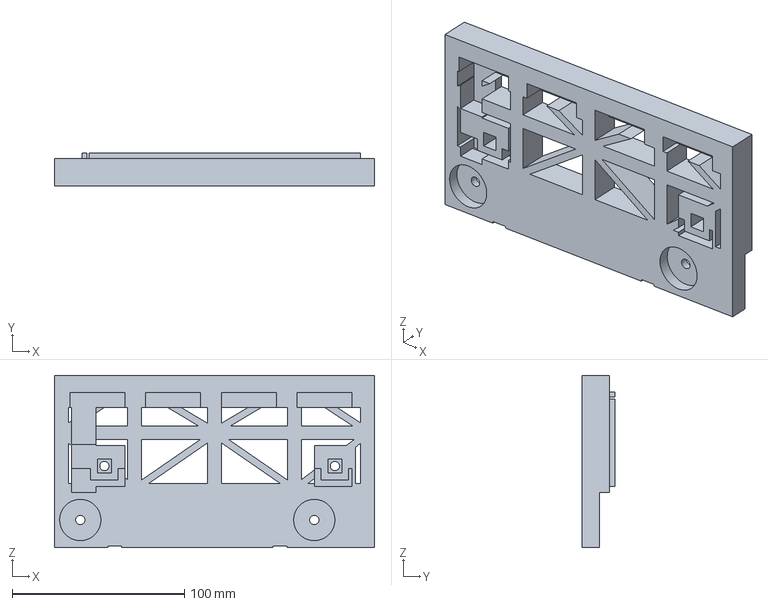
[picture p61: CAD file, 2026-11-04]
mechanical/assembly_A17_DRAFT/parts/BaseRear_A15_DRAFT.step
186.0 x 19.0 x 100.0 mm
