ckh7488/rf_current_probe/mechanical/assembly_A17_DRAFT/parts/LowerKeeper_FREE_DRAFT.step

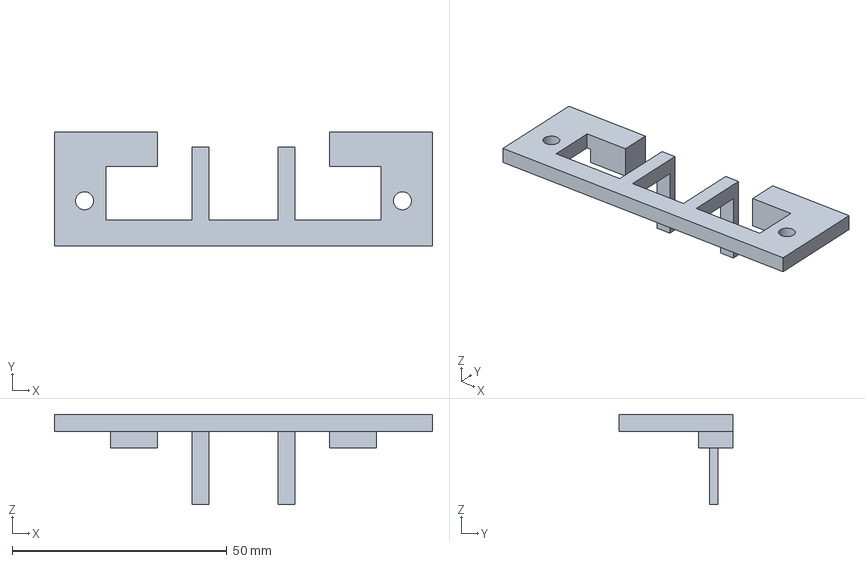
[picture p62: CAD file, 2026-11-04]
mechanical/assembly_A17_DRAFT/parts/LowerKeeper_FREE_DRAFT.step
88.0 x 26.5 x 21.0 mm
