ckh7488/rf_current_probe/mechanical/assembly_A18_DRAFT/parts/C07_DriveYoke_DRAFT.step

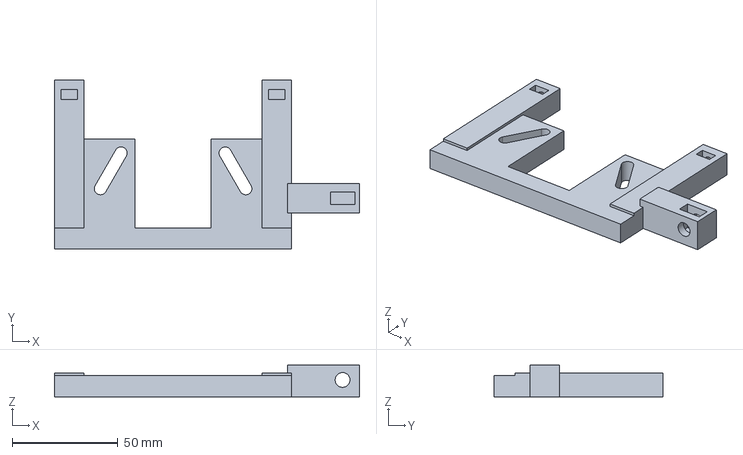
[picture p63: CAD file, 2026-11-04]
mechanical/assembly_A18_DRAFT/parts/C07_DriveYoke_DRAFT.step
144.0 x 80.0 x 15.0 mm
