ckh7488/rf_current_probe/mechanical/assembly_A17_DRAFT/parts/BaseFront_A16_DRAFT.step

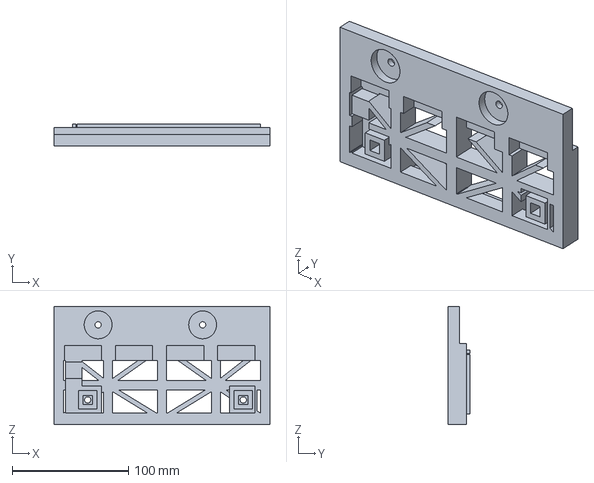
[picture p64: CAD file, 2026-11-04]
mechanical/assembly_A17_DRAFT/parts/BaseFront_A16_DRAFT.step
186.0 x 19.0 x 102.0 mm
