ckh7488/rf_current_probe/mechanical/assembly_A18_DRAFT/parts/LowerCenter_A14_DRAFT.step

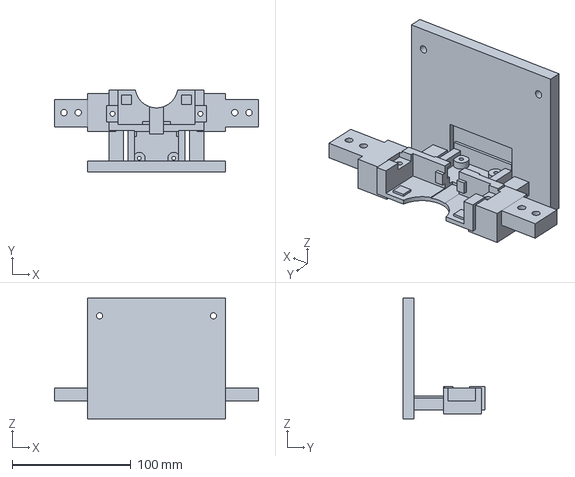
[picture p65: CAD file, 2026-11-04]
mechanical/assembly_A18_DRAFT/parts/LowerCenter_A14_DRAFT.step
172.0 x 69.0 x 102.0 mm
