ckh7488/rf_current_probe/mechanical/assembly_A17_DRAFT/parts/C10_Frame_DRAFT.step

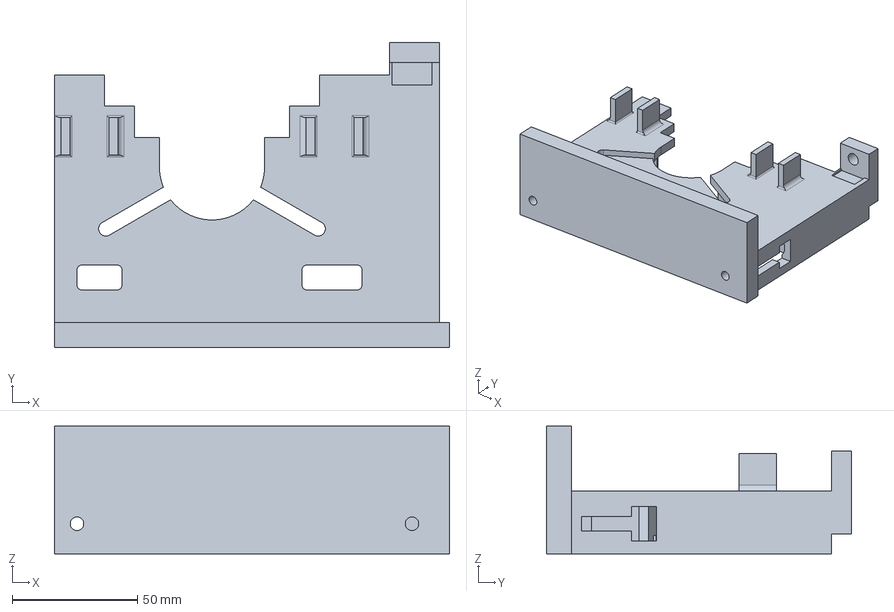
[picture p66: CAD file, 2026-11-04]
mechanical/assembly_A17_DRAFT/parts/C10_Frame_DRAFT.step
158.0 x 122.0 x 51.0 mm
