ckh7488/rf_current_probe/(list of files, cad)

Other CAD files:
reviews/base_dfm_fix_20260928/RFCP_A18_CurrentHardware_Assembly_DRAFT.FCStd
hardware/calibration_fixture_PCB_A03_SMA_R2_DRAFT/review/board_only.step
hardware/probe_head_A04_DRAFT/models/GCT_RFPC_SMA28_F_envelope.step
hardware/probe_head_A04_SMA_R2_DRAFT/models/GCT_RFPC_SMA28_F_envelope.step
hardware/probe_head_A04_SMA_R2_DRAFT/review/board_only.step
mechanical/assembly_A18_DRAFT/RFCP_A18_Integrated_DRAFT.step
mechanical/assembly_A18_DRAFT/parts/C07_Jaw2_DRAFT.step
mechanical/assembly_A17_DRAFT/parts/C07_Jaw2_DRAFT.step
mechanical/assembly_A18_DRAFT/parts/BaseRear_A18_DRAFT.step
mechanical/assembly_A17_DRAFT/parts/UpperKeeper_FREE_DRAFT.step
mechanical/assembly_A18_DRAFT/parts/BaseCenter_A18_DRAFT.step
mechanical/assembly_A17_DRAFT/parts/BaseCenter_A16_DRAFT.step
mechanical/assembly_A18_DRAFT/parts/UpperKeeper_FREE_DRAFT.step
mechanical/assembly_A18_DRAFT/parts/BaseFront_A18_DRAFT.step
mechanical/assembly_A17_DRAFT/RFCP_A17_Integrated_DRAFT.FCStd
mechanical/assembly_A17_DRAFT/parts/BaseCenter_A16_DRAFT.stl
mechanical/assembly_A17_DRAFT/parts/BaseFront_A16_DRAFT.stl
mechanical/assembly_A17_DRAFT/parts/BaseRear_A15_DRAFT.stl
mechanical/assembly_A17_DRAFT/parts/C07_DriveYoke_DRAFT.stl
mechanical/assembly_A17_DRAFT/parts/C07_Jaw1_DRAFT.stl
mechanical/assembly_A17_DRAFT/parts/C07_Jaw2_DRAFT.stl
mechanical/assembly_A17_DRAFT/parts/C07_TopBridgeJaw_DRAFT.stl
mechanical/assembly_A17_DRAFT/parts/C10_Frame_DRAFT.stl
mechanical/assembly_A17_DRAFT/parts/LowerArmLeft_A14_DRAFT.stl
mechanical/assembly_A17_DRAFT/parts/LowerArmRight_A14_DRAFT.stl
mechanical/assembly_A17_DRAFT/parts/LowerCenter_A14_DRAFT.stl
mechanical/assembly_A17_DRAFT/parts/LowerKeeper_FREE_DRAFT.stl
mechanical/assembly_A17_DRAFT/parts/UpperKeeper_FREE_DRAFT.stl
mechanical/assembly_A17_DRAFT/parts/UpperLeft_A14_DRAFT.stl
mechanical/assembly_A17_DRAFT/parts/UpperRight_A14_DRAFT.stl
mechanical/assembly_A18_DRAFT/RFCP_A18_Integrated_DRAFT.FCStd
mechanical/assembly_A18_DRAFT/parts/BaseCenter_A18_DRAFT.stl
mechanical/assembly_A18_DRAFT/parts/BaseFront_A18_DRAFT.stl
mechanical/assembly_A18_DRAFT/parts/BaseRear_A18_DRAFT.stl
mechanical/assembly_A18_DRAFT/parts/C07_DriveYoke_DRAFT.stl
mechanical/assembly_A18_DRAFT/parts/C07_Jaw1_DRAFT.stl
mechanical/assembly_A18_DRAFT/parts/C07_Jaw2_DRAFT.stl
mechanical/assembly_A18_DRAFT/parts/C07_TopBridgeJaw_DRAFT.stl
mechanical/assembly_A18_DRAFT/parts/C10_Frame_DRAFT.stl
mechanical/assembly_A18_DRAFT/parts/LowerArmLeft_A14_DRAFT.stl
mechanical/assembly_A18_DRAFT/parts/LowerArmRight_A14_DRAFT.stl
mechanical/assembly_A18_DRAFT/parts/LowerCenter_A14_DRAFT.stl
mechanical/assembly_A18_DRAFT/parts/LowerKeeper_FREE_DRAFT.stl
mechanical/assembly_A18_DRAFT/parts/UpperKeeper_FREE_DRAFT.stl
mechanical/assembly_A18_DRAFT/parts/UpperLeft_A14_DRAFT.stl
mechanical/assembly_A18_DRAFT/parts/UpperRight_A14_DRAFT.stl
mechanical/base_A19_DRAFT/parts/BaseCenter_A19_DRAFT.stl
