ckh7488/rf_current_probe/viewer_A05/assembly_sources/README.md

> **이력 문서 · 현재 제작/사용 지시 아님 — 2026-09-22 분류.** 과거 조립 뷰어 생성 기록이다. 현행 공개 빌드는 viewer_A05/README.md를 따른다. 현재 기준은 [현재 준비 상태](../../docs/CURRENT_READINESS.md)를 따른다. 아래의 “현재/최신/미확정”은 원래 작성 시점의 표현이다.

# A13 / C07 — 분실방지 부품 제거

2026-09-18 · DRAFT — NOT FOR FABRICATION

## 변경

- 프로브 너트 덮개 2개, 교정 PCB 너트 덮개 4개, 앞뒤 클램프 너트 덮개 4개와 받이를 제거했다.
- 바닥의 노란 너트 유지판 1개, 판 고정 M4 나사·너트 2쌍을 제거했다.
- 출력물은 12종 26개에서 **10종 15개**로 줄었다. 코어 고정바, 탄성 뚜껑, 권선 접근, 닫힌 경사 홈과 기존 얇은 벽 보강은 유지했다.
- 원래의 짧고 열린 사각너트 자리를 사용한다. 교정 PCB는 나일론 날개너트와 열린 받침을 유지하되 긴 받이와 덮개를 없앴다.
- M6 축의 잠금너트와 와셔는 축 위치 조절에 필요한 작동 부품이므로 유지했다. 너트 분실방지용 추가 부품이 아니다.

## 조립

1. 바닥을 뒤집어 여섯 사각너트를 놓고 잡아주면서 모듈의 M4×20 나사를 체결한다. 별도 밑판을 조립하지 않는다.
2. 프로브와 케이블 가로대의 사각너트는 앞쪽 열린 홈으로 넣고 반대편 나사를 시작한다. 너트 홈이 회전을 제한하고, 조이면 본체 받침면에 밀착한다.
3. 교정 PCB 날개너트는 받침의 바깥쪽 입구로 넣은 뒤 위쪽에서 M3 나사를 조인다. 초도 배치는 헤드를 바닥에 올리기 전에 한다.
4. 코어 고정바와 헤드 PCB는 기존 나일론 관통 체결을 유지한다. M6 축은 와셔와 잠금너트를 먼저 놓고, 10 mm 스패너로 너트를 잡고 큰 노브를 돌려 조립한다.

**나사를 완전히 빼면 너트가 빠질 수 있다. 분해할 때 직접 챙긴다.** 이 상태를 결함으로 보고 덮개를 다시 추가하지 않는다. 억지 압입이나 출력 나사산을 사용하지 않는다.

## 출력·검증 범위

parts/의 STL 10종: 헤드 4종 각1개, 공통 바닥1개, C07 클램프5종 각2개. 뚜껑은 반드시 UpperLid_FREE_DRAFT를 사용한다. 조립체 STEP의 휘어진 뚜껑은 출력용이 아니다.

검증 기록은 reviews/simplification_20260918 및 각 revision의 JSON을 따른다. 공칭 CAD 간섭·일부 삽입 경로와 출력 메쉬를 확인한 범위이며, 손조립·공구 전체 호환·출력 공차·내구성·RF 시험은 미실행이다. 최종 노브축과 팔로워 구매 규격도 미확정이다. 업체 제출이나 주문·결제는 갱신하지 않았다.

재제작: FreeCAD 1.0.2에서 build_cable_clamp_C07.py → build_assembly_A13.py. A07/A05 원본 입력은 유지한다. common_nut_cap.py는 더 이상 사용하지 않는다.
