ckh7488/rf_current_probe/docs/BUILD_READINESS_20260917.md

> **이력 문서 · 현재 제작/사용 지시 아님 — 2026-09-22 분류.** A0.2/동판 지그 및9/17 견적 기록이다. 현재 기준은 [현재 준비 상태](CURRENT_READINESS.md)를 따른다. 아래의 “현재/최신/미확정”은 원래 작성 시점의 표현이다.

# 제작 준비 검토 — 2026-09-17

> **현행 기준 안내 · 2026-09-21:** 기구·구매 수량·발주 상태는 [CURRENT_READINESS.md](CURRENT_READINESS.md)와 [최종3D 제작 기준](3D_PRINT_RELEASE_A16_C09.md)을 따른다. 아래는 해당 작성일의 기록이다. 교정 수식·기준면·종단·보호 원칙은 계속 적용하지만, 옛 동판/패드·구매 수량·제작 완료 표현은 현재 지시가 아니다.

**JLC A0.3 교체·재심사 접수 완료:** FixedTray/MovingTray 보강본을 기존 주문의 같은 접수번호에 반영했다. 주문에서 다시 내려받은 두 STL의 SHA256이 검증된 원본과 일치한다. 기존 검사 지점은 0.448mm→2.241mm로 보강하고 FixedTray의 별도 0.2mm 벽을 제거했다. 14품목·합배송을 유지하며 총액은 **$262.10**(기존 대비 +$0.04, 배송 $9.59 포함)이다. 현재 두 트레이를 포함한 기구 5개가 심사 중이다. 교체 후 목록에는 이전 경고 아이콘이 보이지 않지만 최종 DFM 승인은 아직이다. 공급사 PDF와 구매 안내는 갱신했으며 심사 완료 전까지 구매 보류다.

**후속 견적 갱신:** [BOM 0.12](BOM_DRAFT.md), [전체 견적](../procurement/20260917/FULL_BOM_REVIEW.md). 필수 기구 9개 SLS 나일론/체결 MPN/원재료까지 선정·가격 확인·장바구니 저장. 259,336원+미확정 비용으로 예산 초과. 기존 형상 변경 없이 최대 나사 머리/와셔 닫힘 공칭 19곳 검사 통과. 아래 이전 미견적 표기는 당시 이력이며, 실물·제조·보호 보류 조건은 계속 적용한다.

**DRAFT — NOT FOR FABRICATION. 구매·제조 승인본이 아니다.**

## 1. 이번에 구체화한 것

| 항목 | 산출물 / 결과 |
|---|---|
| 집게 A0.2 | [FreeCAD·STEP·STL](../mechanical/clamp_A02_DRAFT/README.md). 고정 트레이에 90° 스토퍼 추가. 기존 A0.1 보존 |
| F-A 지그 A0.1 | [전체 조립 CAD와 안내](../hardware/calibration_fixture/README.md). 벌크헤드 SMA 2개, 중심 도체, 외부 귀환 2개, 양끝 판, 절연 지지대·베이스·헤드 브래킷 |
| PCB A0.2 | [KiCad와 제작 검토 파일](../hardware/probe_head_A02/README.md). 실크 0.8→1.0 mm, 획 0.12→0.15 mm. 회로·패드·배선·비아·홀·외곽·공칭 두께 유지 |
| 구매 준비 | 지그 SMA를 Amphenol 132139 후보로 구체화하고 지그 부속 수량 등록. 전체 실견적은 보유품·배송·세금 미확인으로 아직 계산 불가 |

도면과 공칭 간섭 계산을 진행했다. 전자기장 시뮬레이션, 출력·조립, 장비 연결, 구매, 실측은 실행하지 않았다. 100 MHz나 300 MHz 달성 여부는 여전히 미확인이다.

## 2. 실제 실행한 검증

- **FreeCAD 1.0.2:** 집게 0~90°/5° 간격 19개 위치, 30 mm 게이지 진입 21개 위치에서 공칭 교차 체적 0. 스토퍼는 90° 접촉, 91°에서 0.7621 mm³ 교차로 개방 제한 형상을 확인했다. 이는 강도·연속 회전·실물 개방각 보증이 아니다.
- **전체 지그:** 집게의 이동 부품·패드·나사와 지그를 19개 각도에서 비교해 공칭 교차 체적 0. 나사 머리–기둥 간섭을 수정했다. 전류 경로는 중심/귀환 각각 연결된 solid 1개, 두 경로 사이 최소 공칭 거리 약 0.865 mm. 코어 중앙 단면의 30 mm 구경 안에는 중심 도체만 있고 귀환은 없다. 이 거리는 절연 정격이 아니다.
- **저장 파일:** 집게 STL 5개와 지그 STL 4개를 다시 열어 solid·체적·출력 바닥 좌표를 확인했다. 형상 부피와 STL 부피 차이는 각각 0.5% 미만이다. 슬라이서·지지재·인쇄 공차는 검사하지 않았다.
- **KiCad 10.0.0:** 새 PCB의 ERC/DRC·미연결·회로도 일치 위반 모두 0, 제외 검사 0. 실제 Gerber 7개, PTH 13홀, NPTH 2홀 생성. Excellon 홀 좌표를 저장 PCB와 대조했다. 독립 CAM/제작사 DFM 승인은 남아 있다.
- **기존 110개 소프트웨어 시험:** 2026-09-16 실행 결과를 유지한다. 이번에는 분석 코드를 변경하지 않았고 동일 시험을 다시 실행하지 않았다.

검증 원본: [집게](../mechanical/clamp_A02_DRAFT/mechanical_checks.json), [집게 저장 검사](../mechanical/clamp_A02_DRAFT/saved_assembly_verification.json), [지그](../hardware/calibration_fixture/F_A_A01_DRAFT/fixture_checks.json), [지그 저장 검사](../hardware/calibration_fixture/F_A_A01_DRAFT/saved_fixture_verification.json), [PCB](../hardware/probe_head_A02/review/saved_board_verification.json), [드릴·리비전 대조](../hardware/probe_head_A02/review/fabrication_verification.json).

[패키지 최종 점검](../tests/results/build_readiness_20260917.json): 문서 링크, 원본/참조 해시, 기존·신규 CAD/검사 기록 일치, 측정·release 폴더 비어 있음 확인.

## 3. 지그 SMA 선정과 남은 공차

후보는 **Amphenol RF 132139**, 표준 극성 SMA female, rear-mount bulkhead, solder cup, 50 Ω다. [제조사 제품 페이지](https://www.amphenolrf.com/en-us/part/132139/651/)로 형식과 품번을 확인했다. RP 제품과 132139-11은 이 모델에 대입하지 않는다.

[제조사 카탈로그의 유통사 배포본](https://my.element14.com/site/binaries/content/assets/common/storefront-pdfs/amphenol-rf/pdf/amphenol_connex_catalog.pdf)을 내려받아 PDF 39쪽/인쇄 38쪽을 렌더링해 읽었다. 해당 페이지 날짜는 2001-11-27이다. CAD에 전사한 공칭값은 다음과 같다.

| 항목 | 카탈로그 값 |
|---|---:|
| 패널 최대 두께 | 3.2 mm |
| 권장 D홀 | 원 지름 6.5 mm, 아래 끝~평면 높이 6.0 mm |
| 육각 대변 | 8 mm |
| 전면 기준 어깨 / 뒤 어깨 / 컵 끝 | 11.4 / 12.7 / 17.3 mm |
| 컵 외경 / 내경 | 1.27 / 0.95 mm |

현재 생산 도면의 공개 다운로드는 이 환경에서 HTTP 403으로 차단됐다. 오래된 카탈로그로 **최신 공차와 체결 깊이를 확인했다고 하지 않는다.** CAD의 너트 위치·나사부 단순화·절연 공간·납땜 형상은 외형 가정이다. 도면 또는 실물 대조 전에는 금속 판 가공·SMA 발주안을 확정하지 않는다. [참조 원본과 해시](references/fixture_20260917/catalog_manifest.json), [읽은 도면 이미지](references/fixture_20260917/132139_catalog_page38.png).

가격은 2026-09-17 확인한 [DigiKey 미국 표시](https://www.digikey.com/en/products/detail/amphenol-rf/132139/1011914)에서 1개 구간 USD 8.58, 필요 2개는 USD 17.16, 표시 재고 2,818개였다. 커넥터·너트·lock washer 포함이라는 판매 표시가 있다. 캐시/지역별 차이가 있고 한국 배송·세금·도착일은 미확정이다. 견적이나 재고 예약이 아니다.

코어는 물리적 반쪽 2개가 필요하지만, 판매처의 1주문 단위가 반쪽인지 한 쌍인지 아직 확인하지 못했다. [DigiKey 제품](https://www.digikey.com/en/products/detail/fair-rite-products-corp/2644181281/8594102)의 표시 가격은 USD 9.23/단위, 재고 0이었다. 이전 Mouser USD 8.73/단위·재고 156 기록을 현재 주문 가능 수량으로 승격하지 않는다. 판매처 확인 없이 수량 1 또는 2를 확정하지 않는다.

## 4. PCB 제작 조건 검토

초기 견적 조건은 **FR-4, 2층, 완성 1.6 mm, 외층 1 oz, 무연 HASL, 녹색 마스크, 흰 실크, 20×16 mm 라우팅, 손납땜, 비제어 임피던스**다. 첫 헤드는 1개 사용, 견적 수량은 5개로 시작한다. 실제 최소 주문 수량/가격은 확인 전이다.

[JLCPCB 공개 제작 능력](https://jlcpcb.com/capabilities/Capab)을 2026-09-17 확인했다. 공칭 1.6 mm의 ±10% 범위는 1.44~1.76 mm, 일반 라우팅 ±0.2 mm, through-hole 지름 +0.13/−0.08 mm, 홀 위치 ±0.05 mm다. 실크 높이 1.0 mm/획 0.15 mm에 맞춰 A0.2를 수정했다. 작은 bare PCB 최소 크기와 PCBA 조립 최소 크기를 혼용하지 않았다.

**남은 차이:** GCT 권장 PCB 도면은 ±0.05 mm를 표기한다. 제작사의 일반 홀 지름 공차를 그 요구에 적합하다고 간주할 수 없다. Ø1.50/Ø1.70 완성 홀과 핀 공차를 제작사/실물로 대조해야 한다. 프레스핏 특수 공차 옵션은 현재 2층 HASL 안에 자동 적용되지 않는다. 보드 ±두께·외곽 공차와 프린터 오차를 합친 기구 맞춤도 미검증이다. 짧은 신호 배선을 50 Ω 제어 임피던스선이라고 표시하지 않는다.

## 5. 다음 실물 진행 순서와 멈추는 조건

1. **보유품 대조:** LibreVNA HW/FW/GUI, 교정키트/모델, SMA 케이블·부하·감쇠기, 오실로 명판. 보유품을 모르면 추가 구매 비용과 교정 경로를 확정할 수 없다.
2. **견적/맞춤 확정:** 코어 판매 단위, 132139 최신 도면, 헤드 SMA 플러그/감쇠기의 실제 체결 외형, PCB 공차, 출력 수단. 실제 케이블/부트와 개폐 공간도 기록한다.
3. **구체적 구매안:** 필요한 부품만 수량·포장 최소량·배송·세금까지 합산한다. 목표 10만 원/상한 20만 원. 기존 195,020원은 배정 시나리오이며 새 지그·교정 준비를 포함한 최종 견적이 아니다. 초과하면 낮은 출력의 VNA 벤치 단계를 먼저 견적하되 그 단계의 종단·검증은 유지한다.
4. **승인된 제작 후:** 시험편→실물 치수/패드/스토퍼 맞춤→헤드·지그 조립→무전원 연속성/분리 검사→T01/T02. 가공/출력/구매는 이번에 실행하지 않았다.
5. **RF 최초 저장:** `measurements/raw/<날짜>_<fixture-ID>/`에 `metadata.json`, `fixture_nohead_forward.s2p`, `fixture_nohead_reverse.s2p`, `head_A_5T.s2p`, `head_A_5T_repeat01.s2p`. 실제 장비 버전·교정 ID·기준면·전력·IFBW·포인트·부하/케이블 ID를 기록한다. [벤치 절차](G2_BENCH_PROCEDURE.md)의 T01~T05를 따르고 우선 상대 S21로 분류한다.
6. **스코프:** [전체 연결 검토](END_TO_END_REHEARSAL.md)의 BNC 기준면/수신기 응답 조건을 충족하기 전에는 전압 관측까지다. SMA 감쇠기만으로 현장 보호가 끝났다고 하지 않는다.

지금의 막힘은 회로 값을 추가로 정하는 일이 아니라 **보유품·실물 맞춤·판매 단위·최신 공차·도착 견적을 확인할 수 없다는 것**이다. 위 정보가 확인될 때까지 제조 승인은 보류한다. 필요한 사용자 확인은 [누적 목록](OPEN_DECISIONS.md)에 모았다.
