ckh7488/rf_current_probe/viewer_A05/set_sources/manual_current.html

01 · 목적과 범위

## 케이블 전체를 감싸서 RF 합전류를 본다

산업용 Ethernet·24 V 하네스의 간헐 장애를 조사하기 위한 수동 RF 전류 프로브다. 코어 안을 지나는 도체들의 전류를 부호까지 더해서 본다. 서로 상쇄되는 정상 차동 전류와 달리, 케이블 밖으로 귀환하는 공통모드 성분은 합전류로 남을 수 있다.

교류의 시간 평균이 0이어도 주파수별 크기나 순간 전류는 0이 아니다. 이 프로브는 그 RF 성분을 관측한다. DC 전류 센서는 포함하지 않는다. 실드까지 감싸면 실드 전류도 합에 포함되므로, 어떤 도체군을 통과시켰는지 기록한다.

개발 목표 100 kHz–300 MHz, 먼저 확인할 구간 1–100 MHz. 현행 A03으로1–500 MHz 보정을 수행하고 주파수별 ZT·오차를 기록한다. 어느 구간도 실측 완료 사양이 아니다.

02 · 구성

## 프로브·두 클램프·교정 PCB의 역할

부분 | 하는 일
가운데 프로브 | 분할 코어+권선 → 헤드 PCB → SMA. 전류를 출력 전압으로 바꾸는 센서.
앞뒤 케이블 클램프 | 각각 큰 노브 하나로 세 턱을 움직여 케이블 위치와 하중을 받는다. 앞뒤 노브는 따로 조작한다.
공통 바닥 | 세 모듈의 높이 기준을 맞춘다. 공칭 중심높이 88 mm, 바닥 186×314 mm. 실제 정렬은 확인해야 한다.
큰 평판 교정 PCB | 교정 때 전류를 흘리는 경로다. 전류 크기와 주파수별 모델은 검증 전이다. 중앙 경로만 코어 안을 지나고 귀환은 두 바깥 레일로 간다.

클램프의 공칭 설계 구경은 Ø6–26 mm다. 2026-09-22 사용자가 실제 큰 대상도 약20 mm 수준이고 현행26 mm 기준이면 충분하다고 확인했다. 헤드 고정바를 포함한 공칭 통과 지름은 약26.40 mm이며 초기30 mm 목표는 대체한다. 커넥터를 구경에 통과시키지 않고 케이블을 위에서 넣는다. 실제 중심 오차·외피 눌림·주변 커넥터 간섭은 조립 시 확인한다.

캘리브레이션 및 사용법 보기 →

헤드 PCB 나사 F01: PA66 M2×12 두 개. 10 mm에서 길이만 늘렸으며 출력물은 그대로 사용합니다. 첫 입고 때 머리 아래 길이11.7–12.3 mm와 체결 그립7.85–8.85 mm를 확인하고, 조립 후 완전 나사산이 너트 뒤로 나오며 다른 부품에 닿지 않는지 확인합니다. H05에서 PCB를 먼저 앉힌 다음 나사를 넣습니다.

03 · 조립

## 조립은 절차서 순서대로

1. 하부 몸체 3조각, 뚜껑 2조각, 바닥 3조각을 먼저 조립한다. 새 연결부는 PA66 M4 나사·너트와 양쪽 와셔를 사용한다. 구멍을 나사 힘으로 당겨 맞추지 않는다.
2. 헤드 PCB에 SMA를 먼저 납땜한다. 아래 코어에 절연과 권선을 준비한다.
3. 권선 끝선은 납땜하지 않은 채 경로 밖으로 빼 두고, PCB를 45° 기울여 장착 위치보다 4 mm 아래에서 넣은 뒤 올린다. 장착면에서 살짝 띄운 상태로 세운 뒤 마지막에 앉힌다. 장착면에 누른 채 기울이지 않는다. PCB를 고정한 다음 S+ / S−에 권선을 납땜하고 코어 고정바를 단다. PCB를 다시 뺄 때는 먼저 권선 두 가닥의 납땜을 제거하고 나사를 푼 뒤, 장착면에서 앞쪽으로 살짝 띄우고 기울인다.
4. 같은 케이블 클램프를 두 개 조립한다. 가로대 사각너트는 가로대를 올리기 직전에 넣는다.
5. 바닥 위에 세 모듈을 올린다. 아래 너트를 한 개씩 받치며 체결한다. 너트 여섯 개를 미리 넣고 뒤집지 않는다.
6. 교정할 때만 큰 PCB를 장착한다. 권선·코어 맞댐면·PCB에 무리한 힘을 가하지 않는다.

권선과 납땜 외에 동판 가공, 패드 재단, 스프링 조립은 없다. 반복 체결은 관통 홀과 기성 너트를 사용한다. 제품 CAD는 A14/C07이며 출력용 뚜껑은 UpperLeft_A14_DRAFT / UpperRight_A14_DRAFT다.

현행 조립절차서 열기 →

### 뚜껑 개폐 손나사의 선조립 · H12A

M4×70 스터드에 잼너트를 먼저 넣고 관통노브를 돌려 넣습니다. 스터드 끝을 노브 윗면과 평평하게 맞춘 뒤 프레임 밖에서 노브를 잡고 7 mm 스패너로 잼너트를 노브 밑에 조입니다. 아래에서 PA 와셔를 넣으면 손나사 하나처럼 사용할 수 있습니다. 절단·압입은 필요 없습니다. 반복 개폐 후 노브와 잼너트가 함께 풀리지 않는지 확인합니다.

### 큰 노브축의 선조립

M6×120 스터드 끝에서 10 mm를 표시하고 잼너트를 먼저 넣는다. 노브를 표시까지 돌려 끼운 뒤, 프레임 밖에서 노브를 잡고 10 mm 스패너로 잼너트를 금속 부싱에 밀착한다. 상부 와셔를 끼운다. 위·아래 와셔는 같은1.6 mm 제품이며, 아래 잠금너트는 이 두께에 맞춰 위치를 조절한다. 이후 프레임 아래의 와셔·풀림방지 너트와 구동너트를 통과시킨다.

### 큰 노브축의 조절

프레임 아래쪽 풀림방지 너트는 프레임을 꽉 죄는 용도가 아니다. 약 0.2 mm의 축 여유를 시험 목표로 맞추고, 스패너를 뺀 뒤 너트가 축과 함께 회전해야 한다. 과조임은 회전을 막을 수 있고, 과한 여유는 덜컥거림을 만든다. 아래 구동너트 홈의 공칭 1 mm 유격은 별개다.

이는 조정이 필요한 시제품 구조다. 반복 회전 후 여유 유지·마찰·케이블 고정력은 실물에서 확인해야 한다. 축 조절 단계 →

04 · 실험실 교정

## A03으로500 MHz까지 프로브를 교정한다

이 절은 검증을 끝낸 교정기의 즉시 사용법이 아니라 앞으로 수행할 시험 절차입니다. 전체 제작·교정 준비 상태에서 선행 조건을 먼저 확인합니다.

### A. 지그 through 확인

VNA PORT1→교정 PCB 입력 → 출력→VNA PORT2

교정지그는 Fixture A03입니다. 중앙 SIG만 코어 안을 지나고 리턴은 두 창 바깥으로 흐릅니다. 빈 지그 S11은 300 MHz 이상에서 커지지만, 교정은 실제 출구 전달량과 코어 위치 보정 K를 이용하므로 S11 크기만으로 대역을 제한하지 않습니다. 화면은 A03과 외곽·고정홀이 같은 공통 장착 형상을 보여 줍니다. 제조 기준은 A03 원본입니다. A03 보정 원리와 수치를 확인하세요.

케이블 끝 기준면에서 유효한 2포트 교정을 먼저 한다. 프로브 없는 지그의 S11/S21을 저장한다. 다음에는 프로브를 장착하고 프로브 출력을 외장 50 Ω 로드로 종단한 채 다시 저장해, 삽입에 따른 변화를 확인한다.

### B. 프로브 전달 응답 측정

VNA PORT1→교정 PCB 입력 → 출력→외장 50 Ω 로드

프로브 출력 SMA→VNA PORT2 · 50 Ω

RF 출력을 끈 상태에서 재배선한다. 같은 외장 로드를 프로브 출력에서 지그 출력으로 옮기면 된다. 프로브 출력은 PORT2가 종단하므로 외장 로드를 추가로 병렬 연결하지 않는다.

시작 설정안은 1–100 MHz, 1601 points, −30 dBm, IF BW 1 kHz, 평균 4회다. 실제 장비 지원값·입력 정격·교정 유효성을 확인하고 설정을 저장한다. 이후100–300 MHz와300–500 MHz도 같은 A03에서 교정한다.

### C. 로드 반사와 역방향 확인

B에서 지그 출력을 받은 같은 외장 수형 로드의 ΓL을 별도로 교정된 SMA 암 기준면에서 저장한다. RF OFF 후 기존 2포트 교정·배치를 보존하고 P2 케이블을 뺀다. VNA 암 포트에 모델이 확인된 수형 OPEN·SHORT·LOAD 표준으로 별도 1포트 SOL을 적용한 뒤 작업용 로드를 직접 연결한다. 물리 P2 반사 S22를 선택해 1포트 S1P로 저장하면 파일 안에서는 S11이다. 로드·기준면·표준 모델·물리 포트·별도 교정 ID를 기록한다. 수형 케이블 끝에는 연결되지 않으며 F/F 어댑터만 추가하고 이전 교정을 유지하지 않는다. 작업용 로드를 교정 표준으로 간주하지 않는다. through/전달 재측정 전 원래 2포트 배치를 복구하고 유효성을 재확인한다. 다음에 지그 입력과 출력을 바꿔 A·B를 반복한다. 두 방향의 교정 결과를 비교해 일관성을 확인한다. 양방향에 공통으로 남는 모델 오차는 별도 불확도로 기록한다.

교정량은 ZT(f) = Vout(f) / Iprimary(f)다. 코어 전류는 A의 프로브 장착 through에서 출구로 나온 전류로 정한다: ZT = 50 × S21(B) × (1 − S22(A)·ΓL) / [S21(A) × (1 − ΓL)] / K. K는 실제 종단·장착 조건에서 코어 전류와 출구 전류의 차이를 환산하는 보정량이다. 로드/P2 교환 때 헤드 부하 변화도 평가한다. A와 B 사이에는 로드와 PORT2 자리만 바꾸고 지그·프로브·케이블을 건드리지 않는다. 이 방식으로1–500 MHz 보정을 수행하며, 주파수별 ZT·불확도·유효성을 기록한다. 300 MHz를 기준으로 일괄 참고 처리하지 않는다. −6 dB는 전력 약1/4·전류 진폭 약1/2이며 알려진 전달 비율로 보정한다. ZT ≈ 50×S21처럼 보낸 전류를 그대로 코어 전류로 보는 근사나 지그 S11만으로 하는 보정은 쓰지 않는다. 오프라인 분석기의 출력 기준 모드는 구현·합성 파일 시험을 마쳤다. 장착 through와 전달의 정/역방향 S2P, 별도 암 기준면 로드 S1P, 복소 K, 주파수별 검토·불확도 기록을 함께 읽는다. 파일 해시·개체·기준면 불일치는 거부하고, 미평가 또는 null·직접 픽업·반복성·정/역방향 검사 실패 구간에는 절대 ZT를 표시하지 않는다. 조건을 확보하기 전 원자료는 상대 S21로 보존한다.

Ethernet의 100 Ω 차동 임피던스에 맞춰 프로브를 다시 교정하는 뜻은 아니다. 50 Ω은 지그와 출력 측정 체인의 조건이다. 검증된 범위에서 통과한 도체군의 RF 합전류를 환산하되, 프로브 장착 자체가 원래 전류를 바꾸는지도 확인해야 한다.

장비 절차 근거: LibreVNA 공식 매뉴얼 (https://github.com/jankae/LibreVNA/blob/master/Documentation/UserManual/manual.tex). 수치와 판정 범위는 프로젝트의 초기 시험안이다.

05 · 실제 케이블 측정

## 기본은 탁상 사용, 프로브만 분리도 가능

1. 교정 PCB와 지그용 로드를 제거한다. 코어 뚜껑과 앞뒤 가로대를 연다.
2. 측정할 케이블을 위에서 놓는다. 세 곳을 닫고 앞뒤 큰 노브로 가볍게 중심을 맞춘다. 코어가 케이블 하중을 받지 않게 한다.
3. 프로브 SMA를 검증된 출력 체인으로 수신기에 연결한다. 동축 무게와 당김은 별도로 받친다.
4. 같은 위치·동축 경로·출력 체인을 유지하고 파형, 장애 로그, 측정 도체군을 기록한다.

### 외장 감쇠기 R05는 어디에 연결하나

평상시 측정은 감쇠기 없이 프로브 SMA를 R06 케이블로 스코프 CH1(내부 50 Ω)에 바로 연결한다. 스코프 50 Ω 입력의 문서 한계는 5 V RMS·피크 ±20 V이고, 정상 운전의 CM은 mA 이하라 프로브 출력은 수십 mV 이하다. 강력 권고: 새 현장·새 케이블의 첫 측정은 반드시 감쇠기를 넣고 최대값을 확인한 뒤 뺀다. 케이블 착탈·전원 투입 순간, 전원 도체만 따로 잴 때도 넣는다. 전원 도체는 +V와 GND를 함께 코어에 넣는다.

감쇠기를 쓸 때는 프로브의 SMA 암 커넥터에 감쇠기의 SMA 수 커넥터를 돌려 끼운다. R05는 Mini-Circuits VAT-10A+ 10 dB 후보이며, 헤드 PCB에 납땜하는 부품이 아니다. 감쇠기의 반대쪽 SMA 암에는 R06 케이블의 SMA 수를 연결한다.

프로브 출력
SMA 암→R05 · 10 dB 감쇠기
SMA 수 → SMA 암→R06 · 케이블
SMA 수 → BNC 수→스코프 CH1
BNC 암 · 내부 50 Ω

대상 하네스(24 V·100BASE-TX)에는 이 밖의 입력 보호 체인(R08)을 두지 않는다(DEC-055). 상용전원·VFD·고전압·서지 현장은 이 시제품의 범위 밖이며, 적용하려면 보호 구성을 새로 정하고 출력 체인을 다시 특성화한다.

현재 3D와 45단계 기구 조립에는 외장 감쇠기가 표현되어 있지 않다. 직접 체결할 공간, 공구 접근과 PCB·SMA에 걸리는 하중은 아직 확인하지 않았다. 체결부에 동축 무게나 당김이 실리지 않도록 별도로 지지하며, 간섭이나 비틀림이 생기면 강제로 연결하지 않는다.

위의 B절은 헤드 자체를 보는 낮은 레벨의 VNA 측정이므로 감쇠기 없이 PORT2에 연결하는 구성이다. 이후 출력 체인 특성화에서는 실제 사용할 감쇠기·케이블·배치를 포함하고 개체 ID를 기록한다. 감쇠기를 추가·제거하거나 배치를 바꾼 뒤 이전 교정값을 그대로 적용하지 않는다. R05 규격과 후보 부품 →

전압 관측과 전류 환산을 구분합니다. VNA 교정은 헤드 SMA까지입니다. R06 케이블과 스코프 입력의 응답은 LibreVNA CW 출력을 R06으로 스코프에 넣어 주파수별로 확인하고, 그 전에는 V 단위로 기록합니다. 현재 분석 도구는 조건을 갖춘 단일 정현파의 RMS 전류까지 지원하며, 광대역 펄스 전류 파형 복원은 구현하지 않았습니다.

시작 설정은 DC 결합, 정의된 50 Ω 종단, 전압 입력, 대역 제한 해제, 일반 샘플링이다. 메뉴 이름·지원 조합·입력 정격은 사용할 장비의 설명서에서 대조한다. 내부 50 Ω과 외장 50 Ω 종단을 병렬로 사용하지 않는다. AC coupling에서 같은 50 Ω 조건이 유지된다고 가정하지 않는다. 외부 감쇠 보정을 이중 적용하지 않는다. FFT는 표시 샘플레이트1 GS/s 이상에서 보고, 저역을 길게 잡을 때는 대역 제한(20 MHz)이나 Hi-Res로 접힘을 막는다.

바닥 고정 나사 두 개를 빼면 프로브만 분리할 수 있다. 이때 앞뒤 중심 클램프의 지지는 없어지므로 선 위치와 동축 하중을 따로 관리한다. 분리 전후 응답이 같다는 보장은 없으며 실제 사용 배치로 확인한다.

출력 동축은 코어 구경 밖으로 빼고 별도로 지지한다. 코어를 감싸는 금속 테이프나 추가 접지선을 임의로 연결하지 않는다. 차폐를 추가하면 닫힌 도전 경로와 교정 영향을 다시 확인한다.

이 시제품에는 안전 정격이 없다. 대상 하네스 밖의 환경(상용전원·고전압·서지)에는 쓰지 않는다. 보호접지 제거·실드 임의 절단·고전압 직접 적용 없이, 검증된 저에너지 벤치 시험부터 진행한다.

500 MHz 대역폭·2.5 GS/s는 이 시제품의 장비 선정 권장 조건이며 전 대역 진폭 정확도를 보장하지 않는다. 대역폭·샘플링 관계: Tektronix 계측기 선정 자료 (https://www.tek.com/en/documents/primer/evaluating-oscilloscopes). 장비 근거: Tektronix 원 MSO4054 계열 검증 매뉴얼 (https://download.tek.com/manual/077024701Rev_A_web.pdf). VNA 교정만으로 스코프 입력 응답까지 자동 보정되지는 않는다.

06 · 첫 조립과 측정의 확인

## 어디까지 확인됐는가

구분 | 현재 상태 / 확인할 내용
공칭 CAD | 저장 형상과 일부 조립·개폐 경로를 검사했다. 슬라이더는 나사산·손·마찰을 푸는 시뮬레이터가 아니다.
확인한 조립 경로와 실물 확인 | H05는 장착면에서 먼저 띄우는 동작을 포함한 45°/4 mm PCB 삽입 경로, B05/B07은 왼쪽 나사를 25 mm 올린 뒤 바깥으로 빼는 경로를 확인했습니다. 뒤쪽 M2는 가는 평팁으로 잡으며 외경6.5 mm 원형 소켓은 홀더와 간섭합니다. 평팁과 M3 공구의 계산 조건은 H04·H08·H11을 따릅니다. 실제 공구의 맞물림·손 작업·C07 회전감·유격은 첫 실물에서 확인합니다.
실물 맞춤 | 핵심 기성품 치수, 출력 공차·평탄도, 코어 맞댐과 닫힘 힘, 앞뒤 중심 정렬, 케이블 외피 눌림 확인 전.
RF 확인 | A03 전류 환산, 선형성, 위치 민감도, 직접 픽업, 삽입 영향, 개폐 반복성과 유효 대역을 측정해야 한다. 금속과 코어 사이 거리만으로 무영향을 보장하지 않는다.

권선의 DC 저항이 낮다고 곧바로 단락 불량은 아니다. 권선 연속성과 일차 경로·다른 금속으로의 의도치 않은 도통을 구분해 검사한다. 헤드 출력에 수신기 외의 50 Ω 종단을 중복 추가하지 않는다.

실측에서는 최소 5회 개폐 반복, 여러 케이블 위치, 소스 레벨 변경, 프로브 장착 전후를 비교한다. 현재 목표값을 통과한 측정 결과로 표현하지 않는다.

07 · 기록과 유지

## 형상과 교정 ID를 함께 보관한다

- 헤드 ID, 코어·권선 수, PCB/기구 리비전, 사진, 체결 상태.
- VNA·케이블·로드·감쇠기 ID, 기준면, 주파수·레벨·IF BW·평균 설정.
- 원시 .s2p, 스코프 원시 파형, 장비 설정, 실패한 결과까지 보존.
- 유효 주파수 구간과 불확도. 기준면이나 출력 체인을 바꾸면 교정 재사용 가능성을 다시 확인.

코어 맞댐면은 깨끗하게 유지하고 이물질·테이프·접착제를 넣지 않는다. 균열, 권선 피복 손상, 노브 유격 변화가 있으면 사용을 멈추고 확인한다. 리비전이 바뀐 부품을 이전 구매서와 섞지 않는다.

이 설명서는 현재 설계의 사용·검증 절차를 정리한 문서다. 실물 제작 완료나 현장 사용 승인을 뜻하지 않는다.
