ckh7488/rf_current_probe/mechanical/assembly_A17_DRAFT/README.md

# A17/C10 국부 보강 원본

DRAFT — NOT FOR FABRICATION.

P06 가이드 받침 연장과R2.5/R0.75 보강만 변경. 전체15종20개·재질·체결품 유지. 상세 결과와 해시는 [검토 보고서](../../reviews/c10_guide_fix_20260928/REPORT.md)와 [제작 파일 선택](../../docs/3D_PRINT_RELEASE_A17_C10.md)을 따른다. 실물/RF 미검증.
