ckh7488/rf_current_probe/docs/atlas/review/cad-live/step-1.png

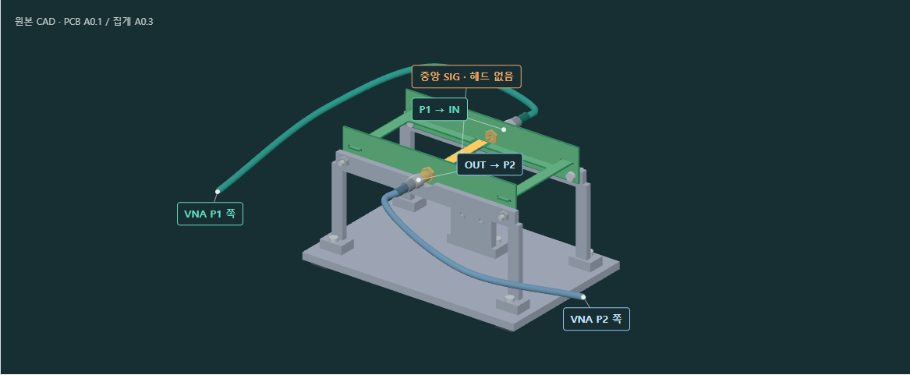
docs/atlas/review/cad-live/step-1.png
