ckh7488/rf_current_probe/docs/atlas/review/live/step-0.png

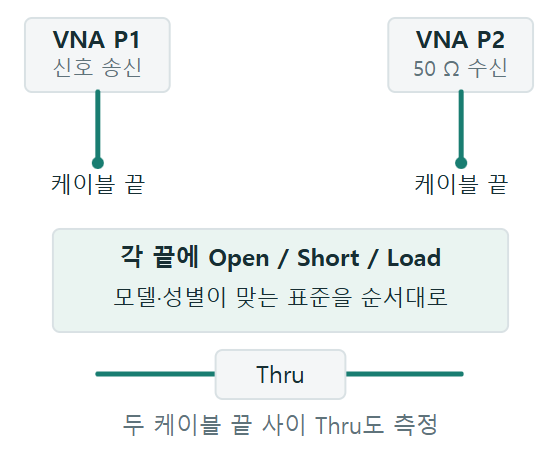
docs/atlas/review/live/step-0.png
