ckh7488/rf_current_probe/docs/atlas/review/live/step-1.png

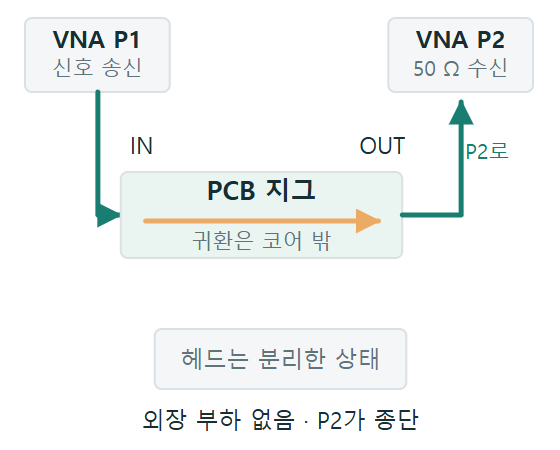
docs/atlas/review/live/step-1.png
