ckh7488/rf_current_probe/docs/atlas/review/live/step-3.png

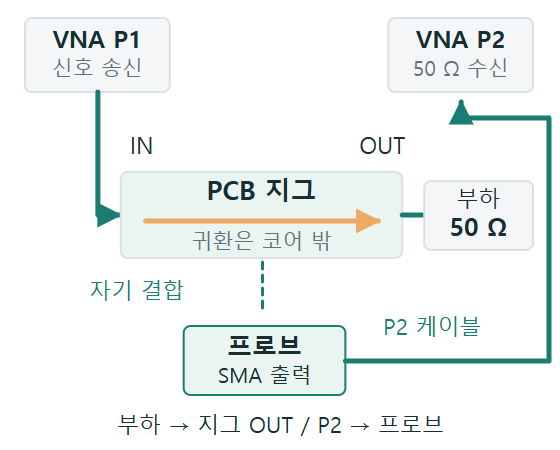
docs/atlas/review/live/step-3.png
