ckh7488/rf_current_probe/docs/atlas/review/split-a02-live/assembly-full-desktop.png

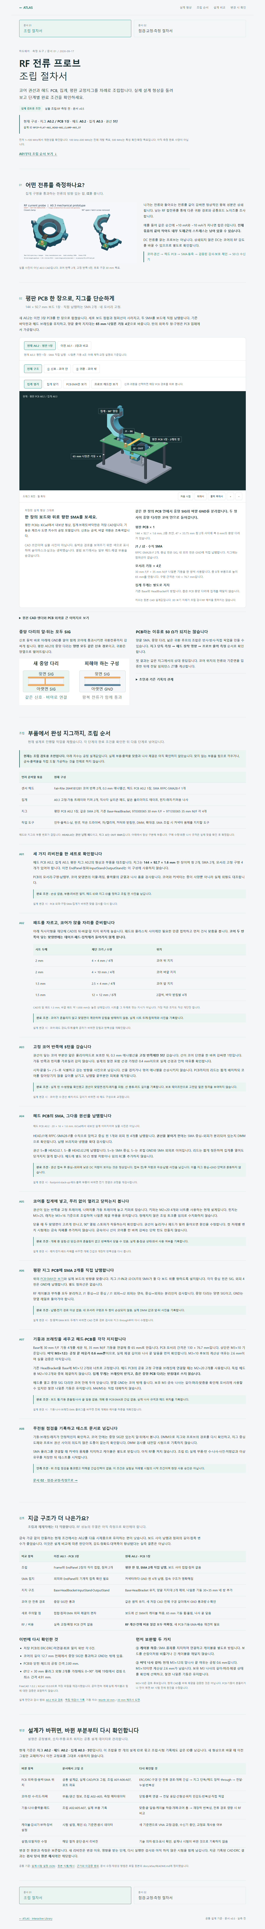
docs/atlas/review/split-a02-live/assembly-full-desktop.png
