ckh7488/rf_current_probe/docs/atlas/review/split-a02-live/assembly-step-390.png

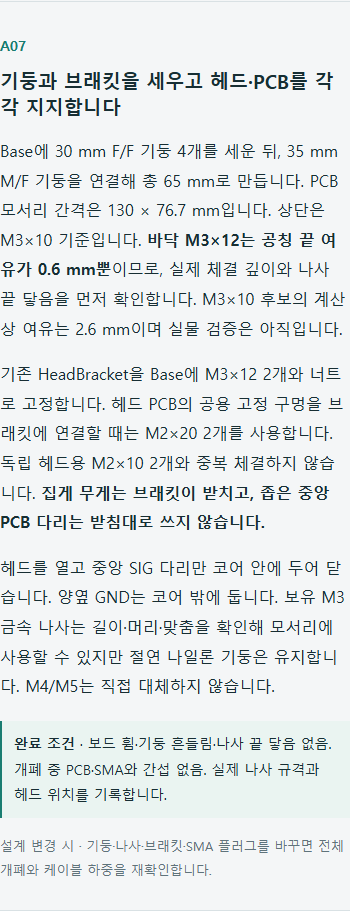
docs/atlas/review/split-a02-live/assembly-step-390.png
