ckh7488/rf_current_probe/docs/atlas/review/split-a02-live/step-1.png

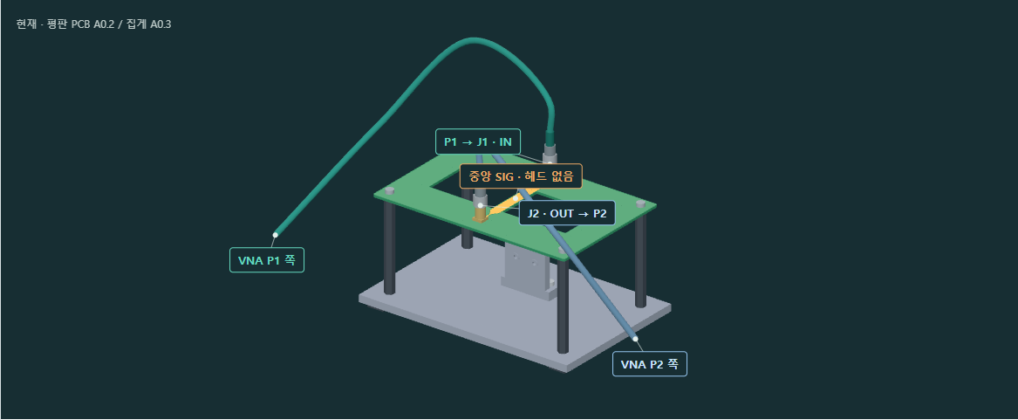
docs/atlas/review/split-a02-live/step-1.png
