ckh7488/rf_current_probe/docs/atlas/review/split-a02/assembly-full-desktop.png

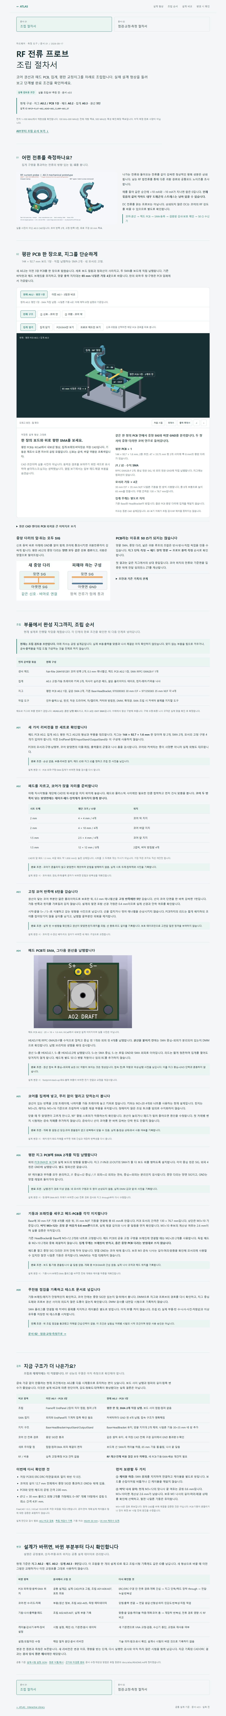
docs/atlas/review/split-a02/assembly-full-desktop.png
