ckh7488/rf_current_probe/docs/atlas/review/split-a02/head-assembly-step.png

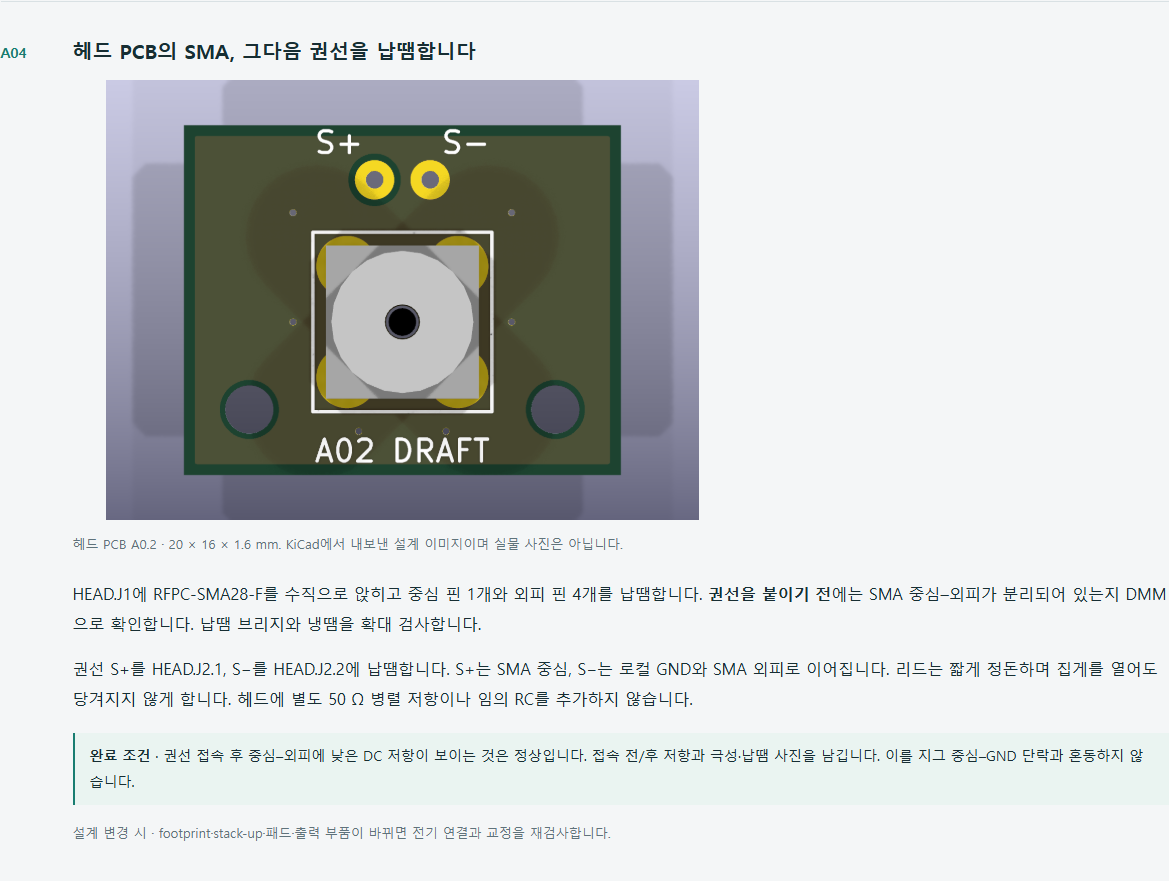
docs/atlas/review/split-a02/head-assembly-step.png
