ckh7488/rf_current_probe/viewer_A05/audit_sources/nut_access_20260918/VERIFICATION.md

# 최종 검사 요약 — A12/C06

2026-09-18. **CAD와 계산 검증이며 실물 제작 승인이나 RF 성능 검증이 아니다.**

| 검사 | 실행 결과 | 범위 |
|---|---|---|
| 통합 개폐·PCB/헤드 탈착·클램프 구동 | 233개 이산 위치 통과 | 정해진 조립 순서와 공칭 형상 |
| 코어 치수 민감도 | 아래 8 + 위 16 조합 통과 | 백서/기존 설계에서 정한 ADC 치수 조합 |
| 새 바닥 판과 나사 | 판 탈착31위치, 나사 단계탈착258위치 통과 | 프레임을 피하는 단계별 경로 |
| 너트 삽입 | 담당 검사360위치, 독립 검사402위치 통과 | 서로 다른 순서/치수 조건의 검사이며 개수를 합산하지 않음 |
| 너트 포획/받침 | 독립144직선경우, 12곳 받침 검사 통과 | 나사를 제거한 서비스 상태. 모든 복합 회전 이탈의 증명 아님 |
| 캡 정비 접근 | Ø12 mm 손끝 게이지400자세, 인출80위치 통과 | 교정 캡은 헤드 제거, 앞 클램프 캡은 해당 모듈 제거 조건 |
| 출력 파일 | 12종 단일 유효 솔리드, STL 폐곡면·양의 체적 통과 | 전체 출력 수량26개, 350×350×400 mm 명목 출력함 이내 |
| 벽 두께 표본 | 48,000곳에서 2 mm 미만 표본0 | 전체 최소 벽 두께의 보증은 아님. 오른쪽 바닥 고정부 외벽은1→3 mm로 보강 |
| 기존 자유 뚜껑 | A11과 동일한 STL 및 형상 | 기존 선형 해석 범위를 새 스냅 캡까지 확장하지 않음 |

**손끝 게이지의 실제 최소 간격은 약0.487 mm**다. 검토 중 목표로 삼은1 mm를 전체 조립체에서 달성한 것은 아니다. 공칭 무간섭과 실제 손조작의 편안함·출력 공차·스냅 힘을 구분한다. 눌러 끼움과 해제, 반복 수명은 시험 출력으로 확인해야 한다.

SMO-3(N) 날개 너트는 제조사 치수의 외접 모델이다. 삽입 가능성 검토에 쓰지만, 실제 날개 곡면의 최소 재료 분포가 없으므로 실제 포획·회전 유격까지 보증하지 않는다. M6 노브축의 최종 판매품도 아직 대조가 필요하다.

## 원본 연결

- A12 native SHA256: `3d9cef1eade42c457e162061210bea1b19844fb87dfb96775ae762f5ac00ed96`
- C06 native SHA256: `aed64915133eddd4fa319ee235b393f2e08870ff29928b210f35cdabdd16fb22`
- [A12 기본/치수 검사](../../mechanical/assembly_A12_DRAFT/verification.json)
- [A12 국소 조립 검사](../a12_20260918/targeted_verification.json)
- [독립 검토와 조건](../independent_a12_20260918/README.md)
- [독립 검사 원본 연결](../independent_a12_20260918/audit_manifest.json)
- [C06 검사와 남은 조건](../c06_20260918/README.md)

PCB 설계를 이번에 변경하지 않았으며, 과거 ERC/DRC 결과를 이번에 재실행했다고 보고하지 않는다. 새로운 RF 측정·전기 성능 시험은 수행하지 않았다.
