ckh7488/rf_current_probe/tests/results/end_to_end_20260916/inputs/cw.csv

time_s | voltage_v
0.000000000000000000e+00 | 1.134797217404813442e-03
1.000000000000000062e-09 | 1.405008348163627827e-03
2.000000000000000125e-09 | 1.672728649967441042e-03
2.999999999999999980e-09 | 1.932148448064139462e-03
4.000000000000000249e-09 | 2.177648879981154261e-03
5.000000000000000105e-09 | 2.403986852582801984e-03
5.999999999999999960e-09 | 2.606467150363969438e-03
6.999999999999999816e-09 | 2.781095651752950575e-03
8.000000000000000498e-09 | 2.924708277414679591e-03
8.999999999999999527e-09 | 3.035071152007566553e-03
1.000000000000000021e-08 | 3.110948478185496073e-03
1.099999999999999924e-08 | 3.152135762821162059e-03
1.199999999999999992e-08 | 3.159457260041182661e-03
1.300000000000000060e-08 | 3.134727760335732655e-03
1.399999999999999963e-08 | 3.080680114945937454e-03
1.499999999999999866e-08 | 3.000861095319171026e-03
1.600000000000000100e-08 | 2.899499305782949135e-03
1.700000000000000002e-08 | 2.781349854117193873e-03
1.799999999999999905e-08 | 2.651521304467758296e-03
1.900000000000000139e-08 | 2.515291061014989296e-03
2.000000000000000042e-08 | 2.377915736899756036e-03
2.099999999999999945e-08 | 2.244443236744816939e-03
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
