ckh7488/rf_current_probe/tests/results/end_to_end_20260916/vna_extraction/zt.csv

frequency_hz | s21_db | zt_real_ohm | zt_imag_ohm | zt_magnitude_ohm | zt_db_ohm | phase_deg | valid | uncertainty_db | quality_flag
1000000.0 | -30.0 |  |  | 1.5811388300841898 | 3.9794000867203767 |  | True |  | UNASSESSED|MAGNITUDE_ONLY
10000000.0 | -30.0 |  |  | 1.5811388300841898 | 3.9794000867203767 |  | True |  | UNASSESSED|MAGNITUDE_ONLY
30000000.0 | -30.0 |  |  | 1.5811388300841898 | 3.9794000867203767 |  | True |  | UNASSESSED|MAGNITUDE_ONLY
100000000.0 | -30.0 |  |  | 1.5811388300841898 | 3.9794000867203767 |  | True |  | UNASSESSED|MAGNITUDE_ONLY
