ckh7488/rf_current_probe/tests/results/hi_model_demo/zt.csv

frequency_hz | s21_db | zt_real_ohm | zt_imag_ohm | zt_magnitude_ohm | zt_db_ohm | phase_deg | valid | uncertainty_db | quality_flag
100000.0 | -20.172003519422162 | 5.000000000000001 | 0.0 | 5.000000000000001 | 13.979400086720377 | 0.0 | True |  | UNASSESSED
102879.74994739494 | -20.172003524340546 | 5.0 | -1.9549490702327498e-19 | 5.0 | 13.979400086720377 | -2.2402066177472185e-18 | True |  | UNASSESSED
105842.42949238508 | -20.17200352954628 | 5.0 | -1.9549490681272228e-19 | 5.0 | 13.979400086720377 | -2.240206615334462e-18 | True |  | UNASSESSED
108890.42680001356 | -20.172003535056152 | 4.999999999999999 | -1.954949065898682e-19 | 4.999999999999999 | 13.979400086720375 | -2.2402066127807432e-18 | True |  | UNASSESSED
112026.19880850508 | -20.172003540887935 | 5.0 | 0.0 | 5.0 | 13.979400086720377 | 0.0 | True |  | UNASSESSED
115252.27320976155 | -20.17200354706044 | 5.0 | 0.0 | 5.0 | 13.979400086720377 | 0.0 | True |  | UNASSESSED
118571.25048689113 | -20.17200355359357 | 5.0 | 0.0 | 5.0 | 13.979400086720377 | 0.0 | True |  | UNASSESSED
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
