ckh7488/rf_current_probe/docs/atlas/review/cad-live/calibration-390.png

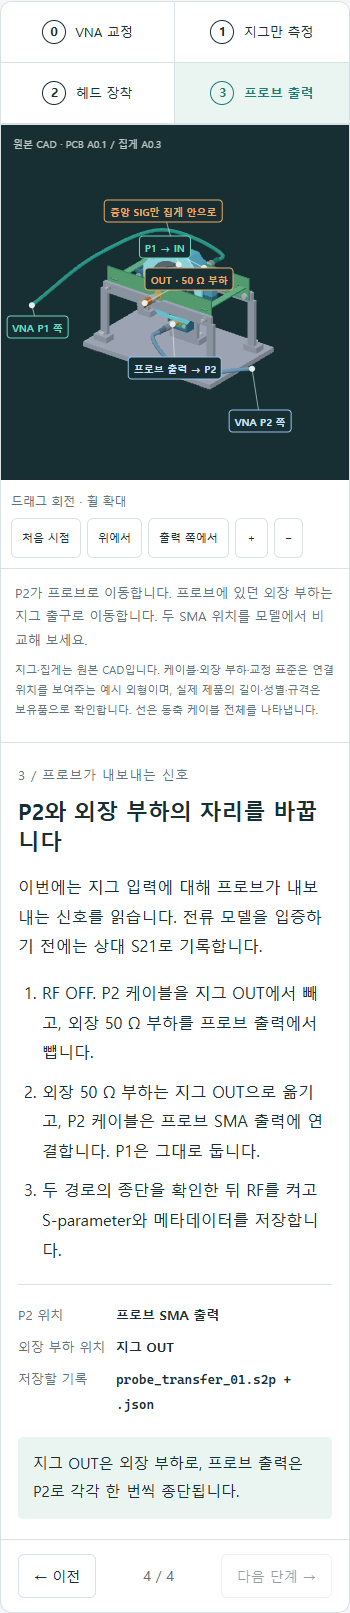
docs/atlas/review/cad-live/calibration-390.png
