ckh7488/rf_current_probe/docs/atlas/review/calibration-320.png

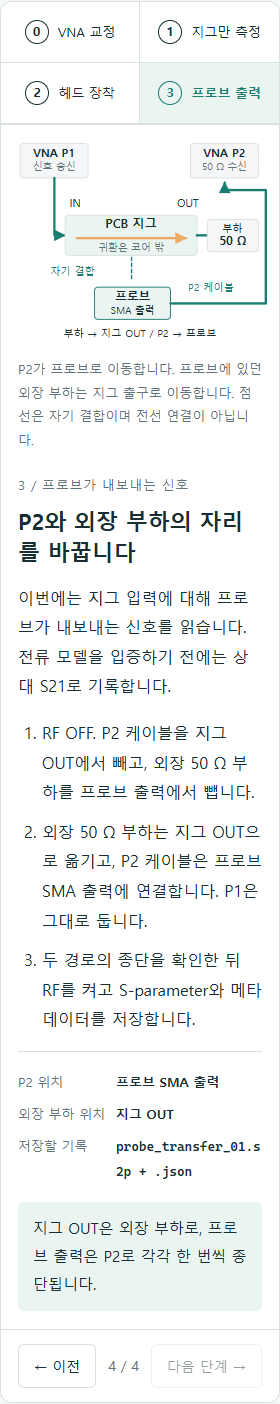
docs/atlas/review/calibration-320.png
