ckh7488/rf_current_probe/docs/atlas/review/calibration-390.png

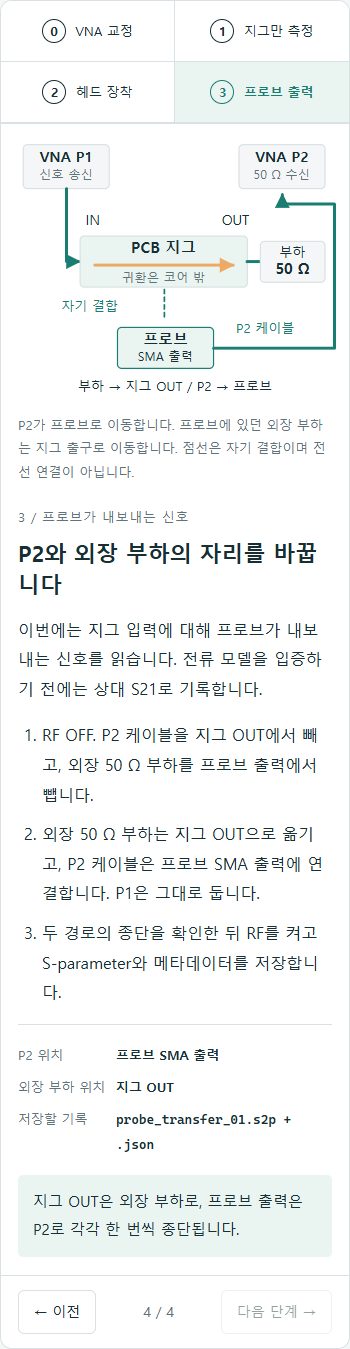
docs/atlas/review/calibration-390.png
