ckh7488/rf_current_probe/docs/atlas/review/flat-a02/calibration-320.png

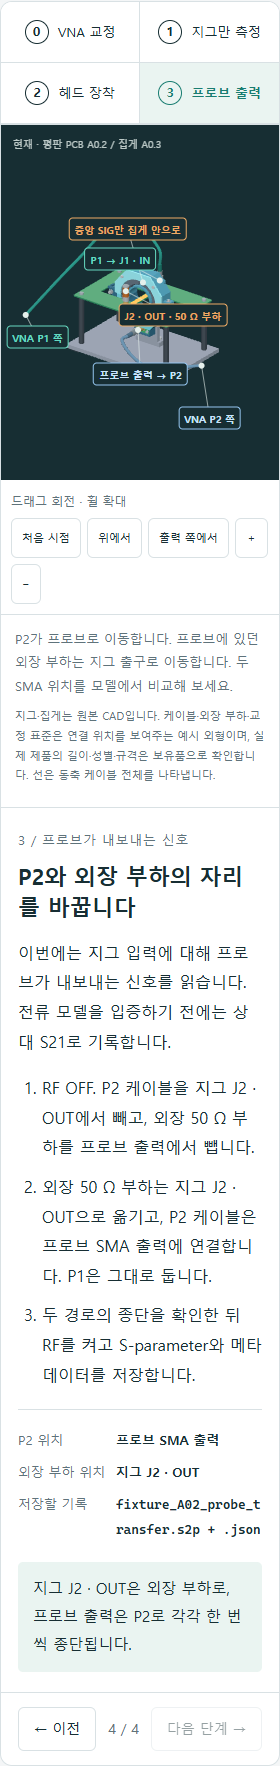
docs/atlas/review/flat-a02/calibration-320.png
