ckh7488/rf_current_probe/docs/atlas/review/flat-a02/calibration-390.png

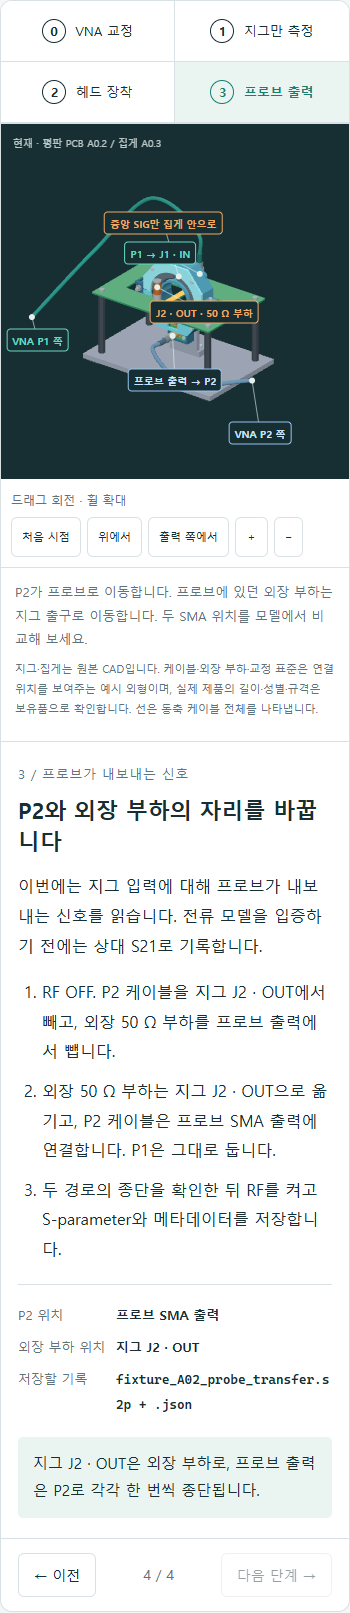
docs/atlas/review/flat-a02/calibration-390.png
