ckh7488/rf_current_probe/docs/atlas/review/split-a02/test-overflow.png

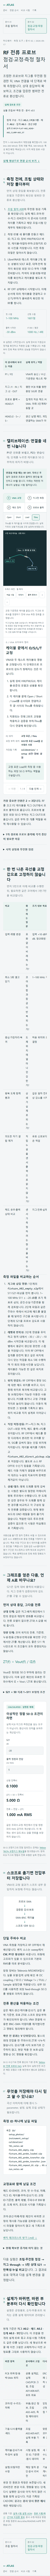
docs/atlas/review/split-a02/test-overflow.png
