ckh7488/rf_current_probe/hardware/calibration_fixture_PCB_A03_DRAFT/review/top.png

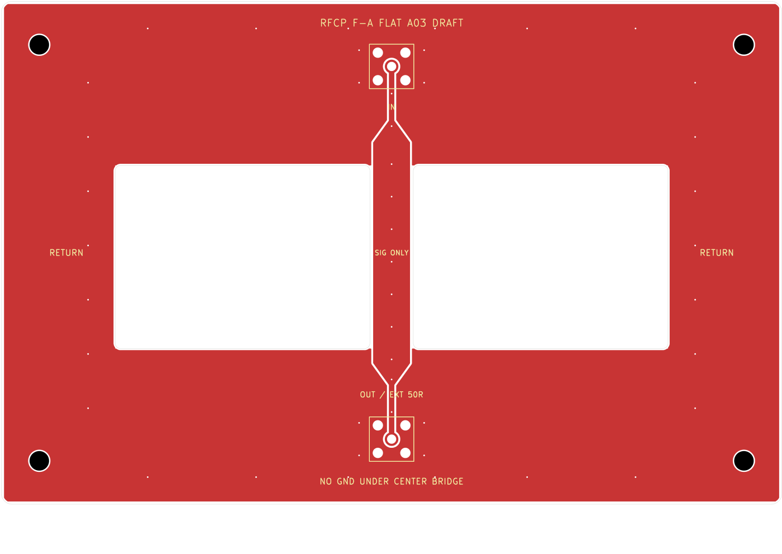
hardware/calibration_fixture_PCB_A03_DRAFT/review/top.png
