ckh7488/rf_current_probe/tests/results/end_to_end_20260916/vna_extraction/response.png

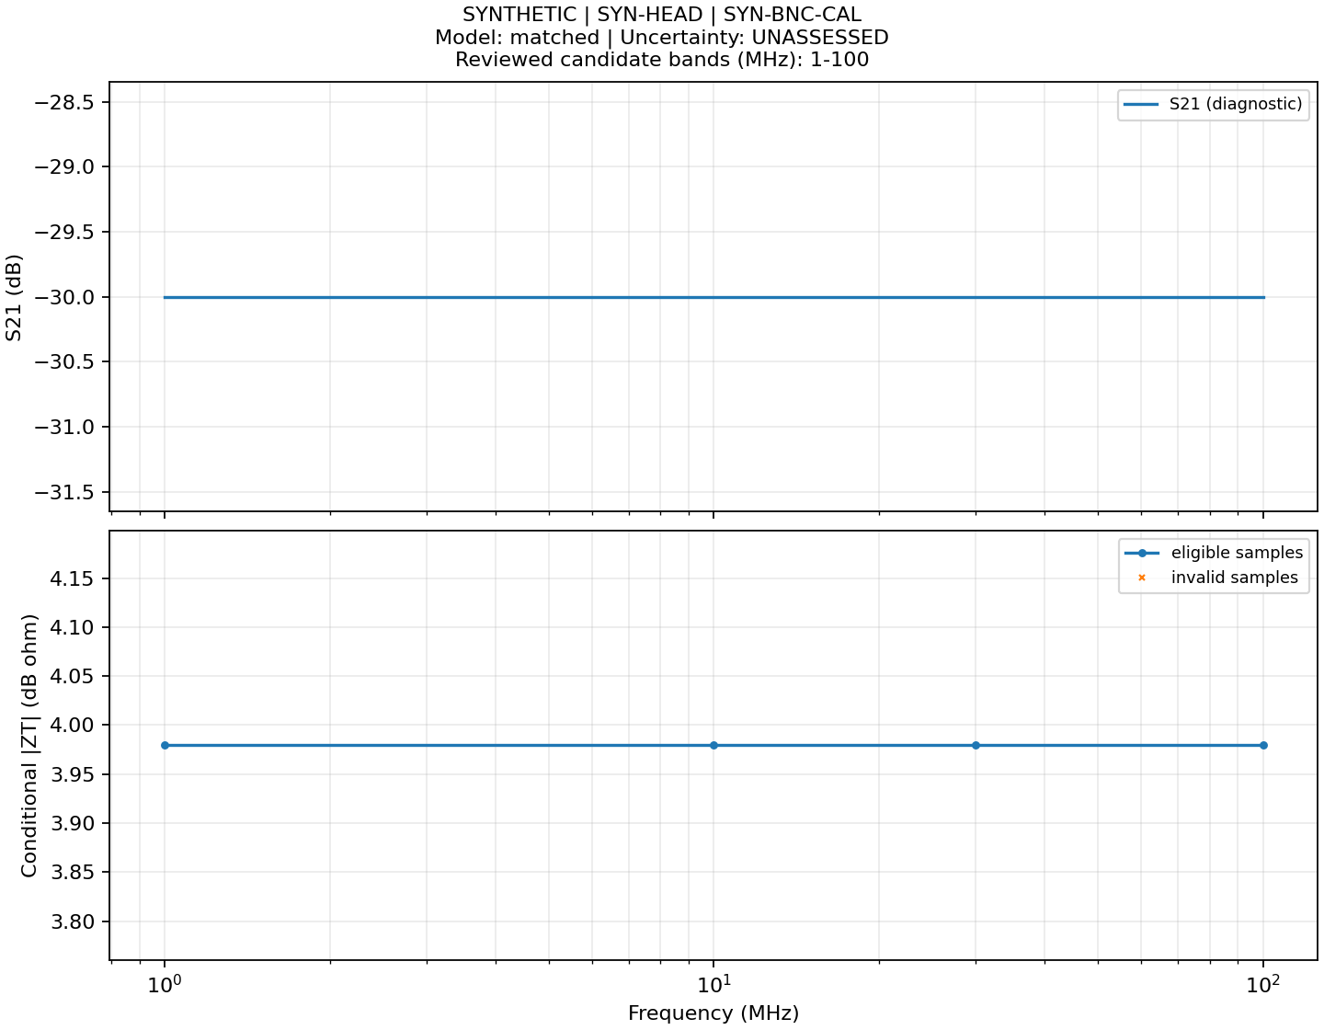
tests/results/end_to_end_20260916/vna_extraction/response.png
