ckh7488/rf_current_probe/tests/results/hi_model_demo/response.png

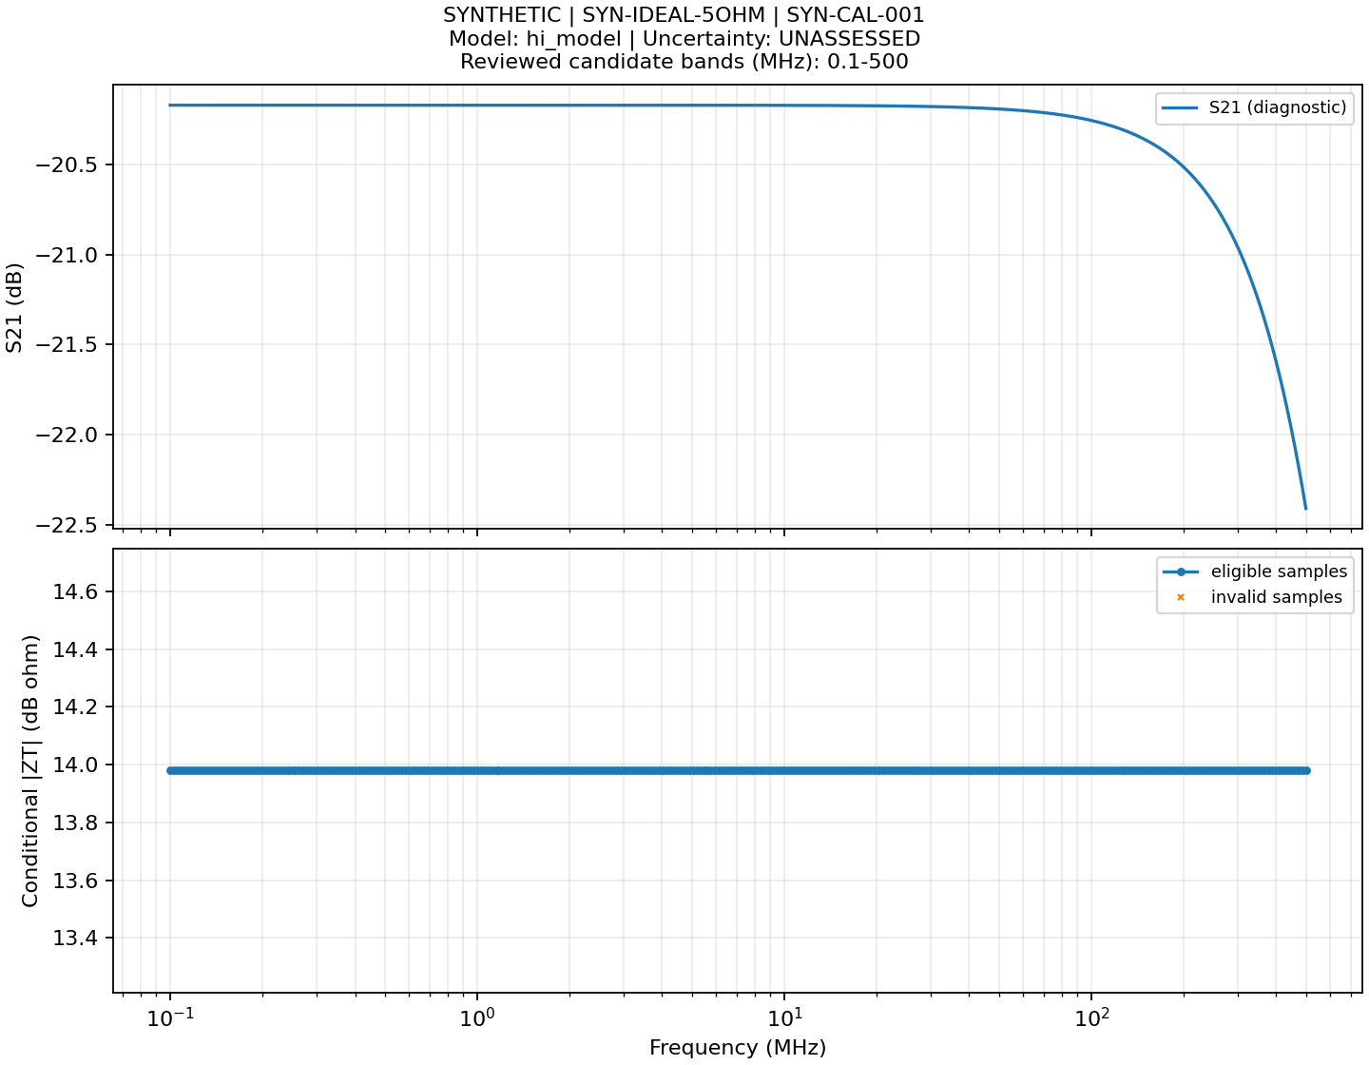
tests/results/hi_model_demo/response.png
