ckh7488/rf_current_probe/tests/results/relative_reviewed/response.png

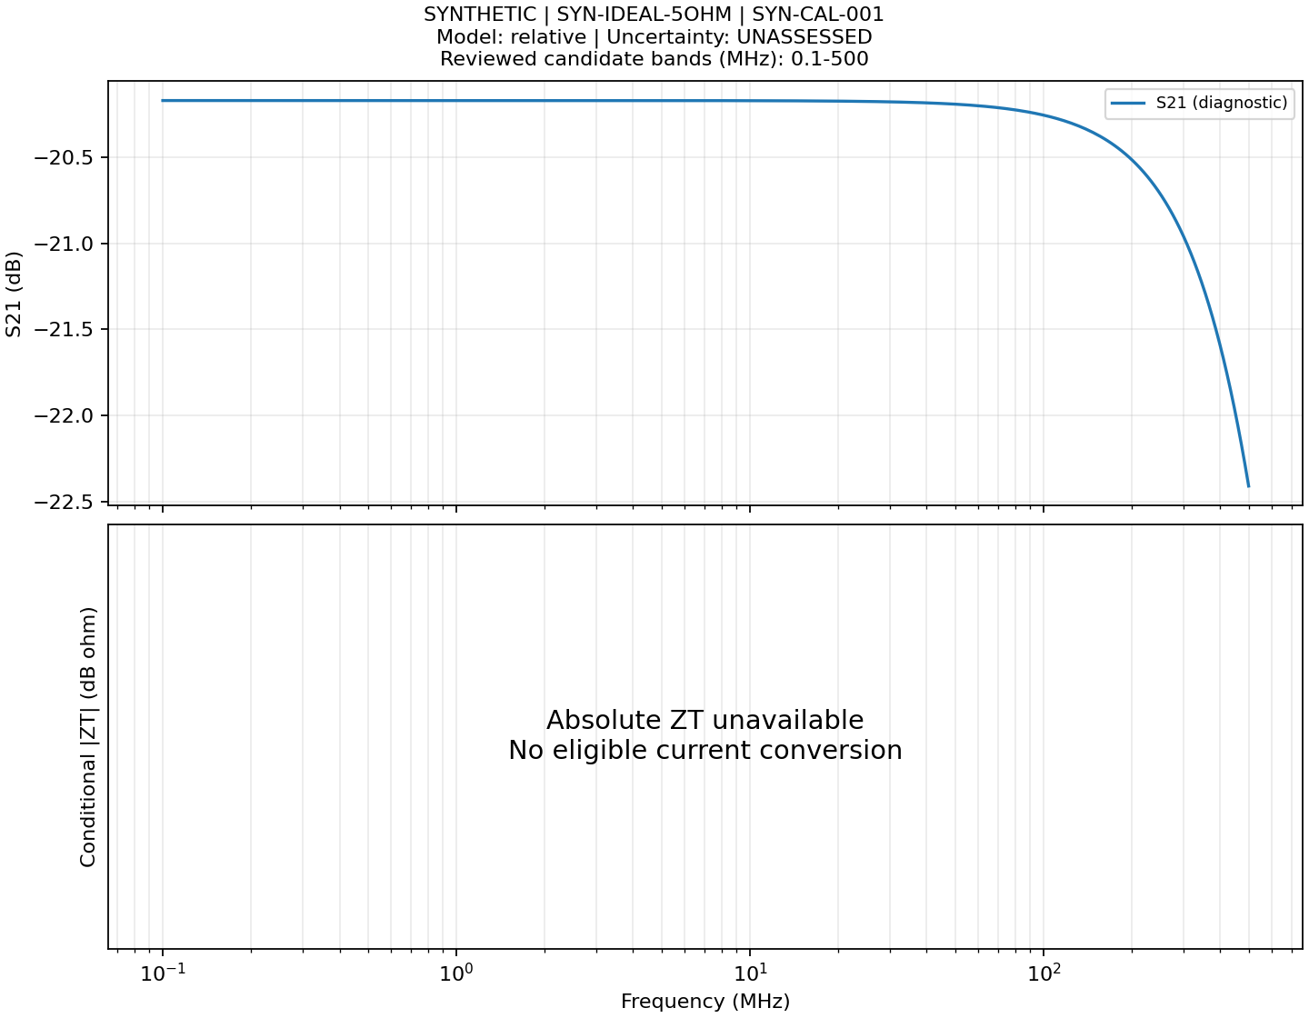
tests/results/relative_reviewed/response.png
