ckh7488/rf_current_probe/(list of files, drawings)

Other design files:
docs/atlas/review/a02-design/pcb-summary.json
viewer_A05/guide_sources/pcb_insertion_review.json
