ckh7488/rf_current_probe/hardware/calibration_fixture_PCB_A03_DRAFT/baseline/RFCP_Fixture_Flat_A02_DRAFT.kicad_pcb

## KiCad design hardware/calibration_fixture_PCB_A03_DRAFT/baseline/RFCP_Fixture_Flat_A02_DRAFT.kicad_pcb (2026-11-04)

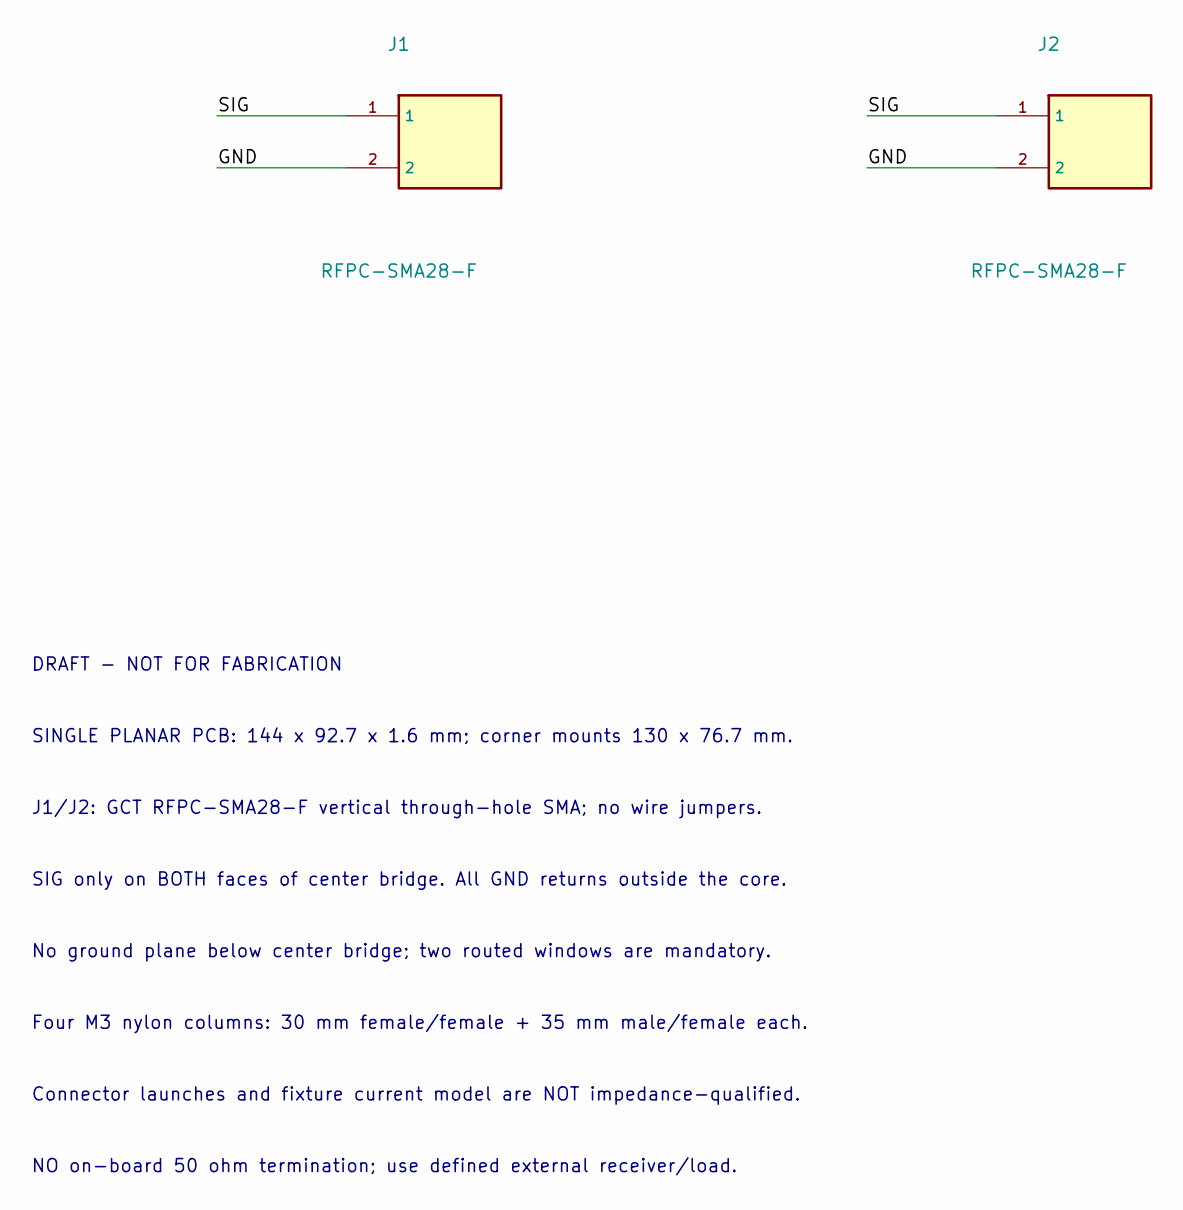
[picture p92: schematic RFCP_Fixture_Flat_A02_DRAFT.kicad_sch]

Parts:
J1, J2: RFPC-SMA28-F; GCT_RFPC_SMA28_F

Connections:
/GND: J1.2, J2.2
/SIG: J1.1, J2.1

Notes on the sheet:
DRAFT - NOT FOR FABRICATION
SINGLE PLANAR PCB: 144 x 92.7 x 1.6 mm; corner mounts 130 x 76.7 mm.
J1/J2: GCT RFPC-SMA28-F vertical through-hole SMA; no wire jumpers.
SIG only on BOTH faces of center bridge. All GND returns outside the core.
No ground plane below center bridge; two routed windows are mandatory.
Four M3 nylon columns: 30 mm female/female + 35 mm male/female each.
Connector launches and fixture current model are NOT impedance-qualified.
NO on-board 50 ohm termination; use defined external receiver/load.

Board: 2 copper layers, 6 parts (0 on the bottom side), 2 nets, no tracks yet.

Other parts of the board:
H1, H2, H3, H4: NYLON_M3
