ckh7488/rf_current_probe/reviews/jlc_renewal_preflight_20260929/candidate/te/m12_slipring.kicad_pcb

## KiCad design reviews/jlc_renewal_preflight_20260929/candidate/te/m12_slipring.kicad_pcb (2026-11-04)

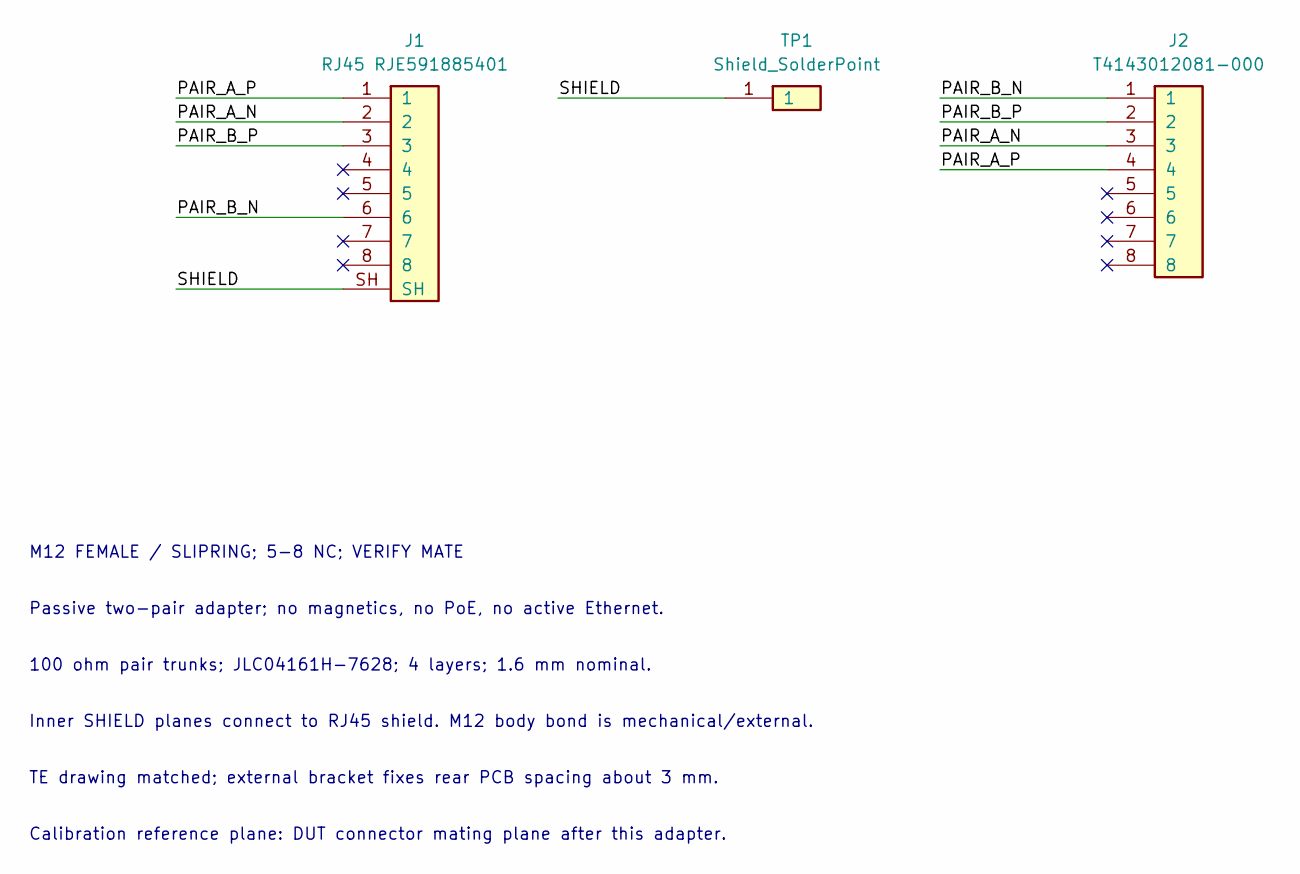
[picture p93: schematic m12_slipring.kicad_sch, m12_slipring / passive Ethernet adapter]

Parts:
J1: RJ45 RJE591885401; RJ45_Amphenol_RJE59-188-5401
J2: T4143012081-000; TE_T4143012081-000
TP1: Shield_SolderPoint

Connections:
/PAIR_A_N: J1.2, J2.3
/PAIR_A_P: J1.1, J2.4
/PAIR_B_N: J1.6, J2.1
/PAIR_B_P: J1.3, J2.2
/SHIELD: J1.SH, TP1.1

Notes on the sheet:
M12 FEMALE / SLIPRING; 5-8 NC; VERIFY MATE
Passive two-pair adapter; no magnetics, no PoE, no active Ethernet.
100 ohm pair trunks; JLC04161H-7628; 4 layers; 1.6 mm nominal.
Inner SHIELD planes connect to RJ45 shield. M12 body bond is mechanical/external.
TE drawing matched; external bracket fixes rear PCB spacing about 3 mm.
Calibration reference plane: DUT connector mating plane after this adapter.

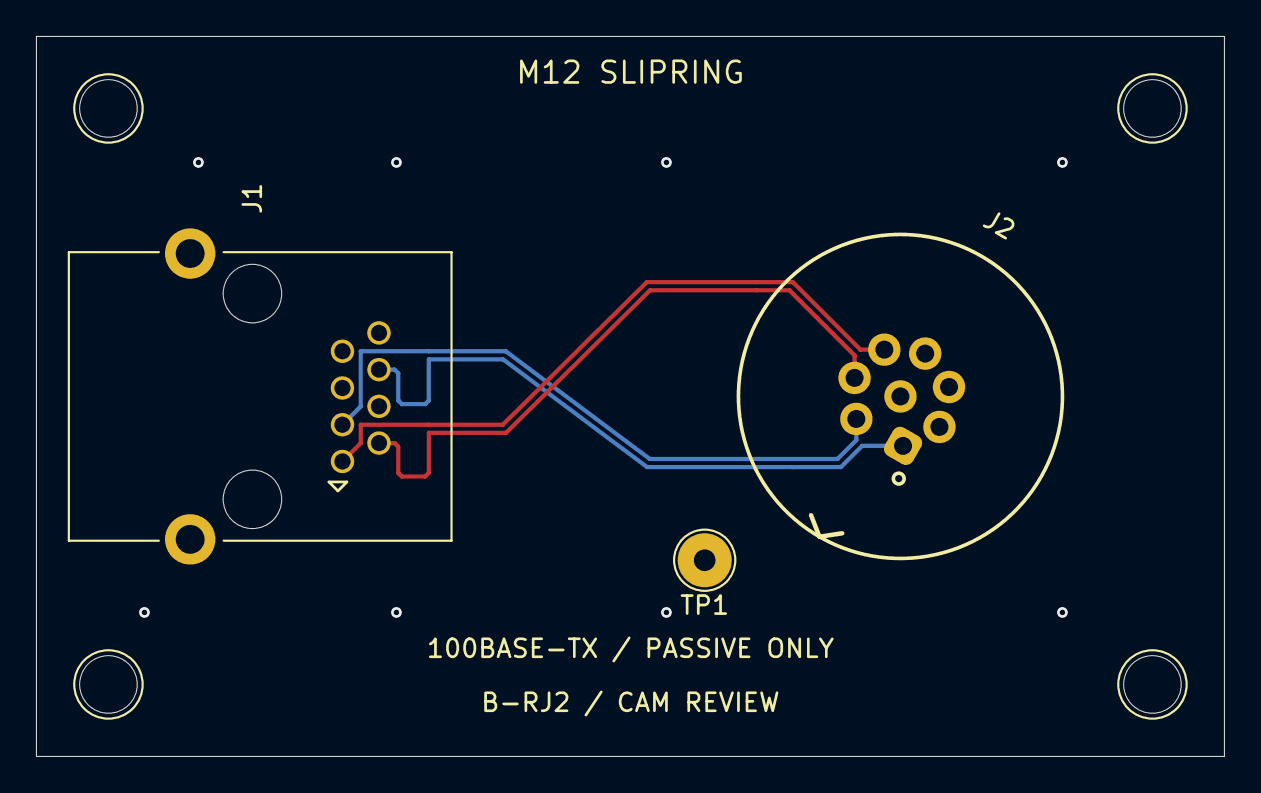
[picture p94: board m12_slipring.kicad_pcb from above]

Board: 4 copper layers, 66.0 x 40.0 mm, 7 parts (0 on the bottom side), 5 nets.

Other parts of the board:
H1, H2, H3, H4: (no value)
