ckh7488/rf_current_probe/reviews/jlc_renewal_preflight_20260929/candidate/molex/molex_slipring.kicad_pcb

## KiCad design reviews/jlc_renewal_preflight_20260929/candidate/molex/molex_slipring.kicad_pcb (2026-11-04)

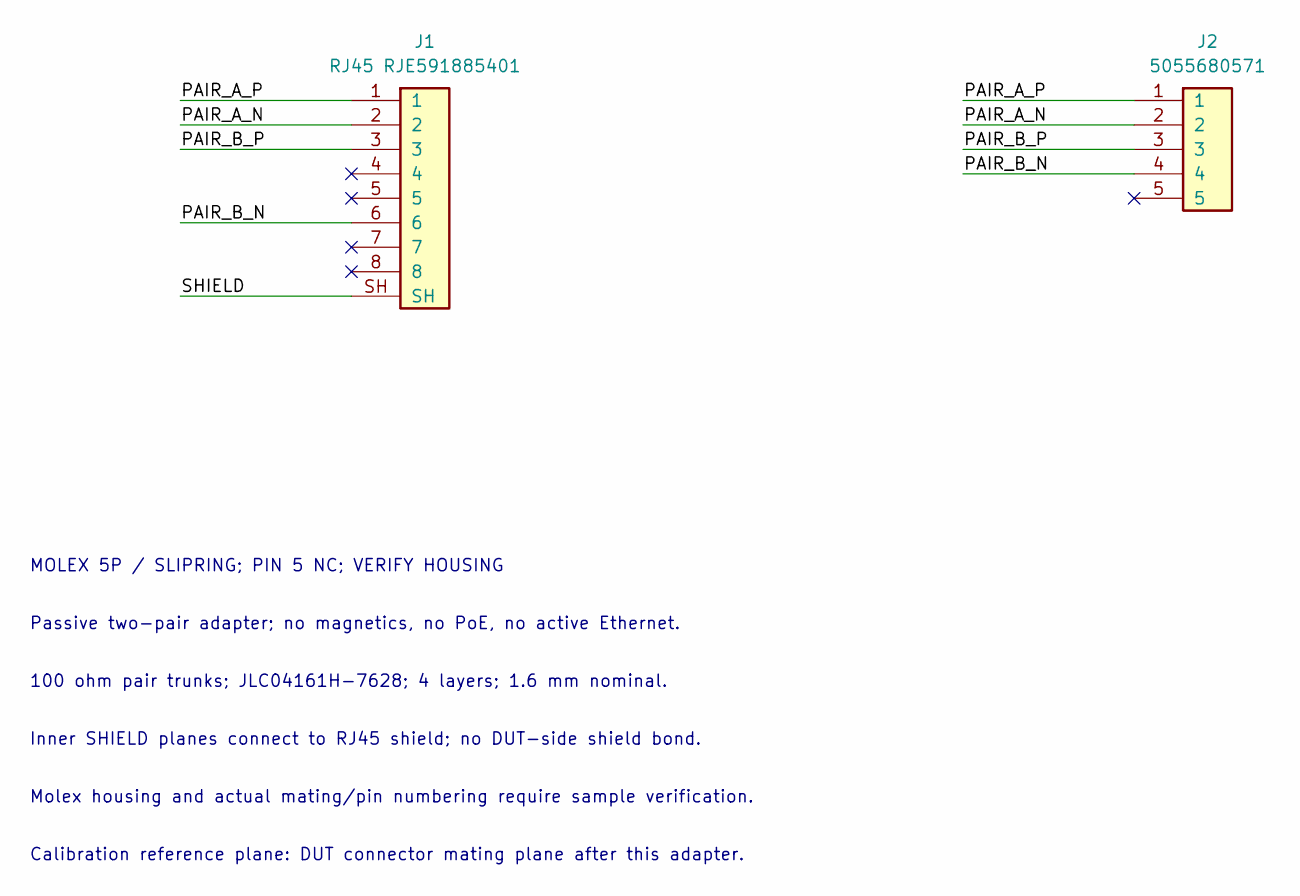
[picture p95: schematic molex_slipring.kicad_sch, molex_slipring / passive Ethernet adapter]

Parts:
J1: RJ45 RJE591885401; RJ45_Amphenol_RJE59-188-5401
J2: 5055680571; Molex_5055680571

Connections:
/PAIR_A_N: J1.2, J2.2
/PAIR_A_P: J1.1, J2.1
/PAIR_B_N: J1.6, J2.4
/PAIR_B_P: J1.3, J2.3
/SHIELD: J1.SH

Notes on the sheet:
MOLEX 5P / SLIPRING; PIN 5 NC; VERIFY HOUSING
Passive two-pair adapter; no magnetics, no PoE, no active Ethernet.
100 ohm pair trunks; JLC04161H-7628; 4 layers; 1.6 mm nominal.
Inner SHIELD planes connect to RJ45 shield; no DUT-side shield bond.
Molex housing and actual mating/pin numbering require sample verification.
Calibration reference plane: DUT connector mating plane after this adapter.

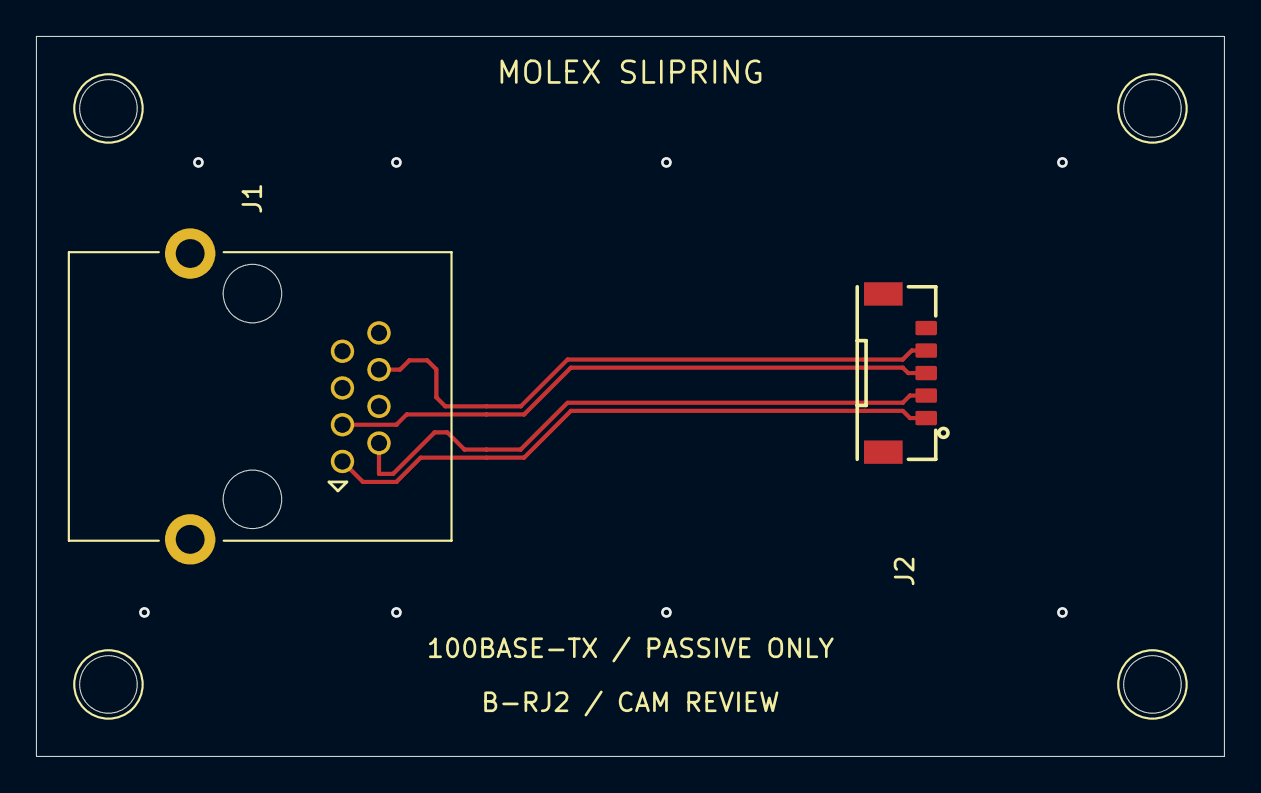
[picture p96: board molex_slipring.kicad_pcb from above]

Board: 4 copper layers, 66.0 x 40.0 mm, 6 parts (0 on the bottom side), 4 nets.

Other parts of the board:
H1, H2, H3, H4: (no value)
