ckh7488/rf_current_probe/reviews/jlc_renewal_preflight_20260929/candidate/common/balun_eth_rj45.kicad_pcb

## KiCad design reviews/jlc_renewal_preflight_20260929/candidate/common/balun_eth_rj45.kicad_pcb (2026-11-04)

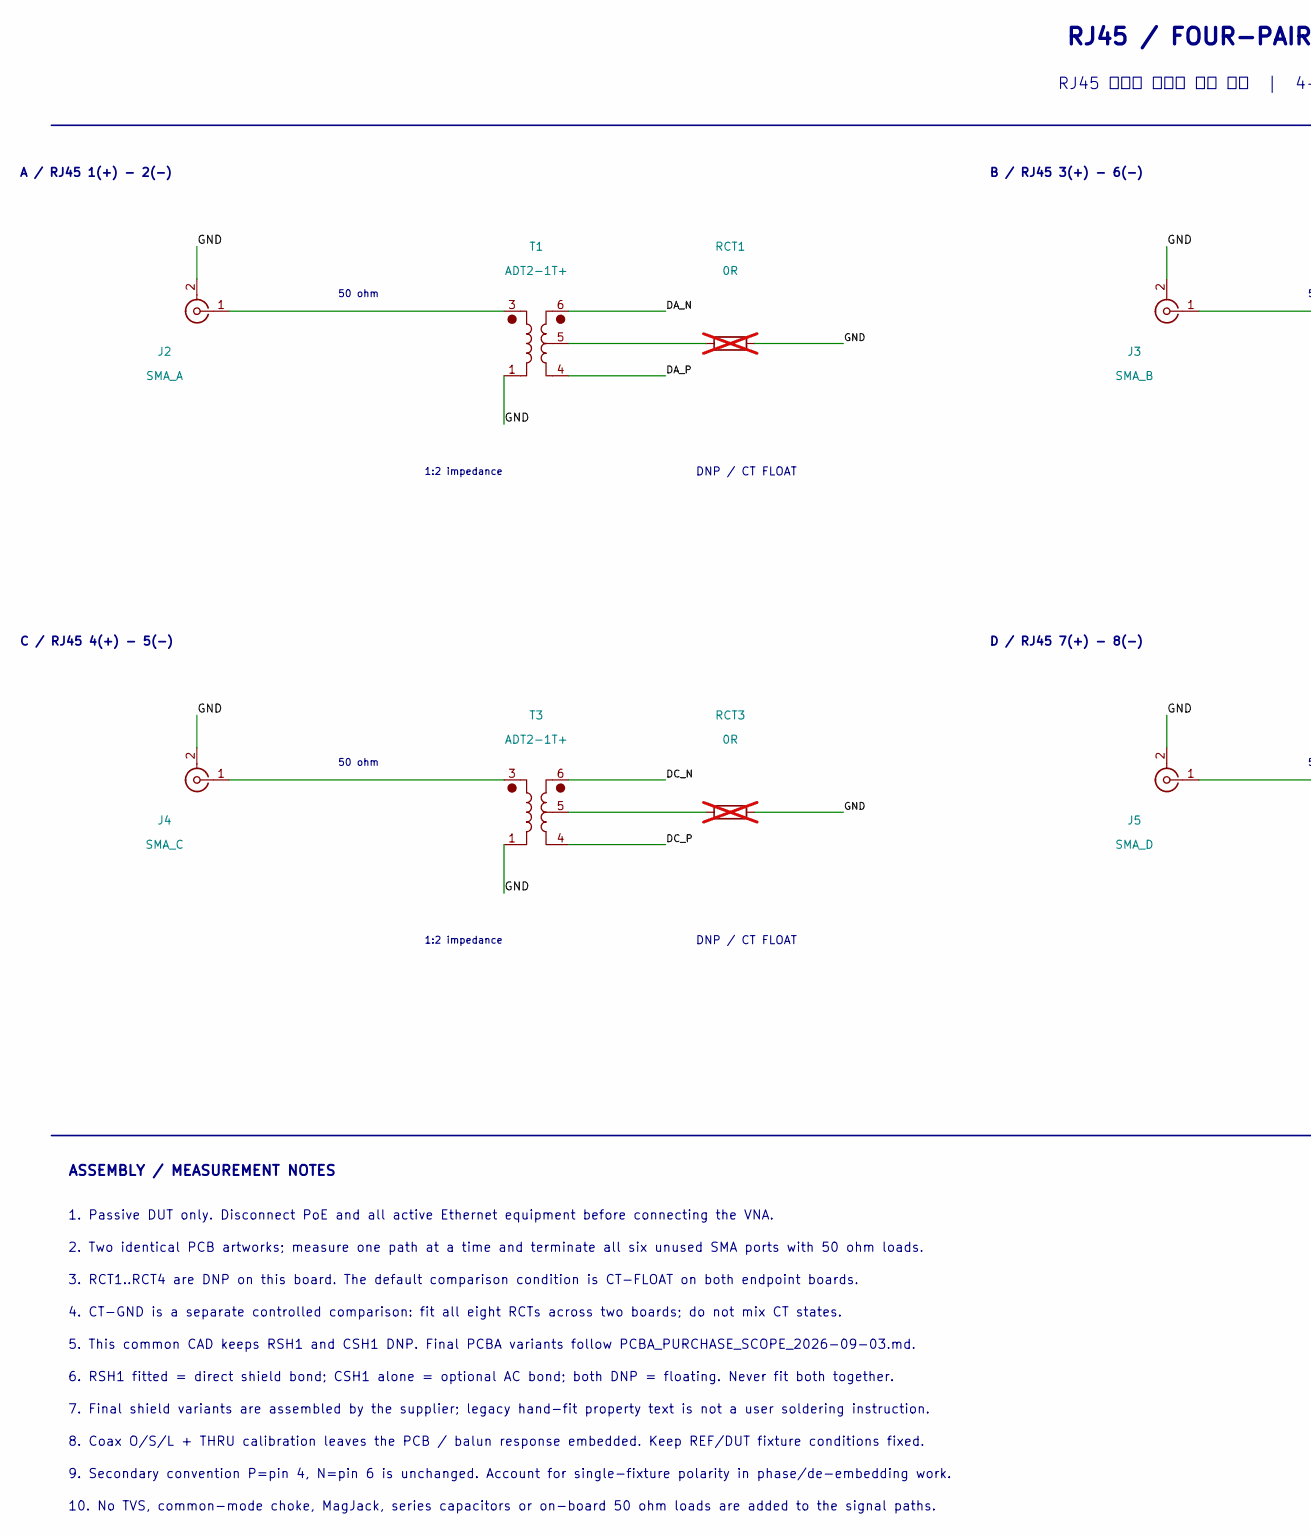
[picture p97: schematic balun_eth_rj45.kicad_sch, RJ45 / FOUR-PAIR VNA FIXTURE, part in row 1, column 1]

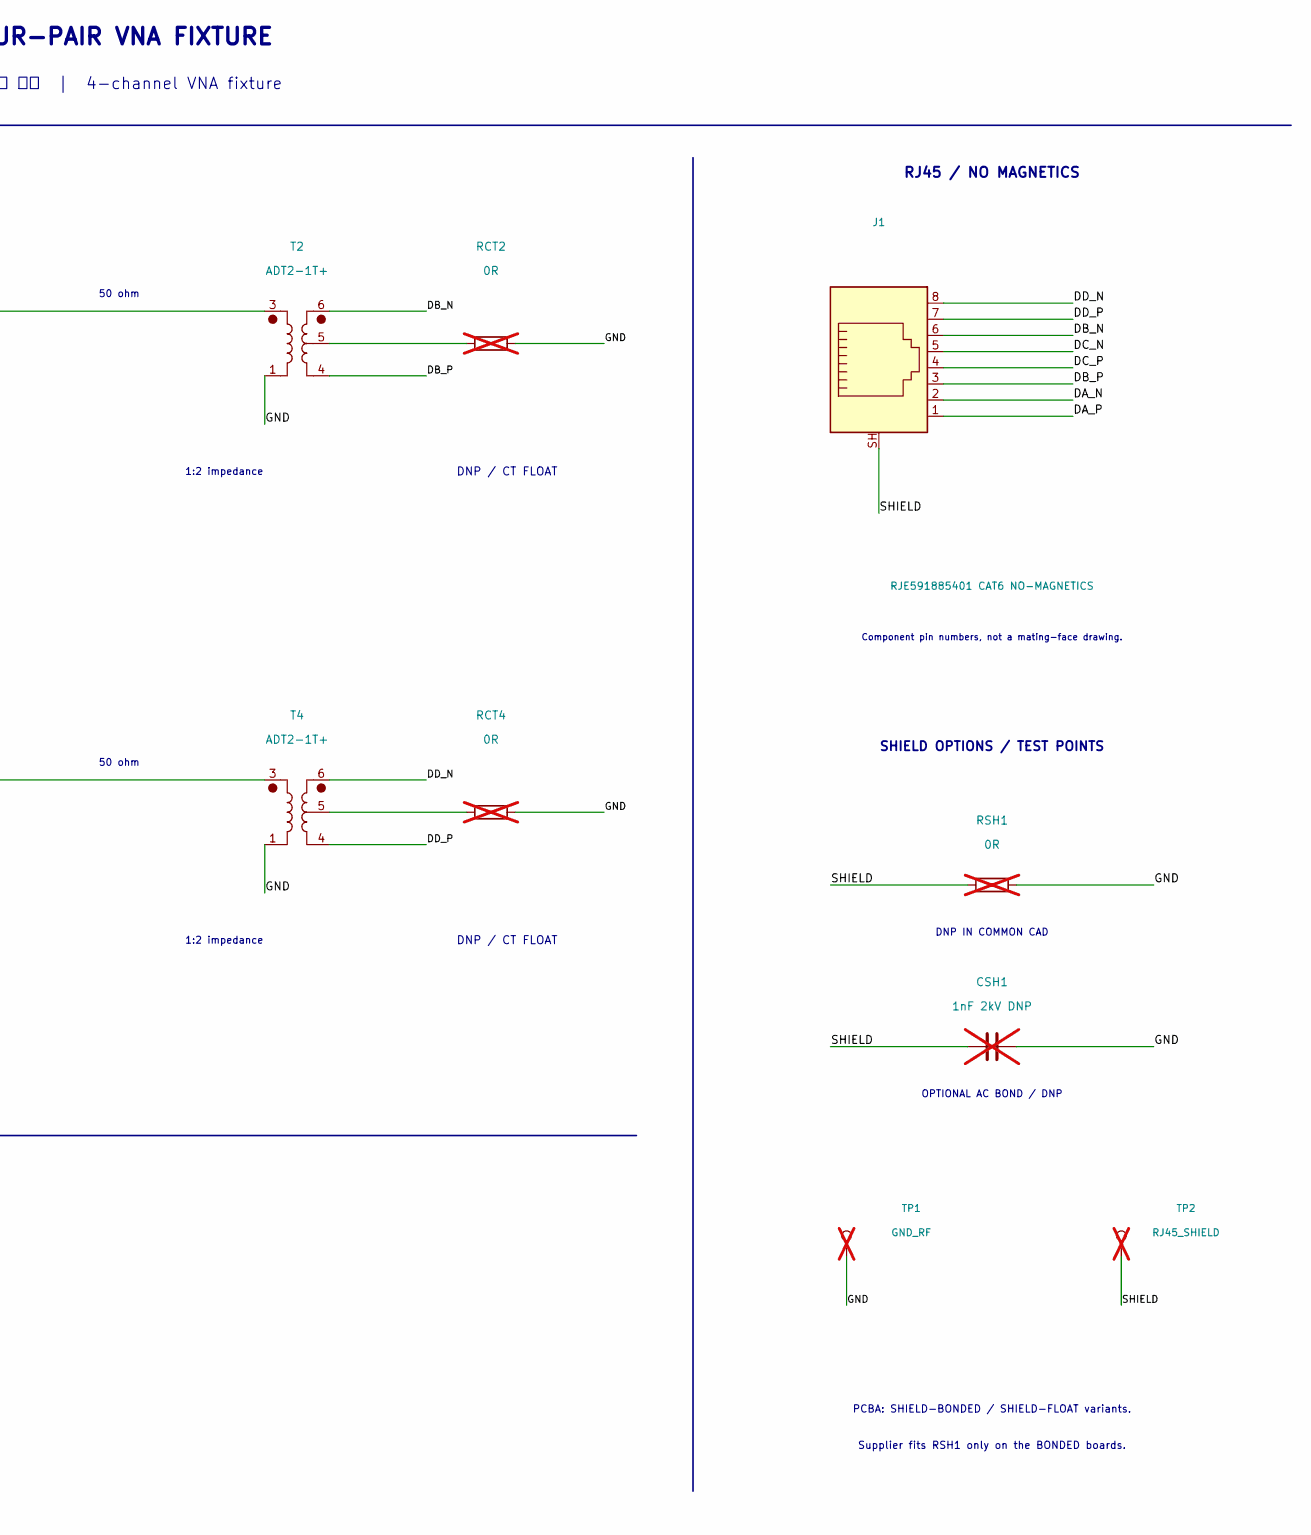
[picture p98: schematic balun_eth_rj45.kicad_sch, RJ45 / FOUR-PAIR VNA FIXTURE, part in row 1, column 2]

Parts:
CSH1: 1nF 2kV DNP; C_1206_3216Metric_Pad1.33x1.80mm_HandSolder; not fitted
J1: RJE591885401 CAT6 NO-MAGNETICS; RJ45_Amphenol_RJE59-188-5401; MPN RJE591885401; LCSC Part # C5386678
J2: SMA_A; SMA_Samtec_SMA-J-P-H-RA-TH1; MPN SMA-J-P-H-RA-TH1
J3: SMA_B; SMA_Samtec_SMA-J-P-H-RA-TH1; MPN SMA-J-P-H-RA-TH1
J4: SMA_C; SMA_Samtec_SMA-J-P-H-RA-TH1; MPN SMA-J-P-H-RA-TH1
J5: SMA_D; SMA_Samtec_SMA-J-P-H-RA-TH1; MPN SMA-J-P-H-RA-TH1
RCT1, RCT2, RCT3, RCT4: 0R; R_0805_2012Metric_Pad1.20x1.40mm_HandSolder; MPN 0805W8F0000T5E; LCSC Part # C17477; not fitted
RSH1: 0R; R_0805_2012Metric_Pad1.20x1.40mm_HandSolder; MPN 0805W8F0000T5E; LCSC Part # C17477; not fitted
T1, T2, T3, T4: ADT2-1T+; Mini-Circuits_CD542_H2.84mm; MPN ADT2-1T+; LCSC Part # C5223988
TP1: GND_RF; TestPoint_Loop_D2.50mm_Drill1.0mm; not fitted
TP2: RJ45_SHIELD; TestPoint_Loop_D2.50mm_Drill1.0mm; not fitted

Connections:
/DA_N: J1.2, T1.6
/DA_P: J1.1, T1.4
/DB_N: J1.6, T2.6
/DB_P: J1.3, T2.4
/DC_N: J1.5, T3.6
/DC_P: J1.4, T3.4
/DD_N: J1.8, T4.6
/DD_P: J1.7, T4.4
/GND: CSH1.1, J2.2 (Ext), J3.2 (Ext), J4.2 (Ext), J5.2 (Ext), RCT1.1, RCT2.1, RCT3.1, RCT4.1, RSH1.1, T1.1, T2.1, T3.1, T4.1, TP1.1
/SHIELD: CSH1.2, J1.SH, RSH1.2, TP2.1
unnamed: J2.1 (In), T1.3
unnamed: J3.1 (In), T2.3
unnamed: J4.1 (In), T3.3
unnamed: J5.1 (In), T4.3
unnamed: RCT1.2, T1.5
unnamed: RCT2.2, T2.5
unnamed: RCT3.2, T3.5
unnamed: RCT4.2, T4.5

Notes on the sheet:
RJ45 / FOUR-PAIR VNA FIXTURE
RJ45 이더넷 케이블 측정 지그 | 4-channel VNA fixture
A / RJ45 1(+) - 2(-)
50 ohm
DNP / CT FLOAT
1:2 impedance
B / RJ45 3(+) - 6(-)
C / RJ45 4(+) - 5(-)
D / RJ45 7(+) - 8(-)
RJ45 / NO MAGNETICS
Component pin numbers, not a mating-face drawing.
SHIELD OPTIONS / TEST POINTS
DNP IN COMMON CAD
OPTIONAL AC BOND / DNP
PCBA: SHIELD-BONDED / SHIELD-FLOAT variants.
Supplier fits RSH1 only on the BONDED boards.
ASSEMBLY / MEASUREMENT NOTES
1. Passive DUT only. Disconnect PoE and all active Ethernet equipment before connecting the VNA.
2. Two identical PCB artworks; measure one path at a time and terminate all six unused SMA ports with 50 ohm loads.
3. RCT1..RCT4 are DNP on this board. The default comparison condition is CT-FLOAT on both endpoint boards.
4. CT-GND is a separate controlled comparison: fit all eight RCTs across two boards; do not mix CT states.
5. This common CAD keeps RSH1 and CSH1 DNP. Final PCBA variants follow PCBA_PURCHASE_SCOPE_2026-09-03.md.
6. RSH1 fitted = direct shield bond; CSH1 alone = optional AC bond; both DNP = floating. Never fit both together.
7. Final shield variants are assembled by the supplier; legacy hand-fit property text is not a user soldering instruction.
8. Coax O/S/L + THRU calibration leaves the PCB / balun response embedded. Keep REF/DUT fixture conditions fixed.
9. Secondary convention P=pin 4, N=pin 6 is unchanged. Account for single-fixture polarity in phase/de-embedding work.
10. No TVS, common-mode choke, MagJack, series capacitors or on-board 50 ohm loads are added to the signal paths.

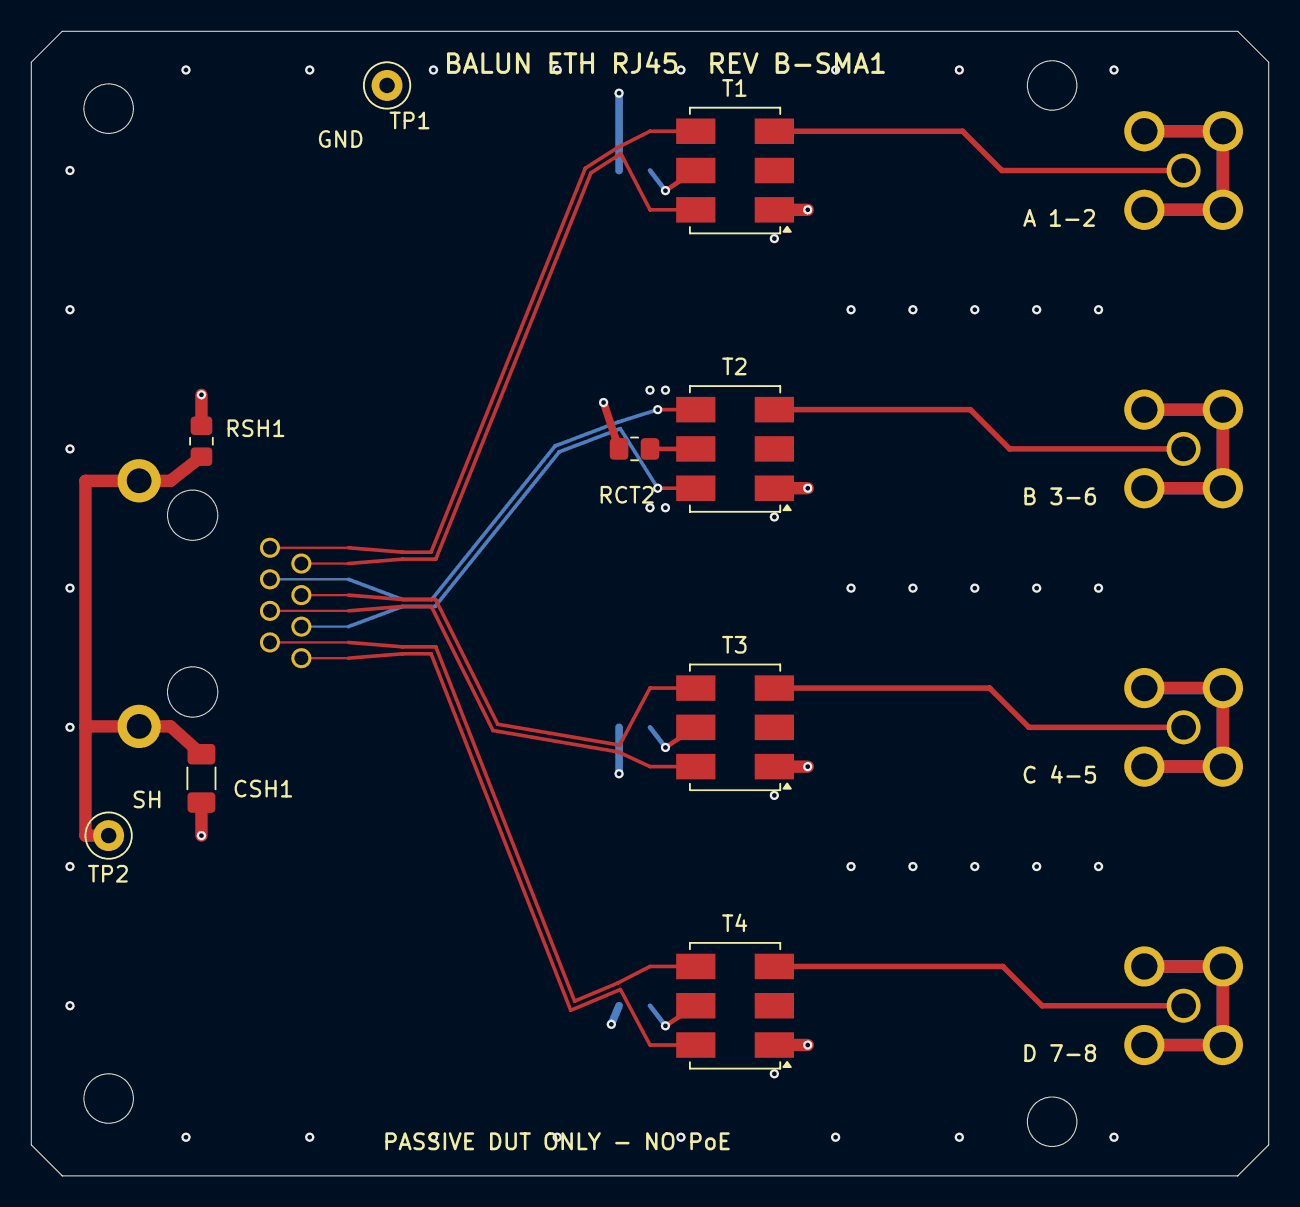
[picture p99: board balun_eth_rj45.kicad_pcb from above]

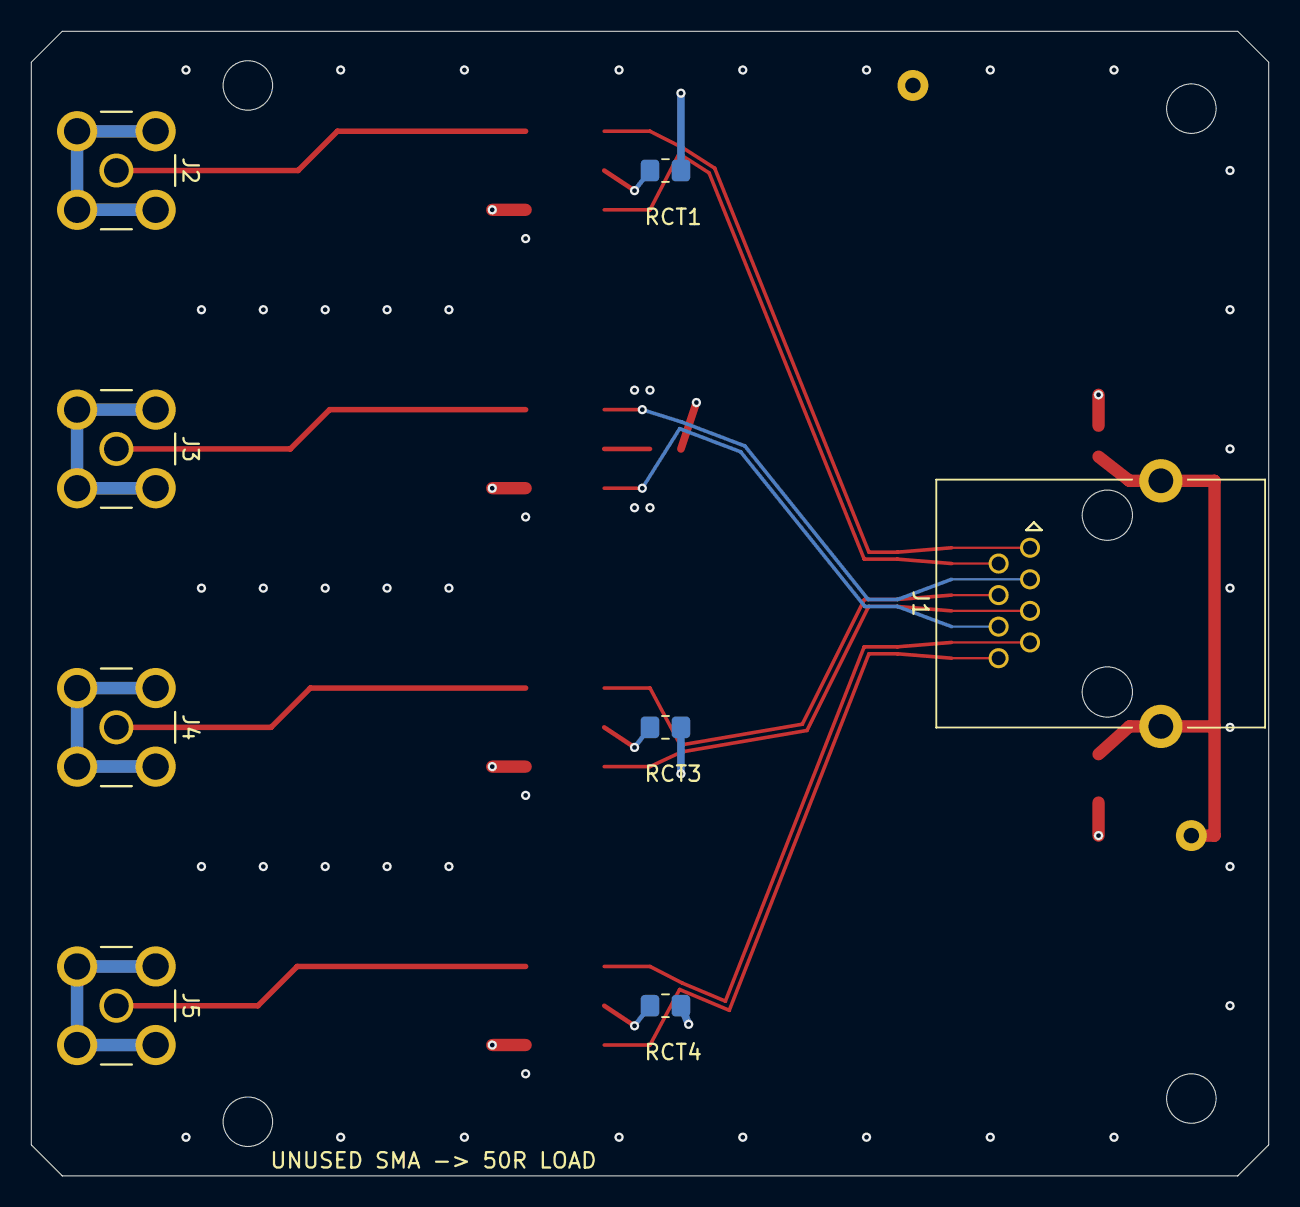
[picture p100: board balun_eth_rj45.kicad_pcb from below]

Board: 4 copper layers, 80.0 x 74.0 mm, 21 parts (8 on the bottom side), 18 nets.

Other parts of the board:
H1, H2, H3, H4: M3; MountingHole_3.2mm_M3
