ckh7488/rf_current_probe/viewer_A05/guide_steps_a13_history.py

"""Human assembly sequence for the frozen A13/C07 geometry. No product edits."""
from math import cos,sin,pi

def make_steps(mesh):
 steps=[]
 lower=['LowerBody','FixedCore','Winding','PCB','SMAEnvelope','PCBNuts','PCBScrews','LowerKeeper','LowerKeeperNuts','LowerKeeperScrews']
 upper=['UpperLid','MovingCore','UpperKeeper','UpperKeeperNuts','UpperKeeperScrews']
 head=lower+upper+['HeadSquareNuts','HeadHandScrews']
 cl=lambda k,n:f'Cable{k}_{n}'
 cable=lambda k:[n for n in mesh if n.startswith(f'Cable{k}_')]
 cn=[f'CalibrationNut{i}' for i in range(1,5)]
 board=['FlatPCB','SignalCopper','ReturnCopper','SMAInput','SMAOutput']
 def path(names,vector,window=None):
  return {n:dict(vector=vector,window=window or [0,1]) for n in names}
 def add(id,group,title,rest,active,moves,action,hold,tool,check,note='',view=(.6,.35,1),proof='부품 위치 설명 · 손·공구 접근 미확인',**kw):
  steps.append(dict(id=id,group=group,title=title,rest=list(rest),active=list(active),moves=moves,action=action,hold=hold,tool=tool,check=check,note=note,view=list(view),proof=proof,**kw))
 add('H01','프로브','맨 PCB에서 SMA부터 납땜',['PCB'],['SMAEnvelope'],path(['SMAEnvelope'],[0,0,32]),
 ['작은 헤드 PCB를 몸체에 달기 전에 작업대에 놓습니다.','SMA 단자를 풋프린트에 맞춰 끼우고 중심핀·접지 다리를 납땜합니다.'],
 'PCB와 SMA를 납땜용 홀더로 잡습니다.','인두·납·PCB 홀더','몸체나 코어가 없는 상태에서 납땜부를 충분히 볼 수 있는지 확인합니다.',
 '슬라이더는 납땜 전 부품 배치입니다. 납땜된 SMA를 잡아당겨 빼는 절차가 아닙니다.',view=(.3,.25,1),proof='형상·배치만 표시 · 납땜 작업 미실행')
 add('H02','프로브','아래 코어에 권선을 감기',['FixedCore'],['Winding'],{},
 ['아래 코어를 몸체 밖에서 잡고 권선을 감습니다.','맞댐면을 가리지 않고, 끝선 두 가닥은 이후 PCB에 연결할 수 있게 남깁니다.'],
 '코어를 손으로 받칩니다. 맞댐면에는 힘을 주지 않습니다.','에나멜선·끝선 피복 제거 및 납땜 도구','권선의 위치와 끝선이 빠져나올 공간을 봅니다.',
 '권선 형상은 배치 예시입니다. 턴수 확정이나 감는 동작을 재현한 것이 아닙니다.',kind='inspect',proof='권선 배치 예시 · 턴수·RF 특성 미확정')
 add('H03','프로브','권선된 아래 코어를 받침에 넣기',['LowerBody'],['FixedCore','Winding'],path(['FixedCore','Winding'],[0,0,60]),
 ['아래 몸체의 앞쪽이 보이게 놓습니다.','권선된 코어를 앞에서 넣어 넓은 받침에 앉힙니다. 끝선은 앞으로 빼 둡니다.'],
 '한 손으로 아래 몸체, 다른 손으로 코어를 받칩니다.','손으로 삽입','권선이 플라스틱에 끼이거나 받침 위로 올라가지 않는지 봅니다.',
 '맨 코어 삽입 경로는 확인됐습니다. 실제 권선 두께와 유연한 끝선의 간섭은 확인 전입니다.',proof='CAD: 맨 코어 삽입 확인 · 권선/손 접근 미확인')
 add('H04','프로브','PCB용 작은 너트를 뒤에서 대기',lower[:3],['PCBNuts'],path(['PCBNuts'],[0,0,-28]),
 ['아래쪽 PCB 장착 구멍 두 곳의 뒷면을 봅니다.','M2 나일론 너트를 한 개씩 구멍에 맞춰 받칩니다. 다음 두 단계 동안 빠지지 않게 잡아야 합니다.'],
 '뒷면의 작은 너트를 손이나 맞는 소형 공구로 잡아야 합니다.','소형 스패너 등: 실제 너트와 접근 공간 확인 필요','이 작은 너트를 잡은 채 앞에서 PCB와 나사를 다룰 수 있는지가 검토 포인트입니다.',
 '여기는 쉬운 조립이 확인된 자리가 아닙니다. 자동으로 너트가 고정된다고 가정하지 않습니다.',view=(-.5,-.3,-1),anchors=[['잡을 너트',[-14.5,-60.5,-3]]])
 tilted={n:dict(pivot=[0,-36,5.55],keys=[[0,[0,0,0],0],[.25,[0,0,0],0],[.5,[0,0,0],-30],[.65,[0,-1.6,0],-30],[1,[0,-1.6,40],-30]]) for n in ['PCB','SMAEnvelope']}
 add('H05','프로브','PCB를 기울여 넣고 M2 나사 체결',lower[:3]+['PCBNuts'],['PCB','SMAEnvelope','PCBScrews'],
 {**path(['PCBScrews'],[0,0,90],[0,.2]),**tilted},
 ['PCB를 약30° 기울여 아랫변이 앞으로 나오게 잡고、윗변을 앞에서 받침 안으로 넣습니다.','윗변을 조금 올려 위 걸림 아래에 맞춘 뒤 아랫변을 안으로 밀어 기판을 세웁니다.','뒤의 너트를 받치면서 M2 나사를 한 개씩 걸고 두 곳을 고르게 조입니다.'],
 '뒤쪽 M2 너트를 잡고 앞쪽 나사를 돌립니다.','구매한 M2 나사 머리에 맞는 드라이버 + 소형 너트 공구','앞에서 곧장 넣는 경로는 위쪽 걸림에 막힙니다. 기판을 기울이고 뒤 너트를 동시에 잡는 작업이 편한지 보세요.',
 '표시 경로는30° 기울임과1.6 mm 상하 여유를 사용한 공칭 CAD 예시입니다.31개 자세에서 겹침이 없었지만, 실제 손조립·권선 간섭·출력 공차는 미확인입니다.',anchors=[['앞에서 돌림',[-14.5,-60.5,8]],['뒤에서 잡음',[-14.5,-60.5,-3]]])
 add('H06','프로브','끝선 두 가닥을 S+ / S−에 연결',lower[:7],['Winding'],{},
 ['코어 고정바를 달기 전에 S+ / S− 위치를 확인합니다.','끝선을 짧고 무리 없이 배치해 납땜하고, 단락과 납땜 상태를 검사합니다.'],
 'PCB와 코어는 몸체에 놓인 상태입니다. 끝선은 납땜용 도구로 잡습니다.','인두·테스터','고정바가 없는 지금 패드에 인두가 들어가는지 확인합니다.',
 '주황 권선은 경로 예시이며 실제 끝선은 유연합니다. 이 단계는 이동 대신 강조로 표시합니다.',kind='inspect',proof='배선 작업 설명 · 실제 배선/납땜 미검증')
 add('H07','프로브','아래 코어 고정바를 앞에서 올리기',lower[:7],['LowerKeeper'],path(['LowerKeeper'],[0,0,60]),
 ['권선 끝선과 납땜을 검사한 뒤 고정바를 앞에서 가져옵니다.','권선 구역을 피한 양옆 면에 고정바를 맞춥니다.'],
 '고정바를 한 손으로 받칩니다.','손으로 배치','고정바가 선이나 납땜부를 누르지 않고 나사 구멍과 맞는지 봅니다.',proof='CAD: 고정바 직선 경로 확인 · 실제 조임 미확인')
 add('H08','프로브','아래 고정바를 나일론 나사로 고정',lower[:8],['LowerKeeperNuts','LowerKeeperScrews'],
 {**path(['LowerKeeperScrews'],[0,0,50],[0,.55]),**path(['LowerKeeperNuts'],[0,0,-30],[.6,1])},
 ['뒤에 M3 나일론 너트 한 개를 대고, 앞에서 나사를 통과시켜 몇 바퀴 겁니다.','반대쪽도 걸고 고정바가 코어에 고르게 닿도록 조입니다.'],
 '뒤쪽 너트를 잡고 앞의 나사를 돌립니다.','나사 머리에 맞는 드라이버 + 5.5 mm 스패너 후보','뒤쪽 스패너와 손 공간은 미확인입니다. 앞쪽만 편하다고 끝난 조립이 아닙니다.',
 '표시 공구는 지름8 mm 직선 드라이버 외형입니다. 뒤쪽 스패너의 진입·회전은 검증하지 않았습니다.',proof='CAD: 앞 드라이버 Ø8 접근 확인 · 뒤 너트 공구 미확인',toolModel='lowerDriver',anchors=[['앞 나사',[-37,-23,24]],['뒤 너트',[-37,-23,-7]]])
 free=['UpperLidFree'];upshift={n:[0,-1.8,0] for n in upper if n!='UpperLid'}
 add('H09','프로브','뚜껑을 따로 놓고 위 코어 끼우기',free,['MovingCore'],path(['MovingCore'],[0,0,60]),
 ['뚜껑을 아래 몸체와 분리한 상태로 작업합니다.','위 코어를 앞에서 넣고 일체형 받침에 앉힙니다.'],
 '뚜껑과 위 코어를 받칩니다.','손으로 삽입','코어 맞댐면과 받침의 접촉을 확인합니다.',
 '여기서는 출력할 때의 자유 형상 뚜껑을 표시합니다.',baseOffsets=upshift,proof='CAD: 맨 코어 삽입 확인 · 실물 공차 미확인')
 add('H10','프로브','위 코어 고정바를 배치',free+['MovingCore'],['UpperKeeper'],path(['UpperKeeper'],[0,0,60]),
 ['위 코어를 받친 상태에서 고정바를 앞에서 맞춥니다.','양쪽 나사 구멍을 맞추고, 코어의 맞댐면을 가리지 않는지 확인합니다.'],
 '코어가 떨어지지 않게 뚜껑과 고정바를 받칩니다.','손으로 배치','고정바를 놓는 동안 코어를 동시에 잡을 수 있는지 봅니다.',baseOffsets=upshift,proof='CAD: 고정바 경로 확인 · 실제 손조립 미확인')
 add('H11','프로브','위 고정바의 나사와 너트 체결',free+['MovingCore','UpperKeeper'],['UpperKeeperNuts','UpperKeeperScrews'],
 {**path(['UpperKeeperScrews'],[0,0,50],[0,.55]),**path(['UpperKeeperNuts'],[0,0,-30],[.6,1])},
 ['뒤 너트를 받치고 앞 나사를 한 개씩 걸어 줍니다.','양쪽을 고르게 조인 뒤, 뚜껑을 들었을 때 코어가 움직이지 않는지 확인합니다.'],
 '뒤 너트를 잡고 앞 나사를 돌립니다.','드라이버 + 5.5 mm 스패너 후보','뚜껑을 따로 들고 작업해도 뒤 너트를 잡기 편한지 확인합니다.',
 '코어에 무리한 조임을 가하지 않습니다. 체결 토크와 실제 고정력은 미확정입니다.',baseOffsets=upshift,toolModel='upperDriver',proof='CAD: 앞 드라이버 Ø8 접근 확인 · 뒤 너트 공구 미확인',anchors=[['뒤 너트',[-37,21.2,-7]]])
 add('H12','프로브','양끝 개폐용 사각너트 넣기',lower,['HeadSquareNuts'],path(['HeadSquareNuts'],[0,0,28]),
 ['양끝 기둥의 앞쪽 열린 홈으로 M4 사각너트를 넣습니다.','너트 구멍이 위쪽 손나사 구멍과 맞는지 봅니다.'],
 '너트는 홈의 받침에 놓습니다. 완전히 풀면 빠질 수 있습니다.','손으로 삽입; 홈이 회전을 제한','너트가 삽입되는 것과 손가락으로 쉽게 넣는 것은 별개입니다. 입구 깊이를 보세요.',proof='CAD: 너트 삽입 경로 확인 · 손 접근 미확인',anchors=[['앞쪽 입구',[-111,-9,15]]])
 add('H13','프로브','위 코어가 달린 뚜껑을 내려놓기',lower+['HeadSquareNuts'],upper,{},
 ['아래 코어와 위 코어의 맞댐면이 깨끗한지 확인합니다.','왼쪽 바깥 기둥을 ㄱ자 기준에 가볍게 맞대고 뚜껑을 내립니다.'],
 '양쪽 기둥을 잡아 뚜껑을 수평으로 내립니다.','손으로 배치','코어끼리 먼저 닿은 뒤 탄성부가 움직이는 구조를 확인합니다.',
 '탄성부의 움직임은 형상 설명입니다. 실제 눌림 힘을 계산하는 화면이 아닙니다.',kind='headLift',proof='CAD: 개폐 경로 확인 · 접촉압/반복성 미검증')
 add('H14','프로브','양끝 손나사를 조여 프로브 완성',lower+upper+['HeadSquareNuts'],['HeadHandScrews'],path(['HeadHandScrews'],[0,65,0]),
 ['위에서 M4 손나사 두 개를 너트에 걸어 줍니다.','좌우를 번갈아 조여 바깥 멈춤 기둥이 앉도록 합니다. 억지로 더 조이지 않습니다.'],
 '노출된 큰 손잡이를 잡고 돌립니다. 너트가 함께 돌거나 맞지 않으면 멈춥니다.','손잡이 두 개','손잡이 주변과 너트 정렬 상태를 확인합니다.',proof='CAD: 손잡이 Ø32 주변 공간·나사 인출 확인 · 실제 조임 미확인',view=(.7,.55,1))
 # One C07 module, repeated once for the second clamp.
 f=cl(1,'Frame');j=[cl(1,'Jaw1'),cl(1,'Jaw2')];fn=[cl(1,'FollowerNut1'),cl(1,'FollowerNut2')];y=cl(1,'DriveYoke');bn=[cl(1,'BridgeNut1'),cl(1,'BridgeNut2')];fol=[cl(1,'Follower1'),cl(1,'Follower2')];dn=cl(1,'DriveNut');lead=cl(1,'LeadScrewKnob');lock=cl(1,'LeadLockNut');washer=cl(1,'ThrustWasher');bridge=cl(1,'TopBridgeJaw');bs=[cl(1,'BridgeScrew1'),cl(1,'BridgeScrew2')]
 add('C01','케이블 클램프','아래 턱 두 개의 뒤에 사각너트 넣기',j,fn,path(fn,[0,0,-30]),
 ['아래 턱은 프레임에 넣기 전에 작업합니다.','각 턱 뒤의 사각 홈에 M4 너트를 하나씩 넣습니다.'],
 '턱과 너트를 손으로 받칩니다.','손으로 배치','너트를 놓은 뒤 턱을 가이드에 넣을 때 빠지지 않게 잡을 수 있는지 봅니다.',view=(-.4,-.25,-1))
 moves={}
 for i,a in enumerate([210,330]):moves.update(path([j[i],fn[i]],[50*cos(a*pi/180),50*sin(a*pi/180),0]))
 add('C02','케이블 클램프','턱을 대각선 가이드 끝에서 넣기',[f],j+fn,moves,
 ['너트가 들어간 턱을 각각 사선 가이드의 열린 바깥 끝에 맞춥니다.','중심 쪽으로 밀어 넣습니다.'],
 '프레임을 받치고 턱의 너트가 떨어지지 않도록 함께 잡습니다.','손으로 삽입','턱 뒤 너트를 받친 상태로 가이드에 넣는 조작이 쉬운지 봅니다.',proof='CAD: 턱 삽입 경로 확인 · 마찰/손 접근 미확인')
 add('C03','케이블 클램프','연결틀을 앞에서 끼우기',[f]+j+fn,[y],path([y],[0,0,60]),
 ['상부 가로대·팔로워 나사·큰 노브축을 달지 않은 상태입니다.','연결틀을 앞에서 수직 가이드 사이로 끼웁니다. 가로대용 너트는 C08에서 넣습니다.'],
 '프레임을 받치고 연결틀을 평행하게 넣습니다.','손으로 삽입','가이드와 너트가 보이는 상태로 들어가는지 봅니다.',proof='CAD: 연결틀 앞 삽입 경로 확인 · 실물 맞물림 미검증')
 basic=[f]+j+fn+[y]
 add('C04','케이블 클램프','아래 턱과 경사 홈을 팔로워로 연결',basic,fol,path(fol,[0,0,50]),
 ['각 경사 홈과 턱의 구멍을 맞춥니다.','앞에서 팔로워 어깨나사를 통과시켜 턱 뒤의 사각너트에 체결합니다.'],
 '턱 위치를 맞추고 앞쪽 나사를 돌립니다. 사각 홈이 뒤 너트의 회전을 제한합니다.','최종 팔로워 머리 형상에 맞는 드라이버/렌치 — 구매품 미확정','나사를 조여도 팔로워가 홈을 따라 움직일 수 있는지 확인해야 합니다.',
 '표시 형상은 M4 나사·Ø5×20 어깨 후보입니다. 실제 제품과 공구가 확정된 단계는 아닙니다.')
 basic+=fol
 add('C05','케이블 클램프','큰 노브용 M6 구동너트 넣기',basic+[washer,lock],[dn,lead],
 {**path([lead],[0,120,0],[0,.45]),**path([dn],[0,0,40],[.55,1])},
 ['조립할 때는 큰 노브축을 넣기 전에 작업합니다.','연결틀 오른쪽의 앞쪽 홈으로 M6 사각너트를 넣고, 위에서 들어올 축과 구멍을 맞춥니다.'],
 '너트를 손으로 밀어 넣고 구멍 위치를 맞춥니다.','손으로 삽입','너트가 앞에서 보이고, 축을 걸기 전에 위치를 맞출 수 있는지 봅니다.',
 '구동너트 홈의 높이는 6 mm, 너트는 5 mm로 공칭 1 mm의 방향전환 유격이 있습니다. 위쪽 축 너트를 세게 조여 없앨 수 없습니다.',
 previewOnly=[lead,washer,lock],motionNote='분해 순서를 보이려고 이후 장착할 노브축·와셔·위 너트도 함께 표시했습니다. 축을 먼저 풀어 빼고, 아래 구동너트를 꺼냅니다. 나사 회전은 직선 이동으로 생략했습니다.',
 phases=[[.45,'① 노브축 먼저 빼기'],[.55,'축이 빠진 상태'],[1,'② 구동너트 꺼내기']])
 basic+=[dn]
 add('C06','케이블 클램프','축을 넣기 전에 와셔와 축 위치 너트 놓기',basic,[washer,lock,lead],
 {**path([lead],[0,120,0],[0,.4]),**path([lock],[0,0,50],[.45,.7]),**path([washer],[0,0,50],[.75,1])},
 ['오른쪽 축 받침 아래에 와셔를 먼저 놓고, 그 아래에 M6 잠금너트를 둡니다.','다음 단계에서 축이 두 부품을 차례로 통과하도록 구멍을 맞춥니다.'],
 '와셔와 잠금너트를 받쳐 둡니다. 축을 꽂은 뒤 옆에서 끼울 수는 없습니다.','손·10 mm 스패너','와셔와 너트를 동시에 제자리에 받치는 동작이 쉬운지 확인합니다.',proof='공칭 분해 순서 표시 · 손조립 미검증',
 previewOnly=[lead],motionNote='이후 장착할 노브축을 참고로 함께 표시했습니다. 분해는 축 → 너트 → 와셔 순서입니다. 실제 조립은 와셔 → 너트 → 축 순서이며, 나사 회전은 생략했습니다.',
 phases=[[.4,'① 노브축 먼저 빼기'],[.45,'축이 빠진 상태'],[.7,'② 축 위치 너트 꺼내기'],[.75,'너트가 빠진 상태'],[1,'③ 와셔 꺼내기']])
 basic+=[washer,lock]
 add('C07','케이블 클램프','노브축을 넣고 회전 여유 맞추기',basic,[lead],path([lead],[0,120,0]),
 ['위에서 축을 넣어 와셔와 나일론 삽입형 풀림방지 너트에 걸고, 아래 구동너트까지 통과시킵니다.','조절할 때만 10 mm 스패너로 위쪽 너트를 잡고 노브를 돌립니다. 프레임을 꽉 죄지 말고, 위아래 이동 여유 약 0.2 mm를 시험 목표로 맞춥니다.','스패너를 뺀 뒤 노브를 양쪽으로 돌리고 위아래로 가볍게 밀어 확인합니다. 위 너트는 축과 함께 회전해야 합니다.','회전이 걸리거나, 너트가 프레임에 붙어 축만 헛돌거나, 반복 후 여유가 변하면 사용을 멈추고 축 지지 구조를 재검토합니다.'],
 '조절 중에는 위쪽 너트를 잡습니다. 정상 사용 중에는 스패너를 빼고 노브만 돌립니다.','10 mm 스패너 + 축 여유 확인용 필러 게이지/측정 도구','꽉 조이면 회전이 막힐 수 있습니다. 반대로 너무 떨어뜨리면 축이 덜컥거립니다. 현재는 작은 여유를 조절하는 방식이며, 조임만으로 자동 완성되는 구조는 아닙니다.',
 'CAD의 와셔 윗면 41.8 mm와 프레임 아랫면 42.0 mm 사이가 0.2 mm입니다. 시험 목표일 뿐 출력 공차·실제 마찰·반복 후 유지가 검증된 값은 아닙니다. 아래 구동너트 홈의 1 mm 유격과 별개입니다. 일반 너트를 헐겁게 두는 것으로 대체하지 않습니다.',
 toolModel='spanner',proof='CALCULATED: 공칭 축 여유 0.2 mm · 스패너 머리폭 18/두께 4 mm 외형만 확인 · 회전/내구성 미검증',view=(1,.28,.85),anchors=[['조절할 때만 잡음',[80,38,-92.65]],['사용 중에는 노브만 회전',[80,62,-92.65]]],
 sources=[['풀림방지 너트 후보 · 제조사','https://www.bossard.com/kr-ko/eshop/locking-nuts-with-polyamide-insert/prevailing-torque-type-hex-lock-nuts-thin-type-with-polyamide-insert/p/33024/']])
 basic+=[lead]
 add('C08','케이블 클램프','가로대용 사각너트를 지금 넣기',basic,bn,path(bn,[0,0,28]),
 ['노브축 조립을 마친 뒤, 위 가로대를 올리기 바로 전에 작업합니다.','연결틀 위쪽 좌우의 앞에서 열린 홈에 M4 사각너트를 하나씩 넣습니다.','곧바로 C09에서 가로대를 올립니다.'],
 '너트는 짧고 열린 홈에 놓습니다. 가로대를 올릴 때까지 받칩니다.','손으로 삽입','프레임 안에 연결틀을 넣은 상태에서 너트 입구가 열려 있는지 봅니다.',
 '이전 C03에서 하던 작업을 가로대 조립 직전으로 옮겼습니다.',proof='가로대 없이 앞쪽 삽입 · 손 접근 미검증')
 basic+=bn
 add('C09','케이블 클램프','위 가로대와 턱을 올리기',basic,[bridge],path([bridge],[0,65,0]),
 ['위 가로대의 양끝을 연결틀에 맞춥니다.','가운데 위 턱이 아래 두 턱 사이를 향하게 놓습니다.'],
 '가로대를 손으로 받칩니다.','손으로 배치','좌우 구멍이 이미 넣어 둔 사각너트와 맞는지 봅니다.',proof='CAD: 가로대 인출 경로 확인 · 출력 공차 미검증')
 add('C10','케이블 클램프','작은 손나사 두 개로 가로대 고정',basic+[bridge],bs,path(bs,[0,30,0]),
 ['위에서 M4 손나사를 각각 사각너트에 걸어 줍니다.','두 곳을 조인 뒤 큰 노브를 조금 돌려 세 턱이 움직이는지 확인합니다.'],
 '작은 손잡이를 돌립니다. 너트는 열린 사각 홈에 있습니다.','손잡이 두 개','나사를 완전히 풀면 너트가 빠질 수 있습니다. 가로대를 여닫는 조작을 검토하세요.',proof='공칭 구조 표시 · 실제 손잡이/마찰 미검증')
 add('C11','케이블 클램프','같은 순서로 두 번째 클램프 만들기',cable(1),cable(2),path(cable(2),[0,90,0]),
 ['C01~C10을 한 번 더 반복해 동일한 클램프 두 개를 만듭니다.','각각 큰 노브가 움직이고 가로대를 분리할 수 있는지 확인합니다.'],
 '각 클램프의 넓은 발을 받칩니다.','앞 단계와 동일','앞뒤 클램프를 하나씩 조립하고 검사한 다음 공통 바닥에 올립니다.',
 '두 번째 클램프의 단계는 첫 번째와 같습니다. 슬라이더는 두 모듈의 구분을 위한 분해 표시입니다.',view=(1,.4,.6),proof='동일 C07 형상 2개 · 실제 반복 조립 미검증')
 add('B01','공통 바닥','교정 받침의 날개너트부터 넣기',['CommonBase'],cn,
 {n:dict(vector=[mesh[n]['sign']*28,0,0],window=[0,1]) for n in cn},
 ['헤드와 클램프가 없는 바닥을 똑바로 놓습니다.','교정 PCB 받침 네 곳의 바깥쪽 입구로 나일론 날개너트를 넣습니다.'],
 '날개를 잡고 열린 받침에 놓습니다.','손으로 배치','헤드를 올리기 전에 너트를 넣는 순서입니다. 날개가 작아 손으로 넣기 어려운지도 봅니다.',
 '바닥을 뒤집으면 너트가 빠질 수 있습니다. 이후 작업 중 너트를 직접 챙깁니다.',proof='CAD: 바깥쪽 삽입 경로 확인 · 손 접근 미확인')
 base=['CommonBase']+cn
 add('B02','공통 바닥','프로브를 바닥의 장착면에 놓기',base,head,path(head,[0,110,0]),
 ['조립한 프로브의 발을 공통 바닥의 두 장착 구멍에 맞춥니다.','아래 몸체가 장착면에 평평하게 닿도록 놓습니다.'],
 '프로브 아래 몸체와 발을 잡습니다. SMA나 권선을 잡고 들지 않습니다.','손으로 배치','프로브를 놓은 상태에서 아래쪽 너트 자리까지 접근할 수 있는지 확인합니다.',proof='CAD: 프로브 분리 경로 확인 · 실제 받침 작업 미확인')
 def mount(id,title,rest,indices):
  screws=[f'MountScrew{i}' for i in indices];nuts=[f'MountNut{i}' for i in indices]
  add(id,'공통 바닥',title,rest,screws+nuts,{**path(screws,[0,40,0],[0,.5]),**path(nuts,[0,-28,0],[.55,1])},
   ['바닥이 넘어지지 않게 받치고, 해당 구멍 아래로 손이 들어갈 공간을 확보합니다.','위에서 M4×20 나사를 넣고 아래에서 사각너트 한 개를 대어 먼저 나사산을 겁니다.','한 곳이 걸리면 반대쪽도 같은 방법으로 체결합니다. 너트 여섯 개를 미리 넣고 뒤집지 않습니다.'],
   '아래에서 너트를 받치고 위 손잡이를 돌립니다. 모듈과 바닥도 안정적으로 받쳐야 합니다.','위 손잡이 + 아래에서 너트 받치기','부품·너트·나사를 동시에 다루는 작업 자세가 편한지는 미확인입니다. 밑면 시점에서 판단해 보세요.',
   '슬라이더는 나사와 너트를 순서대로 빼 보여 줍니다. 작업대나 손으로 지지하는 상황은 모델에 없습니다.',view=(.45,-.75,1))
 mount('B03','프로브 발의 나사 두 곳 체결',base+head,[0,1]);base+=head+['MountScrew0','MountScrew1','MountNut0','MountNut1']
 for k,ids in [(1,[2,3]),(2,[4,5])]:
  add('B0'+str(2*k+2),'공통 바닥',('앞' if k==1 else '뒤')+' 클램프를 장착면에 놓기',base,cable(k),path(cable(k),[0,95,0]),
   ['클램프의 발을 바닥의 넓은 위치 기준 안에 놓습니다.','두 구멍을 맞추고 장착면에 평평하게 닿게 합니다.'],
   '클램프의 발과 프레임을 잡습니다.','손으로 배치','플라스틱 기준에 억지로 밀어 넣지 않고 두 구멍이 맞는지 봅니다.',proof='공칭 배치 표시 · 실물 장착 공차 미검증')
  mount('B0'+str(2*k+3),('앞' if k==1 else '뒤')+' 클램프 발의 나사 두 곳 체결',base+cable(k),ids)
  base+=cable(k)+[f'MountScrew{i}' for i in ids]+[f'MountNut{i}' for i in ids]
 add('Q01','교정 준비','교정 PCB를 넣기 위해 프로브 열기',[n for n in base if n not in upper+['HeadHandScrews']],upper+['HeadHandScrews'],{},
 ['프로브 손나사 두 개를 완전히 풉니다.','위 코어가 달린 뚜껑을 들어 올려 교정 PCB가 들어갈 공간을 만듭니다.'],
 '뚜껑을 따로 받쳐 두고 사각너트가 빠지지 않았는지 확인합니다.','큰 손잡이 두 개','교정 PCB를 닫힌 코어 사이로 억지로 넣는 절차가 아닙니다.',kind='headOpen',proof='CAD: 손나사 인출·뚜껑 개방 경로 확인')
 opened={n:[0,120 if n=='UpperLid' else 118.2,0] for n in upper};opened['HeadHandScrews']=[0,185,0]
 add('Q02','교정 준비','교정 PCB를 위에서 내려놓기',[n for n in base if n!='HeadHandScrews'],board,path(board,[0,80,0]),
 ['뚜껑을 연 상태에서 교정 PCB를 위쪽으로 가져옵니다.','중앙 도체 경로가 코어 안, 귀환 경로가 코어 밖을 지나도록 네 받침 위에 놓습니다.'],
 'PCB 가장자리를 양손으로 잡습니다.','손으로 배치','PCB와 코어·권선이 닿지 않고 네 장착 구멍이 맞는지 봅니다.',baseOffsets=opened,freeRaisedLid=True,proof='CAD: 헤드 열린 상태의 PCB 경로 확인')
 add('Q03','교정 준비','교정 PCB 네 귀퉁이를 고정',[n for n in base if n!='HeadHandScrews']+board,['CalibrationScrews'],path(['CalibrationScrews'],[0,30,0]),
 ['B01에서 넣어 둔 날개너트의 구멍을 맞춥니다.','위에서 M3 나사를 한 개씩 걸고, 네 곳을 고르게 조입니다.'],
 '위 나사를 돌립니다. 너트가 맞지 않으면 받침 바깥쪽에서 날개를 잡아 위치를 맞춥니다.','나사 머리에 맞는 드라이버 + 필요 시 날개 잡기','헤드가 있는 상태에서 날개너트에 다시 손이 닿는지 미확인입니다. 이 부분을 확인해 보세요.',baseOffsets=opened,freeRaisedLid=True)
 add('Q04','교정 준비','뚜껑을 닫고 연결 위치 확인',[n for n in base if n not in upper+['HeadHandScrews']]+board+['CalibrationScrews'],upper+['HeadHandScrews'],{},
 ['위 코어와 뚜껑을 내리고 양쪽 손나사를 조입니다.','VNA PORT1은 교정 PCB 입력, 출력 SMA에는 50 Ω 로드, 프로브 출력은 VNA PORT2로 연결합니다.','일반 케이블 측정 때는 교정 PCB와 로드를 제거합니다. 사용 장면은 「전체 조립과 사용」에서 확인합니다.'],
 'SMA 체결 시 보드와 커넥터 몸체를 받칩니다.','실제 SMA 부품에 맞는 공구; 체결값은 해당 부품 지침 확인','이번 문서는 조립 검토용입니다. RF 교정 데이터나 사용 대역이 확보됐다는 뜻은 아닙니다.',kind='headOpen',proof='CAD 개폐 설명 · SMA 공구 접근/실물 교정 미완료',view=(.75,.45,1))
 return steps
