ckh7488/rf_current_probe/(commit log)

2026-11-04 chore: back up RF current probe design and offline analysis
    [BaseCenter_A16_DRAFT.step, BaseCenter_A16_DRAFT.stl, BaseCenter_A18_DRAFT.step, BaseCenter_A18_DRAFT.stl, BaseCenter_A19_DRAFT.step, BaseCenter_A19_DRAFT.stl, BaseFront_A16_DRAFT.step, BaseFront_A16_DRAFT.stl]
2026-11-04 docs: complete backup entry points and preserve source bytes
    [REQUIREMENTS.csv, RFCP_A18_CurrentHardware_Assembly_DRAFT.FCStd, RFCP_Fixture_Flat_A02_DRAFT.kicad_pcb, RFCP_Fixture_Flat_A02_DRAFT.kicad_sch, RFCP_Fixture_Flat_A03_DRAFT.kicad_pcb, RFCP_Fixture_Flat_A03_DRAFT.kicad_sch, RFCP_Fixture_Flat_A03_SMA_R2_DRAFT.kicad_pcb, RFCP_Fixture_Flat_A03_SMA_R2_DRAFT.kicad_sch]
